LFB-MRI/MagneticReadoutProcessing/src/MagneticReadoutProcessing/README.md

# MagneticReadoutProcessing

This library was created for a Low-Field MRI project and allows processing of data measured by magnetic field sensors.
The focus is on visualization, followed by the provision of simple interfaces to work with this data.
In general its possible to use this lib on all kinds of data.

Please see the full documentation: [magneticreadoutprocessing.readthedocs.io](https://magneticreadoutprocessing.readthedocs.io/en/latest/)
