LFB-MRI/MagneticReadoutProcessing/documentation/paper/README.md

\gls{vr}

\cite{eduxrvrar2020usa}

\begin{figure}[htbp]
\centerline{\includegraphics[width=8cm]{serious-games.png}}
\caption{Definition Serious Games.\cite{a10}}
\label{sgdef_fig}
\end{figure}
