LFB-MRI/MagneticReadoutProcessing/src/MagBoardHardware/single_sensor/Readme.md

# single_sensor

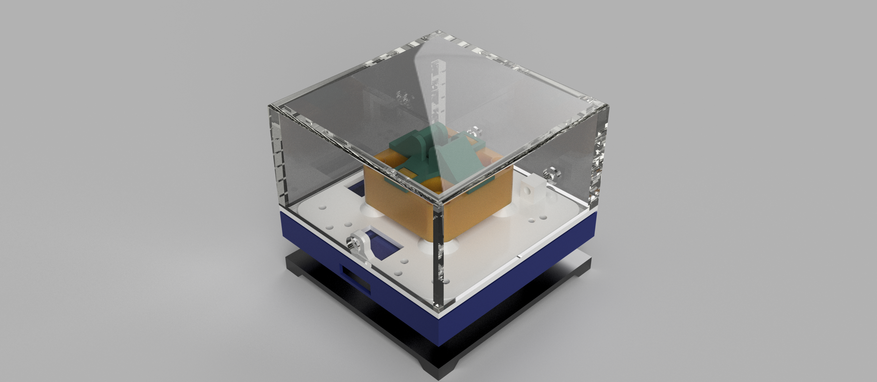
[picture p3: src/MagBoardHardware/single_sensor/IMAGES/single_sensor_render_1.png]
single_sensor_render_1


## BOM

| amount | part |
|---|---|
| 12 | M3x10 SHCS |
| 12 | HEAT INSERT M3 |
| 3 | M4x10 SHCS |
| 3 | HEAT INSERT M4 |
| 2 | Adafruit TLV493D |
| 1 | Raspberry Pi Pico  |
| 1 | Adafruit TCA9548A  |
| 2 | Adafruit STEMMA QT |
