LFB-MRI/MagneticReadoutProcessing/documentation/thesis/tables/README.md

# TABLES

* place a csv file with Caption_Table_Name.csv
* please use _ instead of spaces " ", the name of file is the caption of the table
* to insert it into the document use: %%Caption_Table_Name.csv%%
