LFB-MRI/MagneticReadoutProcessing/src/MagneticReadoutProcessing/readings/TLV493D_temperature/combined/README.md

# extract.py on COMBINED TEMPERATURE READINGS

All readings with `TEMPERATURE=COMBINED` includes the temperatures as separate datapoints in one reading.
The `extract.py` extracts the datapoints into separate readings to make it compatible with the test_temperaturedeviation analysis
