LFB-MRI/MagneticReadoutProcessing/documentation/thesis/thesis_document_tmp.md

# Introduction

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

## Background and Motivation

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

\newpage

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

At last, the temperature drift is measured by repeating the background noise test in different temperature environments. Sensor noise should be less than *50$\mu$T* to characterise precisely a magnetic field in a Halbach-Array of an (+mri) with precision greater than *1000 (+ppm)*.

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

### Low-Field MRI

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

### Magnet System

Example Halbach ring with cutouts for eight magnets. \label{Example_Halbach_ring_with_cutouts_for_eight_magnets.png}

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

### Shimming Procedure

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

The sources for the shimming process can be passive and active based. 
Passive shimming uses ferromagnetic metal materials inserted into the inner magnet bore. [@BPA22]
Active shimming, on the other hand, can use additional coils or existing gradient coils controlled by special circuitry. Also, software algorithms can be used to adjust the control parameters of the (+mri) system and improve homogeneity [@WAH21].

In this thesis, reference is made exclusively to the hardware shimming processes, since this project is to be used in the future to construct a low-field (+mri) field magnet from permanent magnets.

## State of the Art 

**Low-Field MRI**

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

**Magnet Characterisation**

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

There are two ways of using the data from the magnets that are previously measured:

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

## Aim of this Thesis

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

## Research Question and Approach

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

The primary objectives of this work revolve around addressing two pivotal research questions:

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

## Use cases

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

1. **Ready to use hardware sensor designs**

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

2. **Taking automatic measurements from sensors**

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

3. **Open storage formats for data export**

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

4. **Ready to integrate data analysis functions**

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

5. **User-programmable data processing pipelines**

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

## Structure

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

# Unified Sensor

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

\newpage

## Sensor Selection

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

Typical block diagram of a digital hall sensor sensing chain using three hall plates. \label{Typical_block_diagram_of_a_digital_hall_sensor_sensing_chain_using_three_hall_plates.png}

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

| | TLV493D | HMC5883L | MMC5603NJ | AS5510 |
| --- | --- | --- | --- | --- |
| Readout-Axis | 3D | 3D | 3D | 1D |
| Temperature-Sensor | yes | no | yes | no |
| Resolution [uT] | 98 | 0.2 | 0.007 | 48 |
| (+dr) [mT] | ±130.0  | ±0.8 | ±3 | ±50 |
| Interface | (+i2c)  | (+i2c) | (+i2c) | (+i2c) |

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

## Mechanical Structure

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

Rendered mechanical structure of the 1D sensor (+cad) model with different parts colored separately, and universal magnet mount shown in green. \label{Rendered_mechanical_structure_of_the_1D_sensor_(+cad)_model_with_different_parts_colored_separately,_and_universal_magnet_mount_shown_in_green.png}

Figure \ref{Rendered_mechanical_structure_of_the_1D_sensor_(+cad)_model_with_different_parts_colored_separately,_and_universal_magnet_mount_shown_in_green.png}, shows rendered view of the 1D-Single sensor (+cad) drawing, which is described in chapter \ref{d-single-sensor}. All parts are produced using 3D printing additive manufacturing process. The sensor circuit board is glued underneath the magnet holder. This is interchangeable, so different distances between sensor and magnet can be realised. The exchangeable magnetic holder (shown in green in Figure \ref{Rendered_mechanical_structure_of_the_1D_sensor_(+cad)_model_with_different_parts_colored_separately,_and_universal_magnet_mount_shown_in_green.png}) can be adapted to different magnets. It can be produced quickly due to the small number of parts used.
The two recesses lock the magnet holder with the inserted magnet over the sensor.
The mechanical design created is able to accommodate cylinders, cubes, up to a maximum length of *30mm*.
Other magnet shapes require a modification of the base plate and the sensor holder.
The specified tolerances of *0.45mm* allow the magnet to be inserted into the 3D printed holder with repeat accuracy and without backlash. This was accomplished with the help of tolerance tests for the 3D printing material used (+pla) and the 3D printer used *Voron 2.4 350mm* through several series of tests.
This is important if several magnets must be measured, where the positioning over the sensor must always be the same.

## Electrical Interface

1D sensor schematic using an Raspberry Pi Pico with a TLV493D footprint in the center. \label{1D_sensor_schematic_using_an_Raspberry_Pi_Pico_with_a_TLV493D_footprint_in_the_center.png}

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

## Firmware

Unified sensor firmware program structure with listed setup and main loop routines using simplified function blocks. \label{Unified_sensor_firmware_program_structure_with_listed_setup_and_main_loop_routines_using_simplified_function_blocks.png}

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

```cpp {#lst:CustomSensorClass caption="CustomSensor-Class for adding new sensor hardware support into the unified sensor firmware package"}
#ifndef __CustomSensor_h__
#define __CustomSensor_h__
// register custom sensor in implemented_sensors.h also
class CustomSensor: public baseSensor
{
public:
  CustomSensor();
  ~CustomSensor();
  // implement depending on sensor communication interface
  bool begin(TwoWire& _wire_instance); // I2C
  bool begin(HardwareSerial& _serial_instance); // UART
  bool begin(Pin& _pin_instance); // ANALOG or DIGITAL PIN like one wire
  // FUNCTIONS USED BY READOUT LOGIC
  bool is_valid() override;
  String capabilities() override;
  String get_sensor_name() override;
  bool query_sensor() override;
  sensor_result get_result() override;
};
#endif
```

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

### Communication Interface

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

Unified sensor firmware provided serial terminal based (+cli) allows the user to configure the sensor manually. \label{Unified_sensor_firmware_provided_serial_terminal_based_(+cli)_allows_the_user_to_configure_the_sensor_manually.png}

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

Result of an executed b value measurement readout command using the sensors (+cli) with immediate user readable response. \label{Result_of_an_executed_b_value_measurement_readout_command_using_the_sensors_(+cli)_with_immediate_user_readable_response.png}

### Sensor Synchronisation Interface

Multi sensor synchronisation wiring example using three sensors together with one host (+pc) performing the triggering and readout processing. \label{Multi_sensor_synchronisation_wiring_example_using_three_sensors_together_with_one_host_(+pc)_performing_the_triggering_and_readout_processing.png}

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

| Data-Points | Run runtime [ms] | Average Sensor communication time per reading [ms] |  Communication jitter time [ms]  | Comment |
| --- | --- | --- | --- | --- |
| 1 | 9453 | 1.44 | 0 | |
| 1 | 9864 | 1.5 | 0 | |
| 10 | 12984 | 1.22 | 0.9 | |
| 10 | 12673 | 1.13 | 1.1 | |
| 10 | 43264 | 2.19 | 8.2 | 96% system load |

\newpage

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

Unified sensor firmware multi sensor synchronisation procedure using sync (+gpio) input for operation (primary or secondary) mode decision. \label{Unified_sensor_firmware_multi_sensor_synchronisation_procedure_using_sync_(+gpio)_input_for_operation_(primary_or_secondary)_mode_decision.png}

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

Result of the opmode command execution on a sensor which is connected to another as primary configured sensor. \label{Result_of_the_opmode_command_execution_on_a_sensor_which_is_connected_to_another_as_primary_configured_sensor.png}

## Example Sensors

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

: Build hardware sensors equipped with different sensor (+ic)s to cover various magnet charaterisation setups. \label{Build_hardware_sensors_equipped_with_different_sensor_(+ic)s_to_cover_various_magnet_charaterisation_setups.csv}

| | 1D: single sensor | 1D: dual sensor | 3D: Fullsphere |
| --- | --- | --- | --- |
| Maximal magnet size | Cubic 30x30x30mm  | Cubic 30x30x30mm  | Cubic 20x20x20mm |
| Sensor type | MMC5603NJ | TLV493D | TLV493D |
| Sensor count | 1 | 2 | 1 |
| Scanmode | static (1 point)  | static (2 points) | dynamic (fullsphere) |

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

### 1D: Single Sensor

Manufactured 1D sensor construction from different angles and universal magnet mount (green 3D printed part) equipped with N45 12x12x12mm magnet. \label{Manufactured_1D_sensor_construction_from_different_angles_and_universal_magnet_mount_(green_3D_printed_part)_equipped_with_N45_12x12x12mm_magnet.p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

### 3D: Full Sphere

Full sphere sensor implementation using two Nema17 stepper motors in a polar coordinate system. \label{Full_sphere_sensor_implementation_using_two_Nema17_stepper_motors_in_a_polar_coordinate_system.png}

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

3D plot of an N45 12x12x12mm magnet using the build 3D full sphere sensor with visible magnetic field strength deviations using different shaded vertices on a sphere. \label{3D_plot_of_an_N45_12x12x12mm_magnet_using_the_build_3D_full_sphere_sensor_with_visible_magnetic_field_strength_deviations_usi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

### Integration of an Industry-Teslameter

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

\newpage

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

Voltcraft GM70 teslameter with custom (+pc) interface board using a (+usb) to serial converter and needed additional pull-up resistors. \label{Voltcraft_GM70_teslameter_with_custom_(+pc)_interface_board_using_a_(+usb)_to_serial_converter_and_needed_additional_pull-up_resistors.png}

# Software Readout Framework

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

## User Interaction Points

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

\newpage

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

A high level overview of all MRP library implemented Python modules which can be changed by the user. \label{A_high_level_overview_of_all_MRP_library_implemented_Python_modules_which_can_be_changed_by_the_user.png}

### User Interaction Points Example

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

1. **Create magnetic field data**

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

\newpage

3. **Generate fabrication data** 

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

## Modules

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

* Core - All modules related to measurement data management
* Extensions - Contains modules for visualisations, hardware sensor access

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

### Core Modules

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

The following modules are implemented in detail:

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

### Storage and Datamanagement

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

```json {#lst:json_export_format_example caption="JSON structure of an exported MRPReading based measurement with information about the measurement environment, additional meta-data and raw data value objects"}
{
  "time_start": "Wed Sep 20 08:50:13 2023",
  "time_end": "Wed Sep 20 08:54:13 2023",
  "additional_data": {
      "sensor_device_path": "/dev/ttyUnifiedSensorSingle",
      "sensor_name": "Unified Sensor Single Sensor",
      "sensor_id": "386731533439",
      "sensor_capabilities": ["static", "axis_b", "axis_x", "axis_y", "axis_z", "axis_temp", "time"],
      "configname": "calibrationtemp30.yaml",
      "runner": "cli"},
  "data": [{
      "value": {"b":0.135},
      "id": 0,
      "temperature": 34.32}],
  "measurement_config": {
      "sensor_distance_radius": 40.0,
      "magnet_type": 1// CUBIC 12x12x12mm N45
  },}
```

The exported example Listing \ref{lst:json_export_format_example} contains different object keys, which contain the following information:

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

### Extension Modules

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

\newpage

* *MRPHal* - Firmware protocol implementation
* *MRPHalLocal* - (+usb) sensor interface
* *MRPHalRemote* - Remote sensor interface

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

#### Visualisation

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

* *MRPVisualization* - different table and graph-based plots
* *MRPPolarVisualization* - full sphere map plots

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

#### Analysis

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

## Multi Sensor Setup

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

MRP library proxy module usage example with host (+pc) for readout processing and remote (+pc) for sensor communication using the http protocol. \label{MRP_library_proxy_module_usage_example_with_host_(+pc)_for_readout_processing_and_remote_(+pc)_for_sensor_communication_using_the_http_protocol.png}

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

Example MRP proxy module usage using two remote (+pc)s. \label{Example_MRP_proxy_module_usage_using_two_remote_(+pc)s.png}

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

### Network-Proxy

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

```bash {#lst:mrpcli_proxy_start caption="MRPProxy usage to enable local sensor forwarding over the network. The CLI output shows the available sensor to the connected host PC"}
# START PROXY INSTNACE WITH TWO LOCALLY CONNECTED SENSORS
$ python3 mrpproxy.py proxy launch /dev/ttySENSOR_A /dev/ttySENSOR_B # add another proxy instance http://proxyinstance_2.local for multi-sensor, multi-proxy chain
Proxy started. http://remotepc.local:5556/
PRECHECK: SENSOR_HAL: 1337 # SENSOR A FOUND
PRECHECK: SENSOR_HAL: 4242 # SENSOR B FOUND
Terminate Proxy instance [y/N] [n]: 
```

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

```bash {#lst:mrpcli_config_rest caption="MRPProxy provided REST endpoint query example using wget command line tool to send requests"}
# GET PROXY STATUS
$ wget http://proxyinstance.local:5556/proxy/status
{
"capabilities":[
  "static",
  "axis_b",
  "axis_x",
  "axis_y",
  "axis_z",
  "axis_temp",
  "axis_stimestamp"
],
"commands":[
  "status",
  "initialize",
  "disconnect",
  "combinedsensorcnt",
  "sensorcnt",
  "readsensor",
  "temp"
]}
# RUN A SENSOR COMMAND AND GET THE TOTAL SENSOR COUNT
$ wget http://proxyinstance.local:5556/proxy/command?cmd=combinedsensorcnt
{
"output":[
  "2"
]}
```

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

```bash {#lst:mrpcli_config_using_rpc caption="MRPcli usage example to connect with a MRPProxy based network sensor"}
# CONFIGURE MEASUREMENT JOB USING A PROXY INSTANCE
$ MRPCli config setupsensor testcfg --path http://proxyinstance.local:5556
> remote sensor connected: True using proxy connection:
> http://proxyinstance.local:5556 with 1 local sensor connected
```

### Sensor Synchronisation

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

### Command-Router

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

#### Merging the Sensor Capabilities

: Sensor capabilities merging algorithm. \label{Sensor_capabilities_merging_algorithm.csv}

| SENSOR A  | SENSOR B  |  MERGED CAPABILITIES |  CAPABLE SENSORS ID LUT |
| --- | --- | --- | --- |
| static | | static |  A |
| | dynamic | dynamic |  B |
| axis_temp | axis_temp | axis_temp |  A B |
| axis_x | axis_x | axis_x |  A B |

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

```bash {#lst:mtsc caption="MRPProxy REST capabilities query result after executing the merging algorithm"}
# QUERY Network-Proxy capabilities
$ wget http://proxyinstance.local:5556/proxy/status
{"capabilities":[
"static",
"dynamic",
"axis_temp",
"axis_x"
]}
```

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

#### Dynamic extension of the available Network-Proxy Commands

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

* Redirect to each capable sensor
* Extend commands using an id parameter

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

* *readsensor AXIS SENSOR_INDEX* -> *readsensor ID AXIS SENSOR_INDEX*
* *opmode* -> *opmode ID*

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

## Examples

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

### MRPReading

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

\newpage

```python {#lst:mrpexample_reading caption="MRPReading example for setting up a basic measurement using Python code"}
from MRP import MRPReading, MRPMeasurementConfig
# [OPTIONAL] CONFIGURE READING USING MEASUREMENT CONFIG INSTANCE
config: MRPMeasurementConfig = MRPMeasurementConfig
config.sensor_distance_radius(40) # 40mm DISTANCE BETWEEN MAGNET AND SENSOR
config.magnet_type(N45_CUBIC_12x12x12) # CHECK MRPMagnetTypes.py FOR IMPLEMENTED TYPES
# CREATE READING
reading: MRPReading = MRPReading(config)
# ADD METADATA
reading.set_name("example reading")
reading.set_additional_data("description", "abc")
reading.set_additional_data("test-number", 1)
# EXAMPLE: INSERT A RANDOM DATAPOINT HERE
measurement = MRPReadingEntry.MRPReadingEntry()
measurement.value = random.random()
reading.insert_reading_instance(measurement, False)
# EXPORT MEASURED VALUES INto OTHER DATAFORMATS
npmatrix: np.ndarray = reading.to_numpy_matrix() ## NUMPY
csv: []= reading.to_value_array() ## CSV
js: dict= reading.dump() ## JSON
# EXPORT READING TO FILE
reading.dump_to_file("exported_reading.mag.json")
# IMPORT READING
imported_reading: MRPReading = MRPReading()
imported_reading.load_from_file("exported_reading.mag.json")
```

### MRPHal

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

```python {#lst:mrpexample_hal caption="MRPHal example to use a connected hardware sensor to store raw sensor readings inside a measurement"}
from MRP import MRPHalSerialPortInformation, MRPHal, MRPBaseSensor, MRPReadingSource
# SEARCH FOR CONNECTED SENSORS
## LISTS LOCAL CONNECTED OR NETWORK SENSORS
system_ports = MRPHalSerialPortInformation.list_sensors()
sensor = MRPHal(system_ports[0])
# OR USE SPECIFIED SENSOR DEVICE
device_path = MRPHalSerialPortInformation("UnifiedSensor_4242")
sensor = MRPHal(device_path)
# RAW SENSOR INTERACTION MODE
sensor.connect()
basesensor = MRPBaseSensor.MRPBaseSensor(sensor)
basesensor.query_readout()
print(basesensor.get_b()) # GET RAW MEASUREMENT
print(basesensor.get_b(1)) # GET RAW DATA FROM SENSOR WITH ID 1
# TO GENERATE A READING THE perform_measurement FUNCTION CAN BE USED
reading_source = MRPReadingSourceHelper.createReadingSourceInstance(sensor)
result_readings: [MRPReading] = reading_source.perform_measurement(_readings=1, _hwavg=1)
```

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

### MRPSimulation

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

```python {#lst:mrpexample_simulation caption="MRPSimulation example illustrates the usage of several functions how to generate simulated magnets"}
from MRP import MRPSimulation, MRPPolarVisualization, MRPReading
# GENERATE SILUMATED READING USING A SIMULATED HALLSENSOR FROM magpy LIBRARY
reading = MRPSimulation.generate_reading(MagnetType.N45_CUBIC_12x12x12,_add_random_polarisation=True)
# GENERATE A FULL SPHERE MAP READING
reading_fullsphere = MRPSimulation.generate_random_full_sphere_reading()
# RENDER READING TO FILE IN 3D
visu = MRPPolarVisualization(reading)
visu.plot3d("simulated_reading.png")
# EXPORT READING
reading.dump_to_file("simulated_reading.mag.json")
```

### MRPAnalysis

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

```python {#lst:mrpexample_analysis caption="MRPAnalysis example code performs several data analysis steps"}
from MRP import MRPAnalysis, MRPReading
# CREATE A SAMPLE MEASUREMENT WITH SIMULATED DATA
reading = MRPSimulation.generate_reading(MagnetType.N45_CUBIC_10x10x10)
# CALCULATE MEAN
print(MRPAnalysis.calculate_mean(reading))
# CALCULATE STD DEVIATION ON TEMPERATURE AXIS
print(MRPAnalysis.calculate_std_deviation(reading, _temperature_axis=True))
# CALCULATE CENTER OF GRAVITY
(x, y, z) = MRPAnalysis.calculate_center_of_gravity(reading)
# APPLY CALIBRATION READING TO REMOVE BACKGROUND NOISE
calibration_reading = MRPSimulation.generate_reading(MagnetType.N45_CUBIC_10x10x10, _ideal = True)
MRPAnalysis.apply_calibration_data_inplace(calibration_reading, reading)
```

### MRPVisualisation

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

```python {#lst:mrpexample_visualisation caption="MRPVisualisation example which plots a full sphere to an image file"}
from MRP import MRPPolarVisualization
# CREATE MRPPolarVisualization INSTANCE
## IT CAN BE REUSED CALLING plot2d AGAIN, AFTER LINKED READING DATA ARE MODIFIED
visu = MRPPolarVisualization.MRPPolarVisualization(reading)
# 2D PLOT INTO A WINDOW
visu.plot2d_top(None)
visu.plot2d_side(None)
# 3D PLOT TO FILE
visu.plot3d(os.path.join('./plot3d_3d.png'))
# PLOT ANALYSIS RESULTS
from MRP import MRPDataVisualization
MRPDataVisualization.MRPDataVisualization.plot_error([reading_a, reading_b, reading_c])
```

Example full sphere plot of an measurement using the MRPVisualisation module using different shaded vertices on a sphere. \label{Example_full_sphere_plot_of_an_measurement_using_the_MRPVisualisation_module_using_different_shaded_vertices_on_a_sphere.png}

### MRPHalbachArrayGenerator

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

```python {#lst:mrpexample_halbach caption="MRPHalbachArrayGenerator example for generating an OpenSCAD based Halbach ring"}
readings = []
for idx in range(8):
  # GENERATE EXAMPLE READINGS USING N45 CUBIC 15x15x15 MAGNETS
  readings.append(MRPSimulation.MRPSimulation.generate_reading(MRPMagnetTypes.MagnetType.N45_CUBIC_15x15x15))
## GENERATE HALBACH
halbach_array: MRPHalbachArrayGenerator.MRPHalbachArrayResult = MRPHalbachArrayGenerator.MRPHalbachArrayGenerator.generate_1k_halbach_using_polarisation_direction(readings)
# EXPORT TO OPENSCAD
## 2D MODE DXF e.g. for laser cutting
MRPHalbachArrayGenerator.MRPHalbachArrayGenerator.generate_openscad_model([halbach_array], "./2d_test.scad",_2d_object_code=True)
## 3D MODE e.g. for 3D printing
MRPHalbachArrayGenerator.MRPHalbachArrayGenerator.generate_openscad_model([halbach_array], "./3d_test.scad",_2d_object_code=False)
```

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

Generated Halbach array with generated cutouts for eight magnets. \label{Generated_Halbach_array_with_generated_cutouts_for_eight_magnets.png}

# Usability Improvements

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

## Command Line Interface

MRP (+cli) output to configure a new measurement. \label{MRP_(+cli)_output_to_configure_a_new_measurement.png}

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

```bash {#lst:MRPCli_config_run caption="MRPCli example usage for configuration of a measurement run"}
# CLI EXAMPLE FOR CONFIGURING A MEASUREMENT RUN
## CONFIGURE THE SENSOR TO USE
$ MRPCli config setupsensor testcfg
> 0 - Unified Sensor 386731533439 - /dev/cu.usbmodem3867315334391
> Please select one of the found sensors [0]:
> sensor connected: True 1243455
## CONFIGURE THE MEASUREMENT
$ MRPCli config setup testcfg
> CONFIGURE testcfg
> READING-NAME: [testreading]: testreading
> OUTPUT-FOLDER [/cli/reading]: /tmp/reading_folder_path
> NUMBER DATAPOINTS: [1]: 10
> NUMBER AVERAGE READINGS PER DATAPOINT: [1]: 100
# RUN THE CONFIGURED MEASUREMENT
$ MRPCli measure run
> STARTING MEASUREMENT RUN WITH FOLLOWING CONFIGS: ['testcfg']
> config-test: OK
> sensor-connection-test: OK
> START MEASUREMENT CYCLE
> sampling 10 datapoints with 100 average readings
> SID:0 DP:0 B:47.359mT TEMP:23.56
> ....
> dump_to_file testreading_ID:525771256544952_SID:0_MAG:N45_CUBIC_12x12x12mm.mag.json
```

## Programmable Data Processing Pipeline

Example measurement analysis pipeline. \label{Example_measurement_analysis_pipeline.png}

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

\newpage

```yaml {#lst:mrpuddp_example_yaml caption="Example YAML code of a user defined processing pipeline with six stages linked together"}
stage import_readings:
  function: import_readings
  parameters:
    IP_input_folder: ./readings/fullsphere/
    IP_file_regex: 360_(.)*.mag.json

stage import_bias_reading:
  function: import_readings
  parameters:
    IP_input_folder: ./readings/fullsphere/
    IP_file_regex: bias_reading.mag.json

stage apply_bias_offset:
  function: apply_sensor_bias_offset
  parameters:
    bias_readings: stage import_bias_reading # USE RESULT FROM FUNCTION import_bias_reading
    readings_to_calibrate: stage import_readings

stage apply_temp_compensation:
  function: apply_temperature_compensation
  parameters:
    readings_to_calibrate: stage import_readings # USE RESULT FROM FUNCTION import_readings

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

stage export_readings:
  function: export_readings
  parameters:
    readings_to_plot: stage apply_temp_compensation
    IP_export_folder: ./readings/fullsphere/plots/
```

\newpage

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

* No circular parameter dependencies
* Complex determination of the execution sequence of the steps

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

Example result of an step execution tree from user defined processing pipeline. \label{Example_result_of_an_step_execution_tree_from_user_defined_processing_pipeline.png}

Generated pipeline output files and example results combined into one plot after running example pipeline on a set of readings. \label{Generated_pipeline_output_files_and example_results_combined_into_one_plot_after_running_example_pipeline_on_a_set_of_readings.png}

## Testing

MRP library test results for different submodules executed in PyCharm (+ide). \label{MRP_library_test_results_for_different_submodules_executed_in_PyCharm_(+ide).png}

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

```python {#lst:pytest_example_code caption="Example of a PyTest class for testing the internal functions of the MRPReading and MRPSimulation modules"}
class TestMPRReading(unittest.TestCase):
  # PREPARE AN INITIAL CONFIGURATION FILE FOR ALL FOLLOWING TEST CASES IN THIS FILE
  def setUp(self) -> None:
    self.test_folder: str = os.path.join(os.path.dirname(os.path.abspath(__file__)), "tmp")
    self.test_file:str = os.path.join(self.import_export_test_folderpath, "tmp")

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

  def test_import_reading(self):
    # CREATE EMPTY READING AND LOAD FROM FILE
    reading_imported:MRPReading = MRPReading.MRPReading(None)
    reading_imported.load_from_file(self.test_file)
    # COMPARE
    self.assertIsNotNone(reading_imported.compare(MRPSimulation.generate_reading()))
```

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

\newpage

## Package Distribution

MagneticReadoutProcessing library hosted on PyPi. \label{MagneticReadoutProcessing_library_hosted_on_PyPi.png}

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

```bash {#lst:setup_lib_with_pip caption="Bash commands to install the MagneticReadoutProcessing library using pip"}
# https://pypi.org/project/MagneticReadoutProcessing/
# install the latest version
$ pip3 install MagneticReadoutProcessing
# install the specific version 1.4.0
$ pip3 install MagneticReadoutProcessing==1.4.0
```

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

\newpage

```python {#lst:setup_py_req caption="setup.py with dynamic requirement parsing using a given requirements.txt"}
# dynamic requirement loading using requirements.txt
req_path = './requirements.txt'
with pathlib.Path(req_path).open() as requirements_txt:
  install_requires = [str(requirement) for requirement in pkg_resources.parse_requirements(requirements_txt)]

setup(name='MagneticReadoutProcessing',
  version='1.4.3',
  url='https://github.com/LFB-MRI/MagnetCharacterization/',
  packages= ['MRP', 'MRPCli', 'MRPudpp', 'MRPproxy'],
  install_requires=install_requires,
  entry_points={
    'console_scripts': [
      'MRPCli = MRPCli.cli:run',
      'MRPUdpp = MRPUdpp.uddp:run',
      'MRPProxy = MRPProxy.mrpproxy:run'
    ]
  }
)
```

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

### Documentation

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

\newpage

```python {#lst:pydocstring caption="Documentation using Python docstring example"}
# MRPDataVisualisation.py - example docstring
def plot_temperature(_readings: [MRPReading.MRPReading], _title: str = '', _filename: str = None, _unit: str = "degree C") -> str:
  """
  Plots a temperature bar graph of the reading data entries as figure
  :param _readings: readings to plot
  :type _readings: list(MRPReading.MRPReading)
  :param _title: Title text of the figure, embedded into the head
  :type _title: str
  :param _filename: export graphic to a given absolute file path with .png
  :type _filename: str
  :returns: returns the abs file path of the generated file
  :rtype: str
  """
  if _readings is None or len(_readings) <= 0:
      raise MRPDataVisualizationException("no readings in _reading given")
  num_readings = len(_readings)
  # ...
```

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

MagneticReadoutProcessing documentation hosted on ReadTheDocs. \label{MagneticReadoutProcessing_documentation_hosted_on_ReadTheDocs.png}

# Use Case Evaluation

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

\newpage

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

## Hardware Preparation

Ten numbered N45 12x12x12mm test magnets in separate 3D printed holders. \label{Ten_numbered_N45_12x12x12mm_test_magnets_in_separate_3D_printed_holders.png}

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

## Configuration of the Measurement

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

```bash {#lst:evaluation_measurement_config caption="Measurement configuration for evaluation measurement"}
## CONFIGURE THE MEASUREMENT
$ MRPCli config setup eval_measurement_config
> READING-NAME: 360_eval_magnet_<id>
> OUTPUT-FOLDER: ./readings/evaluation/ 
> NUMBER DATAPOINTS: 18 # FOR A FULL SPHERE READING USE MULTIBLE OF 18
> NUMBER AVERAGE READINGS PER DATAPOINT: 10
```

## Custom Algorithm Implementation

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

\noteworthy{\text{CoG} = \frac{\sum{D_{istance} \times W_{eight}}}{\sum{W_{eight}}}}{: Center of Gravity} 

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

```python {#lst:custom_find_similar_values_algorithm caption="User implemented custom find most similar readings algorithm"}
@staticmethod
def FindSimilarValuesAlgorithm(_readings: [MRPReading.MRPReading], IP_return_count: int = -1) -> [MRPReading.MRPReading]:
  import heapq
  import math
  heap = []
  # SET RESULT VALUE COUNT
  IP_return_count = max([int(IP_return_count),len(_readings)])
  if IP_return_count < 0:
      IP_return_count = len(_readings) / 5
  # CALCULATE TARGET VALUE: CENTER OF GRAVITY MAGNITUDE FOR ALL READINGS
  target_value = 0.0
  for idx, r in enumerate(_readings):
      cog = MRPAnalysis.MRPAnalysis.calculate_center_of_gravity(r)
      # COMPUTE LENGTH OF VECTOR = B value
      cog_value: float = math.sqrt(cog[0]**2 + cog[1]**2 cog[2]**2)
      target_value = target_value + cog
  target_value = target_value / len(_readings)
  # PUSH READINGS TO HEAP
  for value in _readings:
      # USE DIFF AS PRIORITY VALUE IN MIN-HEAP
      cog = MRPAnalysis.MRPAnalysis.calculate_center_of_gravity(value)
      cog_value: float = math.sqrt(cog[0]**2 + cog[1]**2 cog[2]**2)
      diff = abs(cog_value - target_value)
      heapq.heappush(heap, (diff, cog_value))
  # RETURN X BEST ITEMS FROM HEAP
  similar_values = [item[1] for item in heapq.nsmallest(IP_return_count, heap)]
  # CLEAN UP USED LIBRARIES AND RETURN RESULT
  del heapq
  del math
  return similar_values
```

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

### Alternative Filter Algorithm Implementation

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

```python {#lst:custom_find_similar_values_algorithm_refmagnet caption="Modified user implemented custom find algorithm using a reference magnet reading"}
@staticmethod
def FindSimilarValuesAlgorithmREF(_readings: [MRPReading.MRPReading], _ref: [MRPReading.MRPReading], IP_return_count: int = 4) -> [MRPReading.MRPReading]:
  # CALCULATE CoG VALUE OF REFERENCE MAGNET
  cog_ref = MRPAnalysis.MRPAnalysis.calculate_center_of_gravity(_ref[0])
  ref_value: float = math.sqrt(cog_ref[0]**2 + cog_ref[1]**2 cog_ref[2]**2)
  # PUSH READINGS TO HEAP
  for value in _readings:
      # USE DIFF AS PRIORITY VALUE IN MIN-HEAP
      cog = MRPAnalysis.MRPAnalysis.calculate_center_of_gravity(value)
      cog_value: float = math.sqrt(cog[0]**2 + cog[1]**2 cog[2]**2)
      heapq.heappush(heap, (abs(cog_value - ref_value), cog_value))
  # RETURN X BEST ITEMS FROM HEAP
  return [item[1] for item in heapq.nsmallest(IP_return_count, heap)]
```

## Execution of Analysis Pipeline

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

\newpage

```yaml {#lst:pipeline_mrp_evaluation_yaml caption="User defined processing pipeline using custom implemented filter algorithm in third stage"}
name: pipeline_mrp_evaluation
stage rawimport:
  function: import_readings
  parameters:
    IP_input_folder: ./readings/evaluation/
    IP_file_regex: 360_(.)*.mag.json

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

stage plot_filtered:
  function: plot_readings
  parameters:
    readings_to_plot: stage find_similar_values # USE RESULTS FROM find_similar_values STAGE
    IP_export_folder: ./readings/evaluation/plots/plot_filtered/
    IP_plot_headline_prefix: MRP evaluation - filtered
```

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

```bash {#lst:bash_pipeline_mrp_evaluation_yaml caption="Bash result log of the analysis pipeline run"}
# LIST ACTIVE PIPELINES IN PIPELINE DIRECTORY 
$ MRPudpp pipeline listenabledpipelines
> Found enabled pipelines:
> 1. pipeline_mrp_evaluation.yaml
# EXECUTE THE EVALUATION PIPELINE
$ MRPudpp pipeline run
> loading pipeline pipeline_mrp_evaluation.yaml
> stage nodes: ['import', 'find_similar_values', 'plot_raw', 'plot_filtered']
> =====> stage: import 
> =====> stage: find_similar_values 
> =====> stage plot_filtered 
> Process finished with exit code 0
```

## Result Analysis

MRP evaluation result after find similar values algorithm execution in the user defined pipeline. \label{MRP_evaluation_result_after_find_similar_values_algorithm_execution_in_the_user_defined_pipeline.png}

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

The filter algorithm implemented by the user is thus successfully executed via the user-programmable pipeline.
The calculation result is successfully verified using raw measurement data and the result of the algorithm and verified using reference measurements.
The streamlined pipeline approach enables the user to re-execute the implemented measurement pipeline example with further measurement data. Changes to filter parameters, for example, are also possible without having to adapt the code.
Using this example, all the required functional capabilities from the chapter *Use cases* \ref{use-cases} of this implemented solution are demonstrated in their functional capability.

# Evaluation

In the previous chapter *Use Case Evaluation* \ref{use-case-evaluation} it is demonstrated that the implementation of the hardware and software framework for various magnetic field sensors is successfully implemented. In addition, the basic application of the framework for the user and the resulting advantages are demonstrated using the specific example.

Based on this it is possible to systematically characterise magnets from the software and readout hardware side by means of data acquisition, storage and analysis.

After the hardware and software components developed have been discussed in detail, the following chapter answers the question of which sensors fulfill the requirements described in chapter \ref{research-question-and-approach}:

* Measure a wide range of different permanent magnets with regard to their systematic field strength
* Automated measurement of the homogeneity with an accuracy of less than *1000 (+ppm)* what is demanded to measure Halbach rings

These questions are answered in the following as a basic readout and analysis functionality platform had to be created first and thus an automated sensor characterisation can be performed.

## Sensors for Evaluation

For this evaluation, the sensors listed in Table \ref{Digital_magnetic_field_sensors_characterised_for_evaluation.csv} are used for sensor characterisation. The selection of sensors is described in chapter \ref{sensor-selection}.
The additional column for the *Background Noise* is taken from the respective data sheets of the sensors and will be verified in the later *Background Noise* measurement in chapter \ref{sensor-characterisation-background-noise}.

: Digital magnetic field sensors characterised for evaluation. \label{Digital_magnetic_field_sensors_characterised_for_evaluation.csv}

| | TLV493D | MMC5603NJ |
| --- | --- | --- |
| Readout-Axis | 3D | 3D |
| Temperature-Sensor | yes | yes |
| Resolution [uT] | 98 | 0.007 |
| (+dr) [mT] | ±130.0  | ±3 |
| Background-Noise [uT] | 100 | 0.2 |

The values in Table \ref{Digital_magnetic_field_sensors_characterised_for_evaluation.csv} are taken from the data sheets of the relevant manufacturers as a reference for comparison with the later measurement results.

The developed framework is directly compatible with a variety of magnetic field sensors without modifications, including those listed in the table.
For this evaluation, the sensors listed in the table are used for sensor characterisation. This selection is made for the following reasons:

* Availability of ready to use development boards
* Specifications correspond to the application areas
* Availability for testing

It is possible to carry out the sensor characterisation demonstrated for other compatible sensors using the same procedure. Pre-configured measurements in chapter \ref{command-line-interface} and analysis pipelines in chapter \ref{programmable-data-processing-pipeline}, which are available for this purpose, are packaged within the library.
The following parameters are determined and analysed for the sensor evaulation:

* Background Noise
* Linearity
* Temperature Sensitivity

The characterisation methodology is modified and adapted from Crescentini, Gibiino and Piero [@CSG22], as their approaches are focused towards the analysis of analogue Hall sensors.
Direct transmission is not possible, as their methods are specially tailored to these sensors.
This includes measuring the analogue bias currents and raw sensor output voltages, which are not accessible with these digital-only sensors.
Adaptations are therefore necessary to extend the characterisation to the choosen digital sensors listed in Table \ref{Digital_magnetic_field_sensors_characterised_for_evaluation.csv}.

## Evaluation Sensor Setup

Sensor evaluation plattform with TLV493D and MMC5603 sensors placed with thermal conductive glue on an aluminium baseplate. \label{Sensor_evaluation_plattform_with_TLV493D_and MMC5603_sensors_placed_with_thermal_conductive_glue_on_an_aluminium_baseplate.png}

The sensor platform used is an adapted version of the *1D: Single Sensor* from chapter \ref{d-single-sensor} sensor platform.
The sensors to be measured are fixed together on an aluminium plate with thermally conductive adhesive.
This compensates for thermal differences.
This is essential for the subsequent temperature deviation tests in order to obtain comparable measurement results. [@J21]

The set-up is set up and pre-wired in the temperature chamber *24* hours before the measurement series is performed.
The insulated housing of a *Voron 2.4* 3D printer, which has a separately controlled internal equipped heating system, is used as the temperature chamber.
To verify the temperature, an additional thermometer *7055BT* is placed on the base plate.
A *10mm* thick *PTFE* insulation plate is placed between the floor and the sensor base plate to prevent direct and uneven heating of the base plate by the heated floor.

Figure \ref{Sensor_evaluation_plattform_with_TLV493D_and MMC5603_sensors_placed_with_thermal_conductive_glue_on_an_aluminium_baseplate.png} shows this basic setup, the *Raspberry Pi Pico* is used as the readout hardware, on which the *Unified Sensor Firmware* is running.
With additional connected switch, it is possible to isolate or select a sensor or both sensors to be queried from the firmware.

A separate battery power supply is used as low-noise power supply for the sensor boards.
An *Raspberry Pi 4* is implemented as the host computer, which is connected to the sensors via a *Hailege ADUM3160* (+usb) isolator and is placed outside the temperature chamber.

For the software setup, *MRPCli* \ref{command-line-interface} is used to control and record the measurement series, with the functions of the *MRPDataVisualisation* \ref{mrpvisualisation} and *MRPAnalysis* \ref{mrpanalysis} packages from the library \ref{software-readout-framework} being used for subsequent evaluation.
The recorded measurement series are automatically analysed using the *Programmable-Data Processing Pipeline* \ref{programmable-data-processing-pipeline} and the results are visualised.

## Sensor Characterisation: Background Noise

Sensor evaluation setup for noise measurements. \label{Sensor_evaluation_setup_for_noise_measurements.png}

Measuring the noise in a magnetic field sensor requires a precise procedure and a special measurement setup. First, the magnetic field sensor is placed in a quiet and static environment to minimize external field interference. The temperature chamber for all noise tests is set to *$\mu_{trev}$=21.0$^{\circ}$C* and the sensors are placed *24* hours before the measurement run in the final measurement configuration inside of the chamber.

: Sensor noise evaluation results. \label{Sensor_noise_evaluation_results.csv}

| Symbol | TLV493D | MMC5603NJ | Unit | Description |
| --- | --- | --- | --- | --- |
| $\mu_{rv}$ | 157.23  | -50.39 | $\mu$T |  Mean sensor value (Baseline) |
| $\sigma_{rv}$ | 172.00  | 0.20 | $\mu$T | (+sd) sensor value |
| $\mu_{t}$ | 20.68 | 19.40 | $^{\circ}$C | Mean sensor temperature |
| $\sigma_{t}$  | 0.53 | 0.00 | $^{\circ}$C | (+sd) sensor temperature |
| $\mu_{trev}$  | 21.0 | 21.0 | $^{\circ}$C | Ambient temperature |

The procedure starts with the acquisition of the baseline by operating the sensor without external magnetic fields.
For this purpose, a sample size of *$N_{baseline}$=10000* measured values is recorded for the baseline measurement.
The output signal of the sensor is continuously measured and recorded. It is important to carry out the measurement over a sufficiently lengthy period of time in order to record both short-term and long-term fluctuations. For this purpose, *$N_{measurement}$=2000* additional measured values are taken with a trigger and readout rate of one measurement per second.
In order to quantify the noise, the (+sd) of the signal is calculated. These parameters provide information about the variation of the signal over time and therefore about the sensor background noise. 

\newpage

Sensor noise evaluation results for TLV493D and MMC5603NJ with N=2000 samples and no averaging. \label{Sensor_noise_evaluation_results_for_TLV493D_and_MMC5603NJ_with_N=2000_samples_and_no_averaging.png}

The following Figure \ref{Sensor_noise_evaluation_results_for_TLV493D_and_MMC5603NJ_with_N=2000_samples_and_no_averaging.png} contains the measured values of these sensors. In the next phases these are analysed for each sensor examined.
The following data is shown in the plots:

* Plot of the raw data of the sensor
* Plot of the sensor's internal temperature sensor
* Noise level with reference to the initial baseline
* Histogram of the background noise level

Table \ref{Sensor_noise_evaluation_results.csv} lists the measured values that are extracted from the measurement data of the sensors in Figure \ref{Sensor_noise_evaluation_results_for_TLV493D_and_MMC5603NJ_with_N=2000_samples_and_no_averaging.png}.
These measured values are categorised below.

### Sensor Temperature Analysis

The temperature stability of the *TLV493D* with a mean value of *20.68$^{\circ}$C* and a (+sd) of $\sigma_{t,TLV493D}$=0.53$^{\circ}$C shows a strongly noisy characteristic with an accuracy of two decimal places. The confidence interval varies between *20.15$^{\circ}$C* and *21.21$^{\circ}$C*, which is 
In contrast to the *MMC5603* with stable *19.40$^{\circ}$C*, this result is not suitable for use, e.g. for temperature compensation.
A second measurement run with another *TLV493D* confirms this result.

Both sensors provide an offset to the measured chamber temperature $\mu_{trev, 7055BT}$.

With an additional measurement run with a different temperature setting of *30.0$^{\circ}$C*, the measured temperature deviations and offsets remains constant.

As a result, an external temperature sensor should be used for temperature-critical measurements with the *TLV493D*. This is considered for the *Temperature Sensitivity* run in chapter \ref{sensor-characterisation-temperature-sensitivity}.

### Raw Sensor Data Analysis

The noise of a sensor describes unwanted, random fluctuations or signals in the measured data. These are clearly recognisable in Figure \ref{Sensor_noise_evaluation_results_for_TLV493D_and_MMC5603NJ_with_N=2000_samples_and_no_averaging.png} in the raw data plot. 
The baseline measurement which is previously determined for each sensor is shown by the red $\mu_{rv}$ [$\mu$T] line. It can be seen that each sensor has a different baseline offset in the same environment.
This variable is the result of multiple effects, including the electrical offset introduced by the front end and the effect of the earth's magnetic field [@CSG22] and the test environment.

For verification, a reference measurement of the environment is carried out with the calibrated *Voltcraft GM70* Telsameter next to the sensor (+ic).
This provides a reference baseline value of *$\mu_{rev, GM70}$=-21.0$\mu$T*.

The noise of the sensor is drawn around this using the blue line. 
For the *TLV493D* the (+sd) *$\sigma_{rv,TLV493D}$=172.0${\mu}$T*, which is twice the value given by the datasheet as the noise value (refer to Table \ref{Digital_magnetic_field_sensors_characterised_for_evaluation.csv}).
Under the same conditions, the *MMC5603NJ* undercuts the value specified by the manufacturer. The (+sd) approaches *$\sigma_{rv, MMC5603NJ}$=0.20${\mu}$T* and is negligible, especially when additional averaging is used.

As the baseline is determined first for each sensor, it can be seen that the 
Another recognisable feature is 
Further measurement series are also recorded with inserted *N45 12x12x12mm* magnets, so that these are saturated halfway through the measurement range.
This allows the noise measurement values to be compared with a blank measurement. These values correspond, so it can be concluded that the noise is within the same range across the measuring range.

## Sensor Characterisation: Linearity

Sensor evaluation setup for linearity measurements. \label{Sensor_evaluation_setup_for_linearity_measurements.png}

The sensor linearity of a magnetic field sensor or describes the ability of the sensor to provide a proportional linear response to changes in the magnetic field without non-linear distortions [@CSG22].
This means that the output signals of the sensor vary directly proportional to the input magnetic fields without deviations or distortions and is therefore an important indicator for measurements of fields at different distances or objects.
This is achieved by means of an additional linear axis installed above the sensor setup.
A holder for an *N45 12x12x12mm* magnet is attached to the end effector of this axis, which can thus be moved at different distances above the respective sensor (+ic). 
The ambient temperature is set to *$\mu_{trev, 7055BT}$=21.0$^{\circ}$C* in the measurement runs and thus corresponds to the same conditions as in the chapter *Background Noise* \ref{sensor-characterisation-background-noise} setup.

Figure \ref{Sensor_evaluation_setup_for_linearity_measurements.png} contains this updated measurement setup with the added components.
To control the linear axis an additional motion controller of the type *SKR-Pico* placed outside the temperature chamber is required, which can be controlled via a network interface.

### Measurement Setup

After the sensor baseline has been determined with *$N_{baseline}$=10000* samples, the magnet is inserted into the holder.
The linear axis is moved by the user until it is maximally saturated. With the *TLV493D*, this corresponds to *250.000$\mu$T* and below in low resolution mode. *MCC5603NJ* around *3000$\mu$T*.
This ensures that the linearity is determined over the entire measuring range.

### Measurement Run

The measurement run is then started using a script.
The user defines the path to be travelled by the linear axis.
A complete range of *120mm* in *1mm* steps is selected. The following automated process then runs as follows:
 
1. Move the linear axis upwards by the selected distance
2. De-energise the axis stepper motor
3. Create measurement using *MRPCli* with *$N_{measurement}$=2000* data points per reading and step
4. Export reading to filesystem with current linear axis position in meta-data and filename

### Linearity Analysis

After the measurements are exported, these are analysed for linearity using *MRPAnalysis* functions in chapter \ref{mrpanalysis}.

Sensor linearity evaluation results for TLV493D and MMC5603NJ. \label{Sensor_linearity_evaluation_results_for_TLV493D_and_MMC5603NJ.png}

Figure \ref{Sensor_linearity_evaluation_results_for_TLV493D_and_MMC5603NJ.png} combines the visual representation of linearity as a plot. Only the measuring range specified in the sensors data sheet is considered here, as linearity is guaranteed for this range. In terms of the *TLV493D* this is *0.5%* and in the case of the *MMC5603NJ* *0.1%*.

The distance from the magnet to the sensor is plotted in *mm* on the x-axis.
The measured value of the sensor is plotted on the y-axis.
This is not directly comparable for both plots, as the sensors have different measuring ranges.
To ensure comparability, the ideal curve is determined [@CSG22].
In order to be able to make quantifiable statements about the measurement results, the mean and (+sd) deviation of these two curves is determined.

For both sensors, the deviation is less than *1%* over the entire resolution. With the *MMC5603NJ* this is on average only *0.04%*. With the *TLV493D* the (+sd) is *3.64%*, for which the deviations at the end in particular (with field strengths towards zero) are decisive.
In general, the measured values correspond to the data sheet specifications of both sensors, which specify a value of *5%*.
It is also feasible to calculate these small deviations using curve fitting methods. Suitable functions are implemented in the library.

### Dynamic Range Analysis

Sensor dynamic range evaluation results for TLV493D and MMC5603NJ. \label{Sensor_dynamic_range_evaluation_results_for_TLV493D_and_MMC5603NJ.png}

With the same setup as for the linearity measurement, the (+dr) can be determined outside the range specified by the manufacturer. As a result, it is possible to analyze how the sensor behaves when the defined (+dr) is exceeded. This allows the extent to which the limits of the sensors can be exhausted to be taken into account in subsequent measurement setups.
A high (+dr) enables a more precise detection of magnetic fields, while a low (+dr) can lead to the sensor detecting magnetic fields outside its detection range.

Figure \ref{Sensor_dynamic_range_evaluation_results_for_TLV493D_and_MMC5603NJ.png} shows the plot of the linearity measurement outside the specified (+dr) for the respective sensor. 
For the *TLV493D* a (+dr) of almost double the specified (+dr) could be measured, with a peak value of *240mT* with constant linearity deviation.
The *MMC5603NJ* measures the same linear values as in the linearity measurement. From a measured value of *3.4mT* it reaches a plateau and does not increase any further.
As a result, the full specified (+dr) can be fully utilized with both sensors.

This extended characterized (+dr) is not used in the further analyses. Reference is made exclusively to the values specified by the manufacturer, as the values determined do not apply to every sensor (+ic) of the same type.

## Sensor Characterisation: Temperature Sensitivity

The temperature sensitivity of magnetic field sensors describes how sensitively the sensors output is sensitive to temperature changes.
It is important to ensure that temperature fluctuations do not affect measurement accuracy. A low temperature sensitivity reduces errors due to temperature changes [@J21].
An accurate temperature sensitivity characteristic is therefore crucial for subsequent precise magnetic field measurements.

Sensor evaluation setup for temperature sensitivity measurements. \label{Sensor_evaluation_setup_for_temperature_sensitivity_measurements.png}

As the temperature sensor *TLV493D* in particular produced vastly different results in the previous measurements, an additional temperature sensor is attached to the sensor circuit board for this measurement. 

Figure \ref{Sensor_evaluation_setup_for_temperature_sensitivity_measurements.png} represents these modifications in detail. These changes makes it possible to accurately determine the sensors (+ic) temperature.
The temperature measuring device *7055BT* can be analysed using a (+pc) interface.
The controller of the temperature chamber can also be programmed via a (+pc) interface and a target temperature can be specified.

With this setup, it is possible to automatically acquire measured values from the sensors under controlled temperature conditions.

The field of permanent magnets is highly temperature-dependent and can lose its magnetisation at higher temperatures (typically *>=80$^{\circ}$* for non-high-quality *Type-N* magnets [@GKT16]).
The temperature range is selected so that it lies within a sufficient range for typical subsequent measurement tasks.

The same procedure is used as for the *Linearity* measurement in chapter \ref{sensor-characterisation-linearity}, except that instead of moving the linear axis, the temperature of the temperature chamber is systematically increased from *20$^{\circ}$* to *50$^{\circ}$*.
Between each of these temperature changes, the system is given a additional waiting time of *30* minutes after reaching the target temperature.

### Temperature Sensitivity Analysis

Sensor temperature sensitivity evaluation results for TLV493D and MMC5603NJ. \label{Sensor_temperature_sensitivity_evaluation_results_for_TLV493D_and_MMC5603NJ.png}

Figure \ref{Sensor_temperature_sensitivity_evaluation_results_for_TLV493D_and_MMC5603NJ.png} represents the measured data as a plot with the temperature measured by the measuring devices on the X-axis and the sensor measured value on the Y-axis. The ideal baseline is also shown as a red line.
It can be seen that the *MMC5603NJ* shows a straight-line drop in the measured field strength with increasing temperatures. However, this is very constant with a value of *-2 $\mu$T / $^{\circ}$C* and is therefore predictable.

The graph of the *TLV493d* is significantly steeper with a gradient of -5.13 $\mu$T / $^{\circ}$C, and it is also not as linear as the *MMC5603NJ*; there are clear jumps in the gradient. However, the total change between the temperature regions of 175$\mu$T is less than that of the *MMC5603NJ* with *70$\mu$T*, if the total measurement range of the sensors is also considered.

In the evaluation (see Figure \ref{Sensor_temperature_sensitivity_evaluation_results_for_TLV493D_and_MMC5603NJ.png}) a linear function is also calculated using curve fitting to determine the temperature coefficients of the sensors. This makes it possible to compensate these deviations based on the ambient temperature during the software calibration.

\newpage

## Result Analysis

: Overview of all characterised sensor properties. \label{Overview_of_all_characterised_sensor_properties.csv}

| Symbol | TLV493D | MMC5603NJ | Unit | Description |
| --- | --- | --- | --- | --- |
| $N_{baseline}$ | 10000 | 10000 | - | Samples measured for baseline |
| $N_{measurement}$ | 2000 | 2000 | - | Samples measured for measurement |
| $\mu_{rv}$ | 157.23  | -50.39 | $\mu$T | Baseline without offset compensation |
| $\sigma_{rv}$ | 172.00  | 0.20 | $\mu$T | (+sd) sensor value |
| $\mu_{t}$ | 20.68 | 19.40 | $^{\circ}$C | Mean sensor temperature |
| $\sigma_{t}$ | 0.53 | 0.00 | $^{\circ}$C | (+sd) sensor temperature |
| $\mu_{trev}$ | 21.0 | 21.0 | $^{\circ}$C | Ambient temperature |
| $\mu_{sl}$ | 0.25 | 0.04 | % |  Mean sensor linearity deviation |
| $\sigma_{sl}$ | 3.64 | 0.56 | % | (+sd) sensor linearity |
| $\mu_{td}$ | -1.99 | -5.13 | $\mu$T / $^{\circ}$C |  Sensor temperature coefficients |

Table \ref{Overview_of_all_characterised_sensor_properties.csv} represents a summary of all recorded and analysed measured values of the two characterised sensors *TLV493D* and *MMC5603NJ*.
It can be clearly seen that these differ significantly by a factor of *x10*.

The *TLV493D* performs in noise measurements worse than specified in the data sheet (*100$\mu$T* instead of *175$\mu$T*), but the large (+dr), which fulfils the required specifications from chapter *Research Question* in chapter \ref{research-question-and-approach}, must be considered here, which is not met by the *MMC5603NJ*.

The *MMC5603NJ* can be used directly without additional software calibration for measuring permanent magnets. Even without additional measurement averaging, very precise measurement results can be achieved, which achieve a measurement accuracy of less than *1000 (+ppm)*.
Due to the limited (+dr) of around *±3mT*, direct measurement of stronger magnets is not possible using the *MMC5603NJ*. The *N45 12x12x12mm* magnets used in the application typically have a field strength of around *100mT* at a distance of *10mm* which is more than the *MMC5603NJ* can measure.
The *TLV493D*, on the other hand, is able to measure these ranges with a specified (+dr) of *±130mT*, but does not achieve the required accuracy due to strong noise and steep temperature coefficients.
In the following chapter, recommendations for action are defined, which are derived from the analysis results.

### Recommendation for Action

After analysing the measurement results, it can be seen that the selected sensors are only partially suitable for the previously defined requirements.

In general, further digital and analogue sensors should be characterised with the developed framework.
In particular, the use of analogue magnetic field sensors with separate bias voltage should be evaluated, as a simplified characterisation procedure can be applied due to the lack of a base offset.

In the following, alternative methods for sensor adaptions will be described that the sensors can still be used for these measurements.

#### Permanent Magnet Characterisation

Both sensors are suitable for precisely measuring and quantifying magnetic fields.
To ensure the linearity of the sensors, compensation can be performed using a defined measurement setup. This concept has already been successfully implemented in chapter *Example Sensors* \ref{example-sensors}, in particular *1D: Single Sensor* \ref{d-single-sensor}, and proven to be functional in earlier chapters.

The *MMC5603NJ* sensor has a limited measuring range, which means that it may not the best choice considering these application parameters.
However, this limitation also makes it possible to compare relative magnetic field strengths with each other.
Furthermore, by using software, it is possible to achieve absolute comparability of the magnetic fields by scaling the measured values accordingly.
This is shown in the chapter *Use Case Evaluation* \ref{use-case-evaluation} by comparing and sorting different permanent magnets using these sensors.

Overall, both the *TLV493D* and the *MMC5603NJ* offer possibilities for characterising permanent magnets. By using suitable hardware setup, software calibration methods and precise characterisations can be carried out.

#### Homogeneity Measurement of a Halbach Ring-based B0 Field

The *MMC5603NJ* cannot be used for this due to the limited value range. The method of increasing the distance, as with permanent magnet characterisation, cannot be used as the magnet is located within a limited space in the Halbach ring.

In contrast, the *TLV493D* has too much noise, so that the measured values cannot be used directly without post-processing. With software calibration, it is possible to reduce the noise to below *50$\mu$T* with the *TLV493D*. 
As a test, several further measurement runs are carried out, which achieved results for the sensor noise of *71$\mu$T* to *41$\mu$T* when averaging *100* to *1000* measured values.
However, further measurement runs must be carried out to verify these results.

In general, post-processing of the measurements should, include temperature compensation with a separate temperature sensor, especially in the case of changing measurement conditions (e.g. movement of the sensor in the *B0* field).

# Conclusion and Discussion

## Conclusion

This thesis describes the development of a (+mrp) Python library that can be used to efficiently process data from magnetic field sensors from acquisition to analysis.
To ensure a practical application and allow users to acquire their own magnetic field data directly, a low-cost and easily reproducible hardware is also developed.
The hardware is based on widely used consumer magnetic field sensors and low-cost microcontrollers, enabling an easily expandable and applicable solution for measuring magnets with repeatable accuracy.
Special attention is paid to the expandability by the user. Interchangeable modules allow the user to develop their own analysis algorithms without having to design everything from scratch. The software framework is evaluated on the basis of the previously defined use cases.
A user-defined sorting algorithm is implemented and integrated into the framework. The result is a list of the magnets that deviate least from the magnetic strength.

The result is successfully verified by means of manual checks for various other series of measurements. In this way, extensibility and customisability are also successfully demonstrated during the software evaluation.
This underlines the power of the developed framework and shows that it is not only effective in processing magnetic field sensor data, but also provides a flexible platform for the implementation of user-specific analyses.
Subsequently, the developed framework is used to automatically characterise various magnetic field sensors.
For this purpose, the developed pipeline feature of the software is used to determine various sensor characteristics, including background noise, temperature coefficients and linearity.

The evaluation of the measurement data showed that the selected sensors only partially fulfil the defined requirements. 
The *TLV493D* and *MMC5603NJ* sensors are both suitable for characterising permanent magnets and enable linearity compensation with a defined measurement setup. Although the *MMC5603NJ* has a limited measuring range, it can still be used for relative comparisons of permanent magnets without additional devices and without software calibration.
It also has a minimal long-term background noise.
Absolute comparability can be achieved by prior software calibration and using reference measurements, making it an ideal sensor for the task of characterising permanent magnets in field tests.

The *MMC5603NJ* is not recommended for measuring the homogeneity of a *50$\mu$T* *B0* field on a Halbach ring basis with an accuracy of better than *1000 (+ppm)* due to its limited measuring range. The *TLV493D* sensor, on the other hand, has too much noise.
It has been shown that this can be compensated for by software calibration and long-term averaging of measured values. Despite constant ambient conditions, temperature compensation is necessary for this sensor.
Due to the large measuring range and the constant linearity, no software compensation is necessary.
These results show that the analysed sensors are generally suitable for the application scenarios using the developed (+mrp) library with some limitations.

Based on these results, it is proposed to characterise further digital and analogue sensors, in particular analogue magnetic field sensors with separate bias voltage.
Alternative methods for sensor adaptation are described in order to be able to use these widely used consumer magnetic field sensors for the characterisation of neodymium magnet-based permanent magnets. 

## Outlook

With this version of the framework, a solid basis has been created that contains all the necessary functions to solve various problems in the acquisition and processing of magnetic fields. Easy-to-assemble measurement hardware has created an easy-to-use platform for the characterisation of permanent magnets, for example. An exemplary characterisation of the magnetic field sensors used allows the possible areas of application for these to be narrowed down. The framework has already been published in a first stable version, but extensions and improvements are still necessary.
The stable version is also distributed via a package registration and can therefore be quickly evaluated by new users. 
In addition, further user experience and actual measurements under real laboratory conditions on (+mri) B0 field magnets are still missing. This is limited by the currently restricted selection of characterised sensors. The aim for the next revision of the hardware and software framework is therefore to support additional magnetic field sensors. The current restriction to purely digital sensor interfaces is also to be extended to analogue interfaces. This will open up the use of a wide range of magnetic field sensors. It is also possible to integrate high-resolution magnetic field probes based on NMR samples, which can cover measurement errors of less than *10nT* in fields of more than *1T* [@DBN08].
Another possibility already supported by the software, but for which hardware development is still necessary, is 2D arrays of magnetic field sensors to display fields on a surface[@CP16]. This means that deviations can also be visualised graphically without physically moving the sensors such as in the implemented *3D: Full Sphere* \ref{d-full-sphere} sensor. In addition, larger areas or volumes, for example in a large *B0* field, can be measured more quickly.
