LFB-MRI/MagneticReadoutProcessing/documentation/thesis/thesis_acronyms.tex

\makeglossaries
\newacronym{ic}{IC}{Integrated Circuit}
\newacronym{mrp}{MRP}{MagneticReadoutProcessing}
\newacronym{mri}{MRI}{Magnetic Resonance Imaging}
\newacronym{rest}{REST}{Representational State Transfer}
\newacronym{pc}{PC}{Personal Computer}
\newacronym{ip}{IP}{Internet Protocol}
\newacronym{usb}{USB}{Universal Serial Bus}
\newacronym{ptp}{PTP}{Precision Time Protocol}
\newacronym{pps}{PPS}{Puls Per Second}
\newacronym{i2c}{I2C}{Inter-Integrated Circuit}
\newacronym{cli}{CLI}{Command Line Interface}
\newacronym{pip}{PIP}{Python Package Installer}
\newacronym{hal}{HAL}{Hardware Abstraction Layer}
\newacronym{pdf}{PDF}{Portable Document Format}
\newacronym{html}{HTML}{Hypertext Markup Language}
\newacronym{ide}{IDE}{Integrated Development Environment}
\newacronym{gui}{GUI}{Graphical User Interface}
\newacronym{sbc}{SBC}{Single Board Computer}
\newacronym{gpio}{GPIO}{General Purpose Input/Output}
\newacronym{uart}{UART}{Universal Asynchronous Receiver / Transmitter}
\newacronym{lut}{LUT}{Lookup Table}
\newacronym{cdc}{CDC}{Communication Device Class}
\newacronym{cad}{CAD}{Computer Aided Design}
\newacronym{json}{JSON}{JavaScript Object Notation}
\newacronym{id}{ID}{Identification Number}
\newacronym{pcb}{PCB}{Printed Circuit Board}
\newacronym{os}{OS}{Operating System}
\newacronym{uuid}{UUID}{Universal Unique Identifier}
\newacronym{nmr}{NMR}{Nuclear Magnetic Resonance}
\newacronym{dut}{DUT}{Device Under Test}
\newacronym{ppm}{ppm}{Parts Per Million}
\newacronym{snr}{SNR}{Signal to Noise Ratio}
\newacronym{sd}{SD}{Standard Deviation}
\newacronym{yaml}{YAML}{Yet Another Markup Language}
\newacronym{dr}{DR}{Dynamic Range}
\newacronym{mds}{MDS}{Minimum Detectable Signal}
\newacronym{cog}{CoG}{Center Of Gravity}
\newacronym{adc}{ADC}{Analog to Digital Converter}
\newacronym{ai}{AI}{Artificial Intelligence}
\newacronym{pla}{PLA}{Polylactic Acid}
