LFB-MRI/MagneticReadoutProcessing/documentation/thesis/thesis_titleinformation.tex

% Angaben für Titelseite
\arbeitstyp{Master Thesis}
\fachbereich{Electrical Engineering and Information Technology}
\studiengang{Information Systems Engineering}
\vertiefung{}
\titel{Development of a hardware and software framework for the automated characterization
of permanent magnets for low-field MRI systems}
\autor{Marcel Werner Heinrich Friedrich Ochsendorf}
\matrnr{3120232}
\betreuer{Prof. Dr.-Ing. Thomas Dey}
\cobetreuer{Prof. Dr.-Ing. Volkmar Schulz}
\extbetreuer{}
\datum{23.02.2024}
\dank{}
