LFB-MRI/MagneticReadoutProcessing/documentation/thesis/thesis_attachments.tex

\hypertarget{attachments}{%
\chapter{Attachments}\label{attachments}}
