LFB-MRI/MagneticReadoutProcessing/documentation/thesis/images/Example_Halbach_ring_magnet_with_cutouts_for_eight_cubical_permanent_magnets.png.md

Example Halbach ring magnet with cutouts for eight cubical permanent magnets. \label{Example_Halbach_ring_magnet_with_cutouts_for_eight_cubical_permanent_magnets.png}
