LFB-MRI/MagneticReadoutProcessing/documentation/thesis/images/Example_Halbach_ring_with_cutouts_for_eight_magnets.png.md

Example Halbach ring with cutouts for eight magnets. \label{Example_Halbach_ring_with_cutouts_for_eight_magnets.png}
