LFB-MRI/MagneticReadoutProcessing/documentation/thesis/images/MagneticReadoutProcessing_documentation_hosted_on_ReadTheDocs.png.md

MagneticReadoutProcessing documentation hosted on ReadTheDocs. \label{MagneticReadoutProcessing_documentation_hosted_on_ReadTheDocs.png}
