LFB-MRI/MagneticReadoutProcessing/documentation/thesis/images/MagneticReadoutProcessing_library_hosted_on_PyPi.png.md

MagneticReadoutProcessing library hosted on PyPi. \label{MagneticReadoutProcessing_library_hosted_on_PyPi.png}
