LFB-MRI/MagneticReadoutProcessing/docs/index.rst

.. .. include:: ../README.rst

Welcome to the MagneticReadoutProcessing library documentation!
===============================================================

**MagneticReadoutProcessing**  is a Python library that makes it possible to store and further process raw data from magnetometers.
The focus is on the processing of point clouds, on which the points are located on a circular path around a magnetic object to be viewed.
Measurement data (hemisphere) can later be combined into a full 3D scan, visualized and compared with reference measurements.

.. note::
   This project is under active development.

Contents
--------

.. toctree::
   :maxdepth: 4
   :caption: Contents:
   Home <self>
   usage
   API <api>
