LFB-MRI/MagneticReadoutProcessing/documentation/sciencemeeting/slides/0-main.md

# A short introduction into the MagneticReadoutProcessing ecosystem

---
## Hi, I´m Marcel

* Technical Computer Science B.Sc.
* [Information Systems Engineering M.Eng]

---
## I like to build stuff

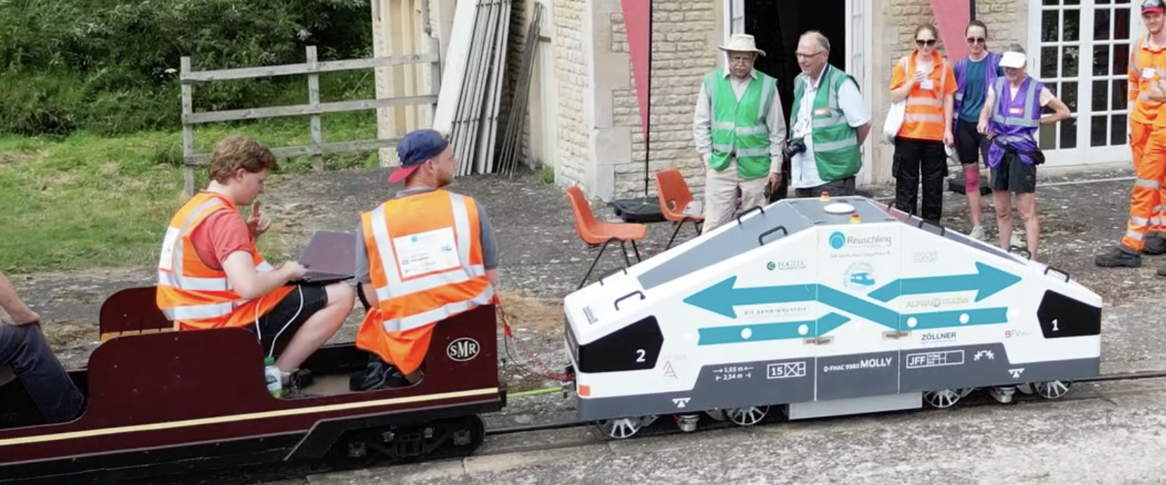
[picture p51: documentation/sciencemeeting/images/loco.png]
loco


---

## and clocks

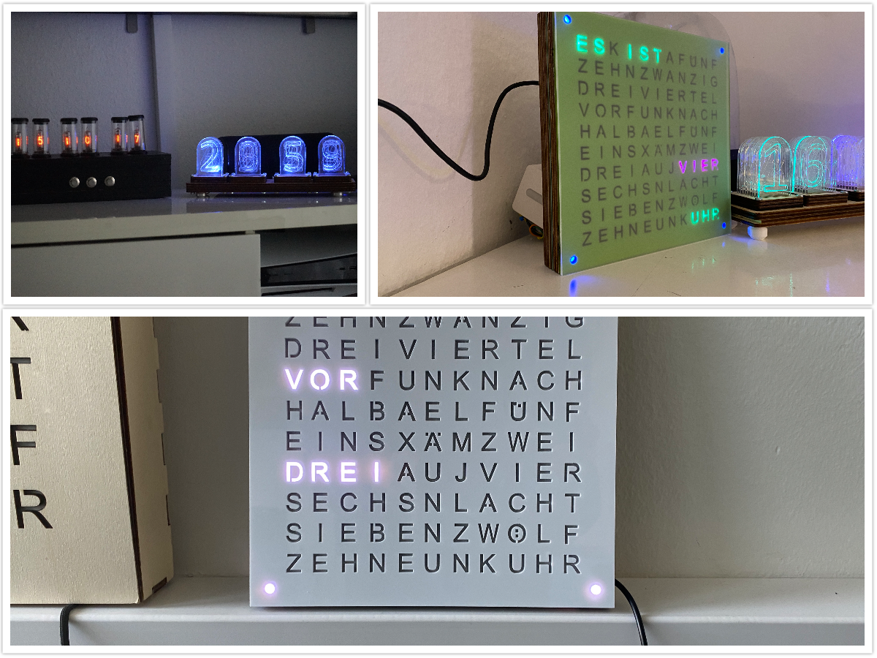
[picture p52: documentation/sciencemeeting/images/clocks.png]
clock_1


---

## Let´s build an Low-Field MRI 

Using exising OpenSource projects

* [open-source-mri-scanner](https://www.opensourceimaging.org/2023/01/09/first-open-source-mri-scanner-presented-the-osii-one/)

* [OCRA](https://openmri.github.io/ocra/)

* [TableTopMRI](https://www.opensourceimaging.org/project/instructional-tabletop-mri-scanner/)

---

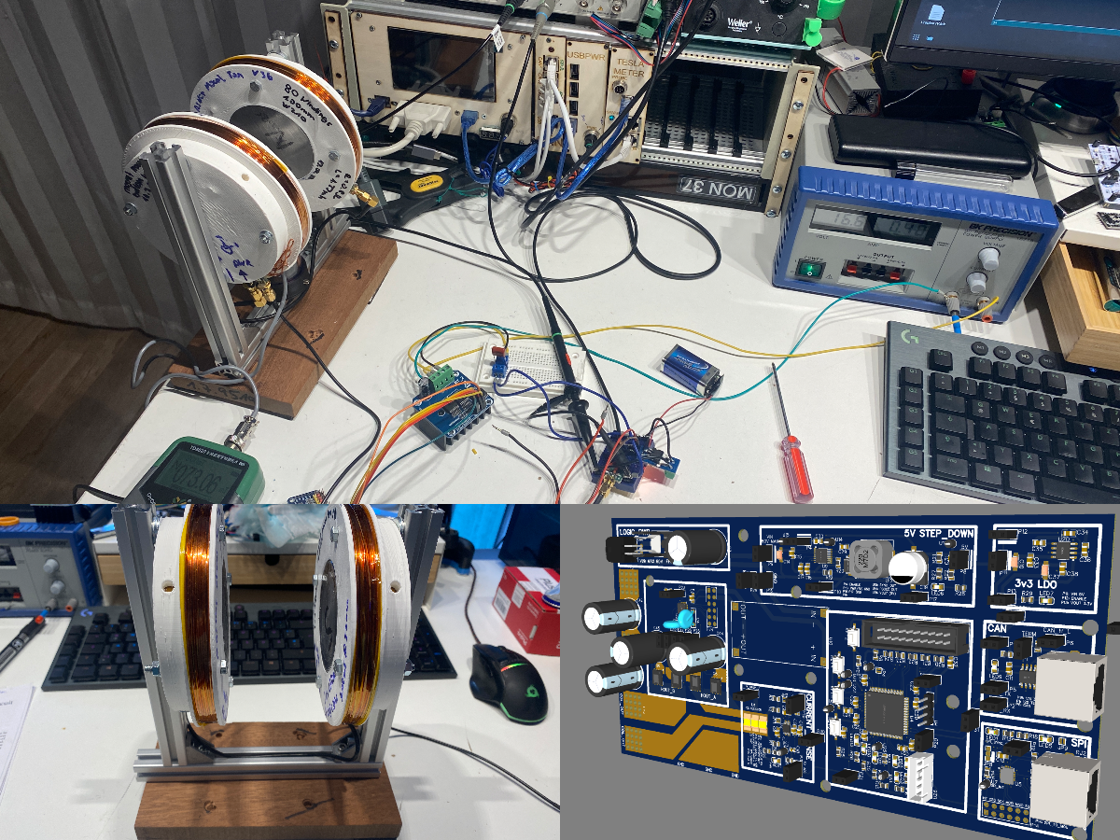
[picture p53: documentation/sciencemeeting/images/mri_1.png]


---

# Problem: We need a magnet

* 20cm bore
* homogeneity around 1000ppm
* easy to manufacture parts

https://www.opensourceimaging.org/project/halbach-array-magnet-for-in-vivo-imaging/

---

Due to the complex manufacturing process, permanent magnets are not identical in their:

* field strength
* magnetisation direction

---

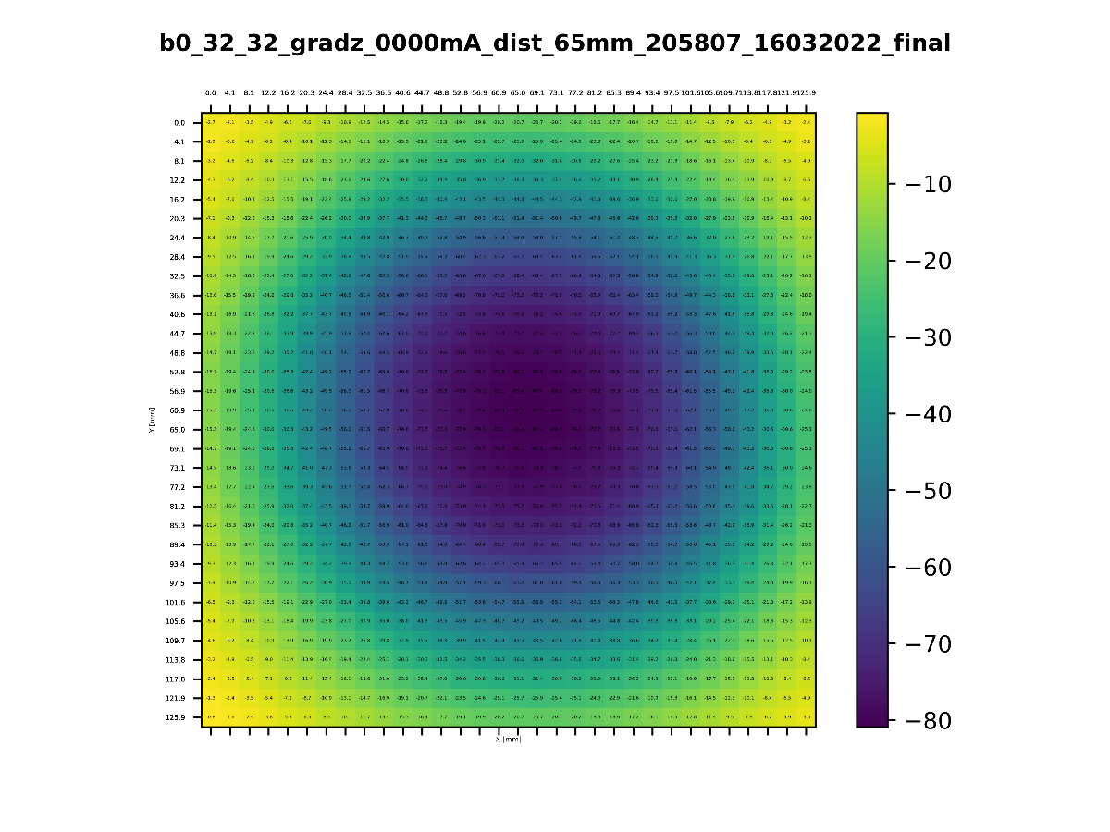
[picture p54: documentation/sciencemeeting/images/magnet_1.png]
magnet_example


---

# Shimming

Improving homogeneity through shimming:

* complex and time intensive task

---

# Idea: Chracterise the magnets beforehand

* Measure key parameters (field strength, magnetisation direction, temperature behavior)
* Sort and generate a improved magnet design out of the collected data. 

---

# Existing research examples

---

### Optimisation algorithms

* [HalbachOptimisation](https://github.com/LUMC-LowFieldMRI/HalbachOptimisation)
* [Practical Concepts for Design, Construction and Application of Halbach Magnets in Magnetic Resonance](https://link.springer.com/article/10.1007/s00723-023-01602-2)

---

### CAD Model design script

* [HalbachMRIDesigner](https://github.com/menkueclab/HalbachMRIDesigner)
* [Variable single-axis magnetic-field generator using permanent magnets](https://www.semanticscholar.org/paper/Variable-single-axis-magnetic-field-generator-using-Tretiak-Blümler/b82f37c32d0e06dd4482d027adeae61c1ce54732)

---

## Issues

* solutions are not built on top of each other
* difficult to use the results among each other

---

# Solution: The MagneticReadoutProcessing framework

* OpenSource software and hadware design
* Provides complete data processing pipeline form DAQ to CAD
* Easy modifcation of processings steps without rewriting everything

---

## Hardware framework

* 1D - 3D mapping
* Range from 0.005 to 100 mT
* Inexpensive sensors: TLV493d, MMC5603, BMM150
* Interchangeable 3D printed mounts for different permanent magnet types
* Unified-Firmware: One firmware for all most common sensors
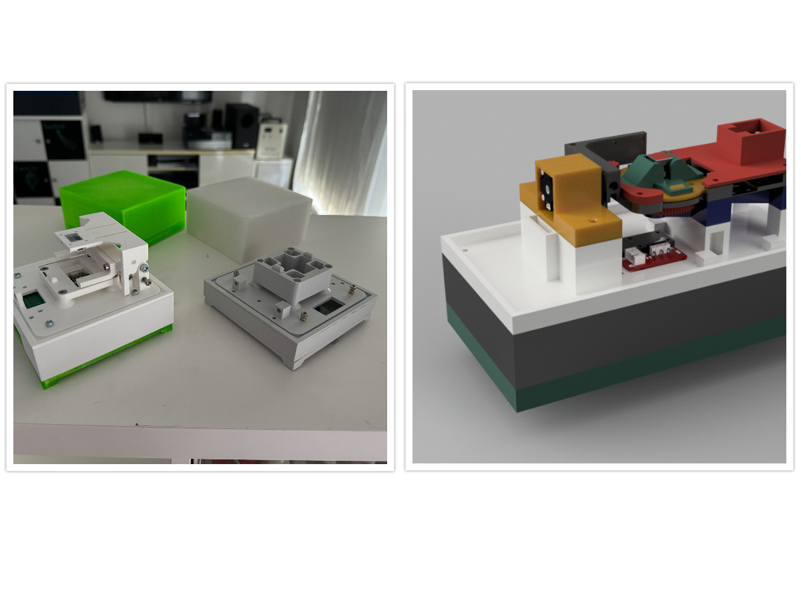
[picture p55: documentation/sciencemeeting/images/sensors_1.png]


---

[3D mapping example](https://youtu.be/Lp4kPV_stg4)

---
## Software framework

* Python3 based with type annotations
* Interchangeable dataformats (JSON, Matlab, Numpy)
* Fully tested using pytest
* Online documentation
* No programming skills required

---

## Processing pipeline

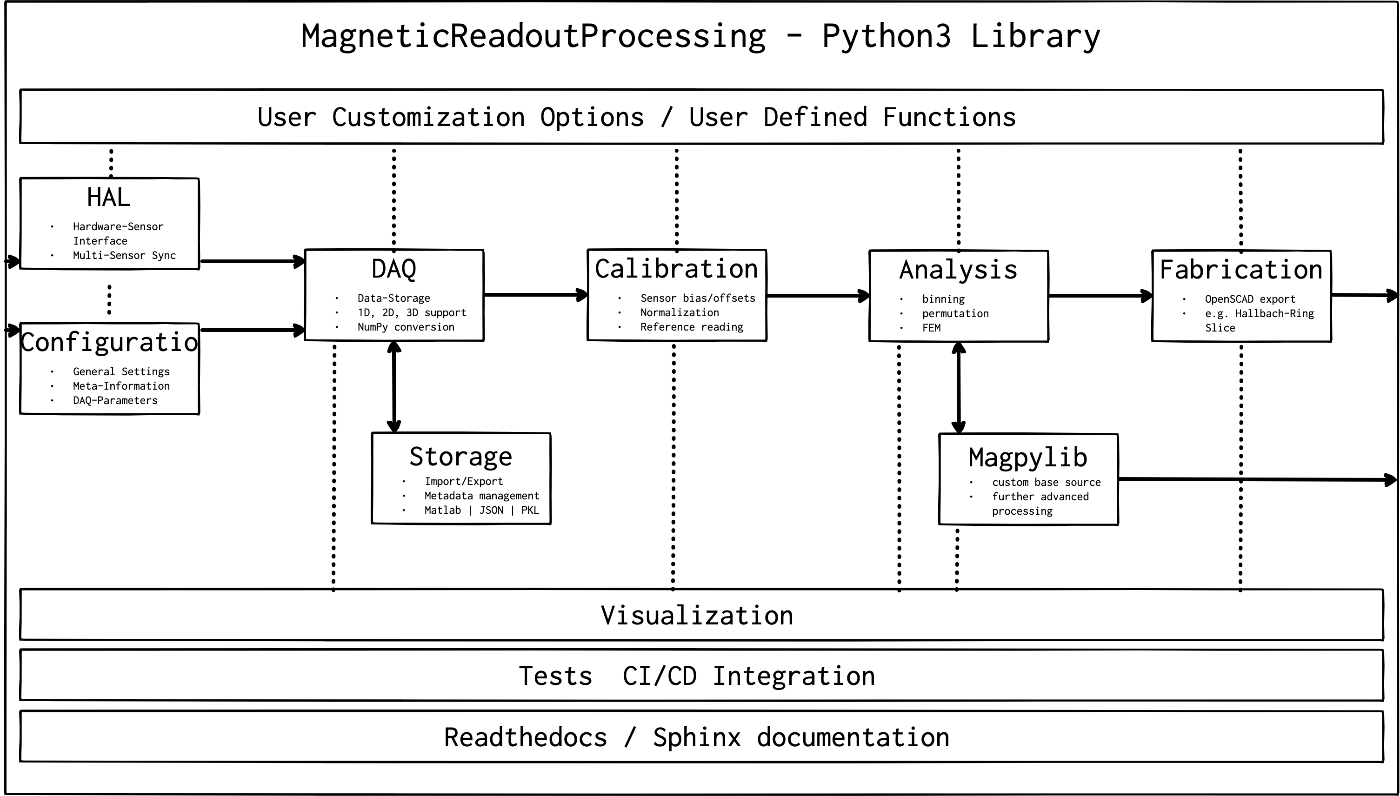
[picture p56: documentation/sciencemeeting/images/MRP_COMPLETE_FLOW.png]


---

## CLI and programmable processing pipeline

* Userfriendly CLI to configure measurements
* Drag&Drop processing pipeline

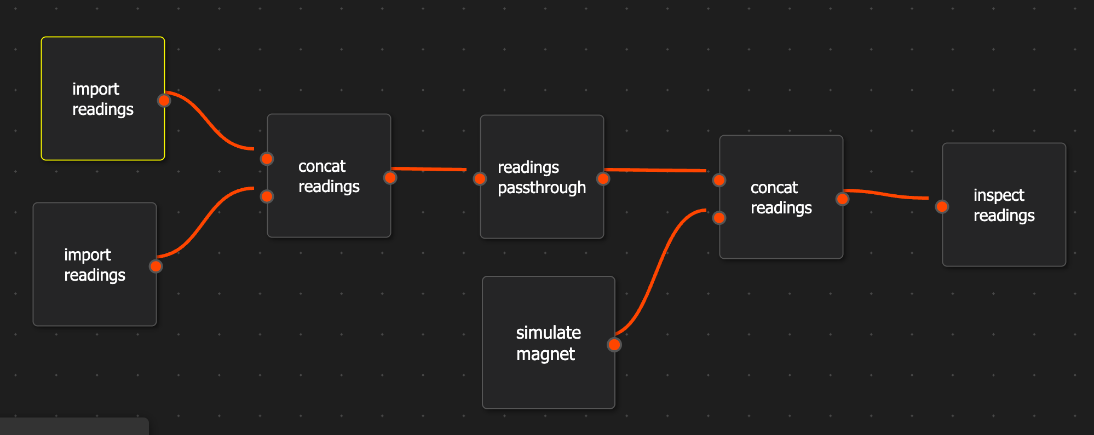
[picture p57: documentation/sciencemeeting/images/dataprocessing_pipeline.png]


---

# DEMO TIME

---

# Outlook

* further evaluation needed
* Hardware accuracy measurements for all sensors needed

---

# Questions ?

---

# Backup

---

* cheap magnetic field camera development

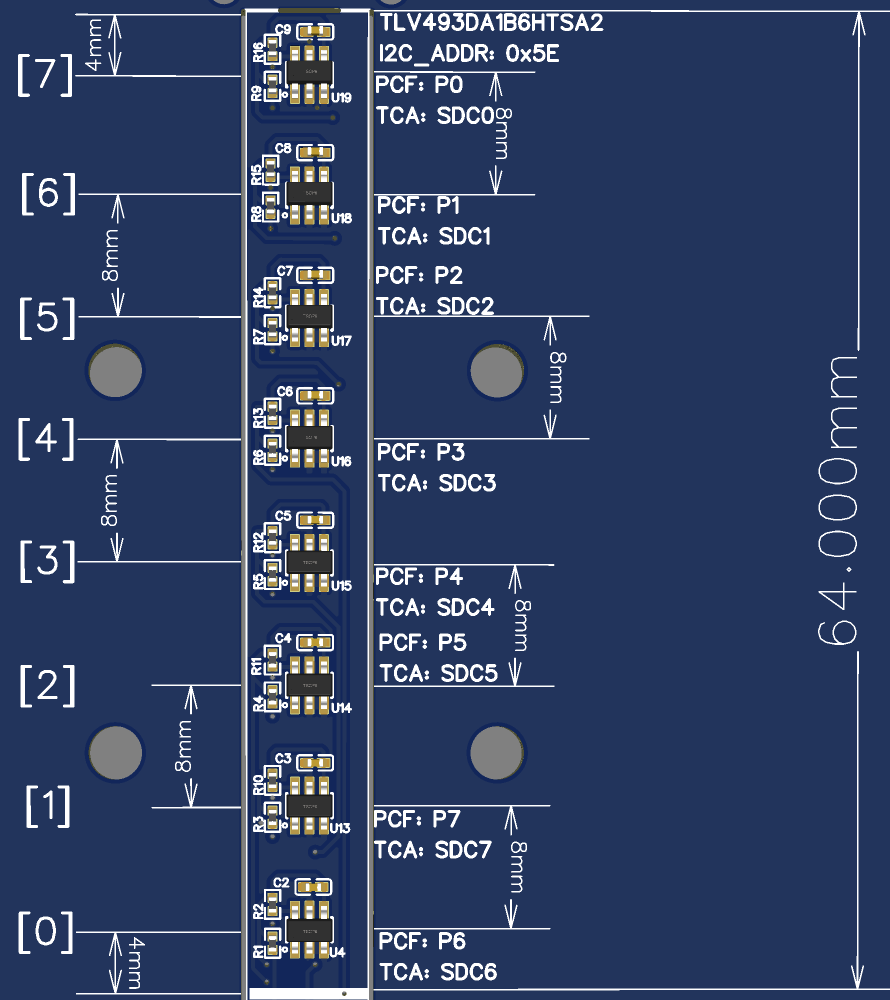
[picture p58: documentation/sciencemeeting/images/magcam.png]


---
