LFB-MRI/MagneticReadoutProcessing/src/MagneticReadoutProcessing/docs/source/UserDefinedProcessingPipeline.rst

Module - UserDefinedProcessingPipeline
==================================

.. note::
    This user programmable processing pipeline module is currently a proof of concept

.. note::
    Some classes are missing in the current state of this documentation.

.. rubric:: Modules

.. autosummary::
    :toctree: _autosummary
    :template: custom-module-template.rst
    :recursive:

    udpp
