LFB-MRI/MagneticReadoutProcessing/src/MagneticReadoutProcessing/docs/source/MagneticReadoutProcessing.rst

Module - MagneticReadoutProcessing
==================================

.. note::
    The data handling/processing is not optimized!
    Major changes to the structure may come in future versions!

.. note::
    Some classes are missing in the current state of this documentation.

.. rubric:: Modules

.. autosummary::
    :toctree: _autosummary
    :template: custom-module-template.rst
    :recursive:

    MRP
