LFB-MRI/MagneticReadoutProcessing/documentation/thesis/thesis.tex

\documentclass [
  english
% 	draft		% falls ohne Bilder gedruckt werden soll (Entwurf)
	]{scrbook}	% KOMA Klasse für Bücher

%%MOD%%
\usepackage{fhacmb}	% Style-File für Titelblatt. Ggf. bei Enning holen

\KOMAoptions{
	parskip=true,		% Absätze mit Abstand
	fontsize=12pt,		% Standardschriftgröße
	toc=flat,		% Inhaltsverzeichnis ohne Einzüge
	twoside=false,		% Einseitig setzen
	numbers=nodotatend,	% Nummerierungen nicht mit Punkt abschließen
% die folgenden Optionen nehmen die entsprechende Dinge ins Inhaltsverzeichnis auf
% mit der bei texlive vorhandenen aktuellen Version von pdflatex funkioniert es nicht mehr
% (bekannter Bug)
	toc=bibliography,	% Literaturverzeichnis ins Inhaltsverzeichnis
	toc=listof,		% Abbildung- und Tabellenverzeichnis ins Inhaltsverzeichnis
	toc=index,		% Stichwortverzeichnis ins Inhaltsverzeichnis
	}
%

\usepackage{amsmath,amssymb}
\numberwithin{equation}{section}
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
\linespread{1.25} 		% Zeilenabstand nach Vorgabe
%
\usepackage{chngcntr}		% Ändert Verhalten von Countern
\counterwithout{figure}{section}	% Figure-Nummerierung nicht bei section-Wechsel zurücksetzen
\renewcommand{\thefigure}{\textbf\thechapter-\arabic{figure}}	% im Stil 3-2
%
%%%% für das Erzeugen von Grafiken mit Zeichenbefehlen
%
\usepackage{tikz}		% Grundpaket
\usetikzlibrary{shapes,arrows}	% einige Symbolpackages
\usepackage{tikz-cd}		% einige Symbolpackages

%
%%%% TABELLEN
%
\usepackage{colortbl}		% für die Hintergrundfarbe von Tabellen
\usepackage{paralist}		% Weitere Nummeriungsoptionen, z.b. alphabetisch für enumerate/itemize

\usepackage{longtable}% FOR PANDOC TABLE GENERATOR
\usepackage{booktabs} % FOR TOPRULE MIDRULE

%
%%%% CODE
%
\usepackage{listings}

\lstset{ 
%  backgroundcolor=\color{white},   % choose the background color; you must add \usepackage{color} or \usepackage{xcolor}; should come as last argument
  basicstyle=\footnotesize,        % the size of the fonts that are used for the code
  breakatwhitespace=false,         % sets if automatic breaks should only happen at whitespace
  breaklines=true,                 % sets automatic line breaking
  captionpos=b,                    % sets the caption-position to bottom
  extendedchars=true,              % lets you use non-ASCII characters; for 8-bits encodings only, does not work with UTF-8
 % frame=single,	                   % adds a frame around the code
  keepspaces=true,                 % keeps spaces in text, useful for keeping indentation of code (possibly needs columns=flexible)
%  keywordstyle=\color{blue},       % keyword style
  numbers=left,                    % where to put the line-numbers; possible values are (none, left, right)
  numbersep=5pt,                   % how far the line-numbers are from the code
%  rulecolor=\color{black},         % if not set, the frame-color may be changed on line-breaks within not-black text (e.g. comments (green here))
  tabsize=2,	                   % sets default tabsize to 2 spaces
  title=\lstname                   % show the filename of files included with \lstinputlisting; also try caption instead of title
}

%
%%%% UNORDERED LISTS
%
\renewcommand{\labelitemii}{$\circ$} % Bullets für itemize-Listen

%
%%%% PAGE AND FIGURE NUMBERING
%
\usepackage{chngcntr}		% Ändert Verhalten von Countern
\counterwithout{figure}{section}	% Figure-Nummerierung nicht bei section-Wechsel zurücksetzen
\renewcommand{\thefigure}{\textbf\thechapter-\arabic{figure}}	% im Stil 3-2

%\usepackage{subfig}		% Unterfigures mit eigenen Bildunterschriften
\usepackage{caption}
\captionsetup[table]{name=Table}
%\setcounter{tocdepth}{3} % SHOW SUB SUB SUB SUB SECTIONS

%
%%%% acronyms
%

\usepackage{pdflscape}

%\usepackage{hyperref}
%\usepackage[colorlinks=true, urlcolor=blue, linkcolor=red]{hyperref}

\usepackage[acronym]{glossaries}
\makeglossaries

\input{thesis_acronyms}
%
%%%%%%%%%%  Angaben für Titelseite %%%%%%%%%%%%%%%%%%%%%%
%
\input{thesis_titleinformation}

%\hypersetup{draft} %DISBALE HYPERLINKS
% https://charly-lersteau.com/posts/2019-12-26-latex-hyperref-error-pdfendlink/
%\usepackage{etoolbox}

%\makeatletter
%\patchcmd\@combinedblfloats{\box\@outputbox}{\unvbox\@outputbox}{}{%
 %   \errmessage{\noexpand\@combinedblfloats could not be patched}%
%}%
%\makeatother

\usepackage{rotating}

\definecolor{LightCyan}{rgb}{0.88,1,1}
\definecolor{Gray}{gray}{0.9}
\usepackage[first=0,last=9]{lcg}
\newcommand{\ra}{\rand0.\arabic{rand}}

% ADD PAGE PACING FOR BETTER READABLE TABLES
\newcolumntype{g}{>{\columncolor{Gray}}c}
\renewcommand*{\arraystretch}{2} %2.0 IS  THE SPACING

\usepackage[
    backend=bibtex,
    style=alphabetic,
  ]{biblatex}
\addbibresource{thesis_references.bib}
%\usepackage[square,numbers]{natbib}
%\bibliographystyle{ieeetr}
%\newcommand{\customcite}[1]{\citepalias{#1}}
%\bibliographystyle{plaindin}
\newcommand{\customcite}[1]{\cite{#1}}

\begin{document}

%\input{thesis_references_alias}

%%MOD%%
% Einige Anpassungen müssen nach \begin{document} stehen !!
\renewcaptionname{ngerman}{\figurename}{\textbf Figure} 	% Bild ... statt Abbildung ...
\renewcaptionname{ngerman}{\contentsname}{Contents}% Inhalt statt Inhaltsverzeichnis
\renewcaptionname{ngerman}{\bibname}{Bibliography}
\renewcaptionname{ngerman}{\tablename}{Table}
\renewcaptionname{ngerman}{\listfigurename}{List of Figures}
\renewcaptionname{ngerman}{\listtablename}{List of Tables}
\renewcommand*{\acronymname}{List of Abbreviations}
% printglossaries
%%%%%%%%%%%%%%%%%%%%%%%%%%%%%%%%%%%%%%%%%%%%%%%%%%%%%%%%%%%%
% Titel im FH Style
%%%%%%%%%%%%%%%%%%%%%%%%%%%%%%%%%%%%%%%%%%%%%%%%%%%%%%%%%%%%
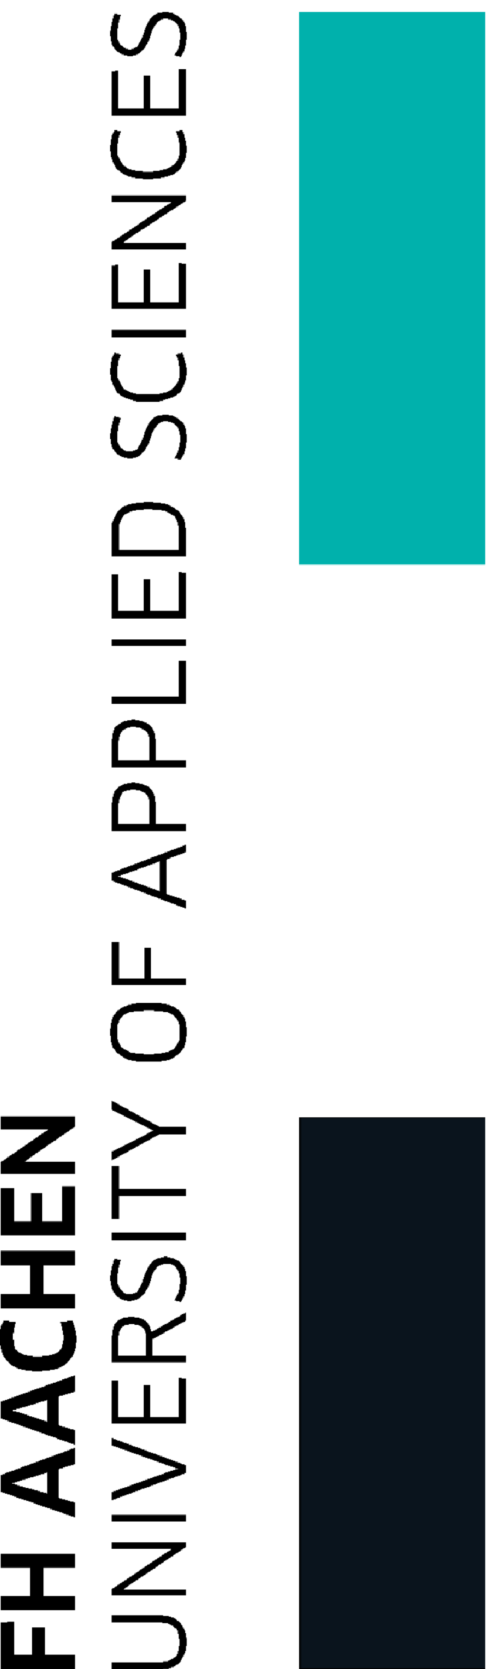
[picture p70: documentation/thesis/fh_logo.png]
\fhacmbtitle{}{5pt}{5pt}
%%%%%%%%%%%%%%%%%%%%%%%%%%%%%%%%%%%%%%%%%%%%%%%%%%%%%%%%%%%%
% Erklärung / Geheimhaltung
%%%%%%%%%%%%%%%%%%%%%%%%%%%%%%%%%%%%%%%%%%%%%%%%%%%%%%%%%%%%
%\frontmatter 	% Wenn der Hauptteil mit Seite 1 beginnen soll
\pagestyle{plain}

\frontmatter

%%%%%%%%%%%%%%%%%%%%%%%%%%%%%%%%%%%%%%%%%%%%%%%%%%%%%%%%%%%%
% Erklaerung
%%%%%%%%%%%%%%%%%%%%%%%%%%%%%%%%%%%%%%%%%%%%%%%%%%%%%%%%%%%%
\newpage

\hypertarget{erkluxe4rung}{%
\section*{Erklärung}\label{erkluxe4rung}}
\input{thesis_declaration}

%%%%%%%%%%%%%%%%%%%%%%%%%%%%%%%%%%%%%%%%%%%%%%%%%%%%%%%%%%%%
% ABSTRACT
%%%%%%%%%%%%%%%%%%%%%%%%%%%%%%%%%%%%%%%%%%%%%%%%%%%%%%%%%%%%
\newpage

\hypertarget{abstract}{%
\section*{Abstract}\label{abstract}}
\input{thesis_abstract}

\newpage
%%%%%%%%%%%%%%%%%%%%%%%%%%%%%%%%%%%%%%%%%%%%%%%%%%%%%%%%%%%%
% ACRONYM VERZEICHNIS
%%%%%%%%%%%%%%%%%%%%%%%%%%%%%%%%%%%%%%%%%%%%%%%%%%%%%%%%%%%%
\printglossaries

\newpage
%%%%%%%%%%%%%%%%%%%%%%%%%%%%%%%%%%%%%%%%%%%%%%%%%%%%%%%%%%%%
% Inhaltsverzeichnis
%%%%%%%%%%%%%%%%%%%%%%%%%%%%%%%%%%%%%%%%%%%%%%%%%%%%%%%%%%%%
\tableofcontents

%%%%%%%%%%%%%%%%%%%%%%%%%%%%%%%%%%%%%%%%%%%%%%%%%%%%%%%%%%%%
% CONTENT
%%%%%%%%%%%%%%%%%%%%%%%%%%%%%%%%%%%%%%%%%%%%%%%%%%%%%%%%%%%%
\mainmatter	% Wenn der Hauptteil mit Seite 1 beginnen soll
\pagestyle{scrheadings}
%%%%%%%%%%%%%%% Anpassung des Seitenstils an FH-Layoutvorschrift %%%%%%%%%%%%
\renewcommand{\chaptermark}[1]{\markboth{\thechapter\hspace{1cm}#1}{}}	% Kapitel für Headerzeile neu definieren (ohne Nummer)
\chead{}		% Header Mitte löschen
\ihead{\leftmark}	% Kapitelbezeichnung links setzen
\renewcommand{\headfont}{\bfseries}	% Bold-Font für Headerzeile verwenden
\setheadsepline{0.5pt}

\input{thesis_document}

%%%%%%%%%%%%%%%%%%%%%%%%%%%%%%%%%%%%%%%%%%%%%%%%%%%%%%%%%%%%
% REFERENZEN
%%%%%%%%%%%%%%%%%%%%%%%%%%%%%%%%%%%%%%%%%%%%%%%%%%%%%%%%%%%%
%% Verschiedene Versionen, nach DIN 1505 zu zitieren
%\bibliographystyle{plaindin}
%\interlinepenalty=10000
%\bibliography{thesis_references}
\printbibliography
%%%%%%%%%%%%%%%%%%%%%%%%%%%%%%%%%%%%%%%%%%%%%%%%%%%%%%%%%%%%
% ABBILDUNGSVERZEICHNIS
%%%%%%%%%%%%%%%%%%%%%%%%%%%%%%%%%%%%%%%%%%%%%%%%%%%%%%%%%%%%
\pagebreak
\addcontentsline{toc}{chapter}{Figures} 
\listoffigures

%%%%%%%%%%%%%%%%%%%%%%%%%%%%%%%%%%%%%%%%%%%%%%%%%%%%%%%%%%%%
% ABBILDUNGSVERZEICHNIS
%%%%%%%%%%%%%%%%%%%%%%%%%%%%%%%%%%%%%%%%%%%%%%%%%%%%%%%%%%%%
\pagebreak
\listoftables

\pagebreak
\chapter*{List of Equations}
\addcontentsline{toc}{chapter}{Equations} 
\listofmyequations

%%%%%%%%%%%%%%%%%%%%%%%%%%%%%%%%%%%%%%%%%%%%%%%%%%%%%%%%%%%%
% CODEVERZEICHNIS
%%%%%%%%%%%%%%%%%%%%%%%%%%%%%%%%%%%%%%%%%%%%%%%%%%%%%%%%%%%%
\lstlistoflistings

%%%%%%%%%%%%%%%%%%%%%%%%%%%%%%%%%%%%%%%%%%%%%%%%%%%%%%%%%%%%
% ANHANG
%%%%%%%%%%%%%%%%%%%%%%%%%%%%%%%%%%%%%%%%%%%%%%%%%%%%%%%%%%%%
%\newpage
%\appendix % ANHANG EINLEITEN
%\input{thesis_attachments}

\end{document}
