LFB-MRI/MagneticReadoutProcessing/documentation/thesis/images/_MRP_library_implemented_modules_high_level_overview_each_of_which_can_be_replaced_by_the_user_with_custom_ones.png.md

MRP library implemented modules high level overview each of which can be replaced by the user with custom ones. \label{_MRP_library_implemented_modules_high_level_overview_each_of_which_can_be_replaced_by_the_user_with_custom_ones.png}
