LFB-MRI/MagneticReadoutProcessing/documentation/thesis/images/pipeline_output_files_after_running_example_pipeline_on_a_set_of_readings.png.md

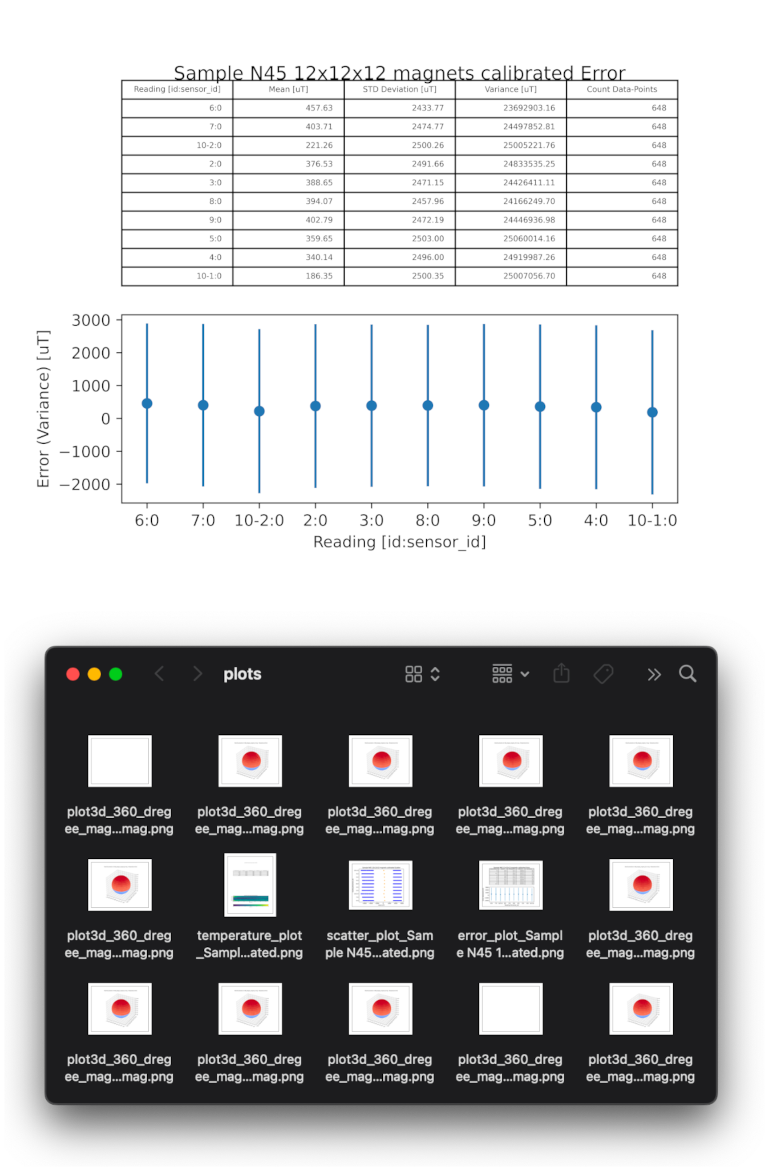
[picture p71: documentation/thesis/generated_images/border_pipeline_output_files_after_running_example_pipeline_on_a_set_of_readings.png]
Pipeline output files after running example pipeline on a set of readings \label{Pipeline_output_files_after_running_example_pipeline_on_a_set_of_readings.png}
