LFB-MRI/MagneticReadoutProcessing/src/MagneticReadoutProcessing/readings/_old/generated/reports/simulated_magnet_0.report.txt

########## READING REPORT ##########
            NAME: simulated_magnet_0
            No Datapoints: 648
            B [mT]: 0.00032643434637548825
            Temperature [°C]: -254.0
            CenterOfGravity [x y z] normalized: [0.016653886816761675 1.4369529665112585e-17 -4.968590696624929e-17]
            ######## END READING REPORT ########
