LFB-MRI/MagneticReadoutProcessing/documentation/colloquium/presentation/images/eval/Linearity_of_TLV493D_using_120_samples_over_an_distance_of_120_linear.png

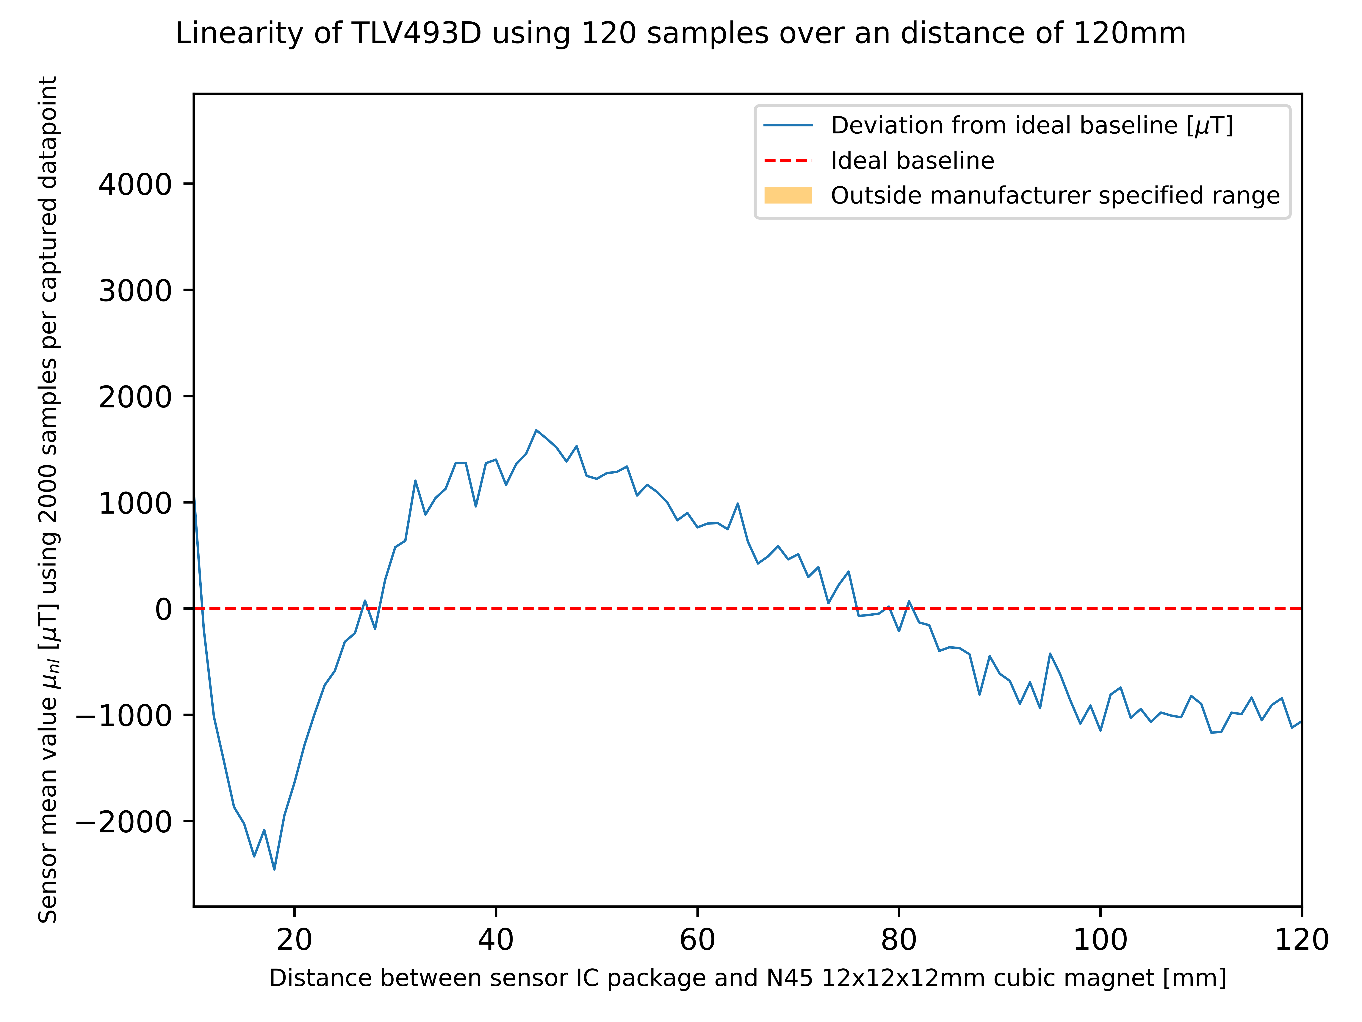
documentation/colloquium/presentation/images/eval/Linearity_of_TLV493D_using_120_samples_over_an_distance_of_120_linear.png
