LFB-MRI/MagneticReadoutProcessing/documentation/images/misc/IMG_2861.JPG

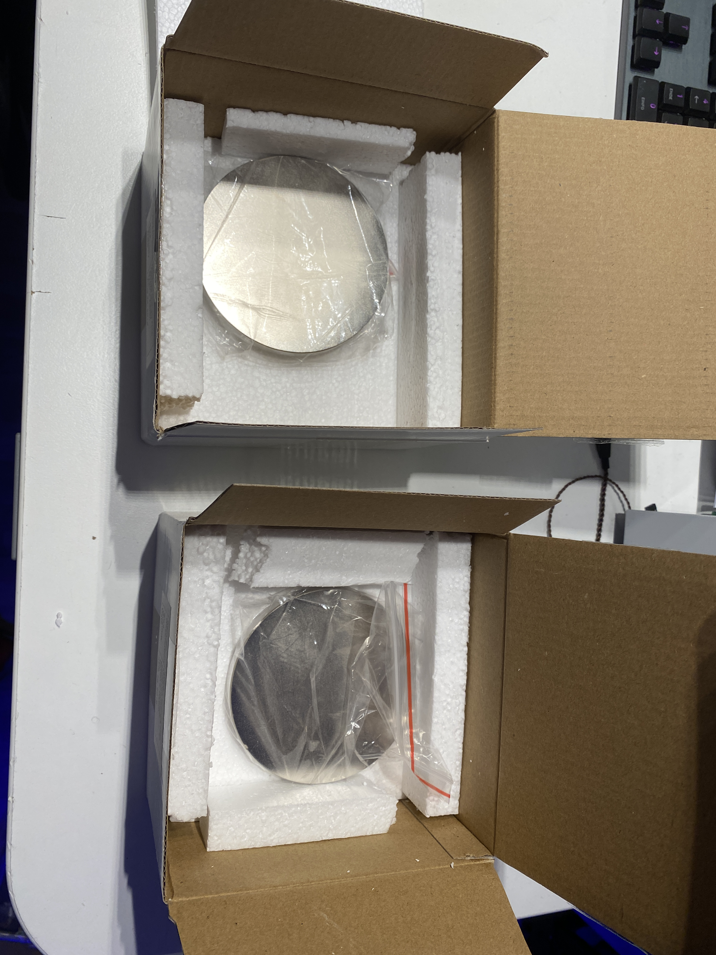
documentation/images/misc/IMG_2861.JPG
