LFB-MRI/MagneticReadoutProcessing/documentation/images/misc/IMG_2878.JPG

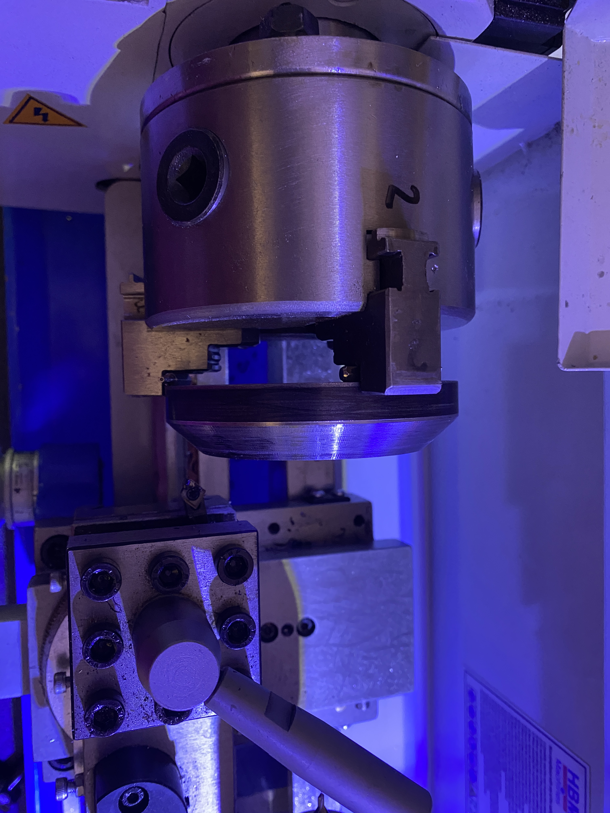
documentation/images/misc/IMG_2878.JPG
