LFB-MRI/MagneticReadoutProcessing/documentation/images/misc/IMG_2891.JPG

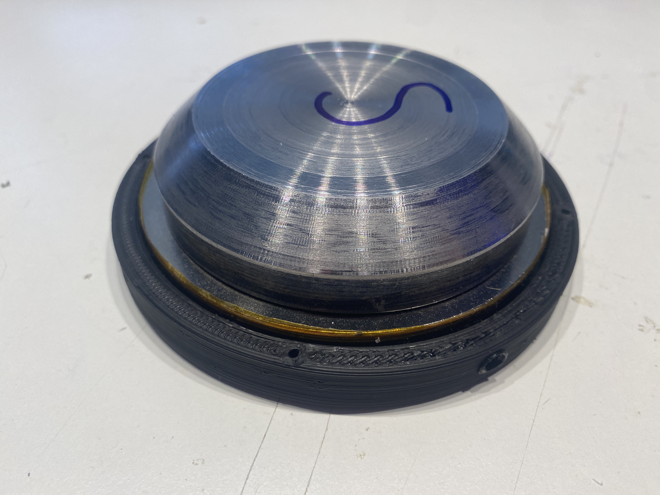
documentation/images/misc/IMG_2891.JPG
