LFB-MRI/MagneticReadoutProcessing/documentation/images/misc/IMG_2912.JPG

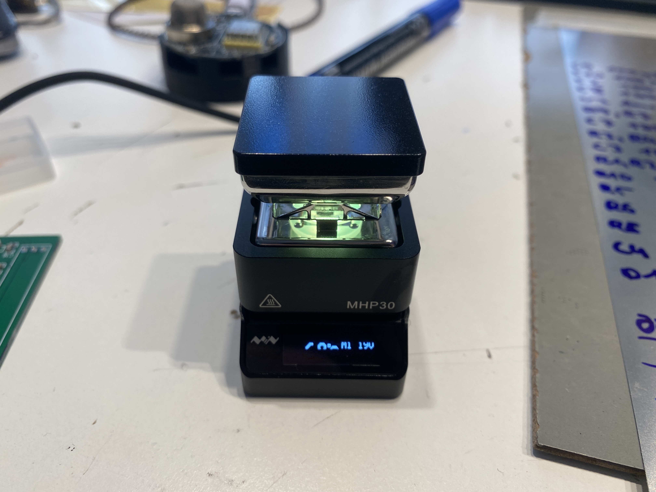
documentation/images/misc/IMG_2912.JPG
