LFB-MRI/MagneticReadoutProcessing/documentation/images/misc/IMG_3052 2.JPG

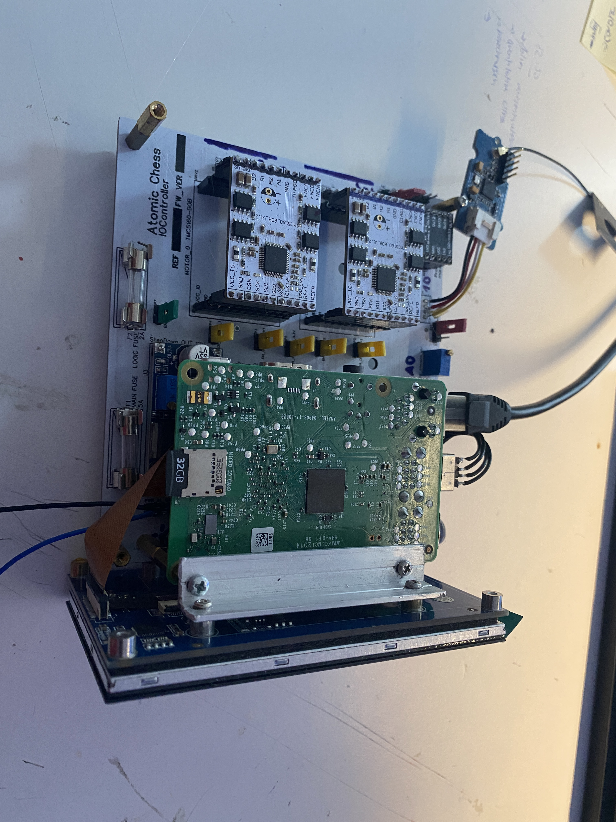
documentation/images/misc/IMG_3052 2.JPG
