LFB-MRI/MagneticReadoutProcessing/documentation/images/misc/IMG_3063.JPG

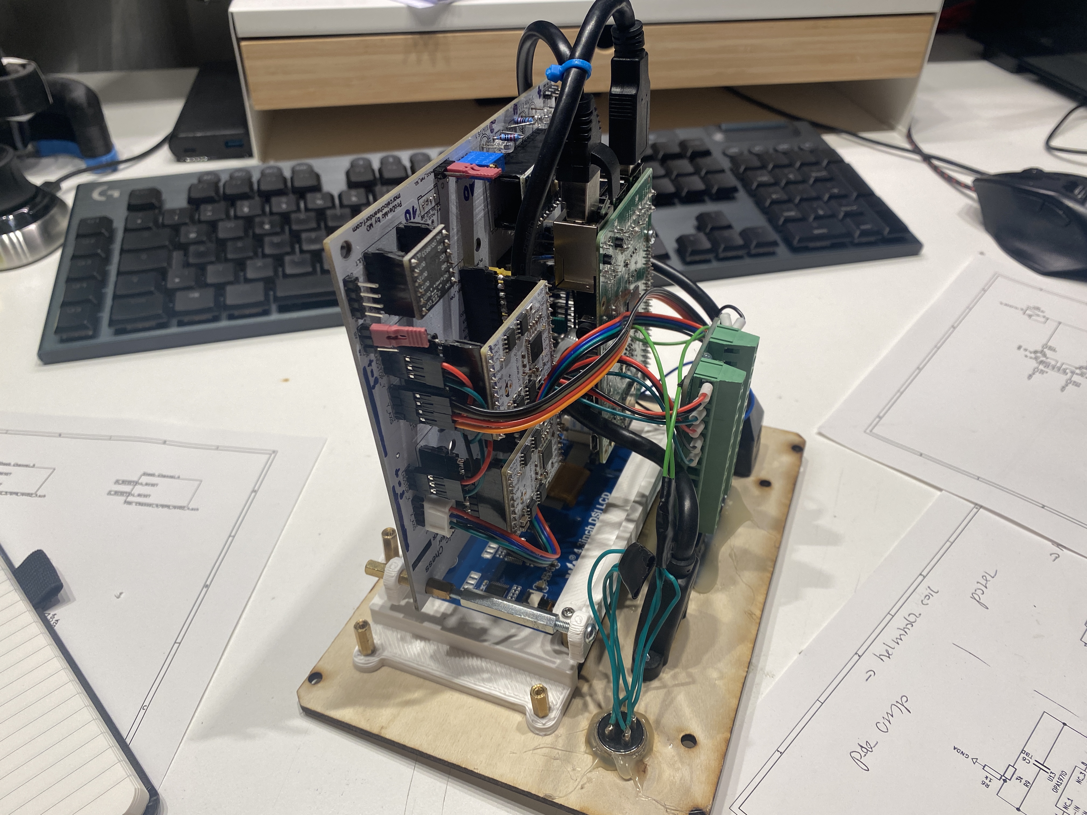
documentation/images/misc/IMG_3063.JPG
