LFB-MRI/MagneticReadoutProcessing/documentation/images/misc/IMG_3083.JPG

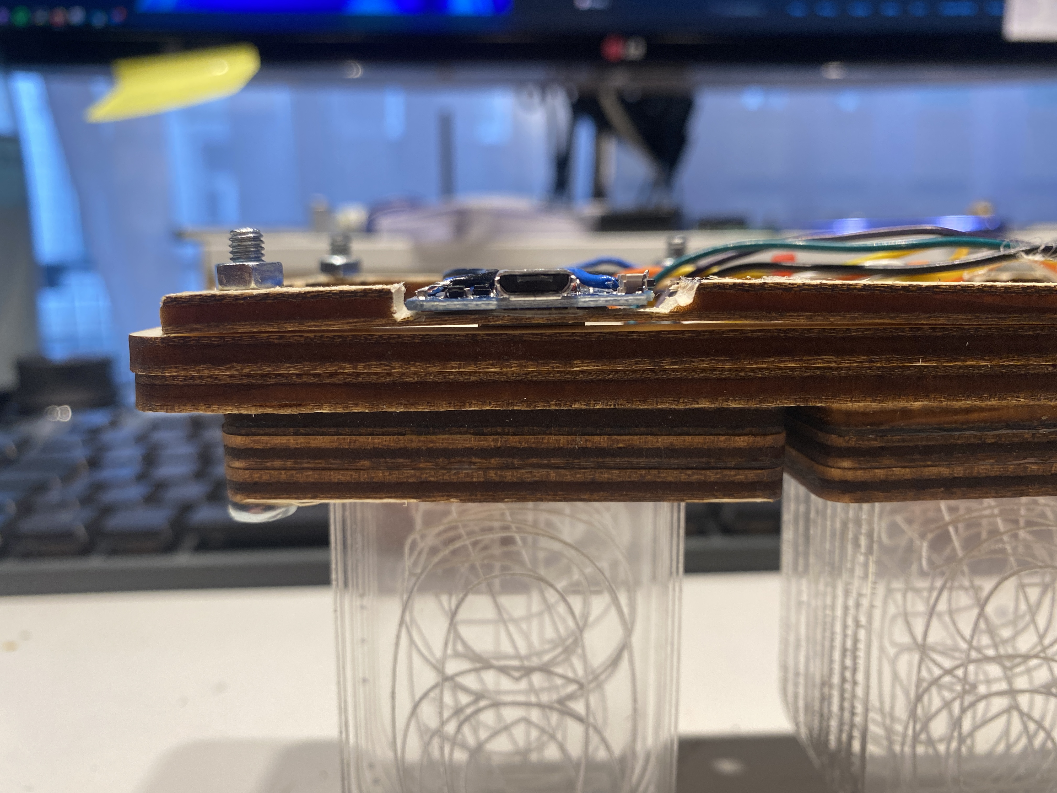
documentation/images/misc/IMG_3083.JPG
