LFB-MRI/MagneticReadoutProcessing/documentation/images/misc/IMG_3109.JPG

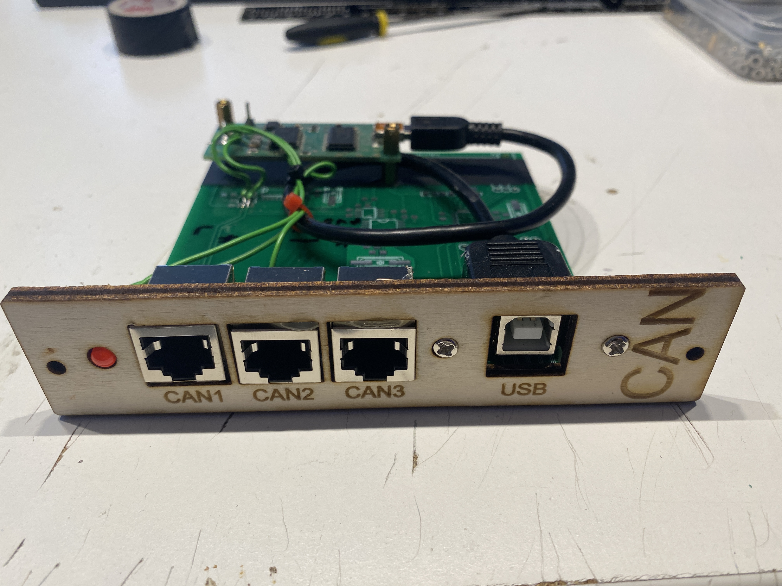
documentation/images/misc/IMG_3109.JPG
