LFB-MRI/MagneticReadoutProcessing/documentation/images/misc/IMG_3110.JPG

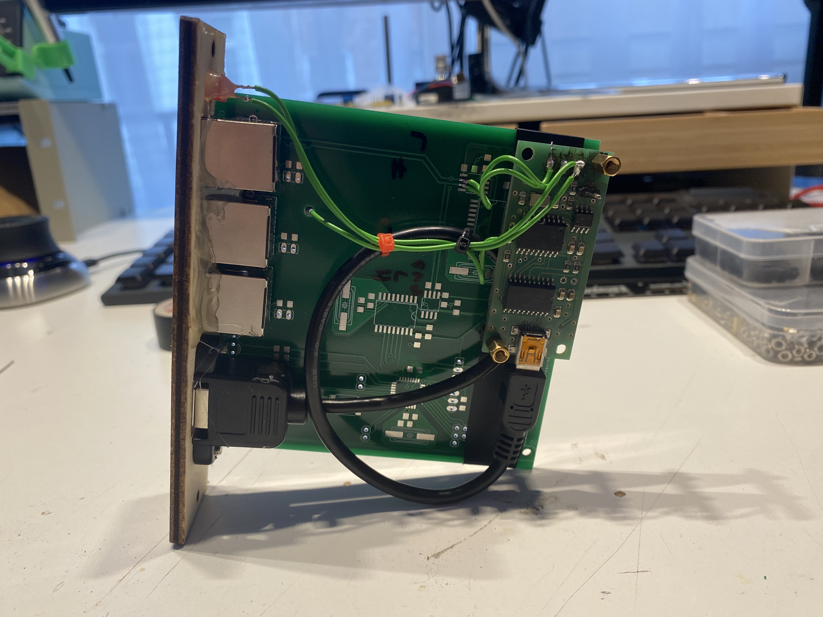
documentation/images/misc/IMG_3110.JPG
