LFB-MRI/MagneticReadoutProcessing/documentation/images/misc/IMG_3136.JPG

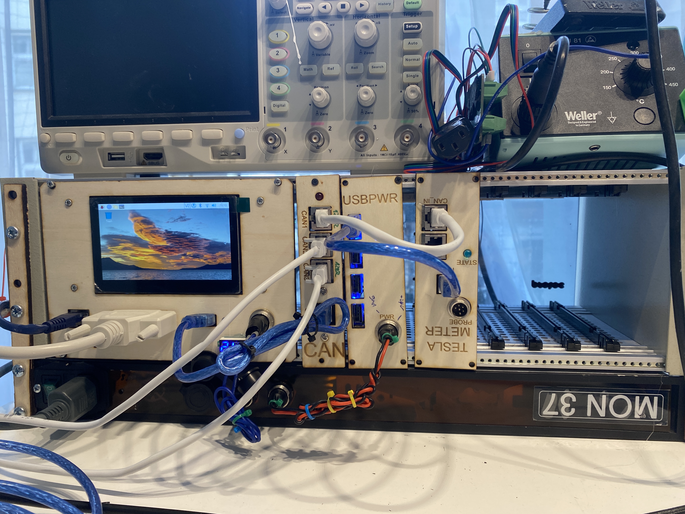
documentation/images/misc/IMG_3136.JPG
