LFB-MRI/MagneticReadoutProcessing/documentation/images/misc/IMG_3137.JPG

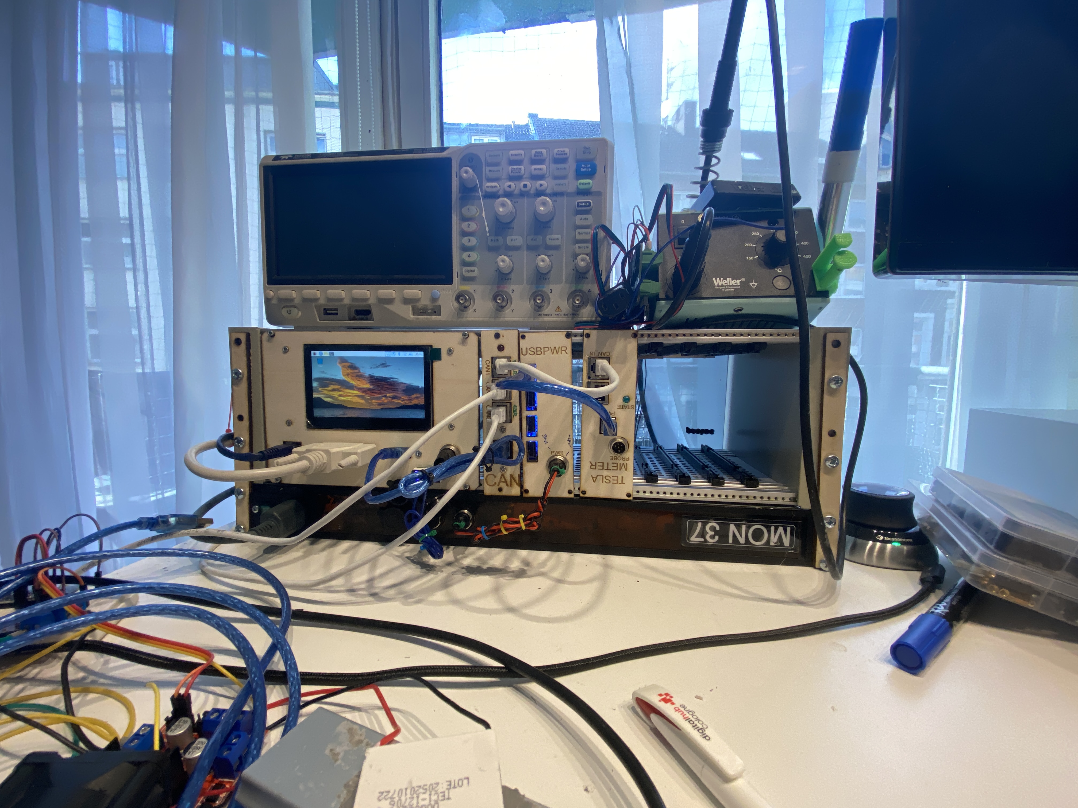
documentation/images/misc/IMG_3137.JPG
