LFB-MRI/MagneticReadoutProcessing/documentation/images/misc/IMG_3138.JPG

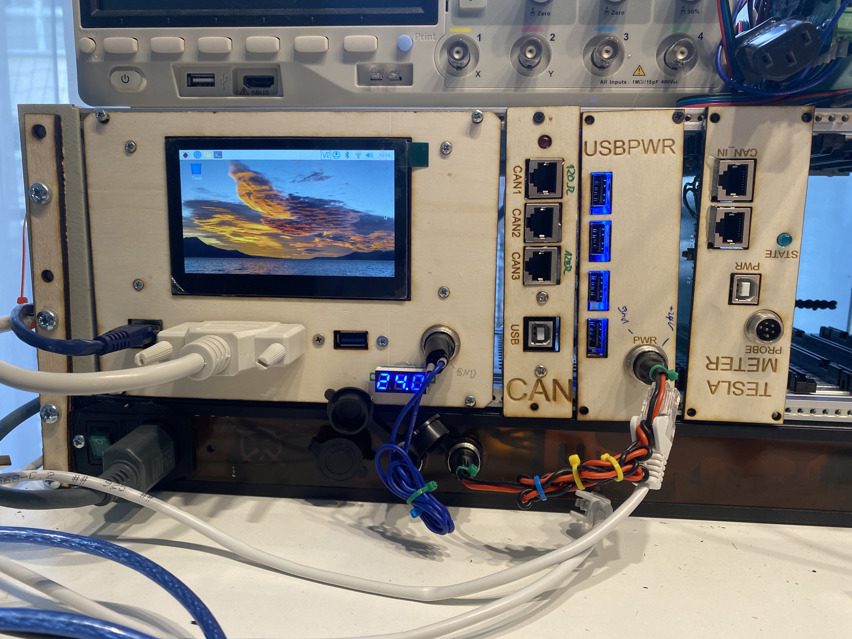
documentation/images/misc/IMG_3138.JPG
