LFB-MRI/MagneticReadoutProcessing/documentation/images/misc/IMG_3139.JPG

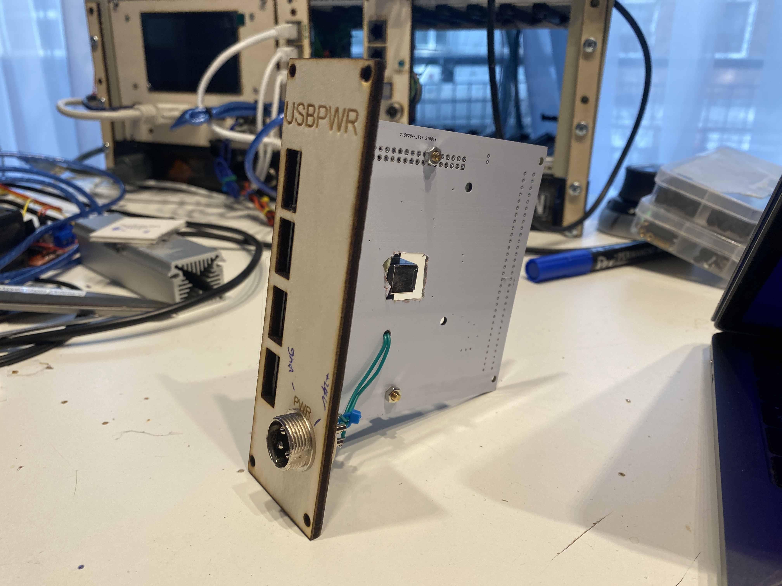
documentation/images/misc/IMG_3139.JPG
