LFB-MRI/MagneticReadoutProcessing/documentation/images/misc/IMG_3140.JPG

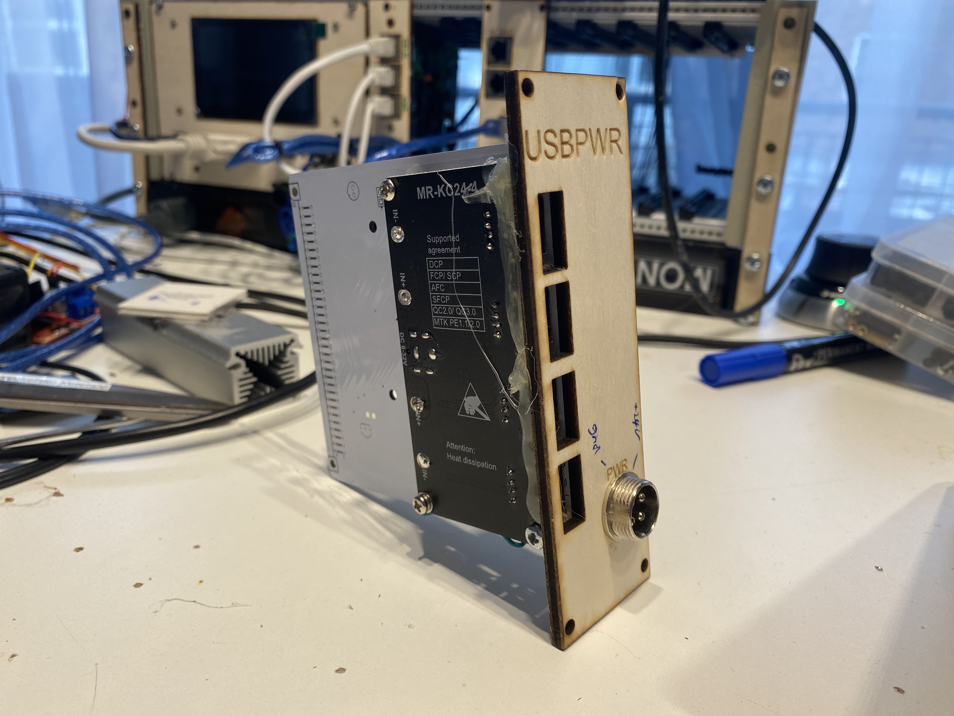
documentation/images/misc/IMG_3140.JPG
