LFB-MRI/MagneticReadoutProcessing/documentation/images/misc/IMG_3141.JPG

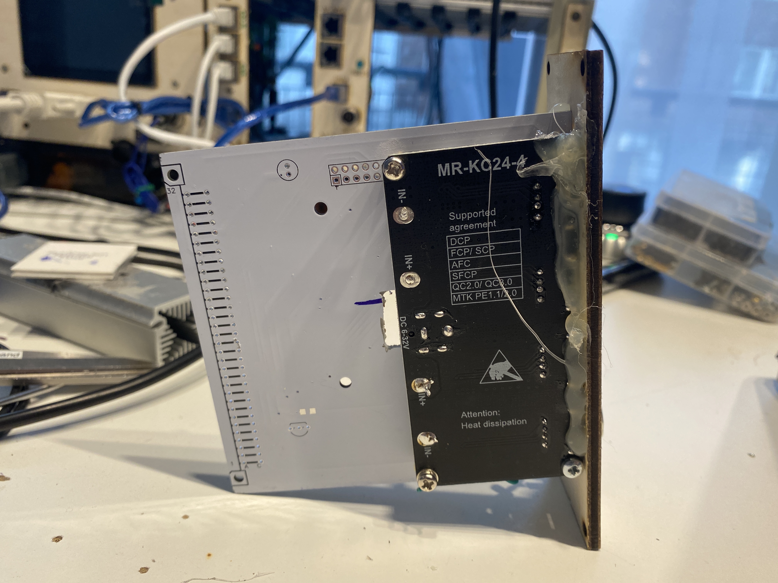
documentation/images/misc/IMG_3141.JPG
