LFB-MRI/MagneticReadoutProcessing/documentation/images/misc/IMG_3188.JPG

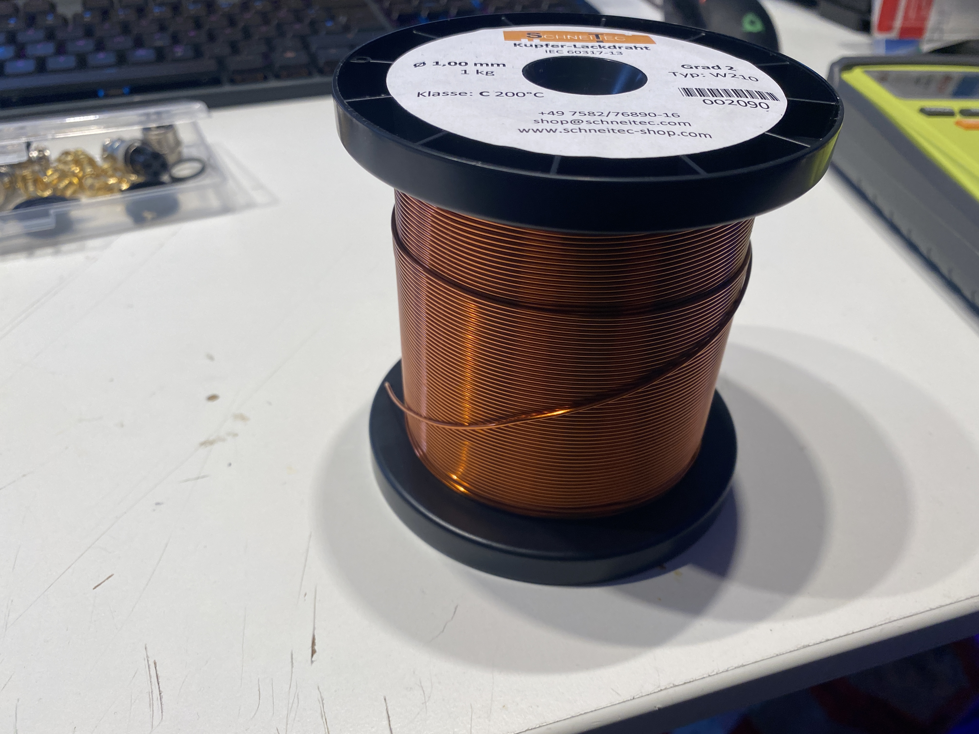
documentation/images/misc/IMG_3188.JPG
