LFB-MRI/MagneticReadoutProcessing/documentation/images/misc/IMG_3189.JPG

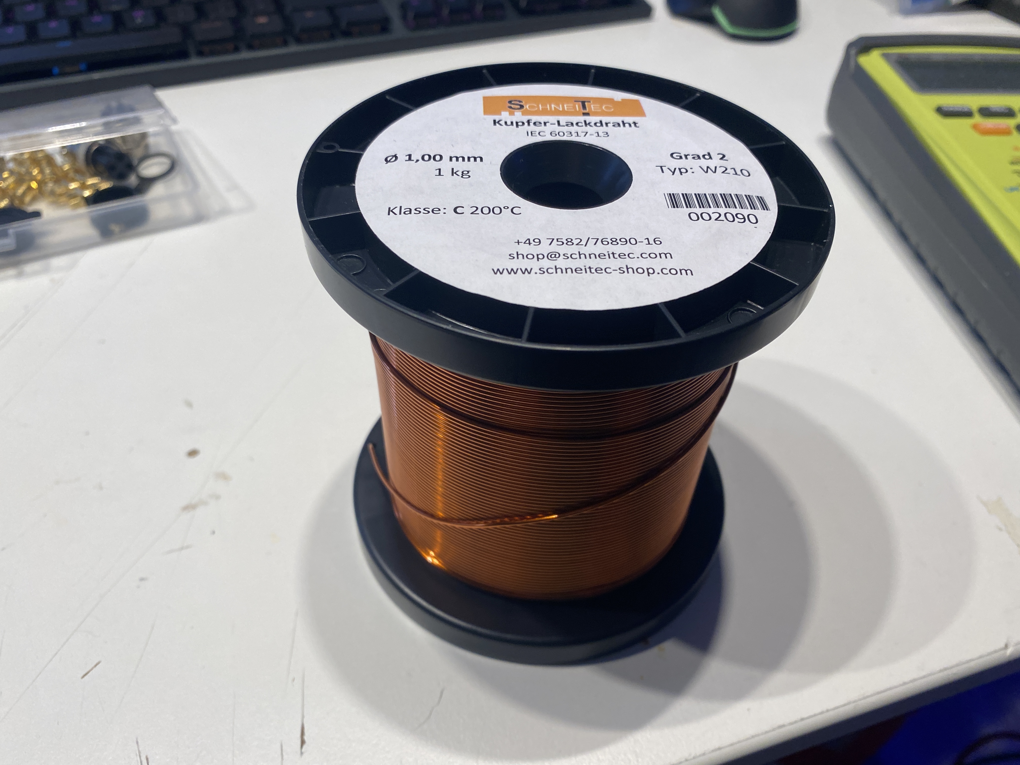
documentation/images/misc/IMG_3189.JPG
