LFB-MRI/MagneticReadoutProcessing/documentation/images/misc/IMG_3190.JPG

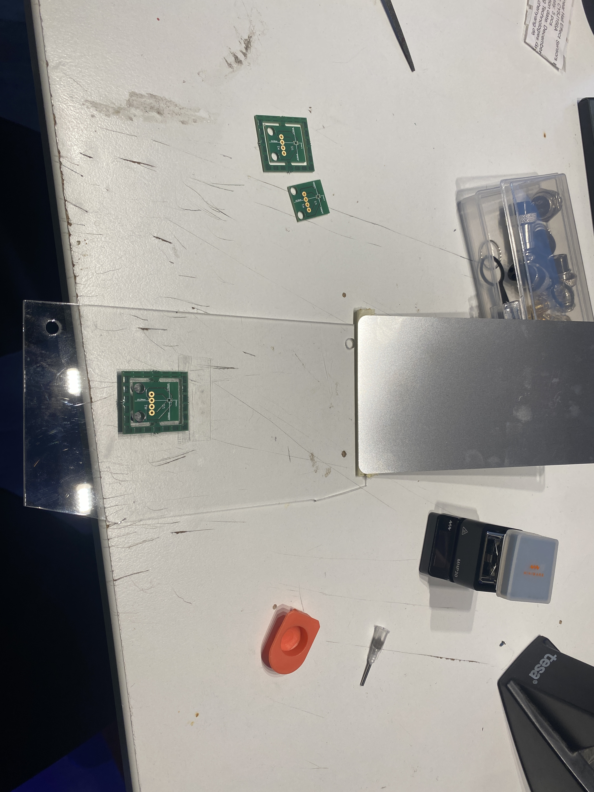
documentation/images/misc/IMG_3190.JPG
