LFB-MRI/MagneticReadoutProcessing/documentation/images/misc/IMG_3191.JPG

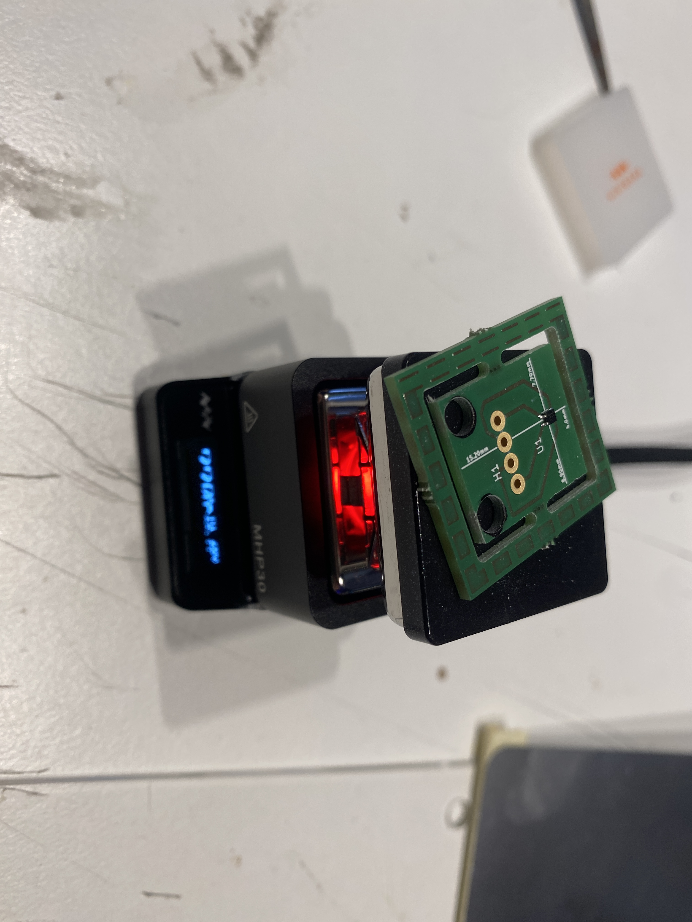
documentation/images/misc/IMG_3191.JPG
