LFB-MRI/MagneticReadoutProcessing/documentation/images/misc/IMG_3193.JPG

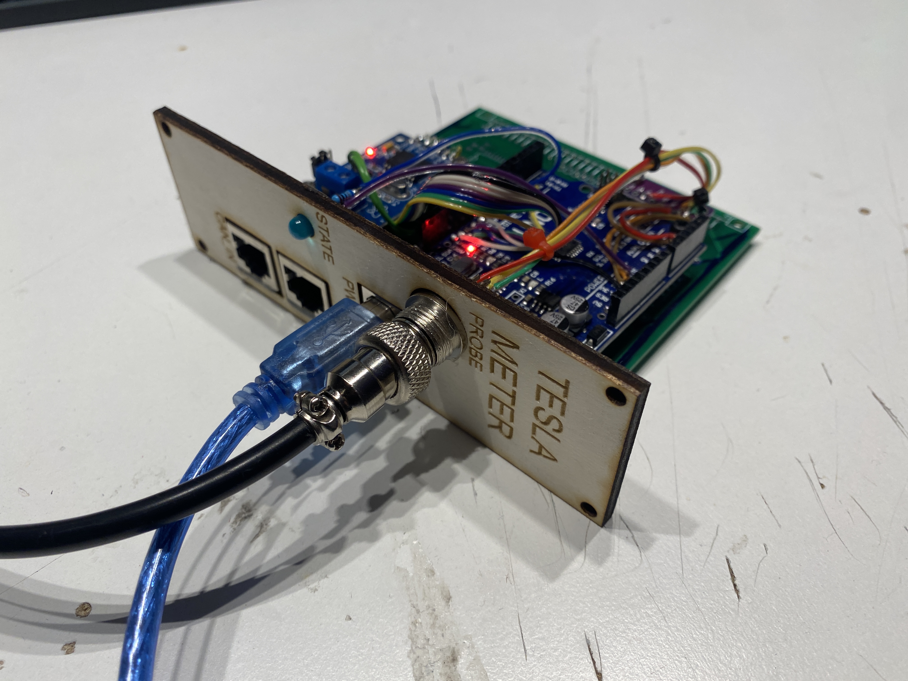
documentation/images/misc/IMG_3193.JPG
