LFB-MRI/MagneticReadoutProcessing/documentation/images/misc/IMG_3199.JPG

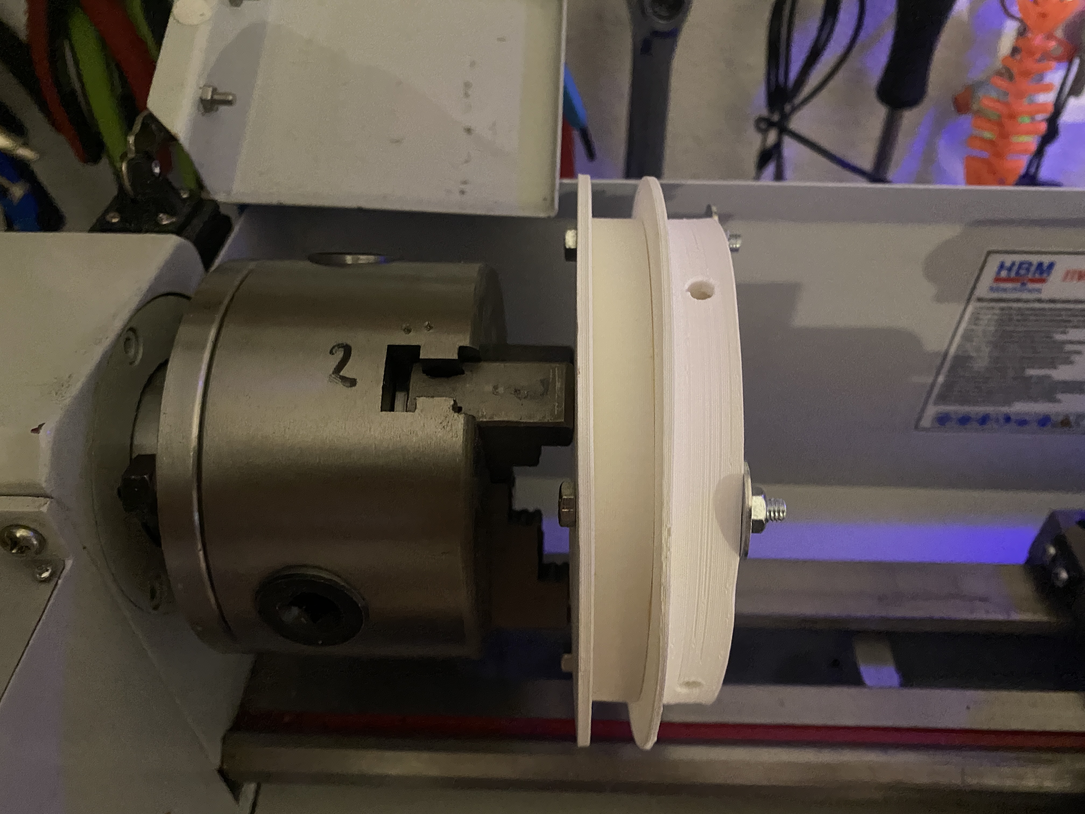
documentation/images/misc/IMG_3199.JPG
