LFB-MRI/MagneticReadoutProcessing/documentation/images/misc/IMG_3203.JPG

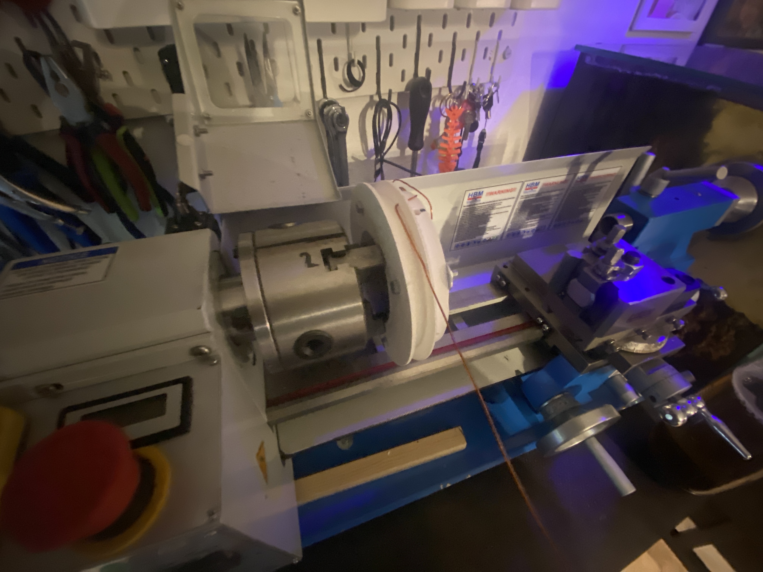
documentation/images/misc/IMG_3203.JPG
