LFB-MRI/MagneticReadoutProcessing/documentation/images/misc/IMG_3204.JPG

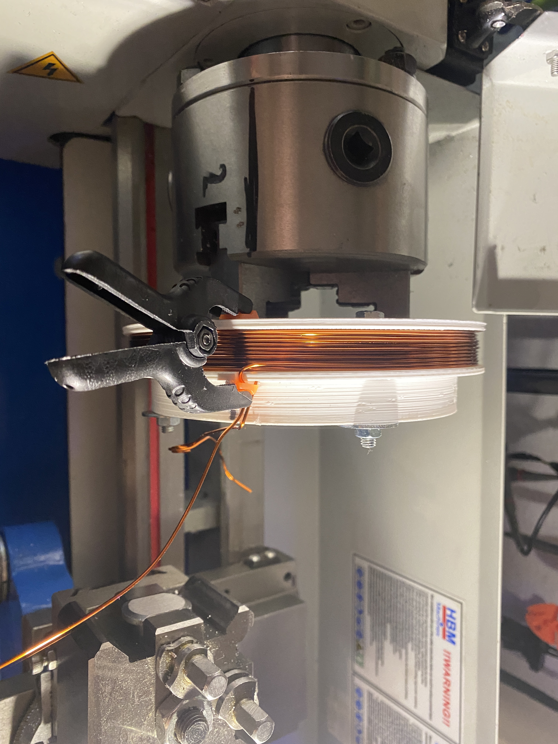
documentation/images/misc/IMG_3204.JPG
