LFB-MRI/MagneticReadoutProcessing/documentation/images/misc/IMG_3205.JPG

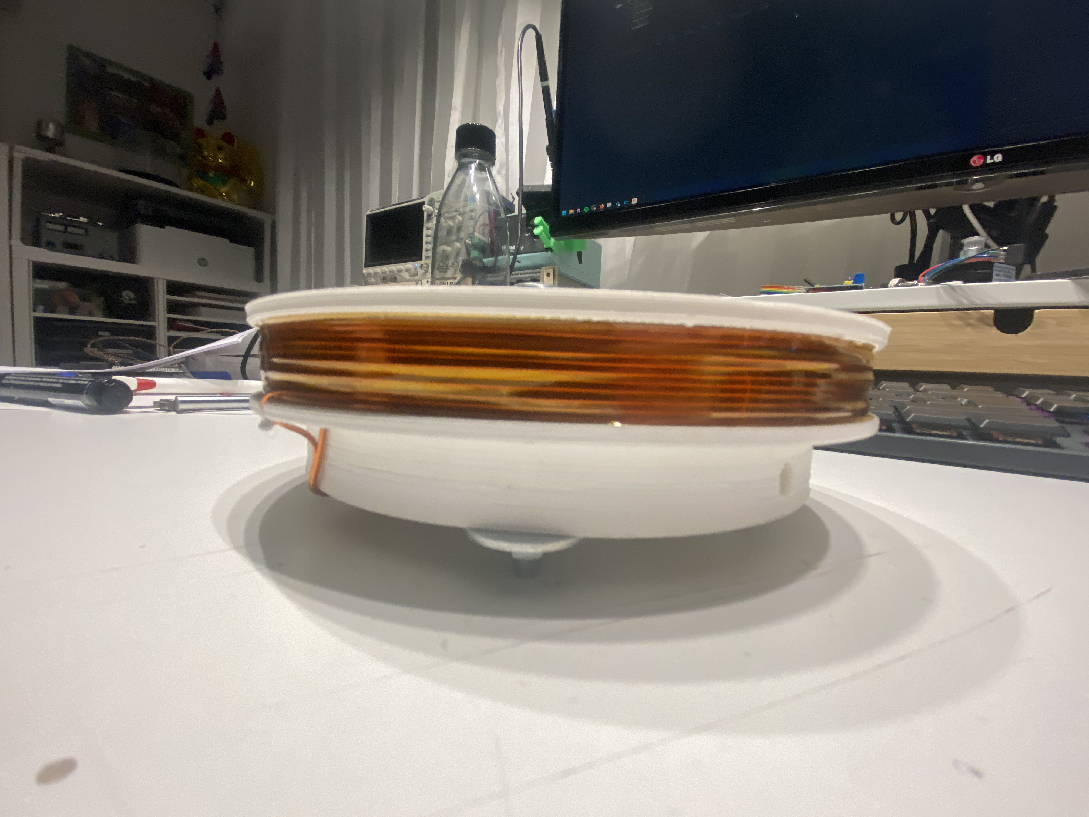
documentation/images/misc/IMG_3205.JPG
