LFB-MRI/MagneticReadoutProcessing/documentation/images/misc/IMG_3206.JPG

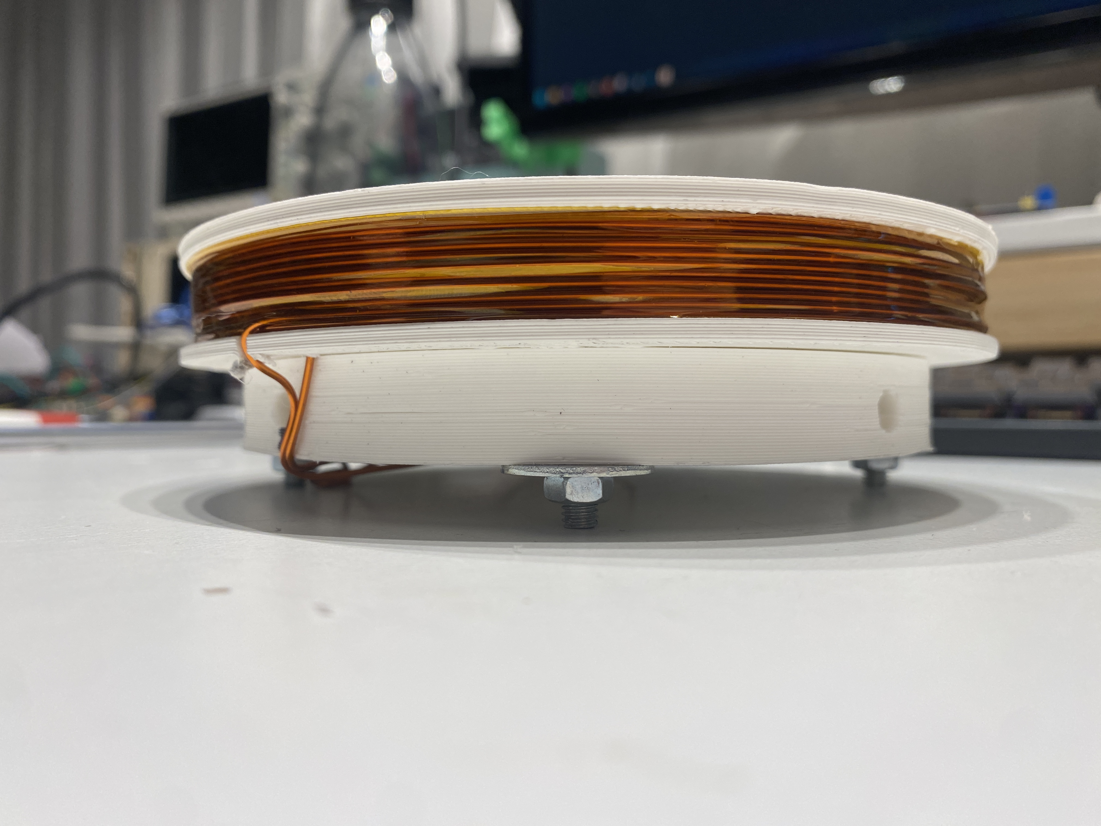
documentation/images/misc/IMG_3206.JPG
