LFB-MRI/MagneticReadoutProcessing/documentation/images/misc/IMG_3216.JPG

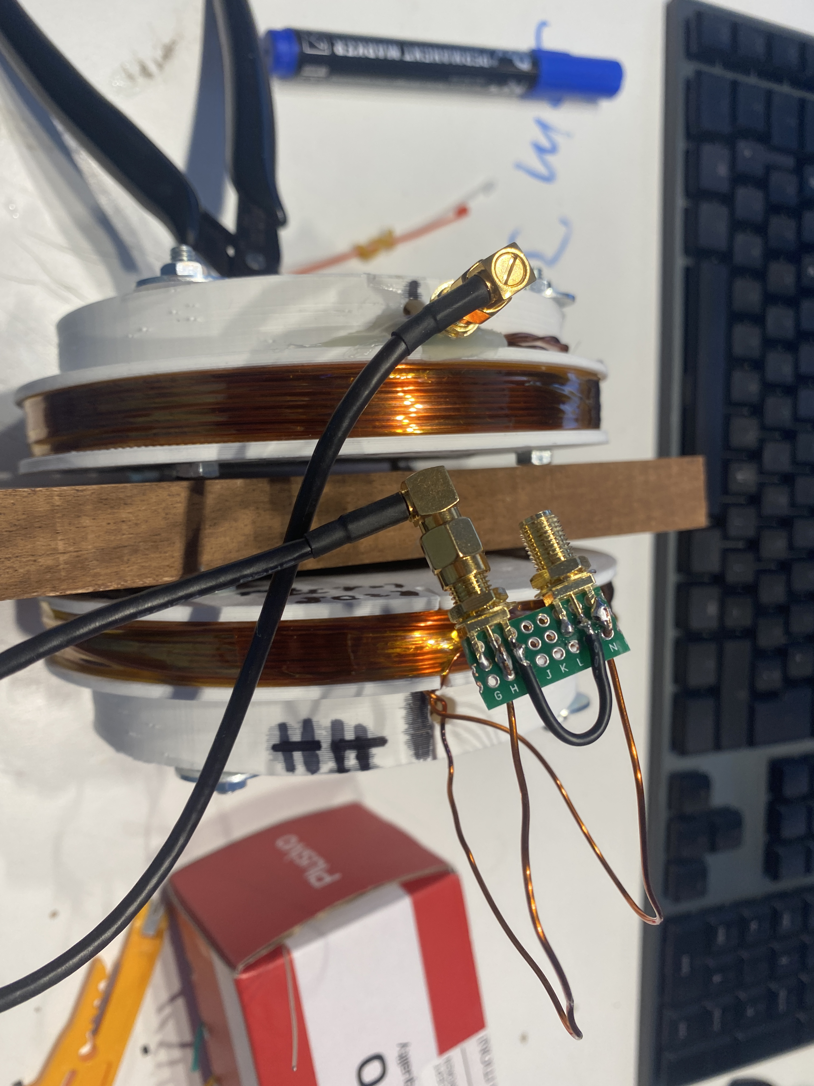
documentation/images/misc/IMG_3216.JPG
