LFB-MRI/MagneticReadoutProcessing/documentation/images/misc/IMG_3217.JPG

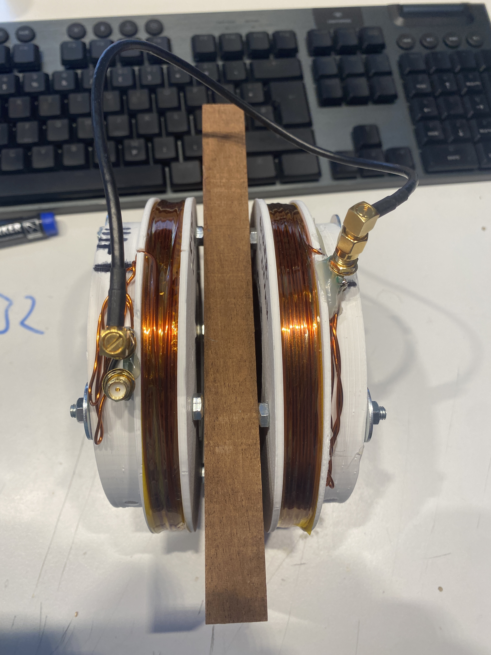
documentation/images/misc/IMG_3217.JPG
