LFB-MRI/MagneticReadoutProcessing/documentation/images/misc/IMG_3218.JPG

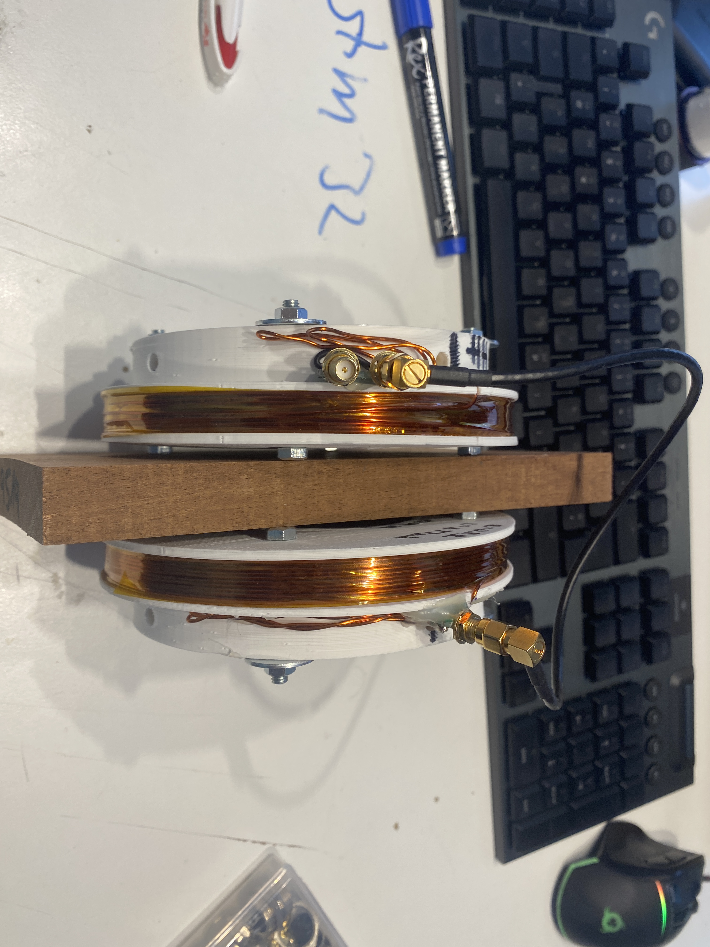
documentation/images/misc/IMG_3218.JPG
