LFB-MRI/MagneticReadoutProcessing/documentation/images/misc/IMG_3222.JPG

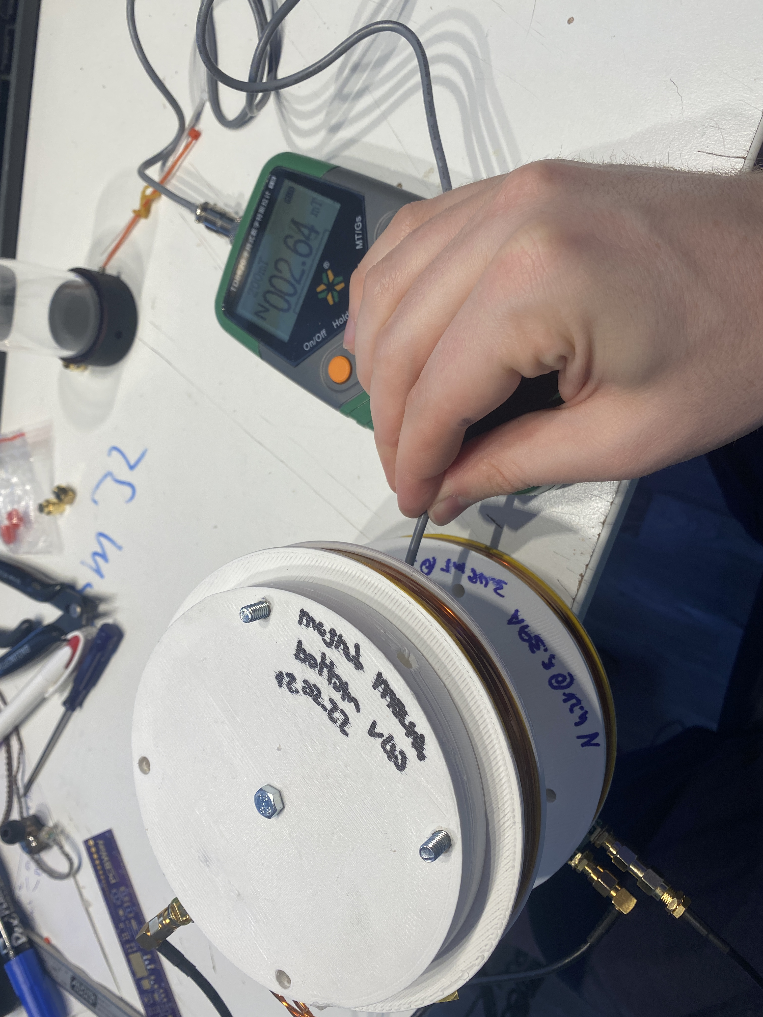
documentation/images/misc/IMG_3222.JPG
