LFB-MRI/MagneticReadoutProcessing/documentation/images/misc/IMG_3224.JPG

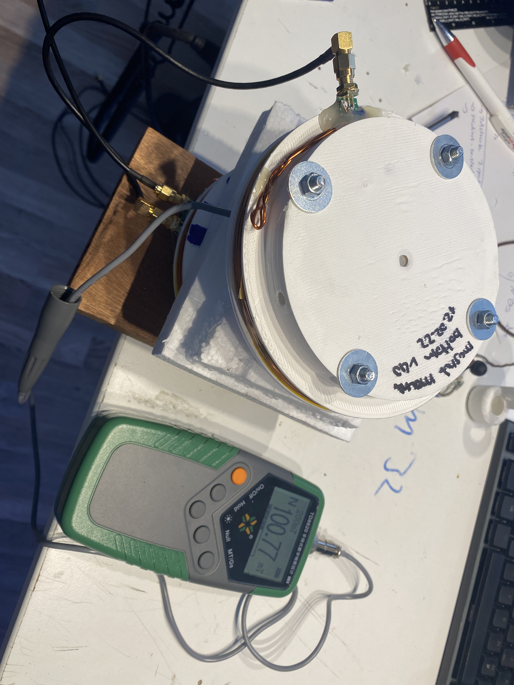
documentation/images/misc/IMG_3224.JPG
