LFB-MRI/MagneticReadoutProcessing/documentation/images/misc/IMG_3225.JPG

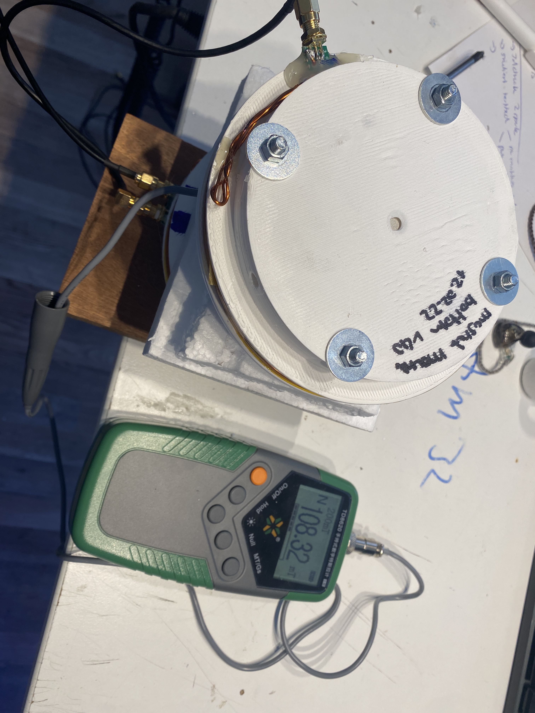
documentation/images/misc/IMG_3225.JPG
