LFB-MRI/MagneticReadoutProcessing/documentation/images/misc/IMG_3226.JPG

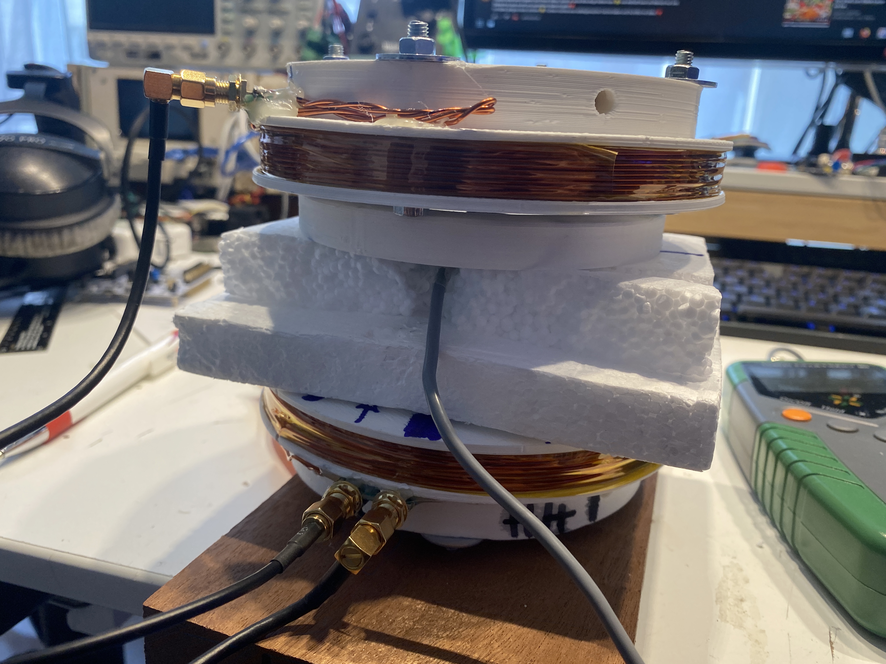
documentation/images/misc/IMG_3226.JPG
