LFB-MRI/MagneticReadoutProcessing/documentation/images/misc/IMG_3227.JPG

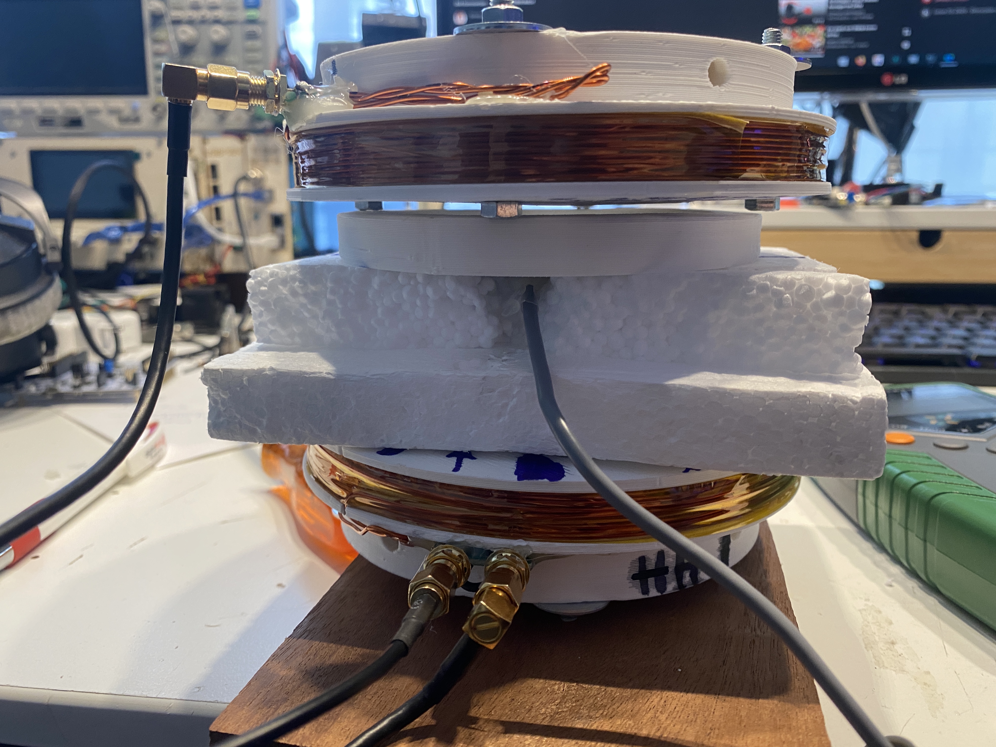
documentation/images/misc/IMG_3227.JPG
