LFB-MRI/MagneticReadoutProcessing/documentation/images/misc/IMG_3228.JPG

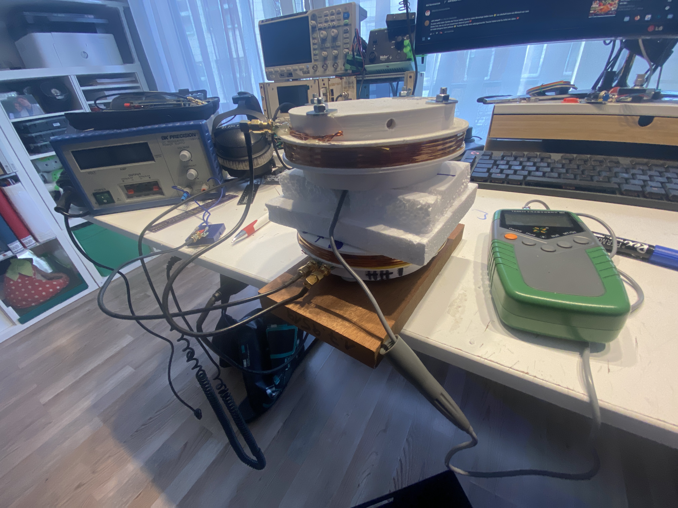
documentation/images/misc/IMG_3228.JPG
