LFB-MRI/MagneticReadoutProcessing/documentation/images/misc/IMG_3230.JPG

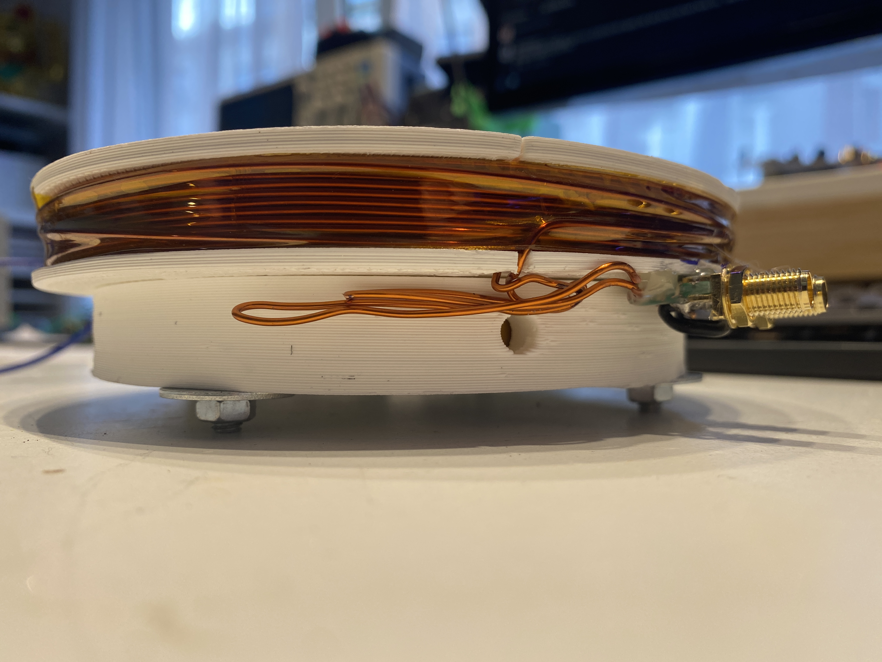
documentation/images/misc/IMG_3230.JPG
