LFB-MRI/MagneticReadoutProcessing/documentation/images/misc/IMG_3231.JPG

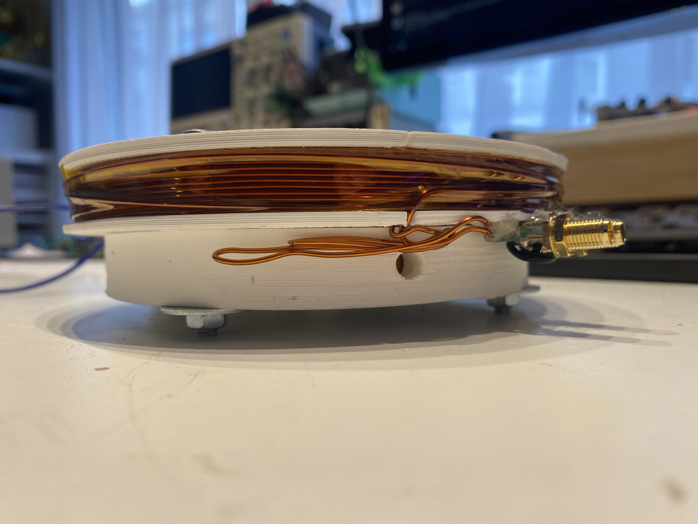
documentation/images/misc/IMG_3231.JPG
