LFB-MRI/MagneticReadoutProcessing/documentation/images/misc/IMG_3237.JPG

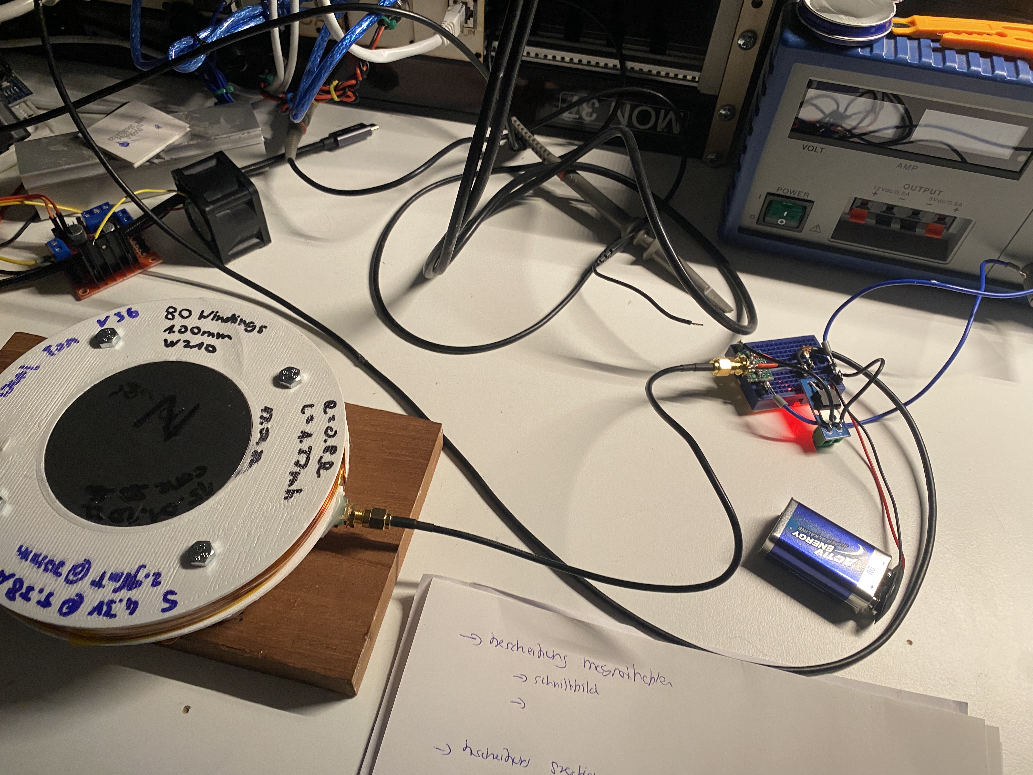
documentation/images/misc/IMG_3237.JPG
