LFB-MRI/MagneticReadoutProcessing/documentation/images/misc/IMG_3238.JPG

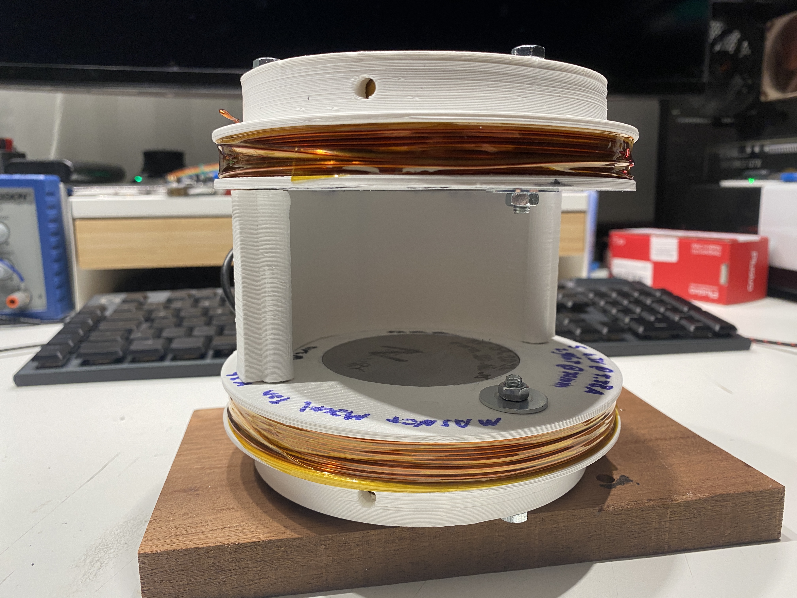
documentation/images/misc/IMG_3238.JPG
