LFB-MRI/MagneticReadoutProcessing/documentation/images/misc/IMG_3239.JPG

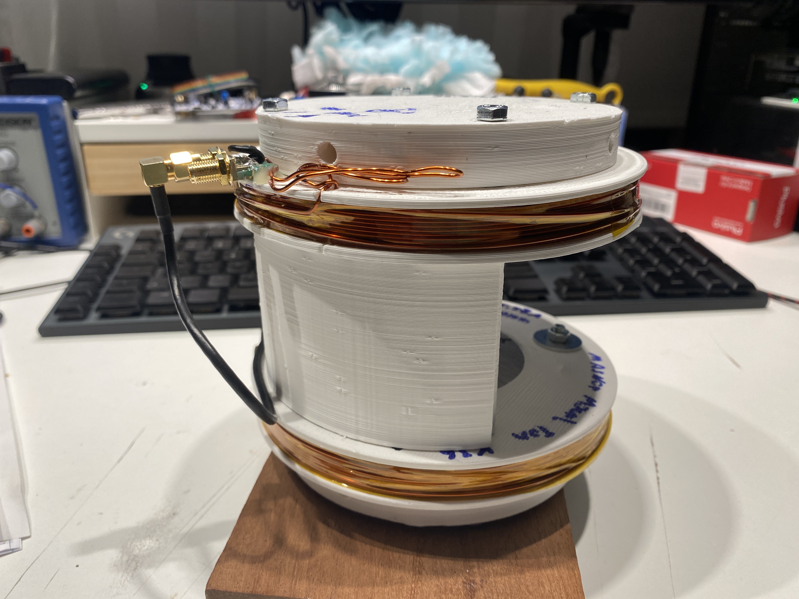
documentation/images/misc/IMG_3239.JPG
