LFB-MRI/MagneticReadoutProcessing/documentation/images/misc/IMG_3246.JPG

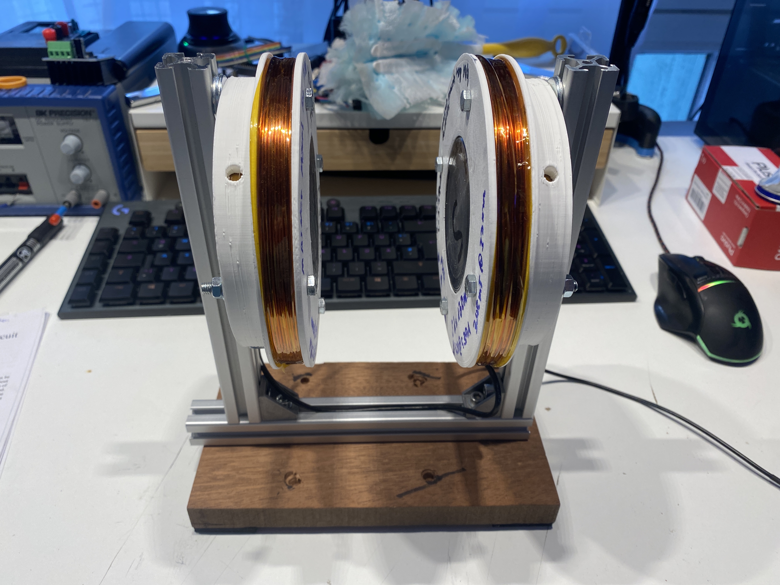
documentation/images/misc/IMG_3246.JPG
