LFB-MRI/MagneticReadoutProcessing/documentation/images/misc/IMG_3247.JPG

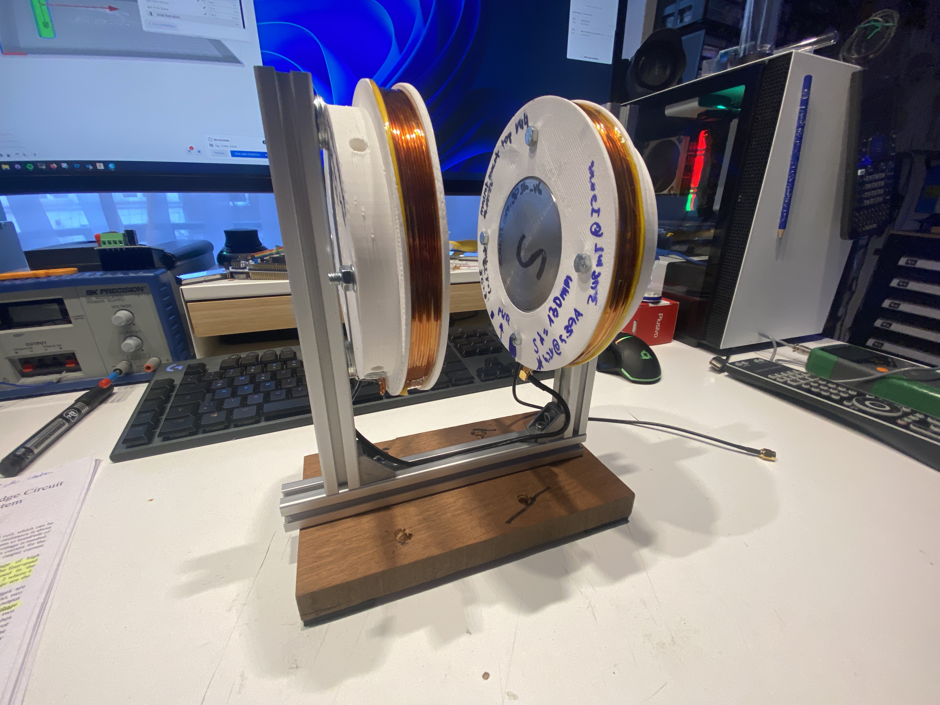
documentation/images/misc/IMG_3247.JPG
