LFB-MRI/MagneticReadoutProcessing/documentation/images/misc/IMG_3248.JPG

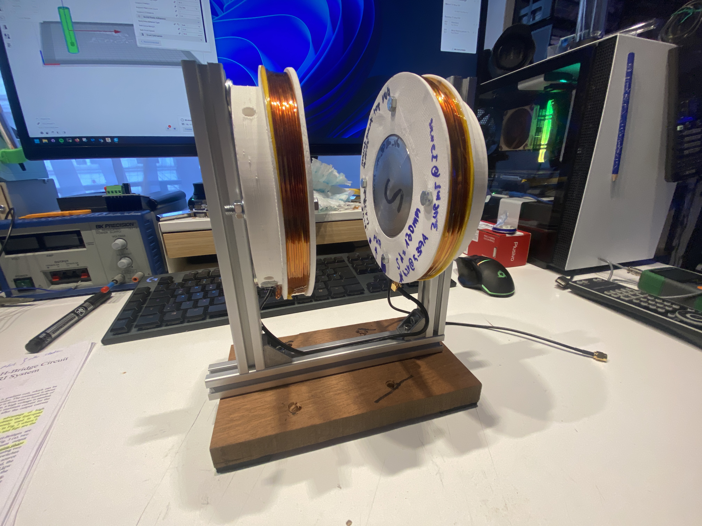
documentation/images/misc/IMG_3248.JPG
