LFB-MRI/MagneticReadoutProcessing/documentation/images/misc/IMG_3256.JPG

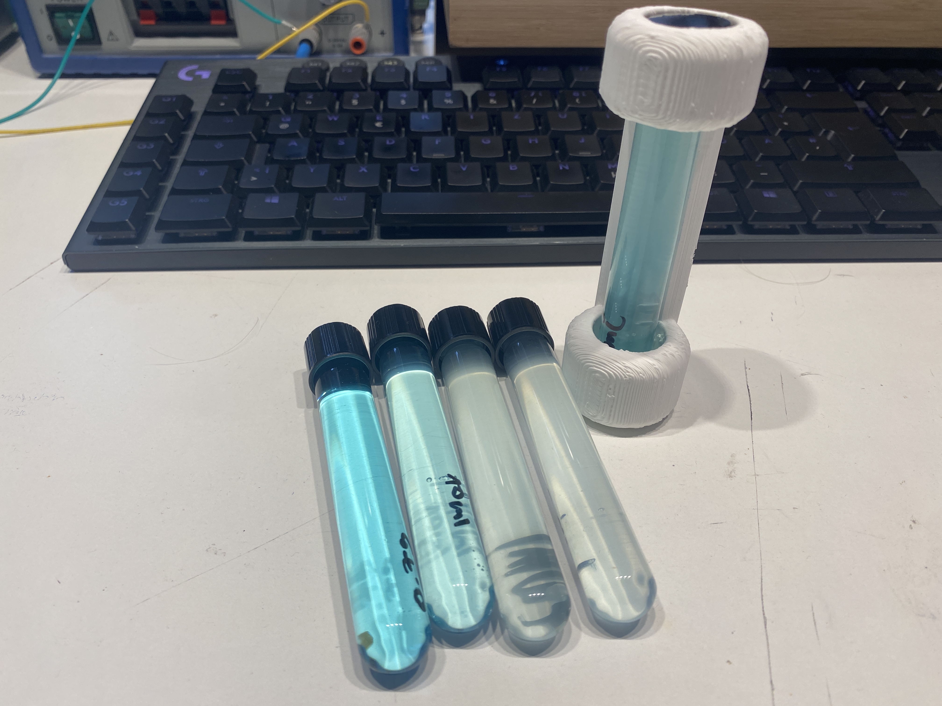
documentation/images/misc/IMG_3256.JPG
