LFB-MRI/MagneticReadoutProcessing/documentation/images/misc/IMG_3377.JPG

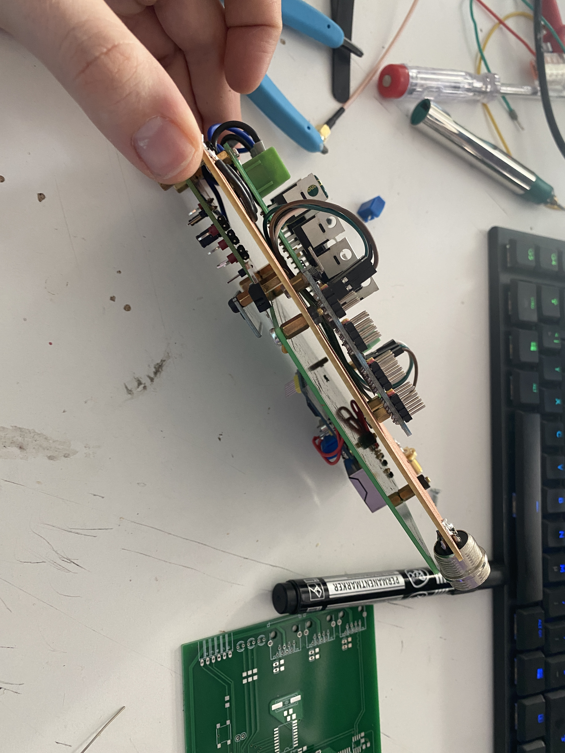
documentation/images/misc/IMG_3377.JPG
