LFB-MRI/MagneticReadoutProcessing/documentation/images/misc/IMG_3379.JPG

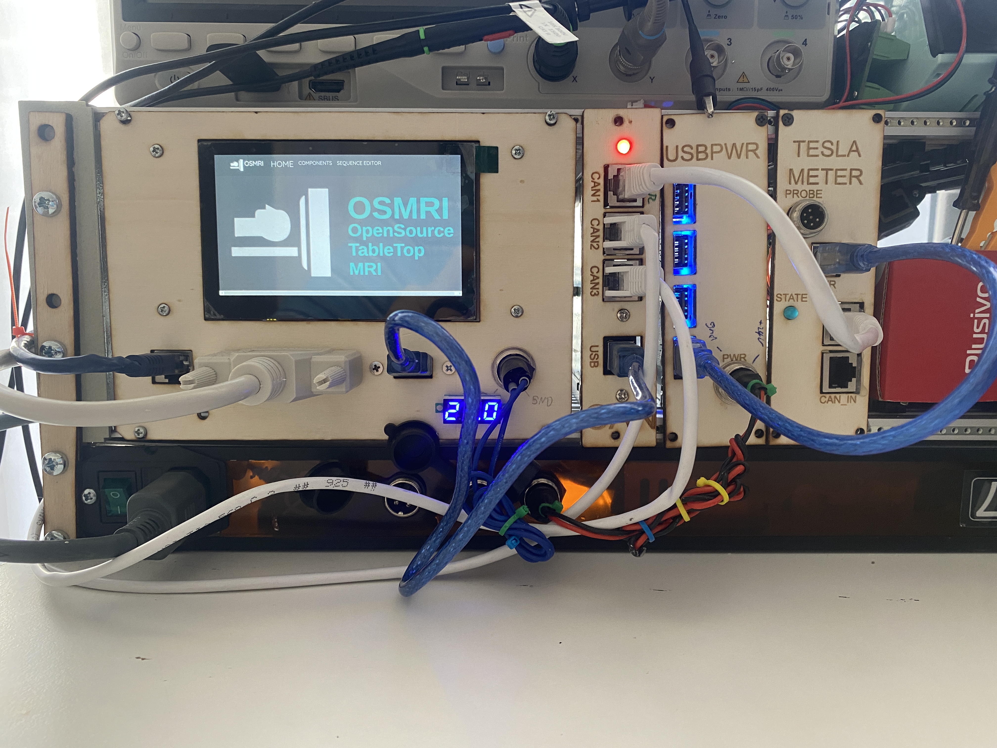
documentation/images/misc/IMG_3379.JPG
