LFB-MRI/MagneticReadoutProcessing/documentation/images/misc/IMG_3380.JPG

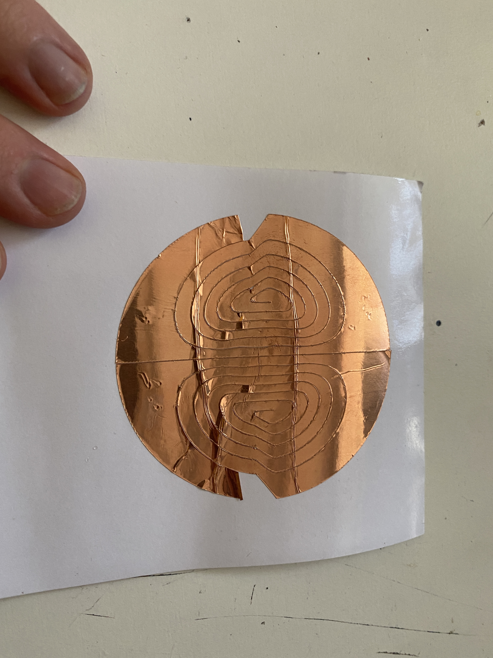
documentation/images/misc/IMG_3380.JPG
