LFB-MRI/MagneticReadoutProcessing/documentation/images/misc/IMG_3382.JPG

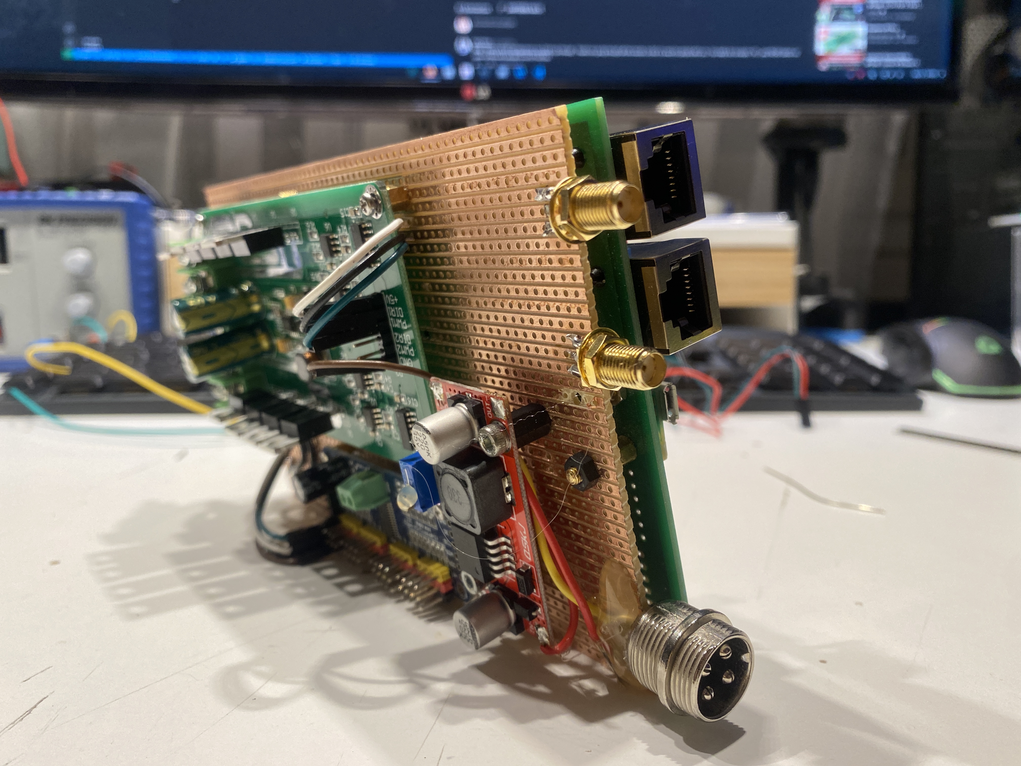
documentation/images/misc/IMG_3382.JPG
