LFB-MRI/MagneticReadoutProcessing/documentation/images/misc/IMG_3561.JPG

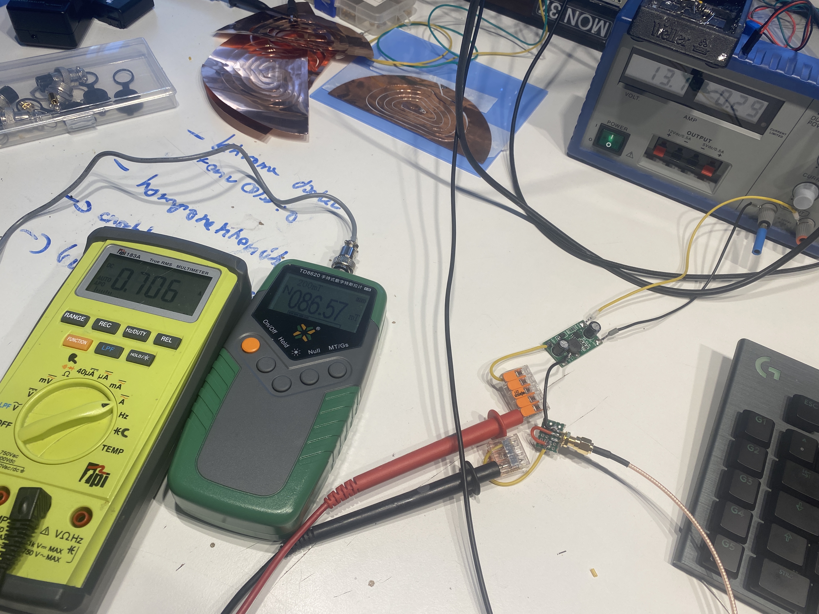
documentation/images/misc/IMG_3561.JPG
