LFB-MRI/MagneticReadoutProcessing/documentation/images/misc/IMG_3652.JPG

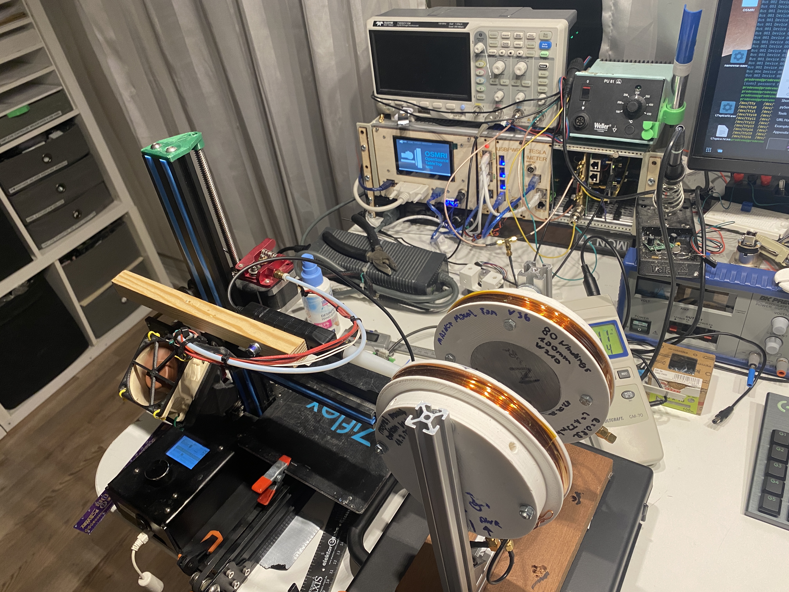
documentation/images/misc/IMG_3652.JPG
