LFB-MRI/MagneticReadoutProcessing/documentation/images/misc/IMG_3661.JPG

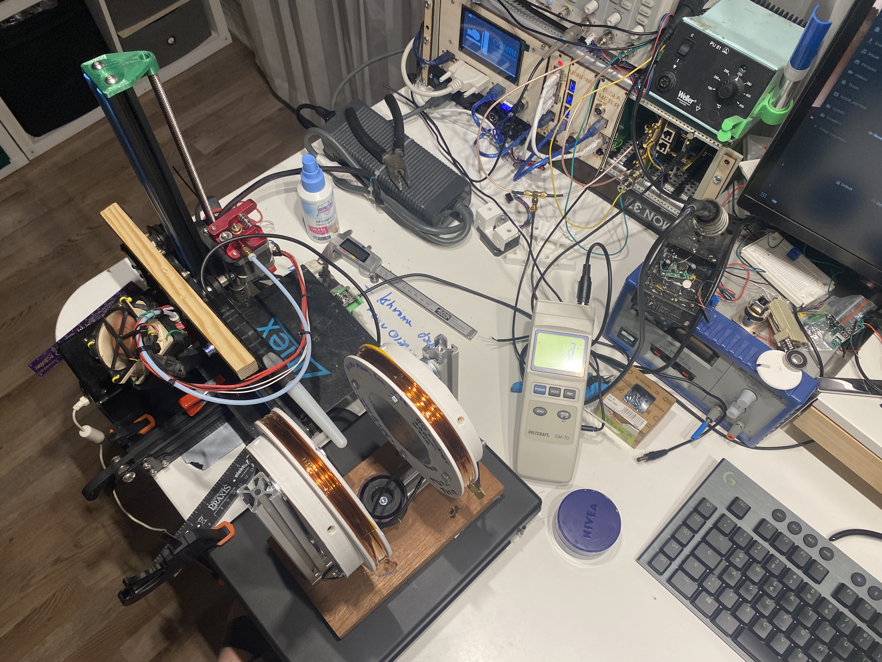
documentation/images/misc/IMG_3661.JPG
