LFB-MRI/MagneticReadoutProcessing/documentation/images/misc/IMG_3662.JPG

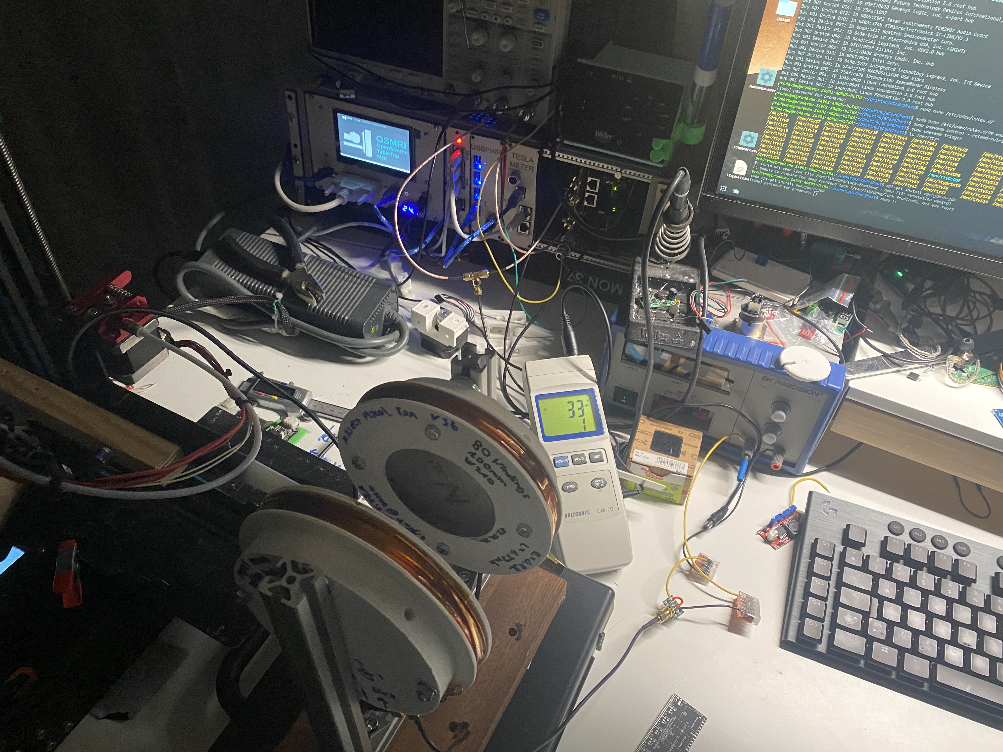
documentation/images/misc/IMG_3662.JPG
