LFB-MRI/MagneticReadoutProcessing/documentation/images/misc/IMG_3663.JPG

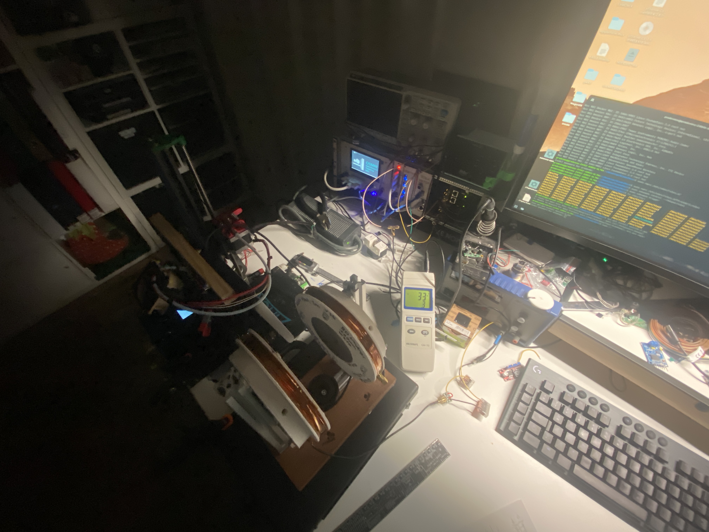
documentation/images/misc/IMG_3663.JPG
