LFB-MRI/MagneticReadoutProcessing/documentation/images/misc/IMG_3711.JPG

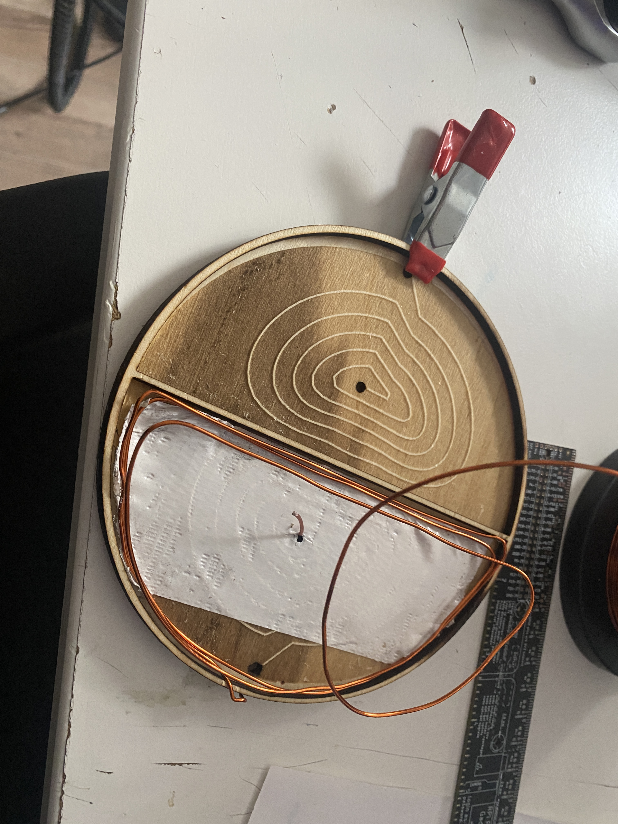
documentation/images/misc/IMG_3711.JPG
