LFB-MRI/MagneticReadoutProcessing/documentation/images/misc/IMG_3721.JPG

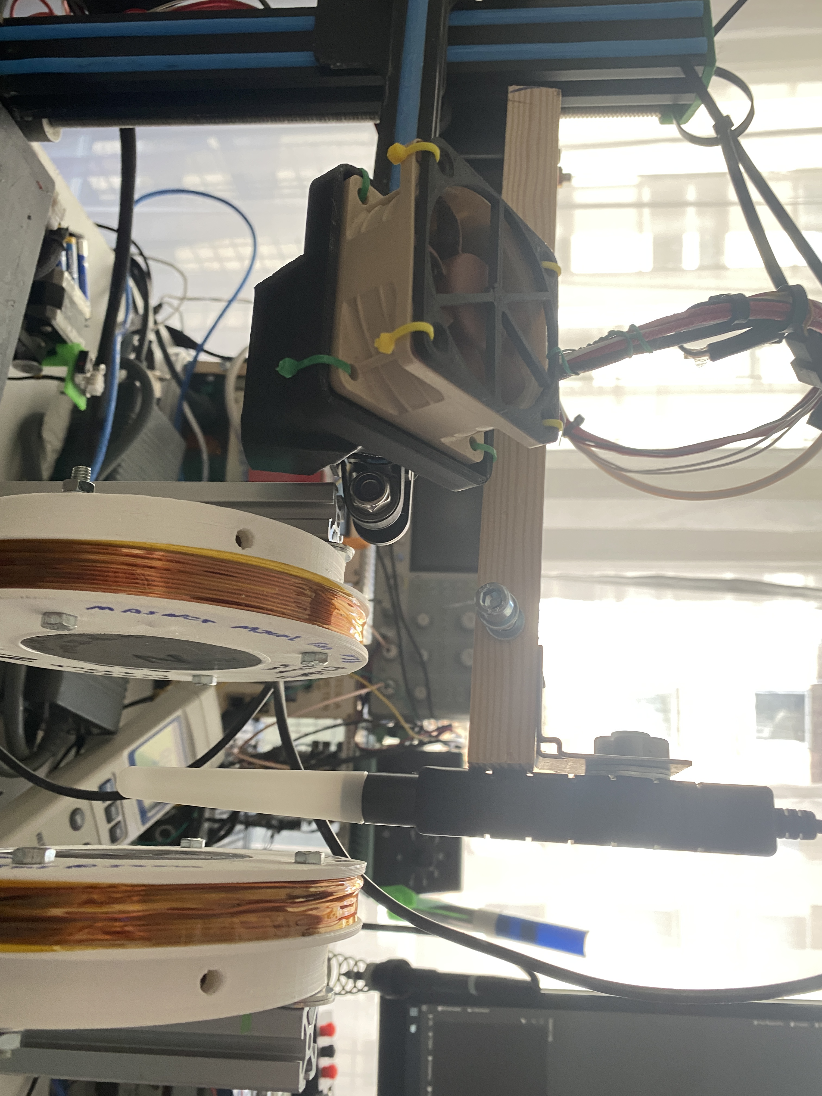
documentation/images/misc/IMG_3721.JPG
