LFB-MRI/MagneticReadoutProcessing/documentation/images/misc/IMG_3722.JPG

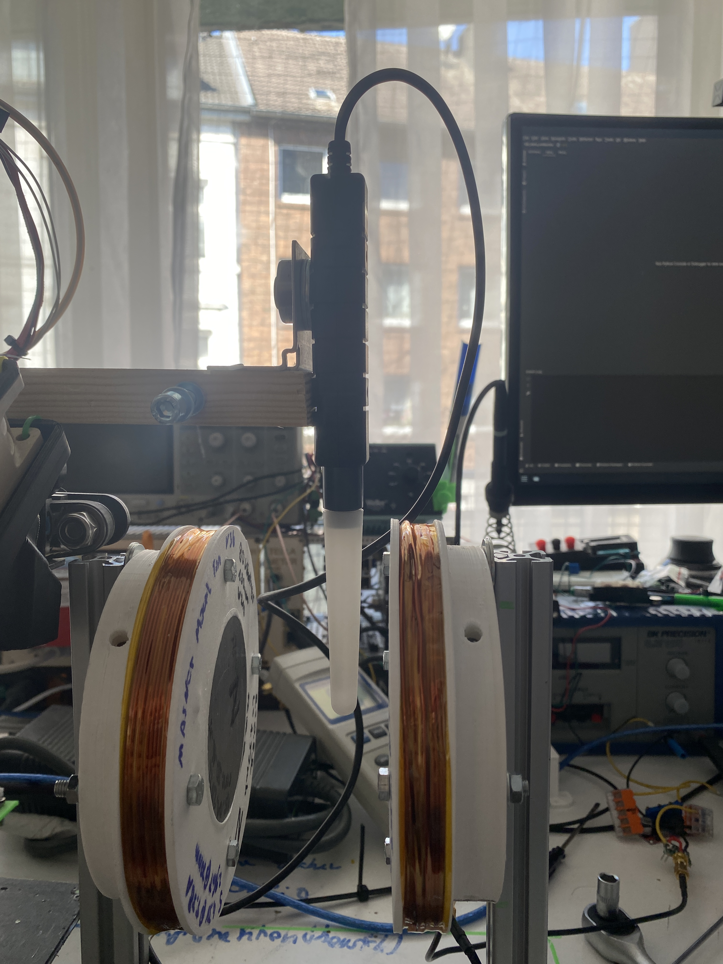
documentation/images/misc/IMG_3722.JPG
