LFB-MRI/MagneticReadoutProcessing/documentation/images/misc/IMG_3723.JPG

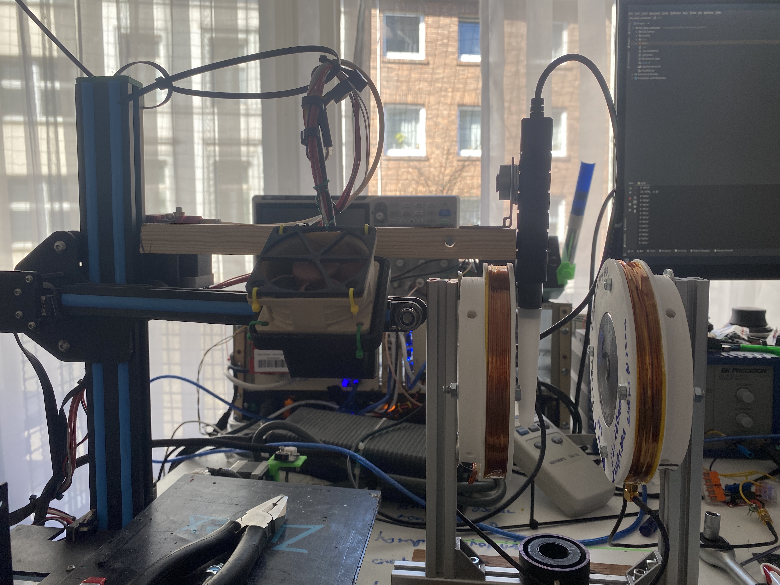
documentation/images/misc/IMG_3723.JPG
