LFB-MRI/MagneticReadoutProcessing/documentation/images/misc/IMG_4431.JPG

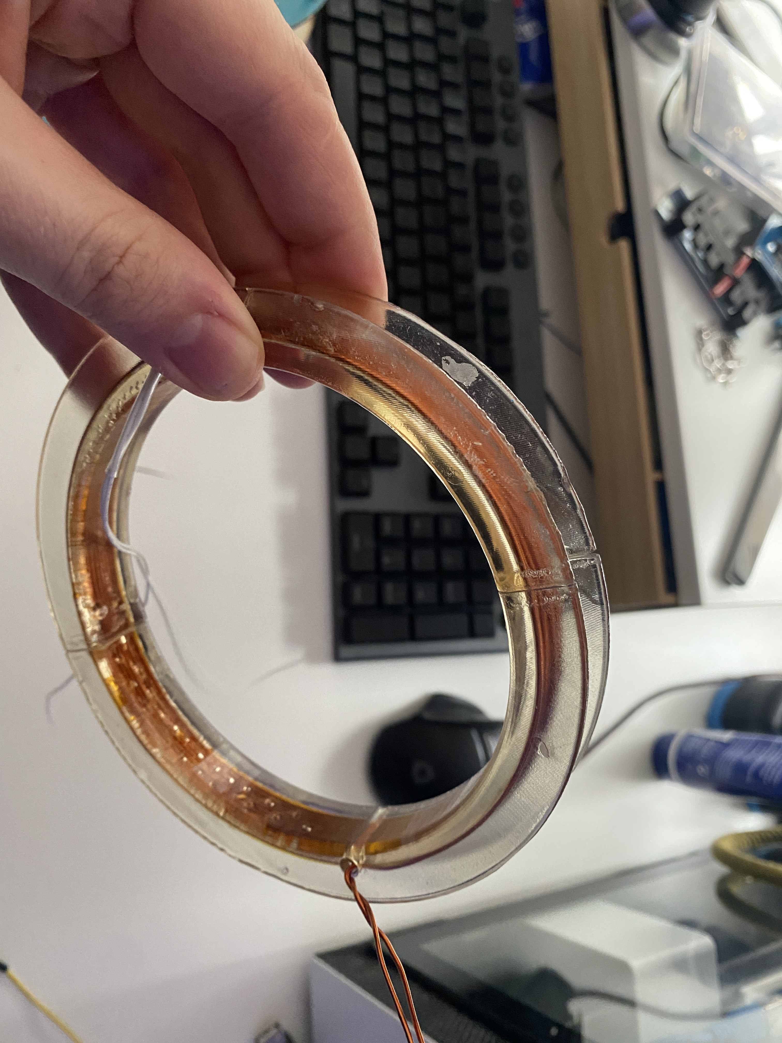
documentation/images/misc/IMG_4431.JPG
