LFB-MRI/MagneticReadoutProcessing/documentation/images/misc/IMG_4432.JPG

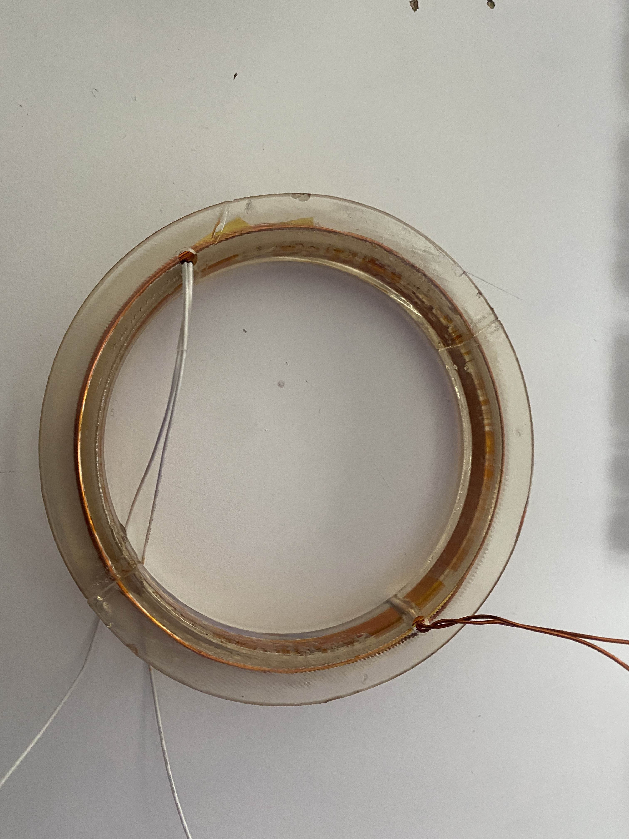
documentation/images/misc/IMG_4432.JPG
