LFB-MRI/MagneticReadoutProcessing/documentation/images/misc/IMG_4433.JPG

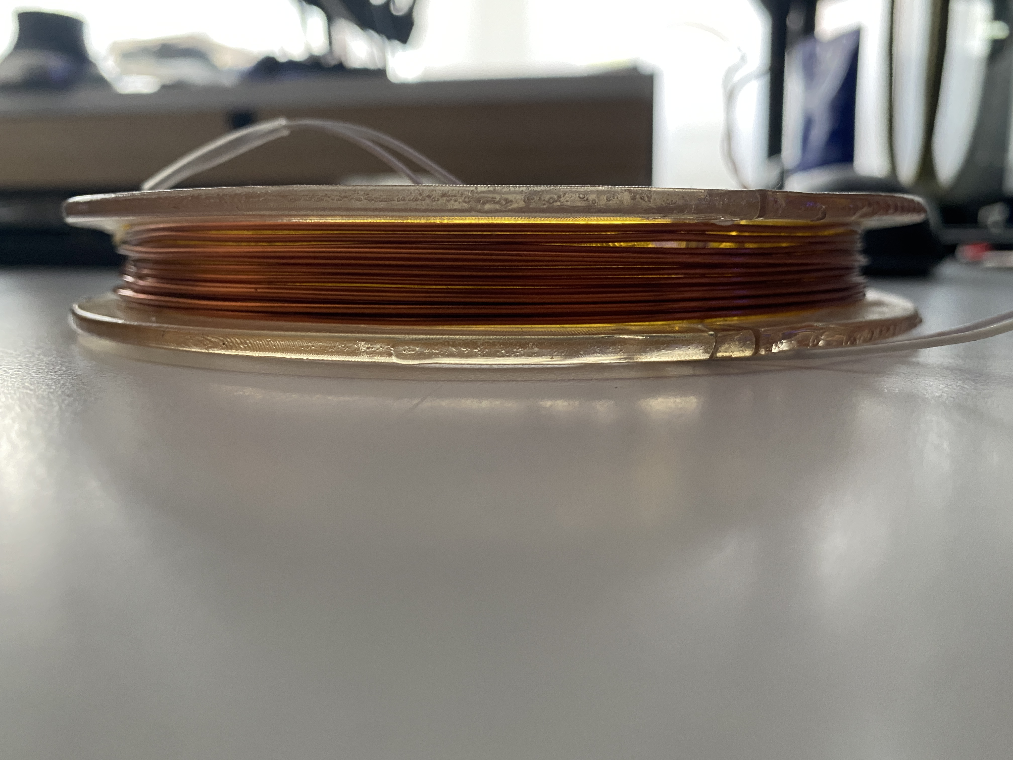
documentation/images/misc/IMG_4433.JPG
