LFB-MRI/MagneticReadoutProcessing/documentation/images/misc/IMG_4435.JPG

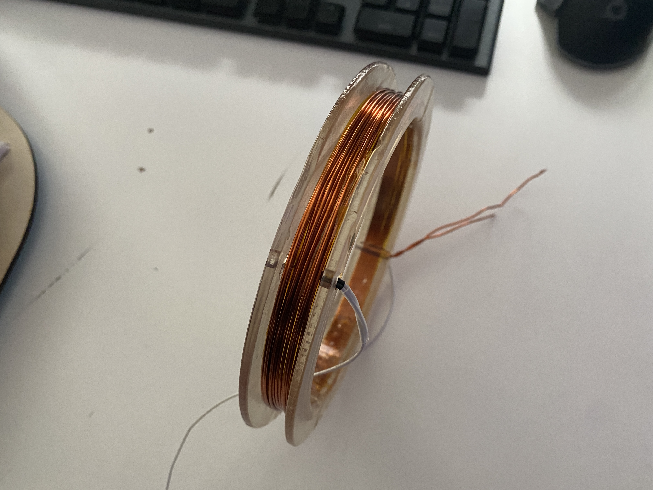
documentation/images/misc/IMG_4435.JPG
