LFB-MRI/MagneticReadoutProcessing/documentation/images/misc/IMG_5793.JPG

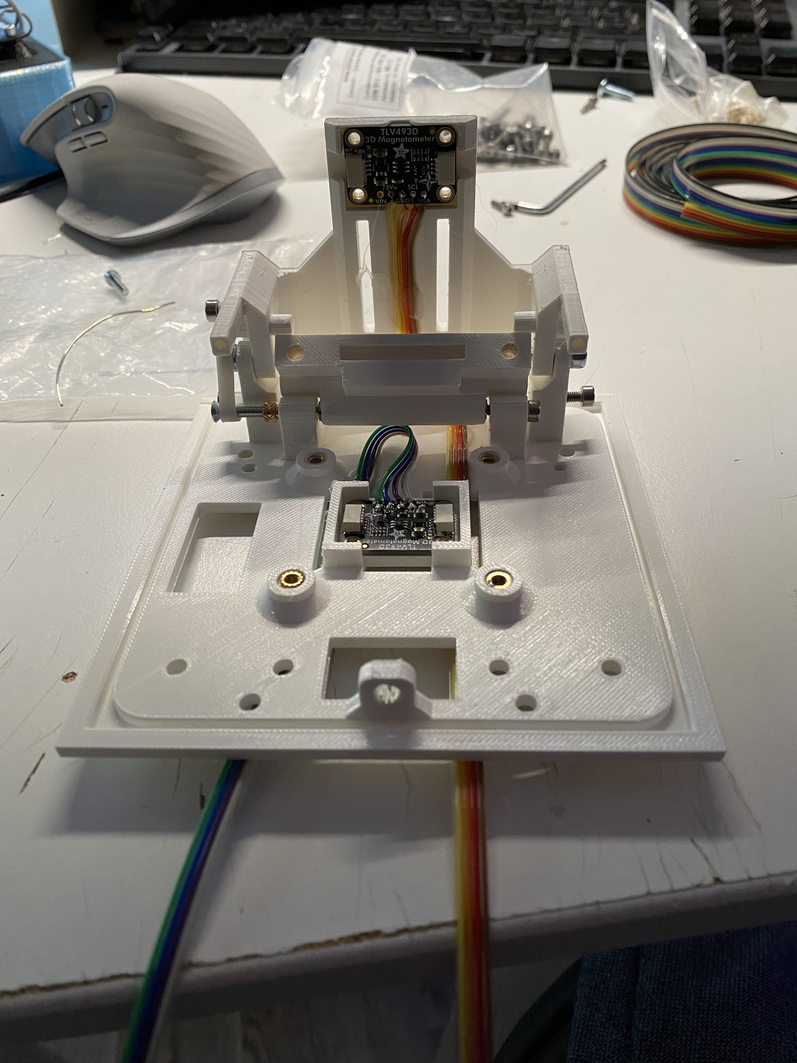
documentation/images/misc/IMG_5793.JPG
