LFB-MRI/MagneticReadoutProcessing/documentation/images/misc/IMG_5890.JPG

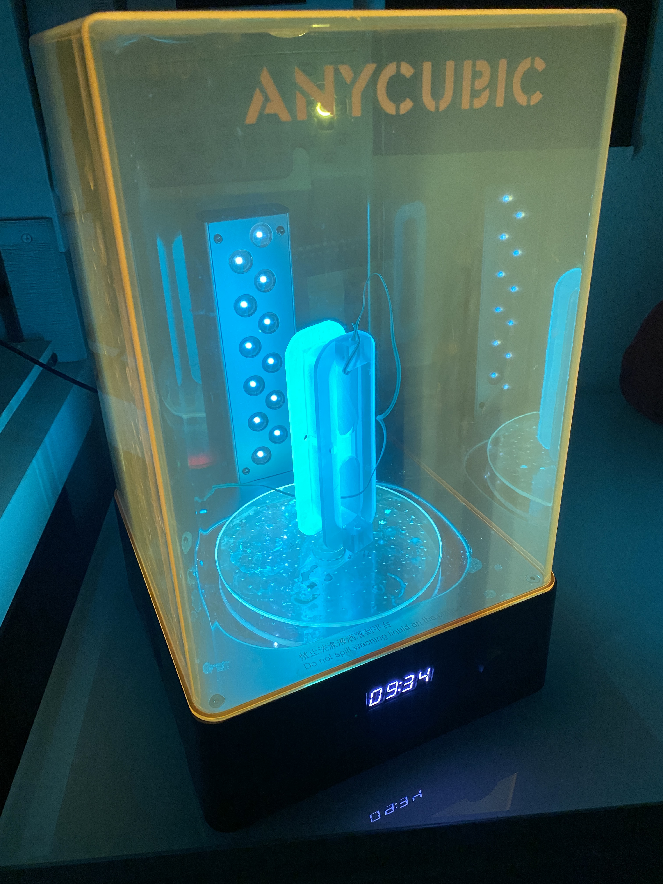
documentation/images/misc/IMG_5890.JPG
