LFB-MRI/MagneticReadoutProcessing/documentation/images/misc/IMG_5893.JPG

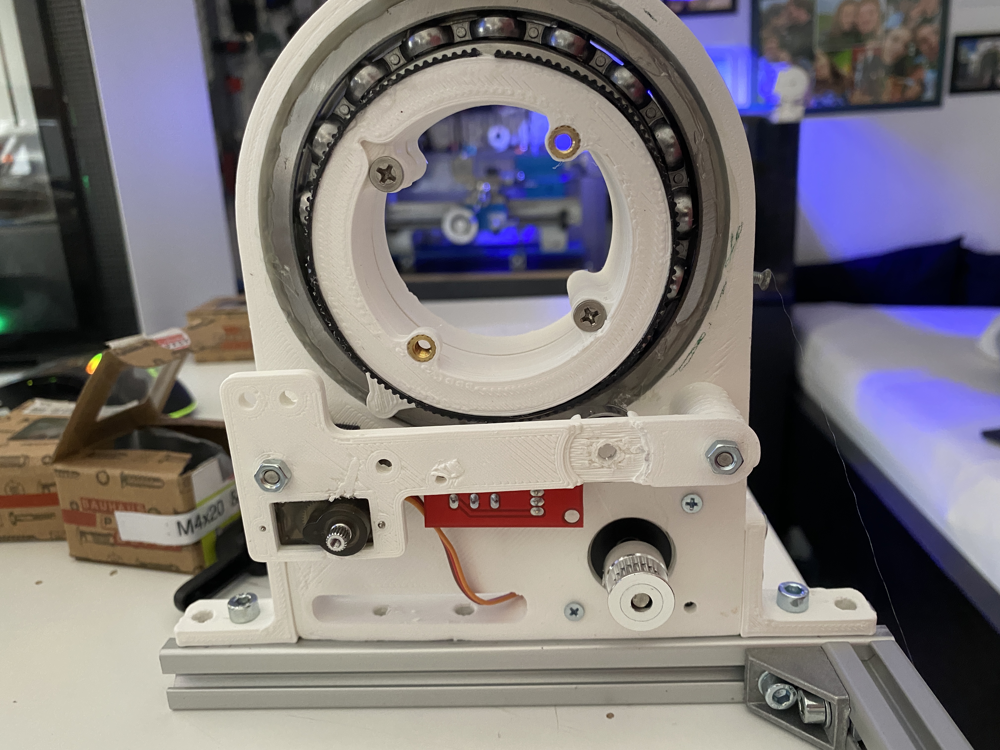
documentation/images/misc/IMG_5893.JPG
