LFB-MRI/MagneticReadoutProcessing/documentation/images/misc/IMG_5915.JPG

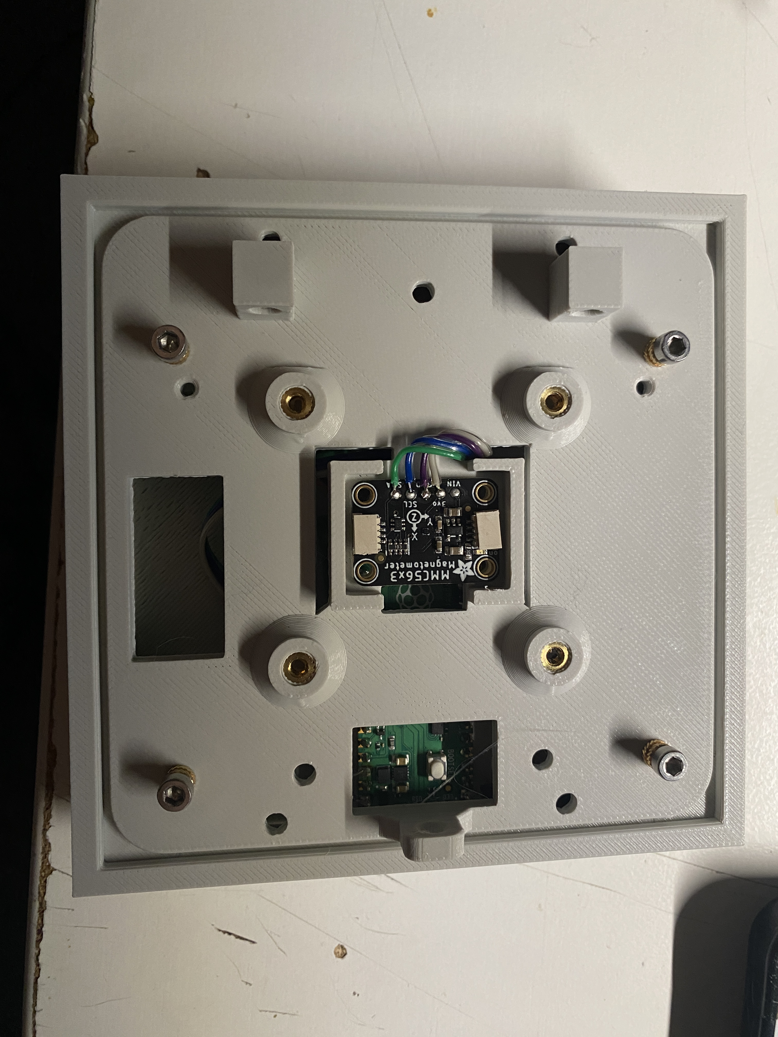
documentation/images/misc/IMG_5915.JPG
