LFB-MRI/MagneticReadoutProcessing/documentation/images/misc/IMG_5940.JPG

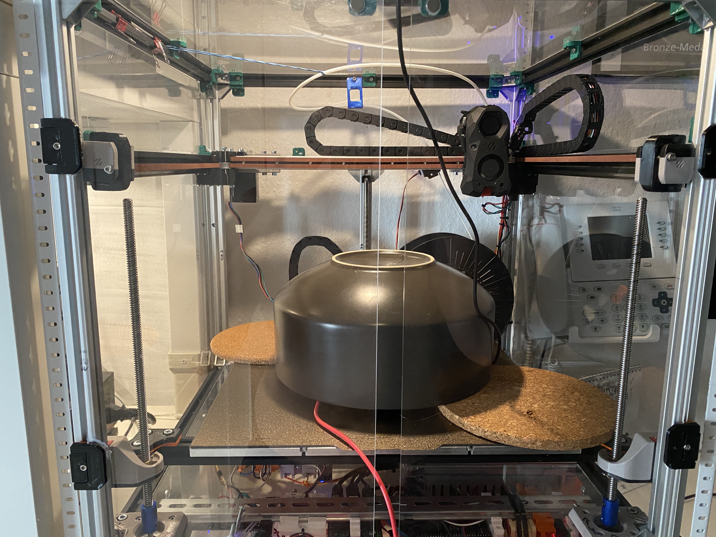
documentation/images/misc/IMG_5940.JPG
