LFB-MRI/MagneticReadoutProcessing/documentation/images/misc/IMG_7195.JPG

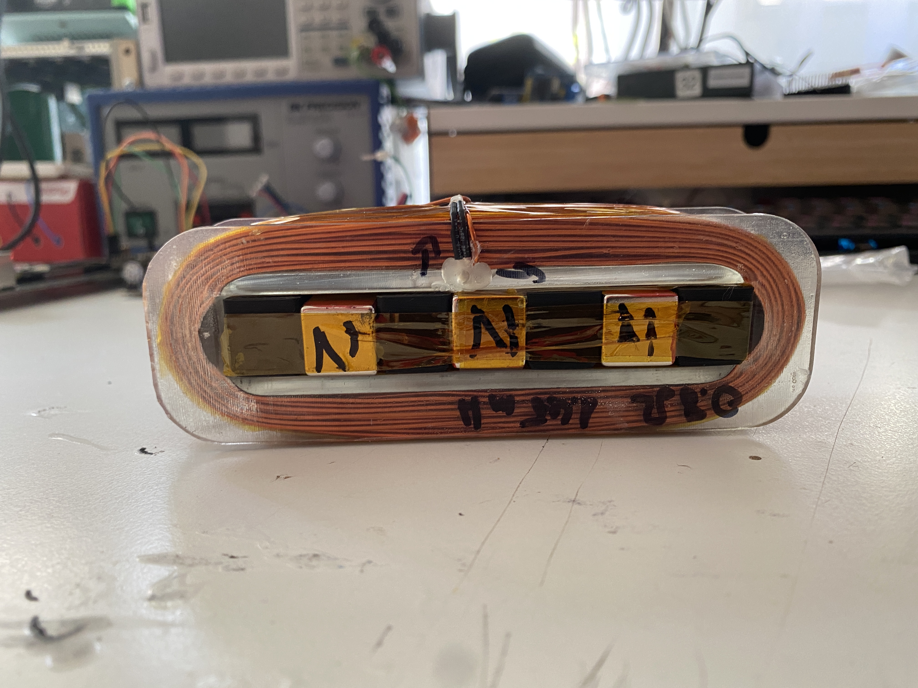
documentation/images/misc/IMG_7195.JPG
