LFB-MRI/MagneticReadoutProcessing/documentation/images/misc/IMG_7256.JPG

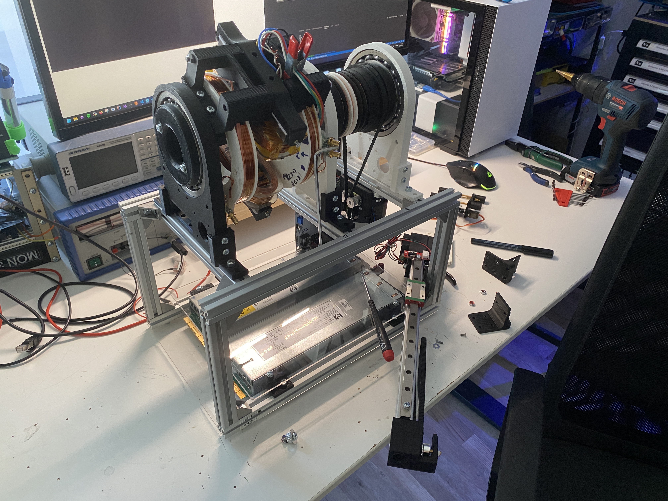
documentation/images/misc/IMG_7256.JPG
