LFB-MRI/MagneticReadoutProcessing/documentation/images/misc/IMG_7257.JPG

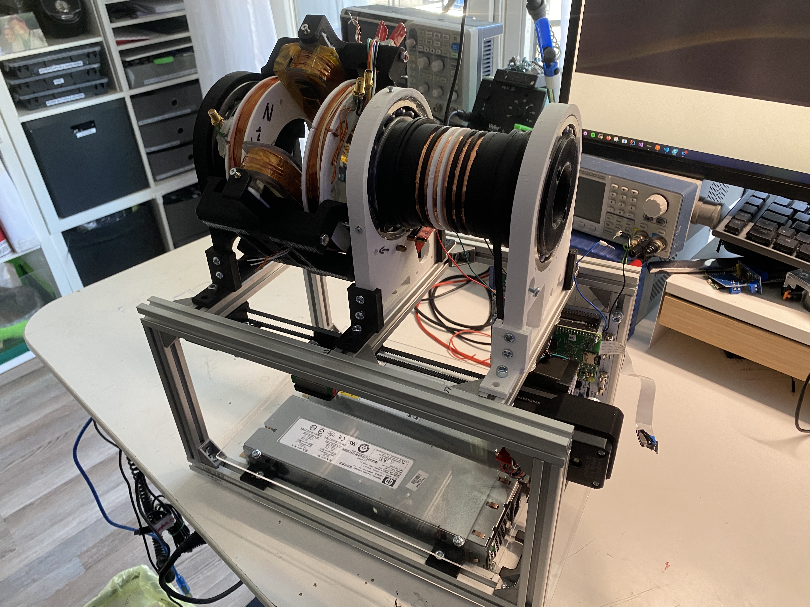
documentation/images/misc/IMG_7257.JPG
