LFB-MRI/MagneticReadoutProcessing/documentation/images/misc/IMG_7259.JPG

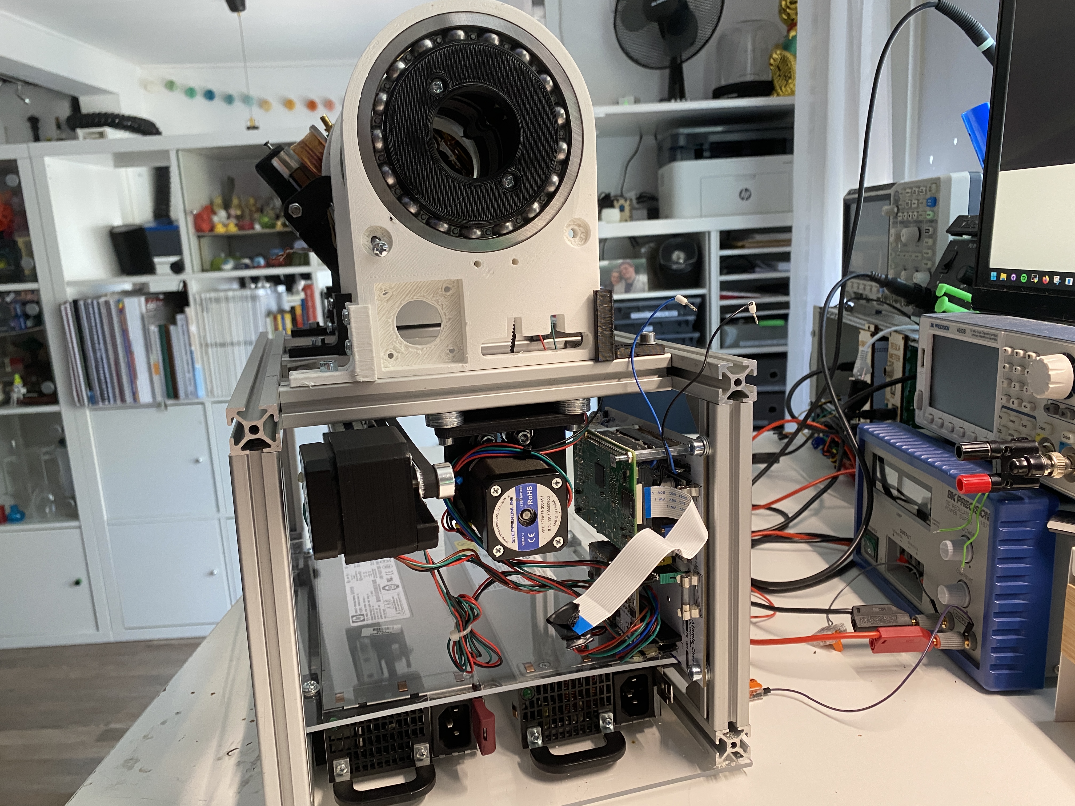
documentation/images/misc/IMG_7259.JPG
