LFB-MRI/MagneticReadoutProcessing/documentation/images/misc/IMG_7260.JPG

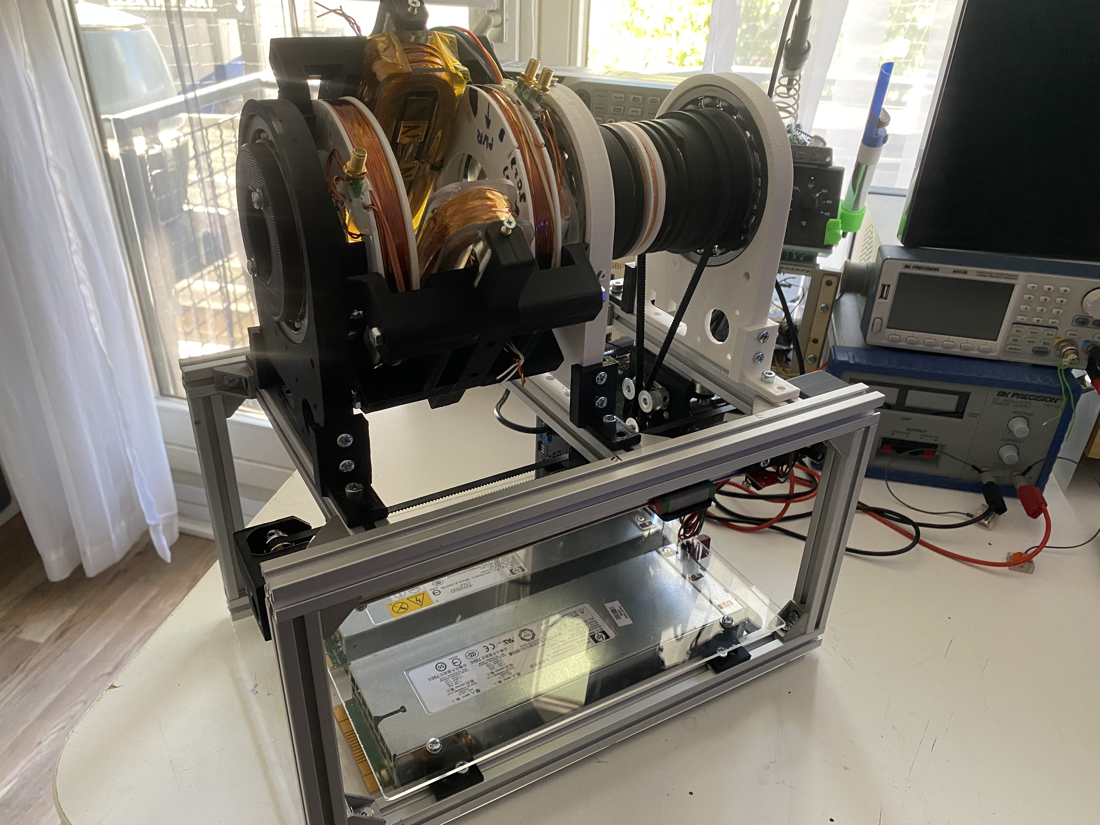
documentation/images/misc/IMG_7260.JPG
