LFB-MRI/MagneticReadoutProcessing/documentation/images/misc/IMG_7262.JPG

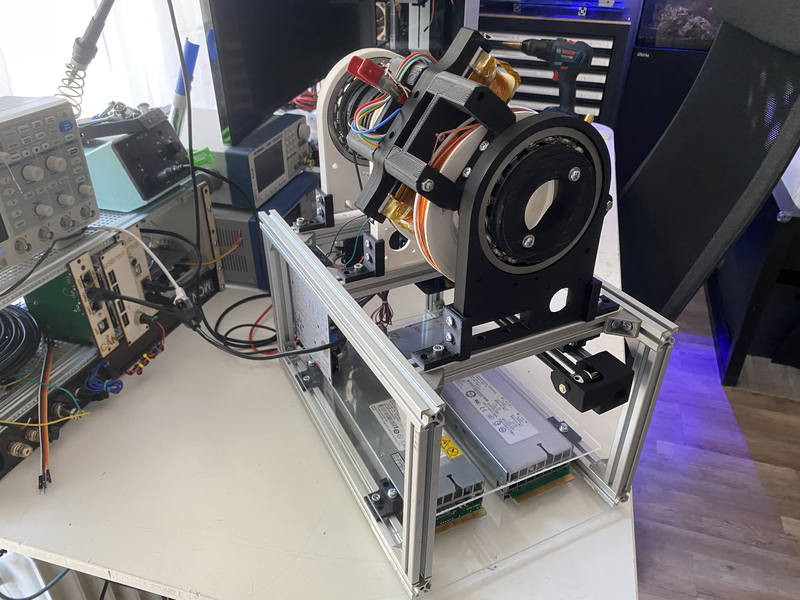
documentation/images/misc/IMG_7262.JPG
