LFB-MRI/MagneticReadoutProcessing/documentation/images/misc/IMG_7263.JPG

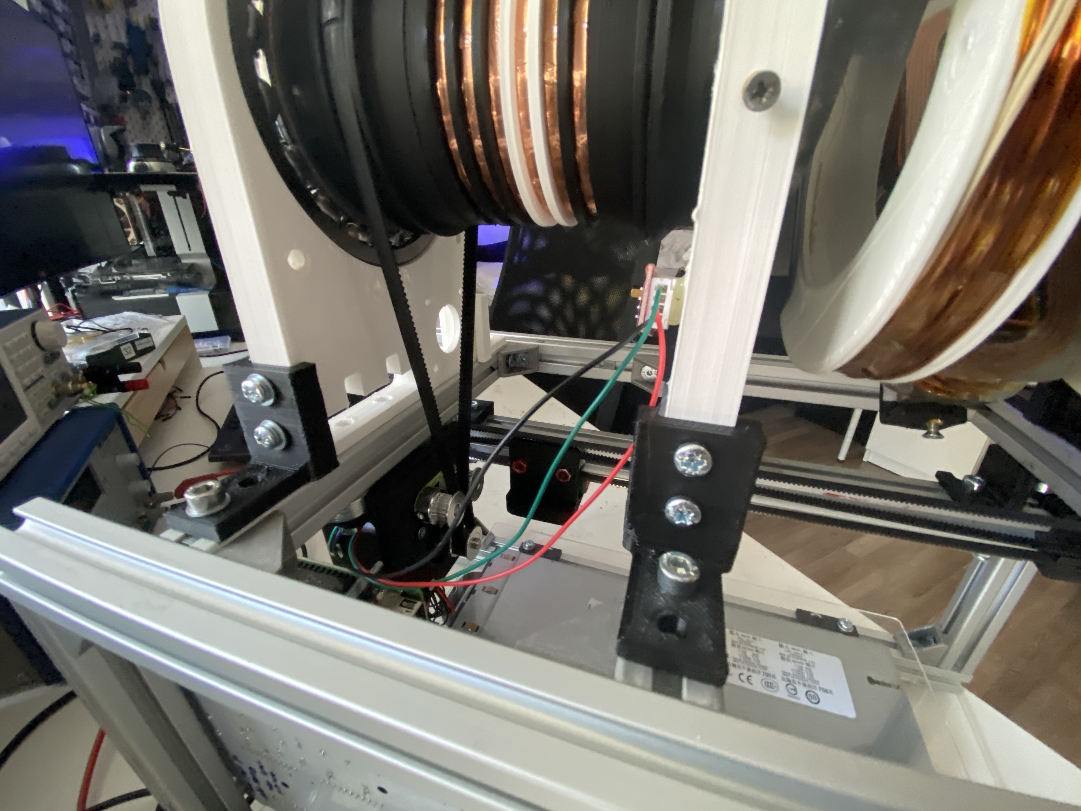
documentation/images/misc/IMG_7263.JPG
