LFB-MRI/MagneticReadoutProcessing/documentation/images/misc/IMG_7363.JPG

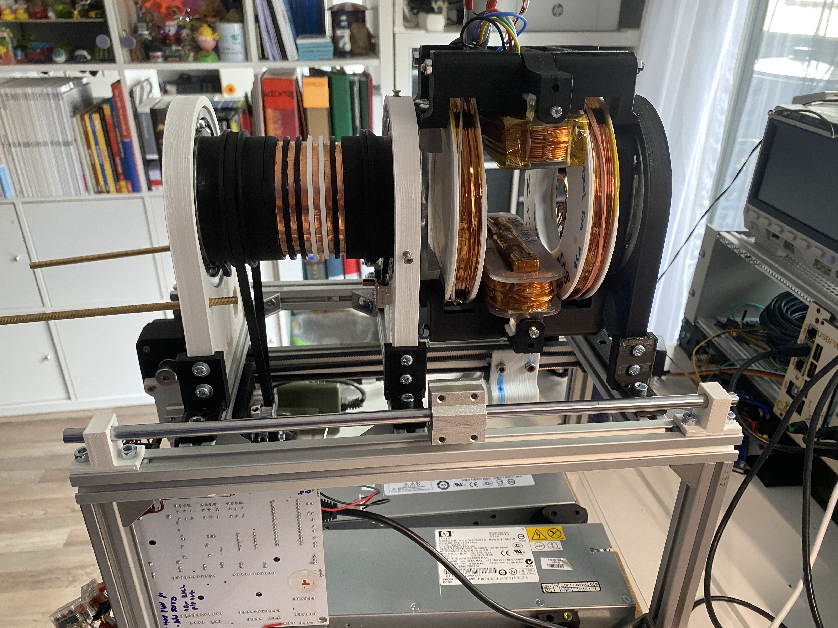
documentation/images/misc/IMG_7363.JPG
