LFB-MRI/MagneticReadoutProcessing/documentation/images/misc/IMG_7365.JPG

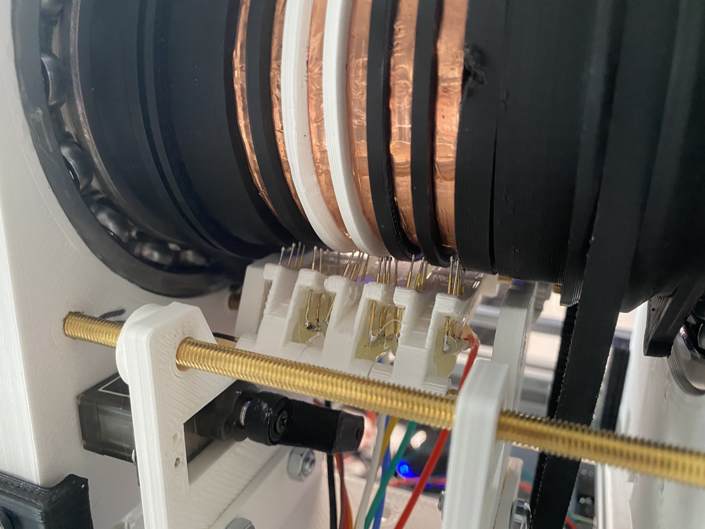
documentation/images/misc/IMG_7365.JPG
