LFB-MRI/MagneticReadoutProcessing/documentation/images/misc/IMG_7366.JPG

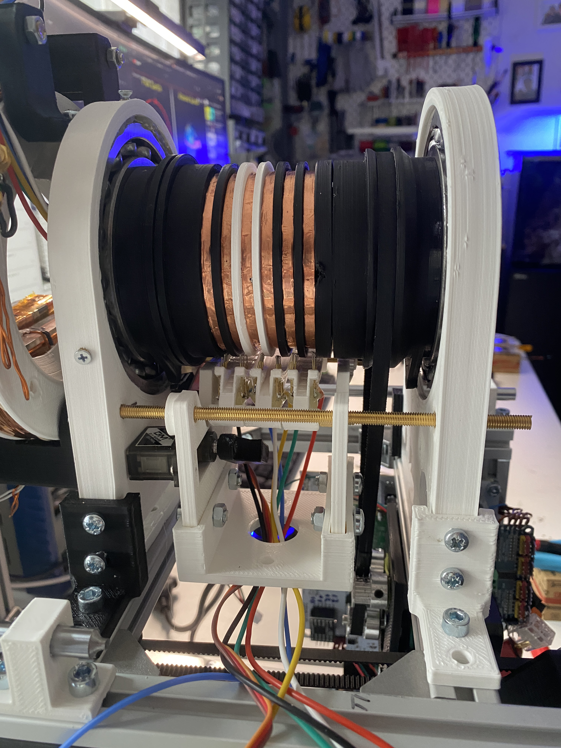
documentation/images/misc/IMG_7366.JPG
