LFB-MRI/MagneticReadoutProcessing/documentation/images/misc/IMG_7369.JPG

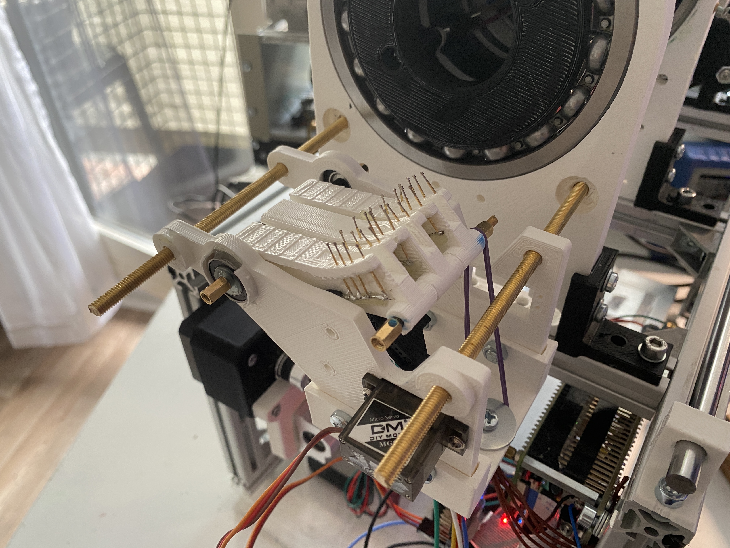
documentation/images/misc/IMG_7369.JPG
