LFB-MRI/MagneticReadoutProcessing/documentation/images/misc/IMG_7371.JPG

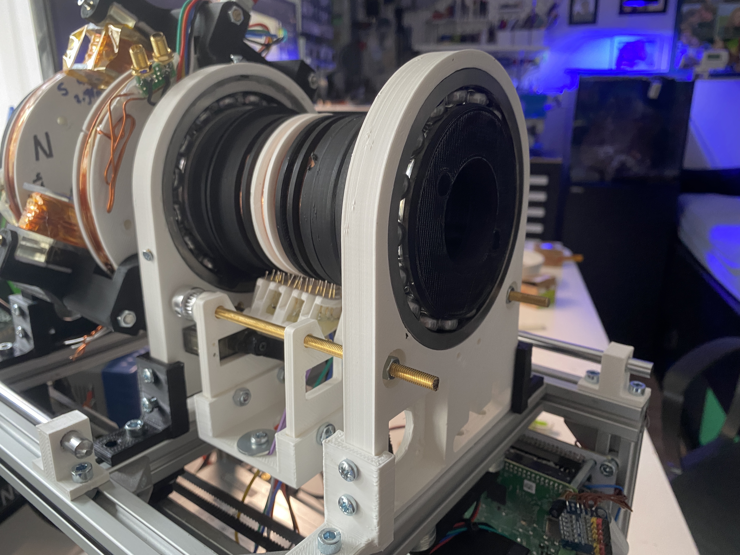
documentation/images/misc/IMG_7371.JPG
