LFB-MRI/MagneticReadoutProcessing/documentation/images/misc/IMG_7376.JPG

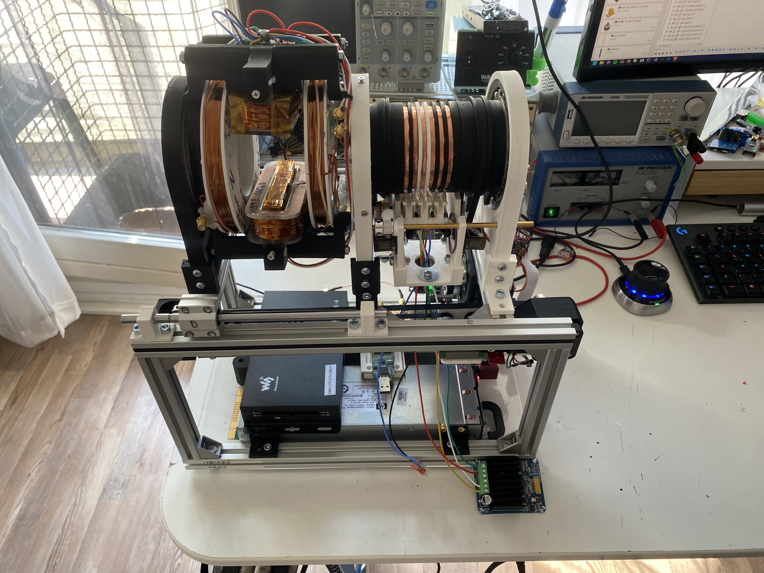
documentation/images/misc/IMG_7376.JPG
