LFB-MRI/MagneticReadoutProcessing/documentation/images/misc/IMG_7378.JPG

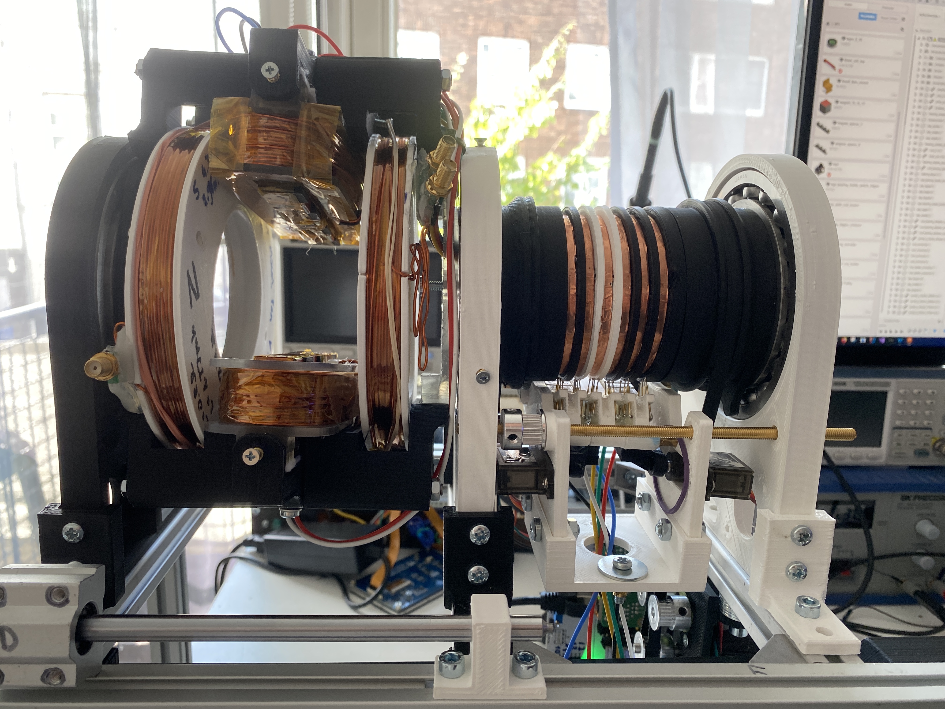
documentation/images/misc/IMG_7378.JPG
