LFB-MRI/MagneticReadoutProcessing/documentation/images/misc/IMG_7394.JPG

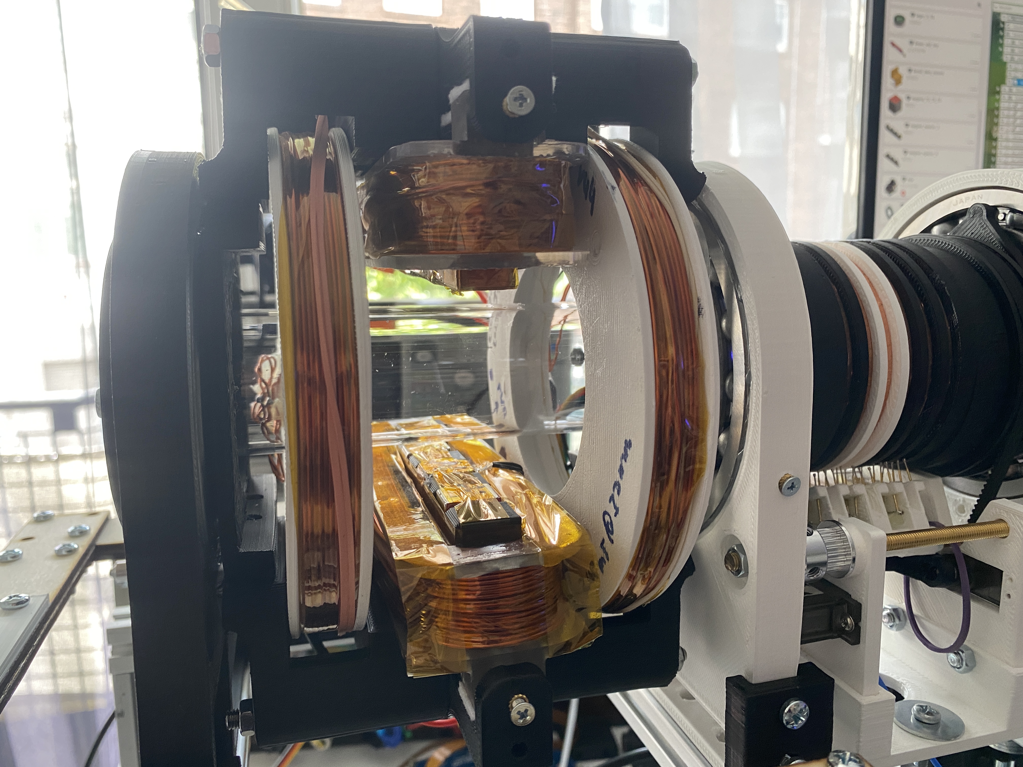
documentation/images/misc/IMG_7394.JPG
