LFB-MRI/MagneticReadoutProcessing/documentation/images/misc/IMG_7395.JPG

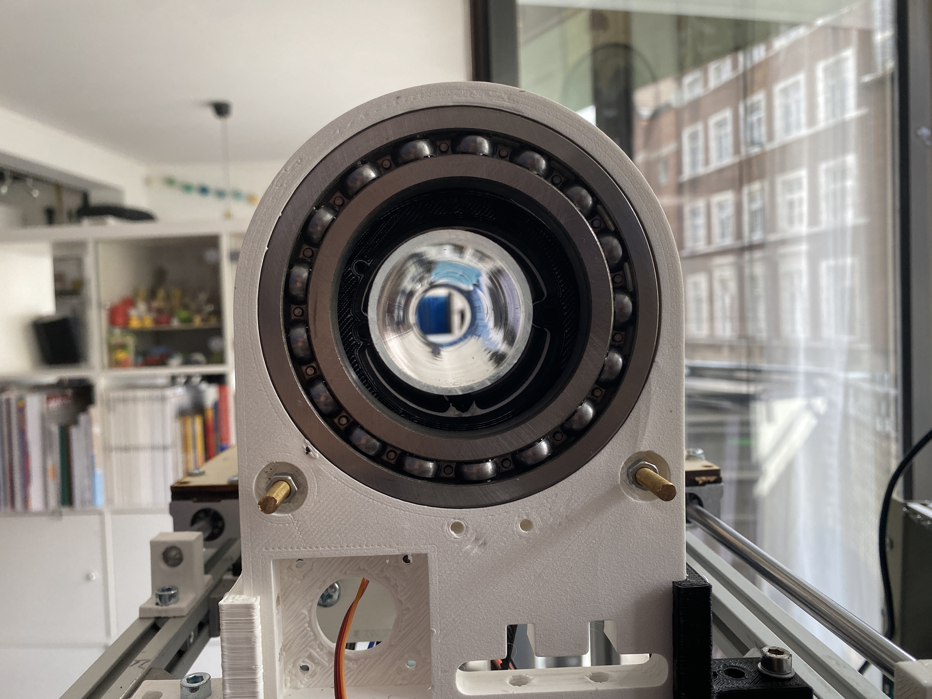
documentation/images/misc/IMG_7395.JPG
