LFB-MRI/MagneticReadoutProcessing/documentation/images/misc/IMG_7396.JPG

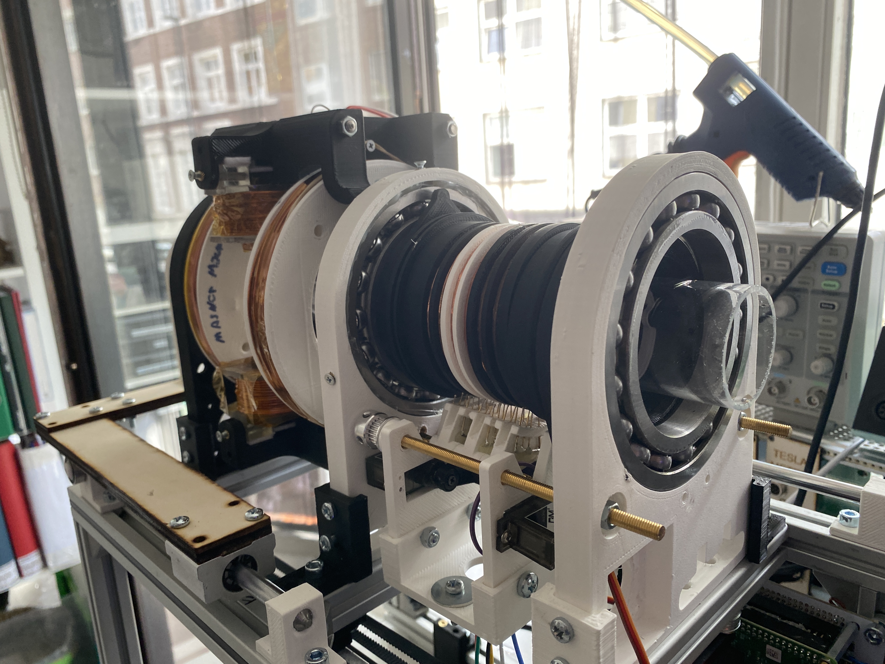
documentation/images/misc/IMG_7396.JPG
