LFB-MRI/MagneticReadoutProcessing/documentation/images/misc/IMG_7397.JPG

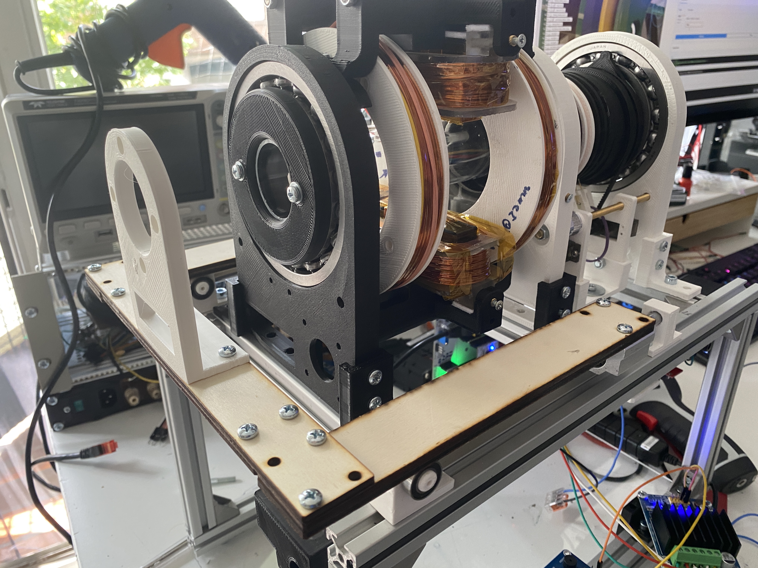
documentation/images/misc/IMG_7397.JPG
