LFB-MRI/MagneticReadoutProcessing/documentation/images/misc/IMG_7398.JPG

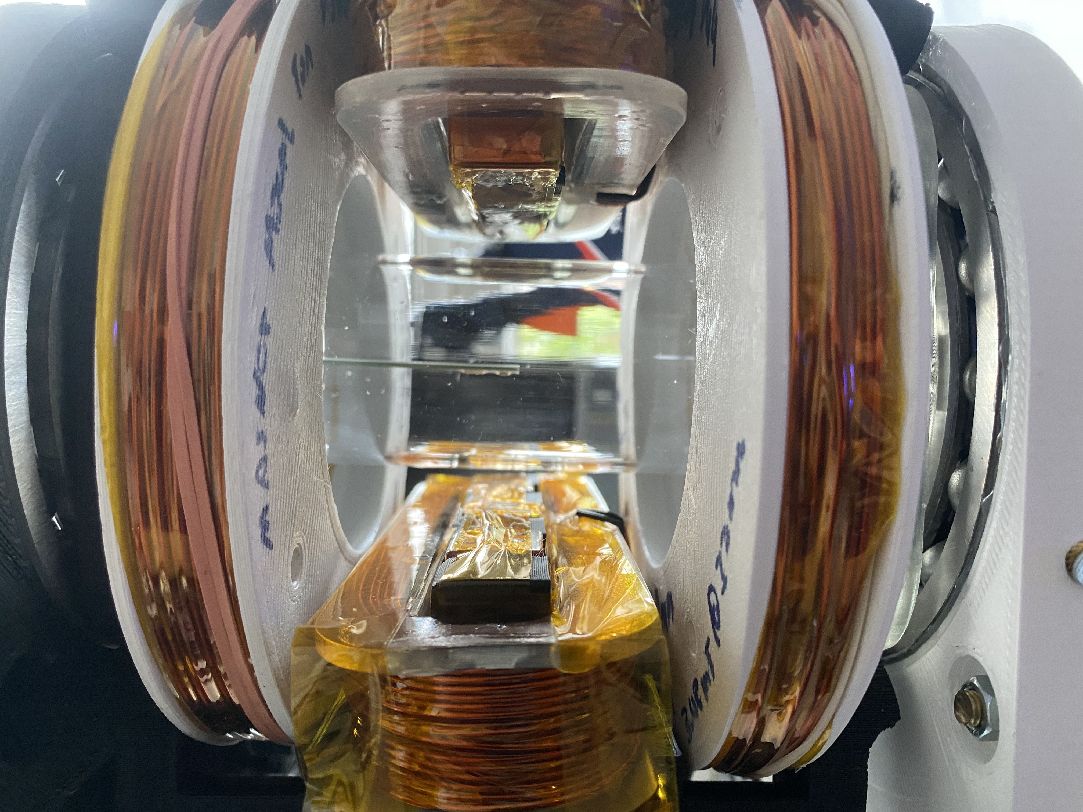
documentation/images/misc/IMG_7398.JPG
