LFB-MRI/MagneticReadoutProcessing/documentation/images/misc/IMG_7399.JPG

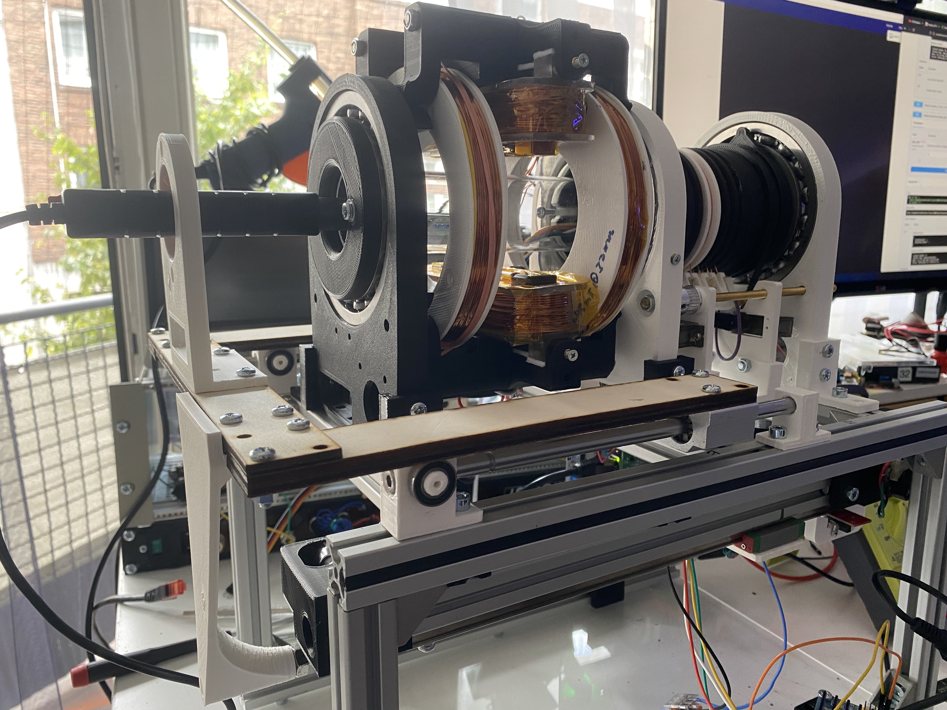
documentation/images/misc/IMG_7399.JPG
