LFB-MRI/MagneticReadoutProcessing/documentation/images/misc/IMG_7400.JPG

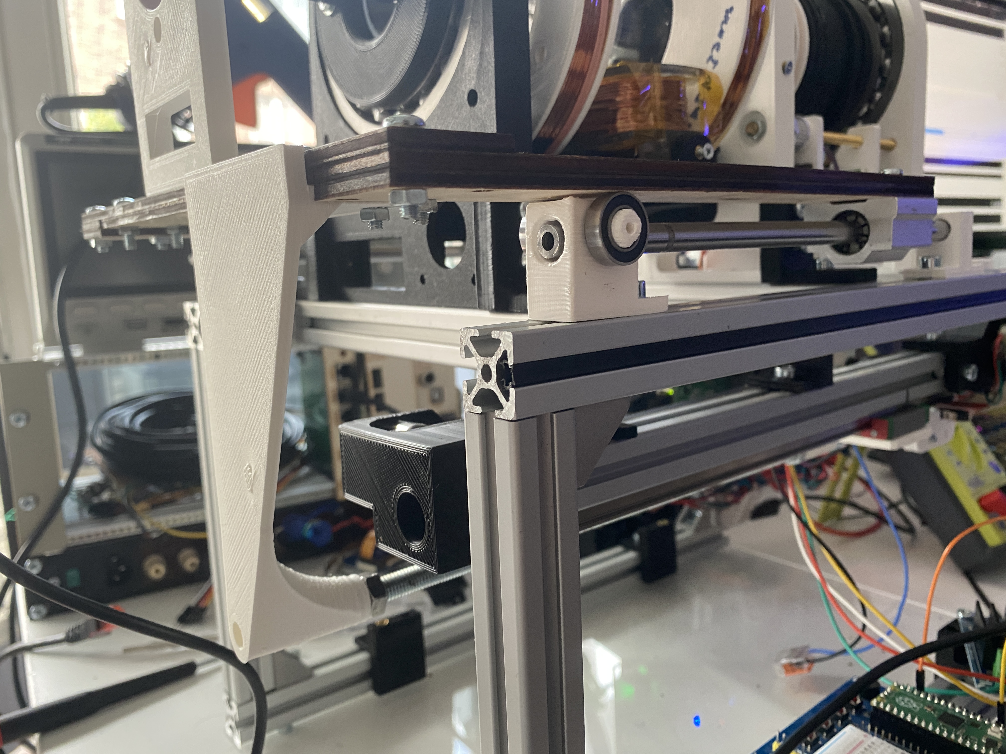
documentation/images/misc/IMG_7400.JPG
