LFB-MRI/MagneticReadoutProcessing/documentation/images/misc/IMG_8666.JPG

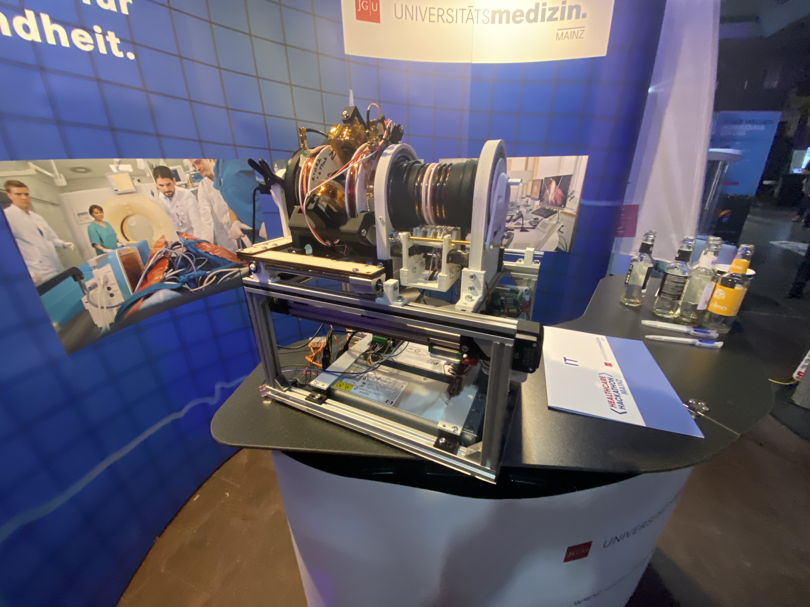
documentation/images/misc/IMG_8666.JPG
