LFB-MRI/MagneticReadoutProcessing/documentation/sciencemeeting/images/clock_1.jpeg

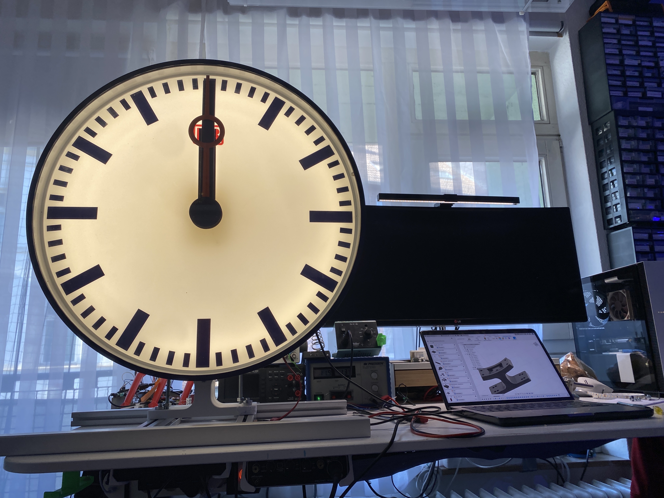
documentation/sciencemeeting/images/clock_1.jpeg
