LFB-MRI/MagneticReadoutProcessing/documentation/sciencemeeting/images/gamp.png

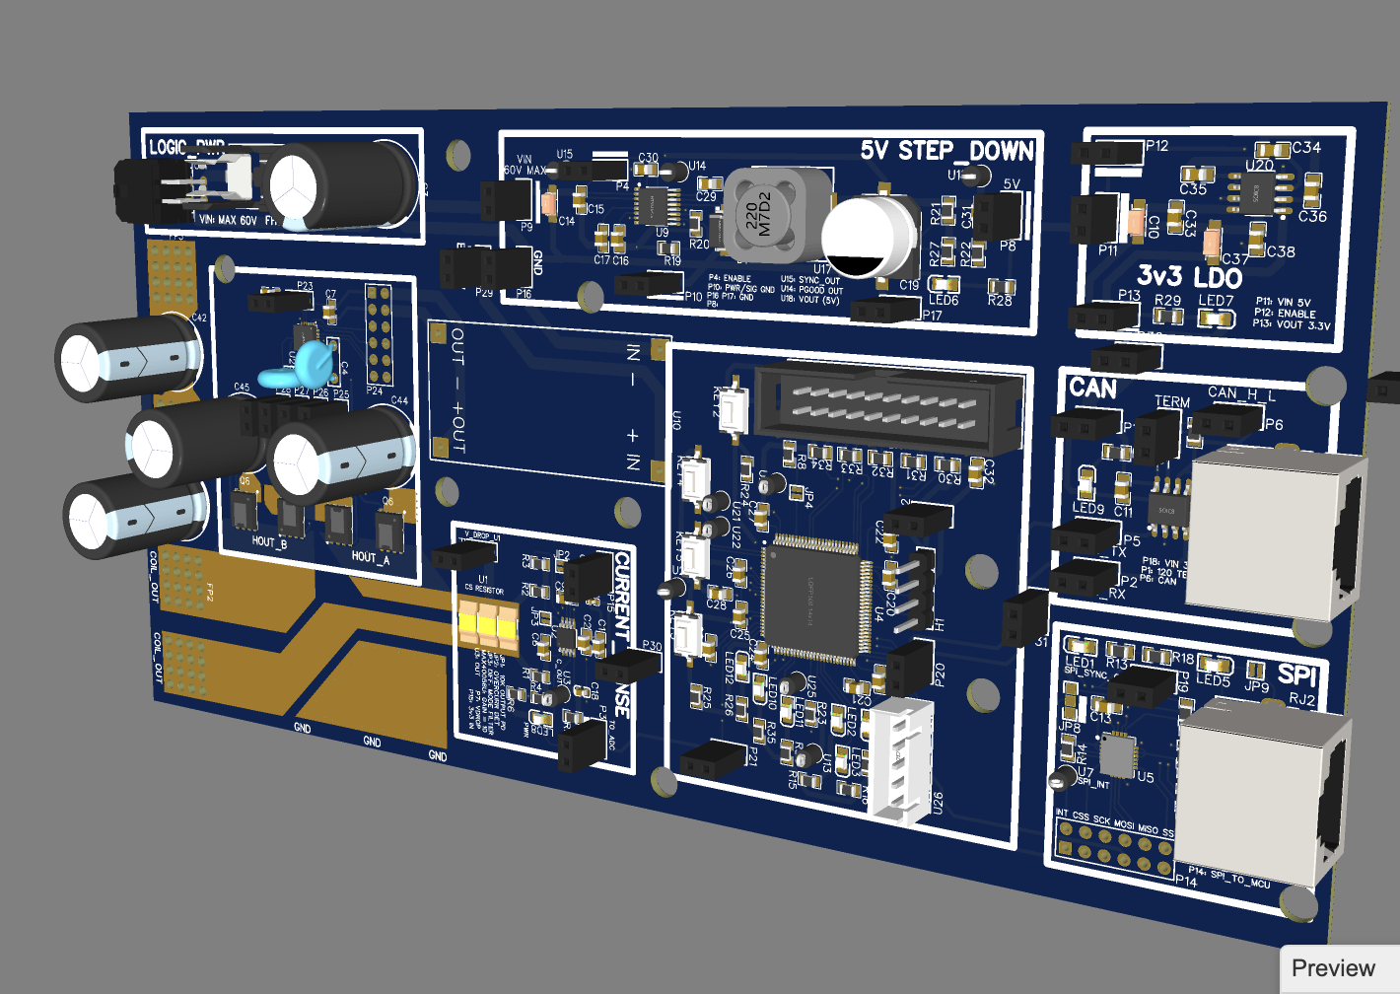
documentation/sciencemeeting/images/gamp.png
