LFB-MRI/MagneticReadoutProcessing/documentation/sciencemeeting/images/overview.png

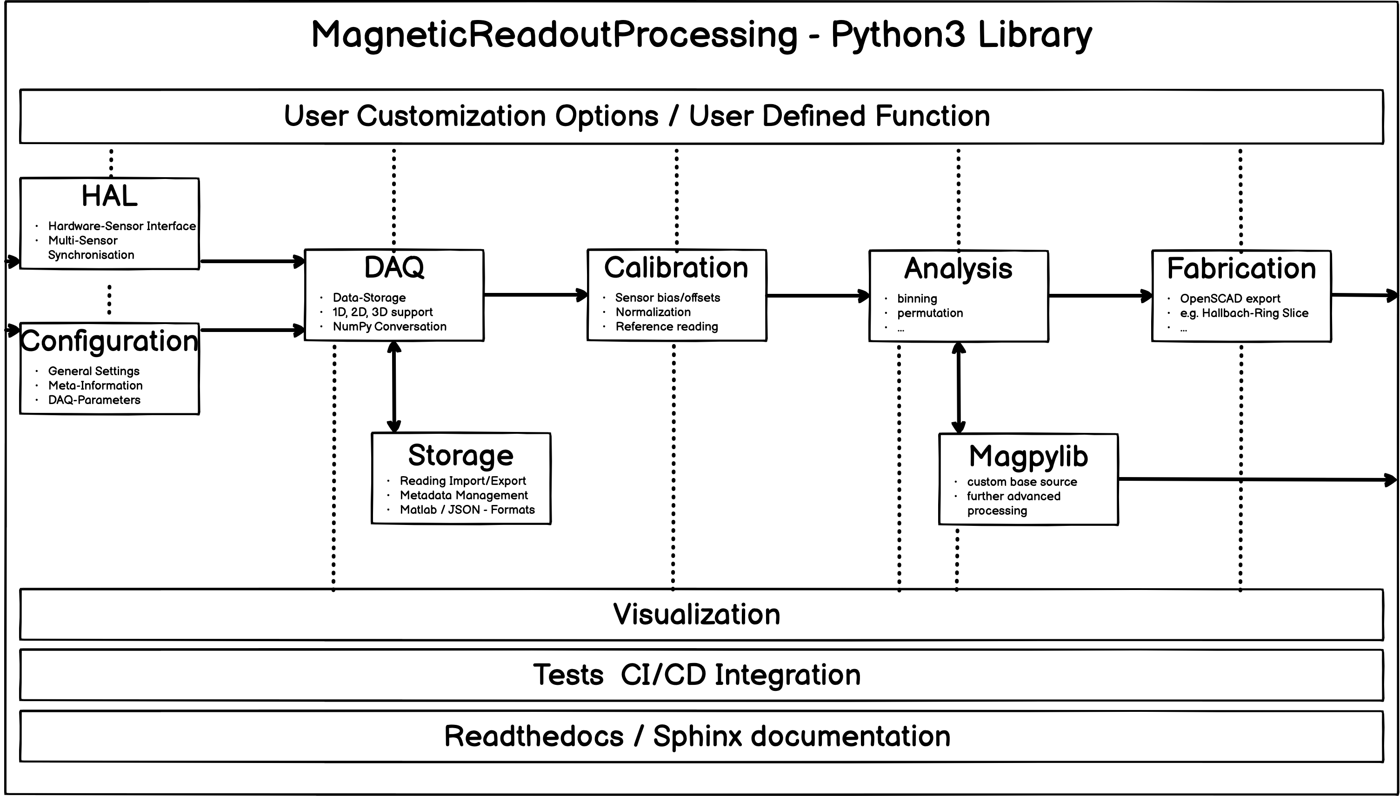
documentation/sciencemeeting/images/overview.png
