LFB-MRI/MagneticReadoutProcessing/documentation/thesis/images/1D_sensor_contrsuction_with_universal_magnet_mount/a.JPG

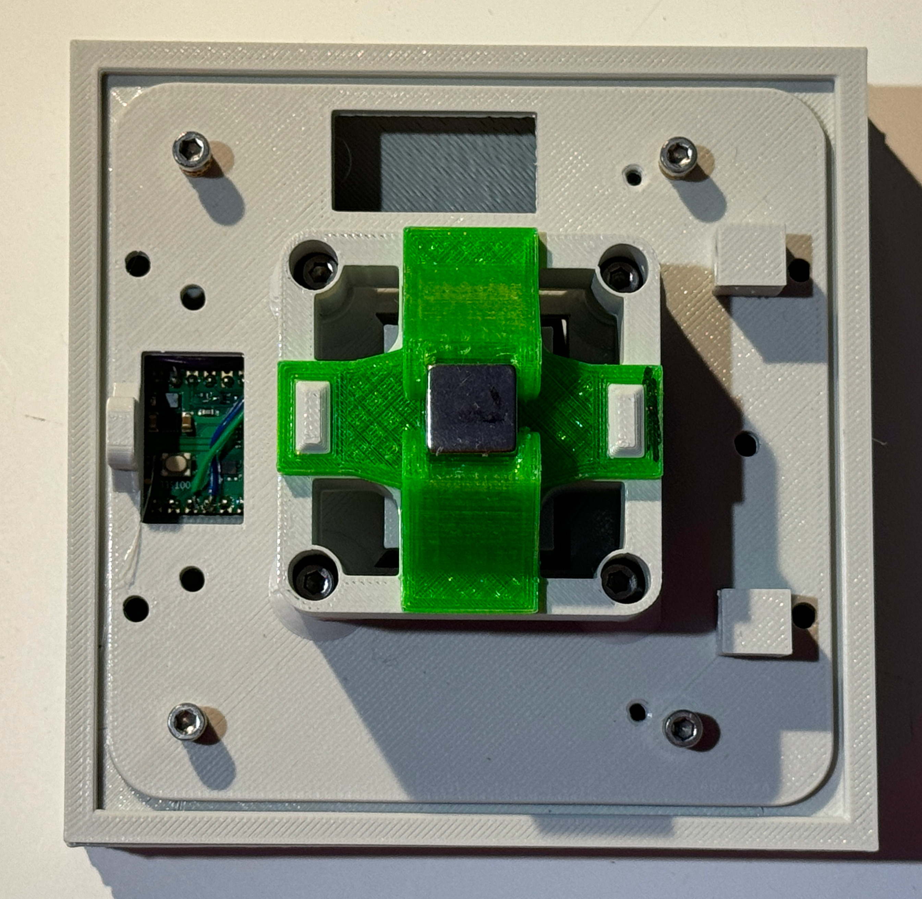
documentation/thesis/images/1D_sensor_contrsuction_with_universal_magnet_mount/a.JPG
