LFB-MRI/MagneticReadoutProcessing/documentation/thesis/images/1D_sensor_schematic_using_an_Raspberry_Pi_Pico_with_a_TLV493D_footprint_in_the_center.png

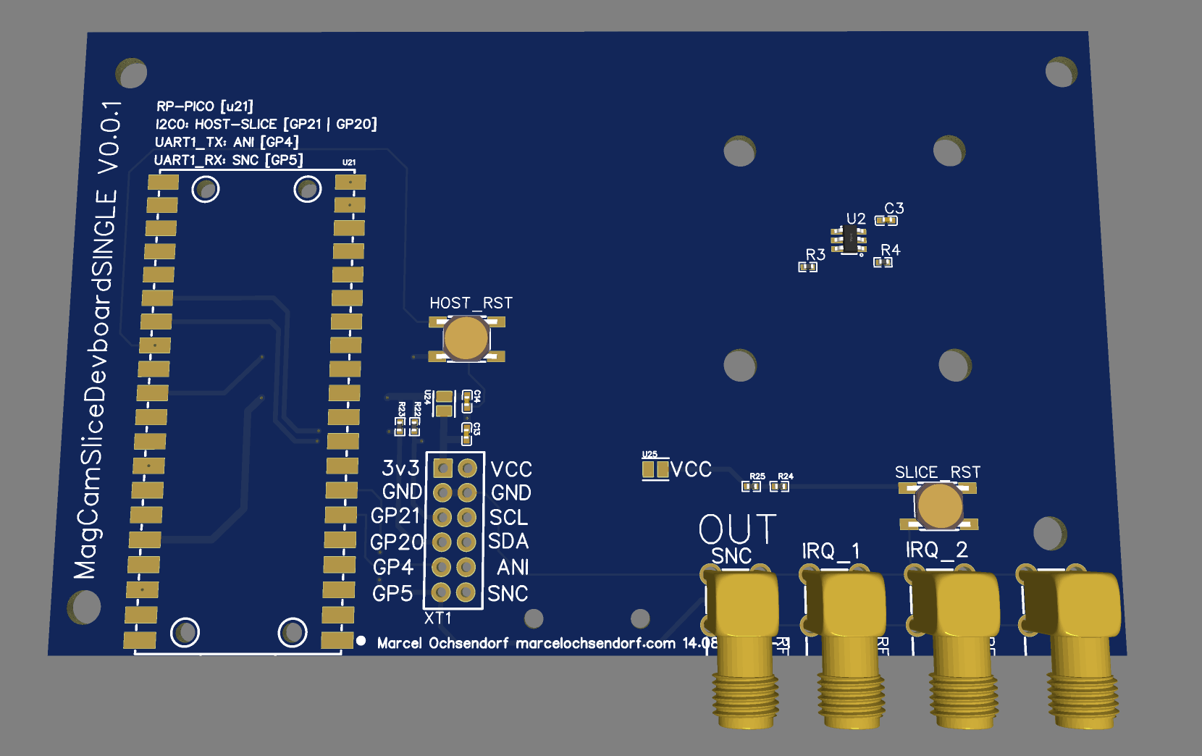
documentation/thesis/images/1D_sensor_schematic_using_an_Raspberry_Pi_Pico_with_a_TLV493D_footprint_in_the_center.png
