LFB-MRI/MagneticReadoutProcessing/documentation/thesis/images/calltree/calltree_graph.png

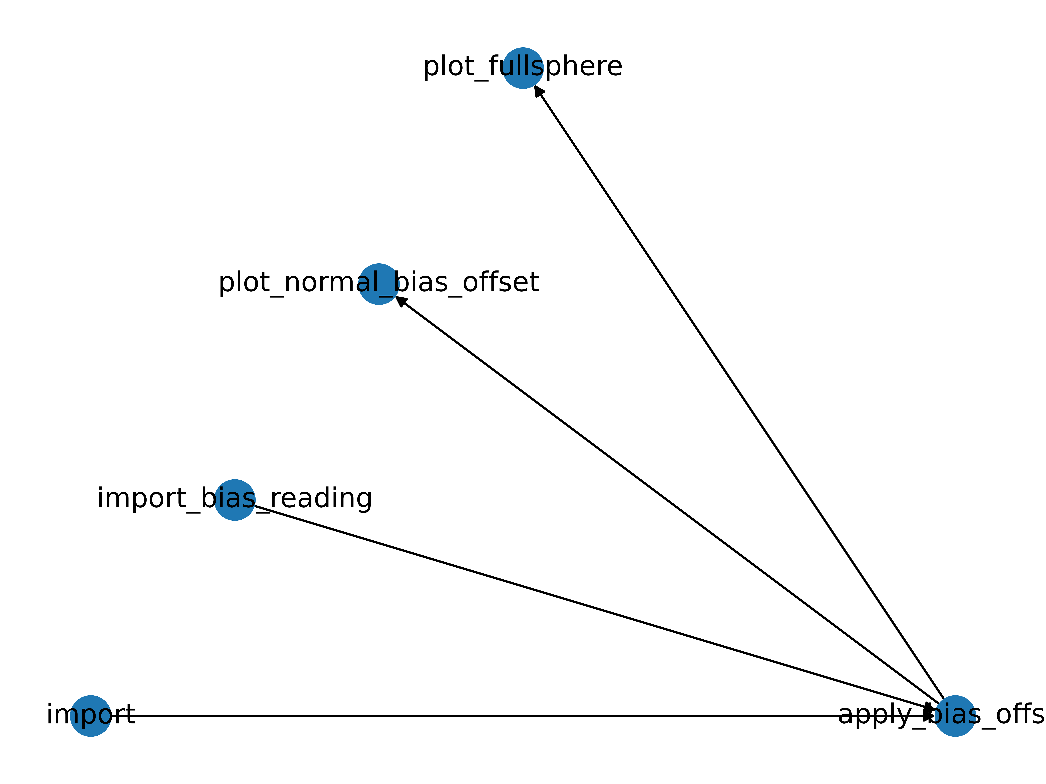
documentation/thesis/images/calltree/calltree_graph.png
