LFB-MRI/MagneticReadoutProcessing/documentation/thesis/images/calltree/sub_calltree_startstage_apply_bias_offset.png

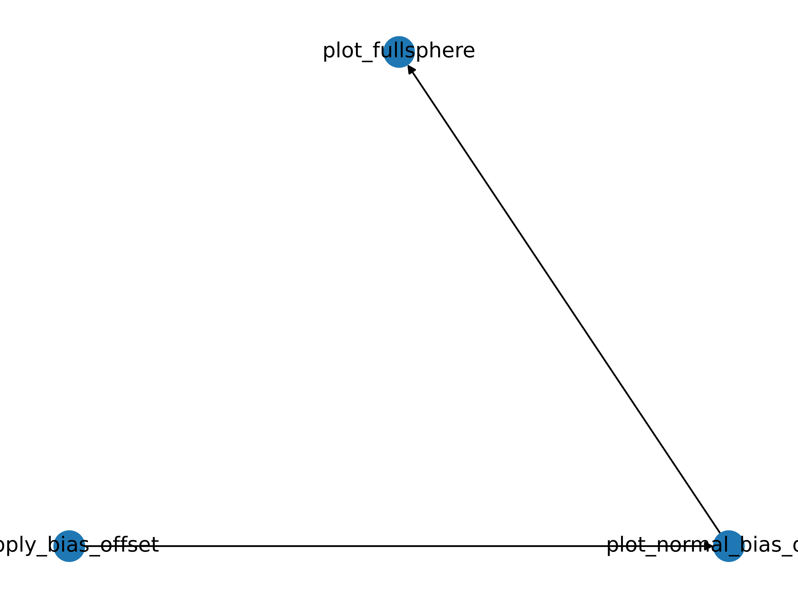
documentation/thesis/images/calltree/sub_calltree_startstage_apply_bias_offset.png
