LFB-MRI/MagneticReadoutProcessing/documentation/thesis/images/calltree/sub_calltree_startstage_import.png

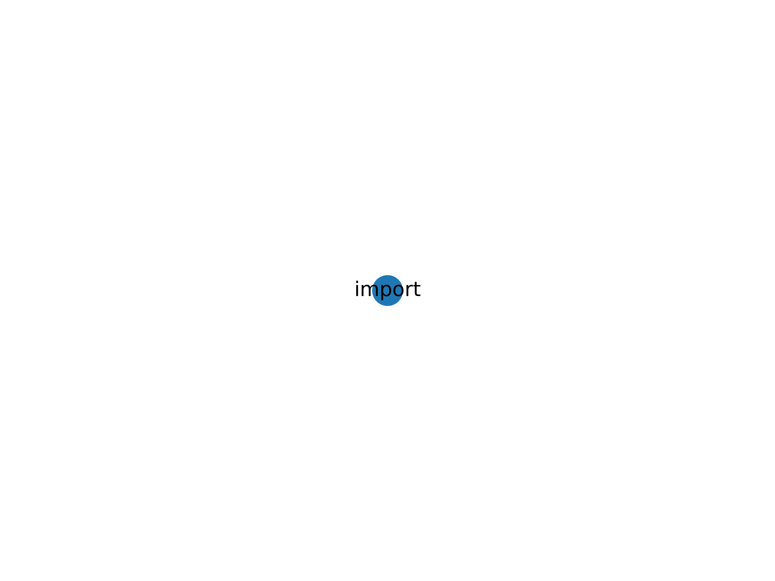
documentation/thesis/images/calltree/sub_calltree_startstage_import.png
