LFB-MRI/MagneticReadoutProcessing/documentation/thesis/images/Generated_Halbach_array_with_generated_cutouts_for_eight_magnets.png

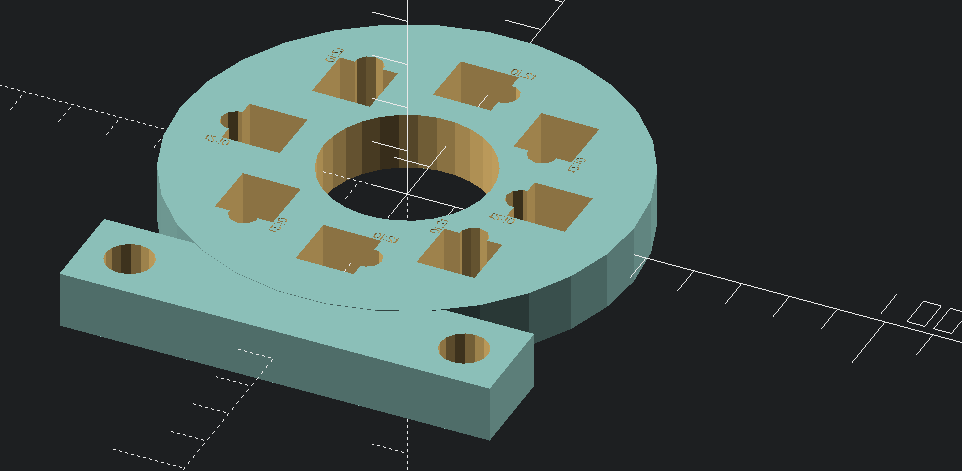
documentation/thesis/images/Generated_Halbach_array_with_generated_cutouts_for_eight_magnets.png
