LFB-MRI/MagneticReadoutProcessing/documentation/thesis/images/MagneticReadoutProcessing_library_hosted_on_PyPi.png

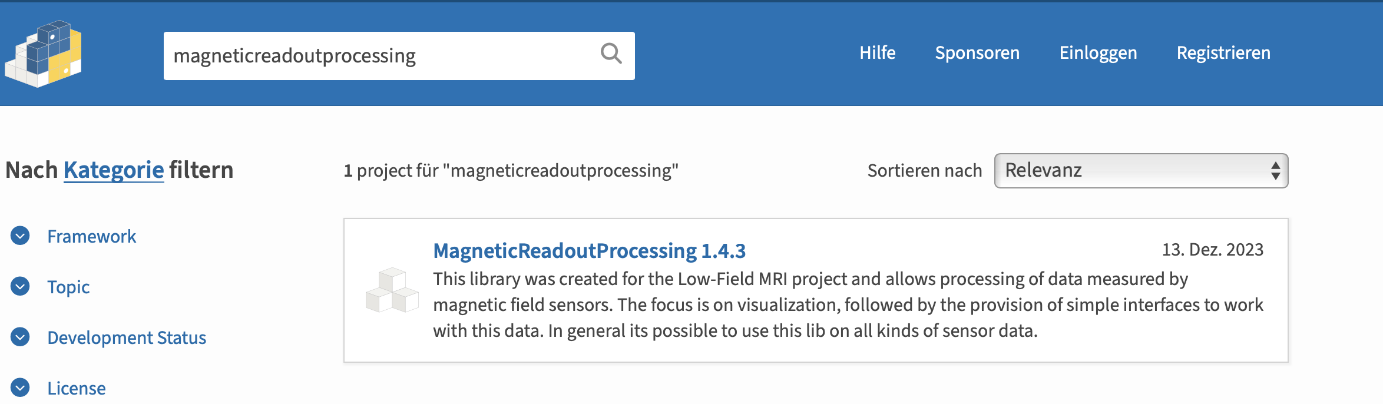
documentation/thesis/images/MagneticReadoutProcessing_library_hosted_on_PyPi.png
