LFB-MRI/MagneticReadoutProcessing/documentation/thesis/images/pipeline_output/Bildschirmfoto 2023-12-18 um 09.55.15.png

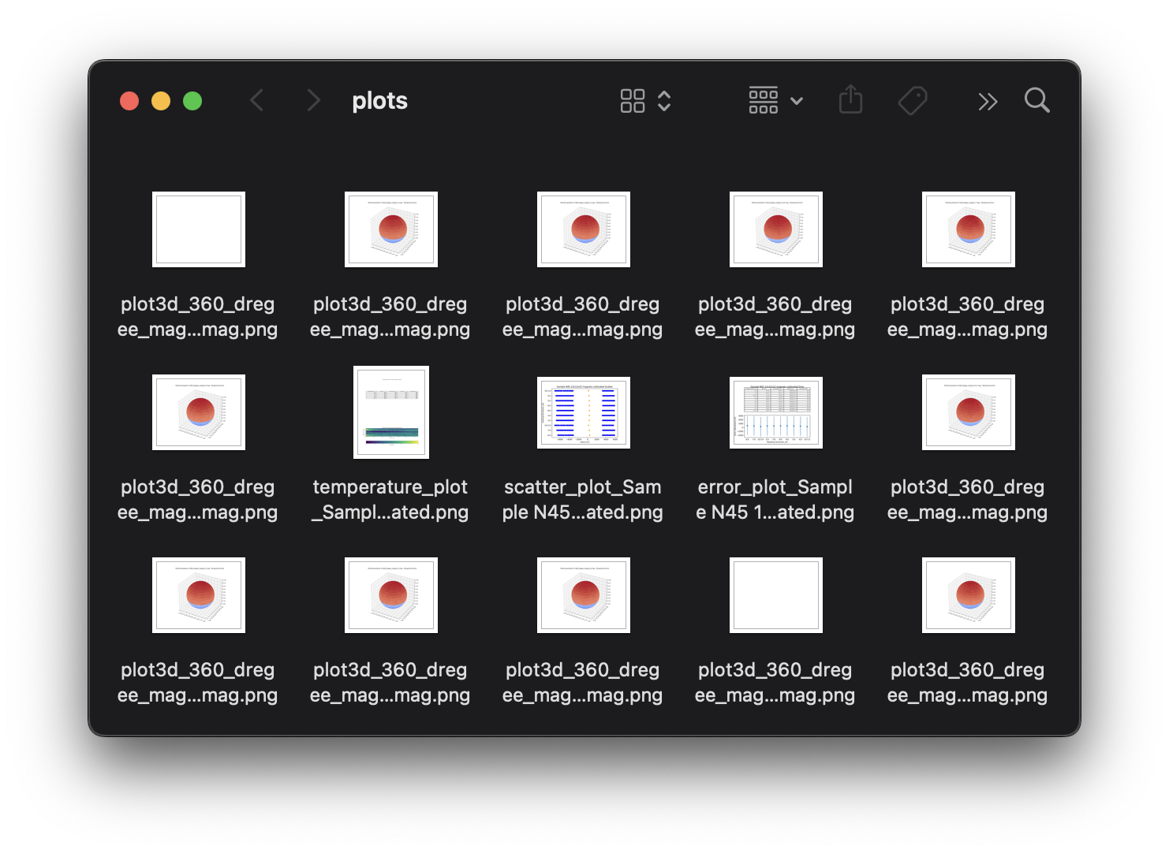
documentation/thesis/images/pipeline_output/Bildschirmfoto 2023-12-18 um 09.55.15.png
