LFB-MRI/MagneticReadoutProcessing/documentation/thesis/images/Typical_block_diagram_of_a_digital_hall_sensor_sensing_chain_using_three_hall_plates.png

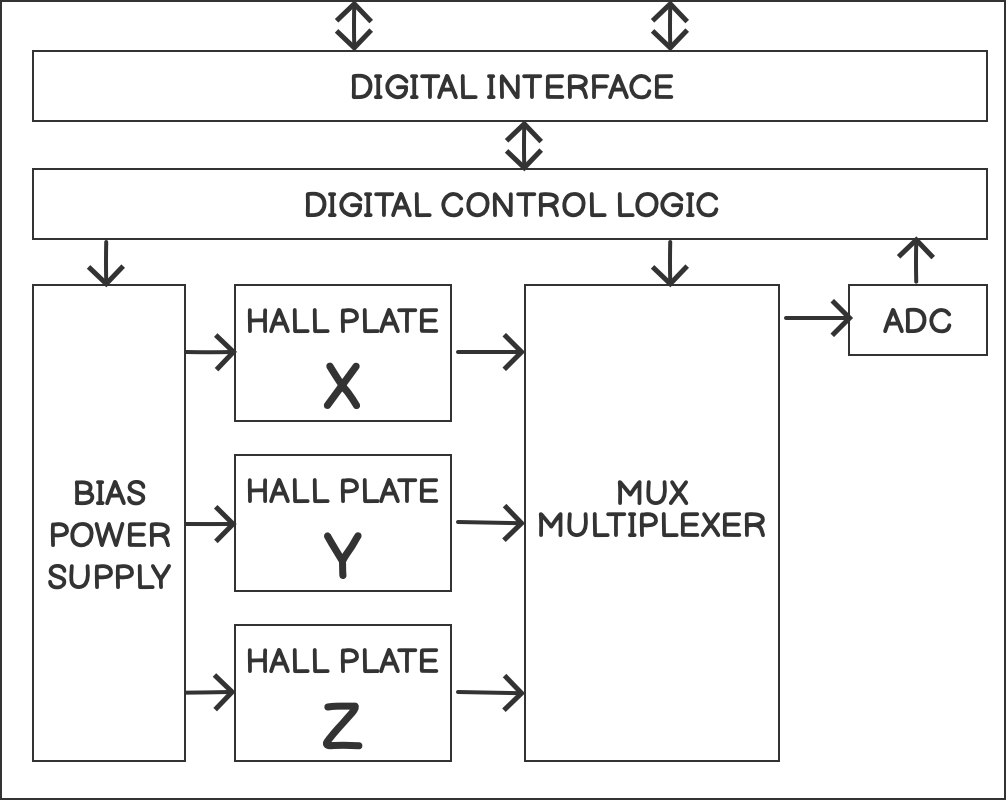
documentation/thesis/images/Typical_block_diagram_of_a_digital_hall_sensor_sensing_chain_using_three_hall_plates.png
