LFB-MRI/MagneticReadoutProcessing/src/MagBoardHardware/dual_sensor/IMAGES/dual_sensor_render_3.png

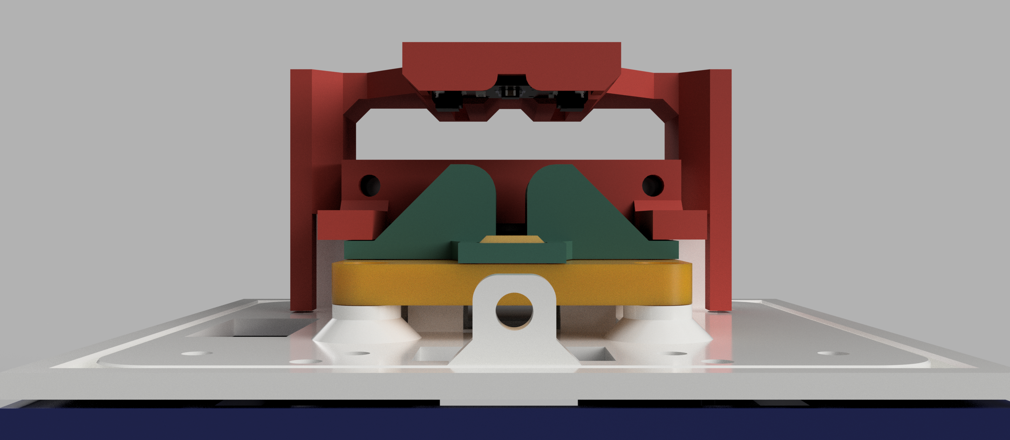
src/MagBoardHardware/dual_sensor/IMAGES/dual_sensor_render_3.png
