LFB-MRI/MagneticReadoutProcessing/src/MagBoardHardware/single_sensor/IMAGES/single_sensor_render_2.png

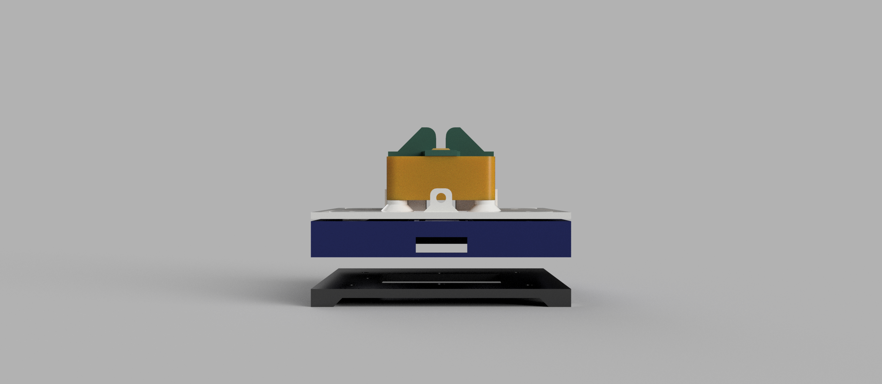
src/MagBoardHardware/single_sensor/IMAGES/single_sensor_render_2.png
