LFB-MRI/MagneticReadoutProcessing/documentation/thesis/images/Mechanical_components_for_the_1D_sensor_using_3D_printed_parts.png.md

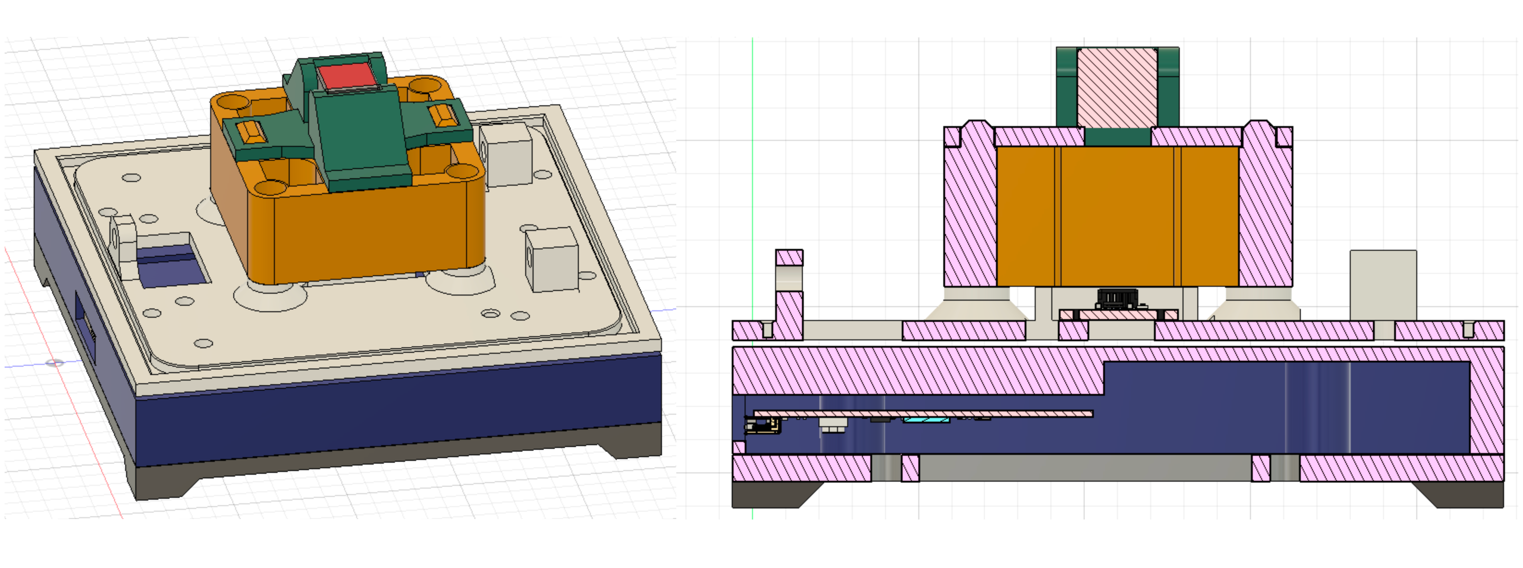
[picture p205: documentation/thesis/generated_images/border_Mechanical_components_for_the_1D_sensor_using_3D_printed_parts.png]
Mechanical components for the 1D sensor using 3D printed parts. \label{Mechanical_components_for_the_1D_sensor_using_3D_printed_parts.png}
