LFB-MRI/MagneticReadoutProcessing/src/MagBoardHardware/dual_sensor/CAD/devboard_rotational v2.step

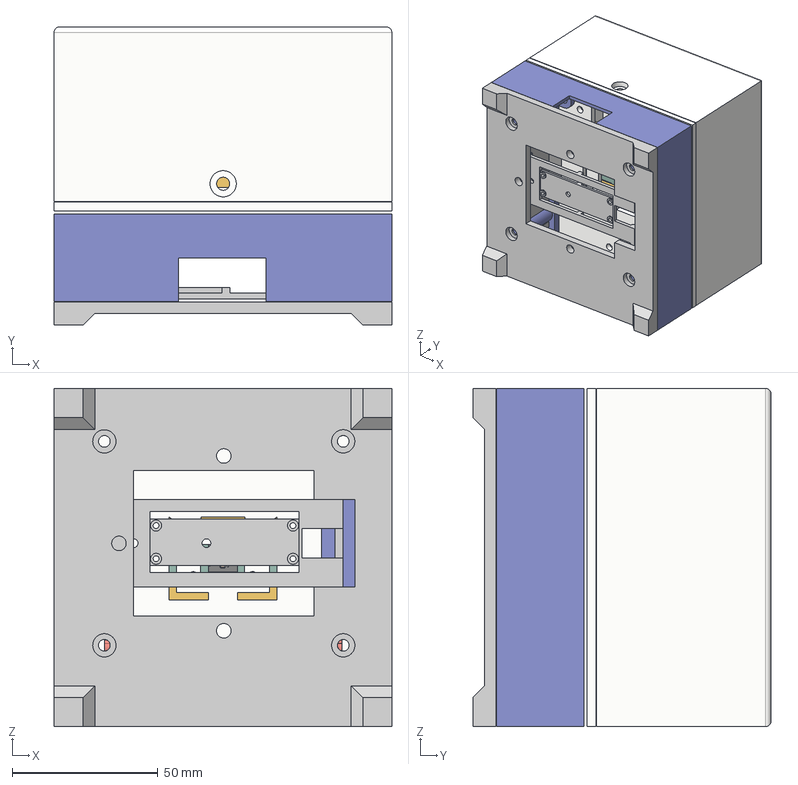
[picture p206: CAD file, 2023-09-16]
src/MagBoardHardware/dual_sensor/CAD/devboard_rotational v2.step
116.0 x 102.4 x 116.1 mm
Printed Circuit Board
DS3502 Potentiometer 10k Ohm v3
LED 0603 single color v1
CAPC-0603-T0.9-BN v1 x 2
RESC-0603 v1
YC164_RESPACK v1
JST SH, 4 Pin v2 x 2
cover
