LFB-MRI/MagneticReadoutProcessing/src/MagBoardHardware/dual_sensor/STL/magnet_base_holder.stl

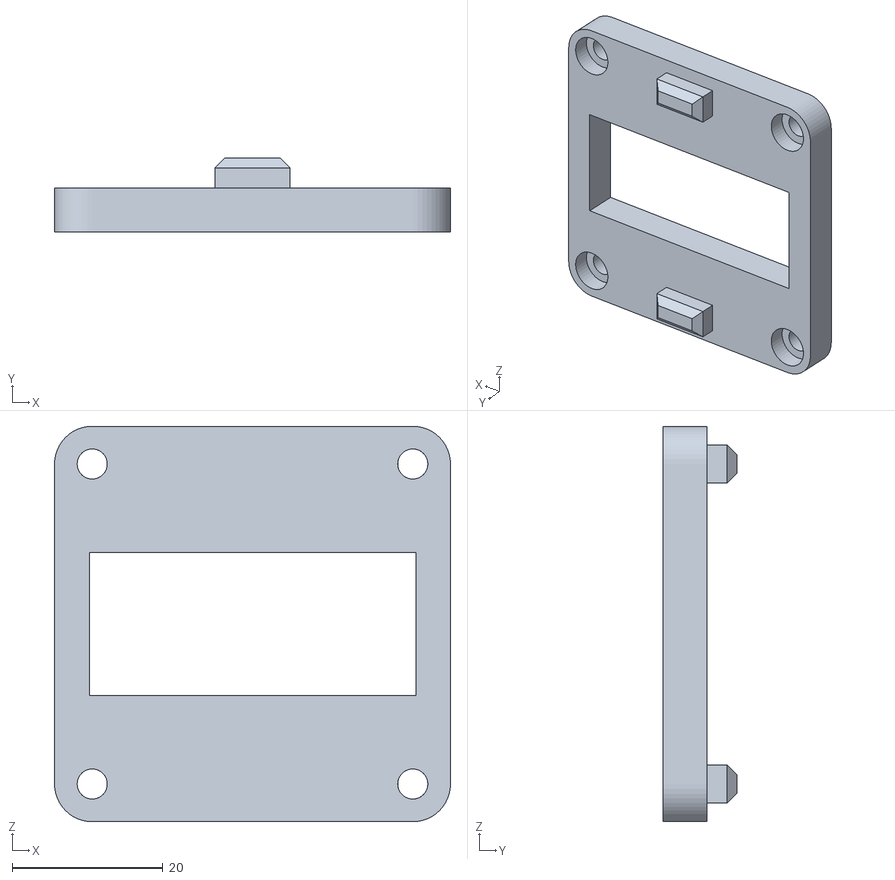
[picture p207: CAD file, 2023-09-16]
src/MagBoardHardware/dual_sensor/STL/magnet_base_holder.stl
52.5 x 9.80 x 52.4
