LFB-MRI/MagneticReadoutProcessing/src/MagBoardHardware/single_sensor/CAD/single_sensor v13.step

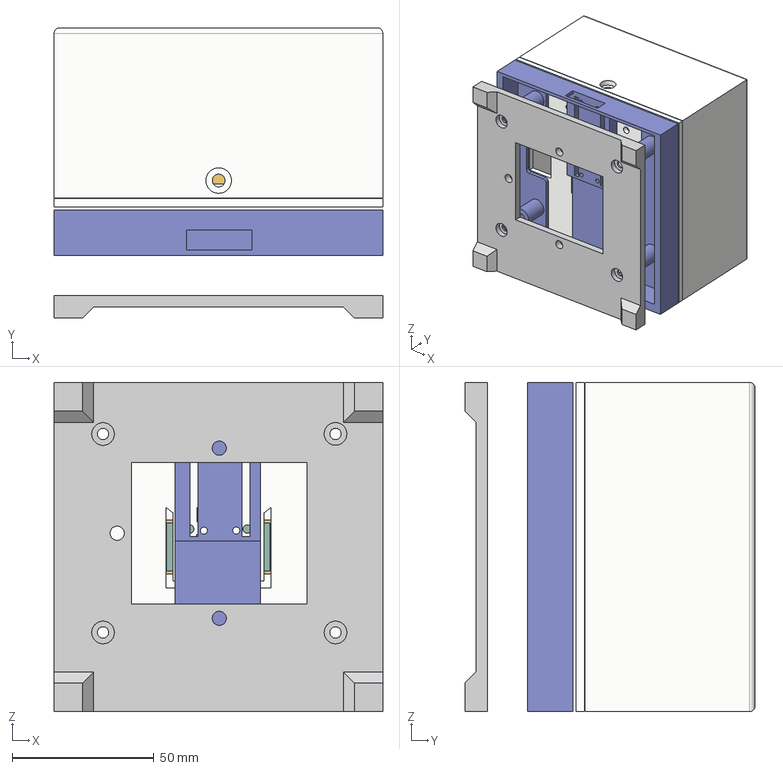
[picture p208: CAD file, 2023-09-16]
src/MagBoardHardware/single_sensor/CAD/single_sensor v13.step
116.0 x 102.4 x 116.1 mm
