LFB-MRI/MagneticReadoutProcessing/src/MagBoardHardware/single_sensor/STL/magnetholder_12x12x12.stl

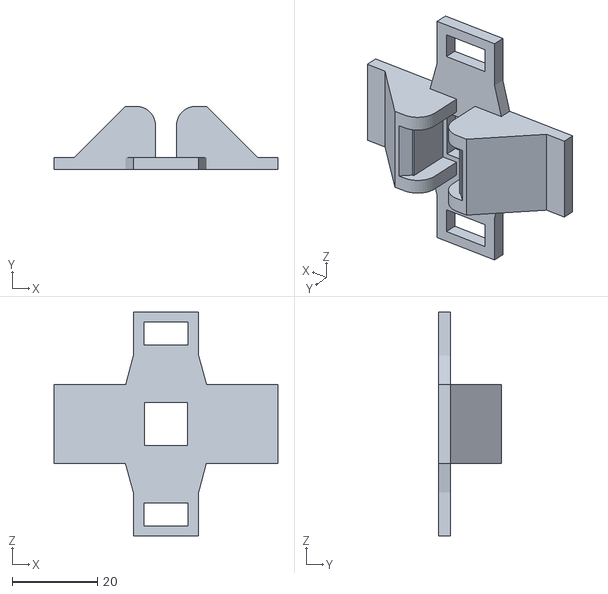
[picture p209: CAD file, 2023-09-16]
src/MagBoardHardware/single_sensor/STL/magnetholder_12x12x12.stl
52.5 x 14.8 x 52.4
