LFB-MRI/MagneticReadoutProcessing/src/MagBoardHardware/dual_sensor/STL/rotational_axis.stl

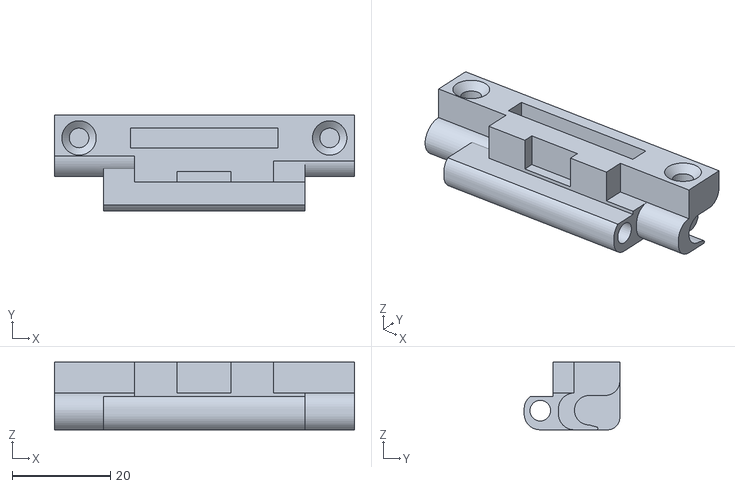
[picture p210: CAD file, 2023-09-16]
src/MagBoardHardware/dual_sensor/STL/rotational_axis.stl
61.1 x 19.5 x 13.8
