LFB-MRI/MagneticReadoutProcessing/src/MagBoardHardware/single_sensor/STL/top_plate.stl

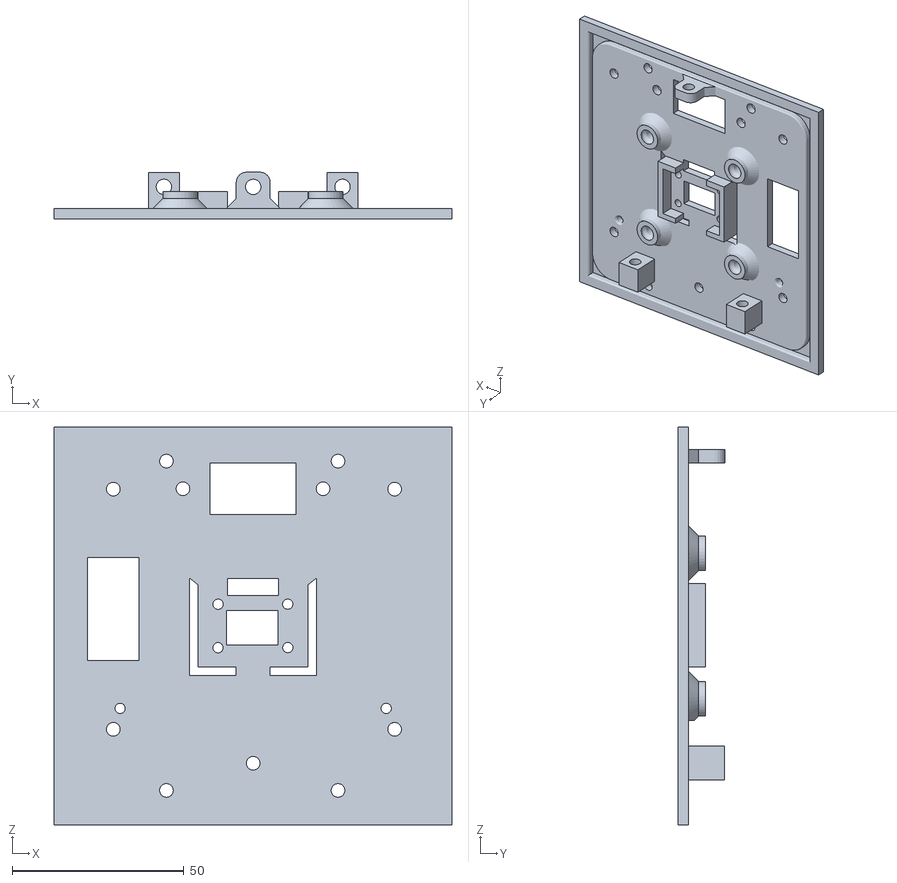
[picture p211: CAD file, 2023-09-16]
src/MagBoardHardware/single_sensor/STL/top_plate.stl
116.0 x 13.6 x 116.0
