LFB-MRI/MagneticReadoutProcessing/src/MagBoardHardware/dual_sensor/STL/cover.stl

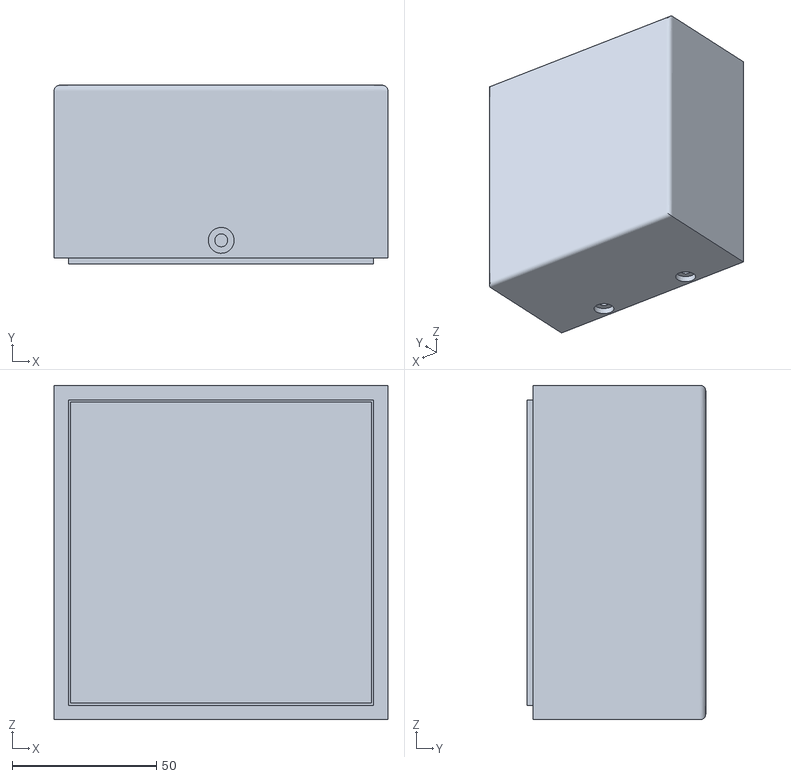
[picture p212: CAD file, 2023-09-16]
src/MagBoardHardware/dual_sensor/STL/cover.stl
115.9 x 62.0 x 116.1
