LFB-MRI/MagneticReadoutProcessing/src/MagBoardHardware/single_sensor/STL/bottom_plate.stl

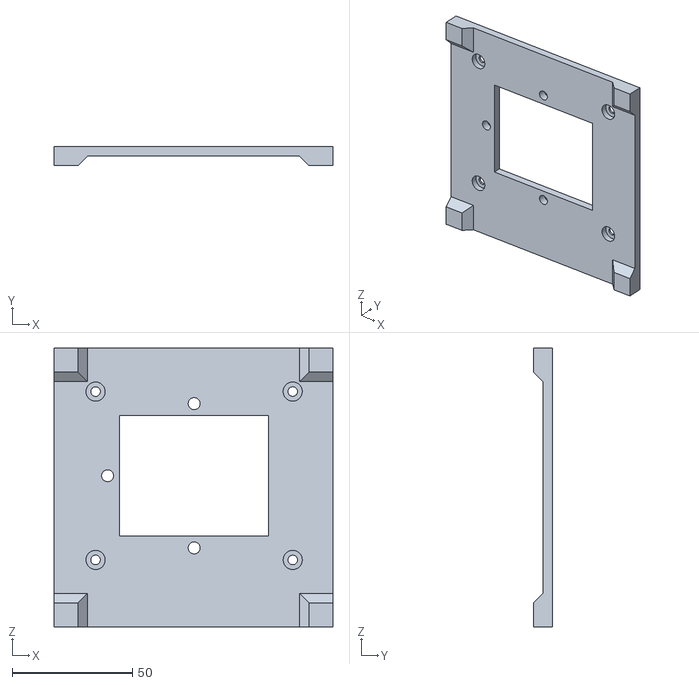
[picture p213: CAD file, 2023-09-16]
src/MagBoardHardware/single_sensor/STL/bottom_plate.stl
116.0 x 8.00 x 116.0
