LFB-MRI/MagneticReadoutProcessing/src/MagBoardHardware/dual_sensor/STL/electric_bay.stl

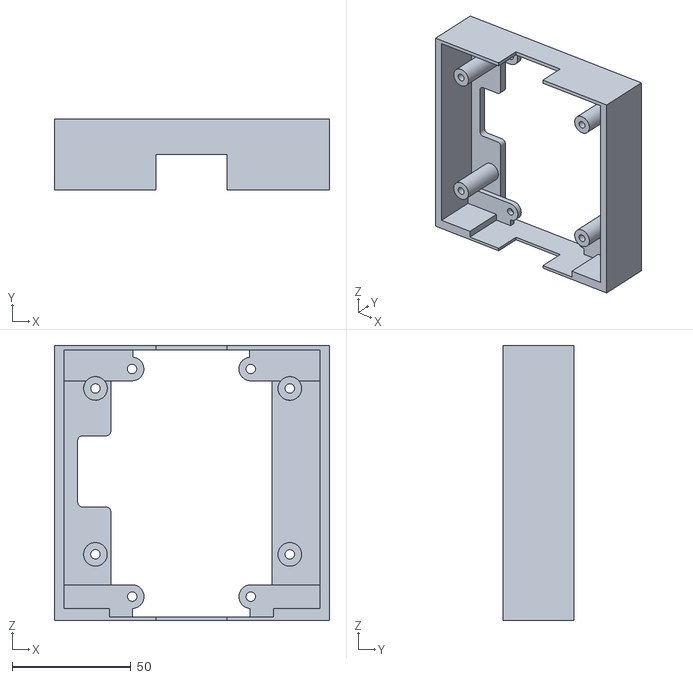
[picture p214: CAD file, 2023-09-16]
src/MagBoardHardware/dual_sensor/STL/electric_bay.stl
116.0 x 30.1 x 116.0
