LFB-MRI/MagneticReadoutProcessing/src/MagBoardHardware/single_sensor/STL/electric_bay.stl

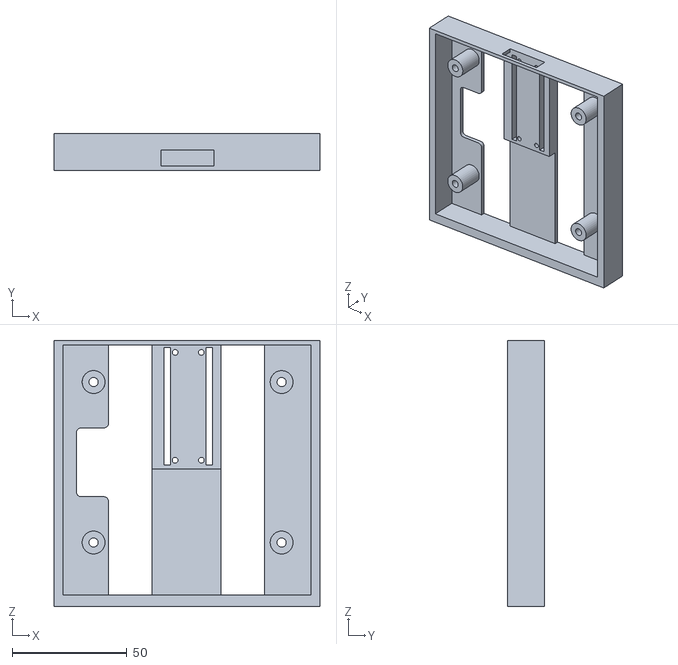
[picture p215: CAD file, 2023-09-16]
src/MagBoardHardware/single_sensor/STL/electric_bay.stl
116.0 x 16.1 x 116.0
