LFB-MRI/MagneticReadoutProcessing/src/MagBoardHardware/dual_sensor/STL/magnet_mount_clamp.stl

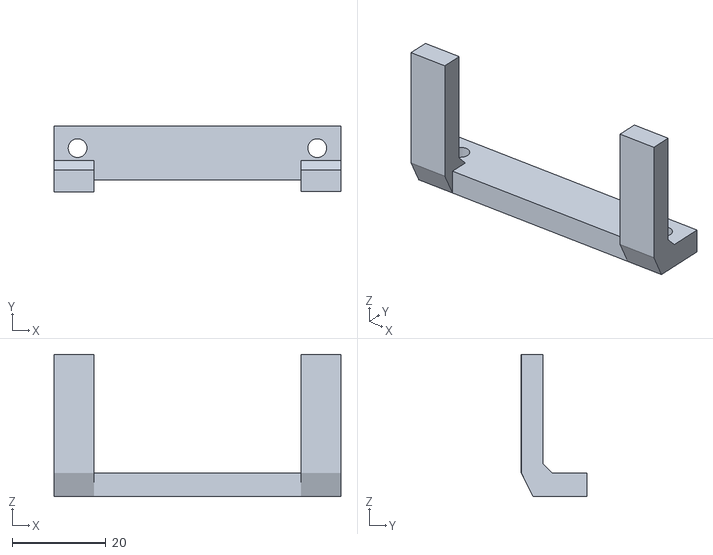
[picture p216: CAD file, 2023-09-16]
src/MagBoardHardware/dual_sensor/STL/magnet_mount_clamp.stl
61.1 x 13.9 x 30.3
