LFB-MRI/MagneticReadoutProcessing/src/MagBoardHardware/single_sensor/STL/magnet_distance_10mm.stl

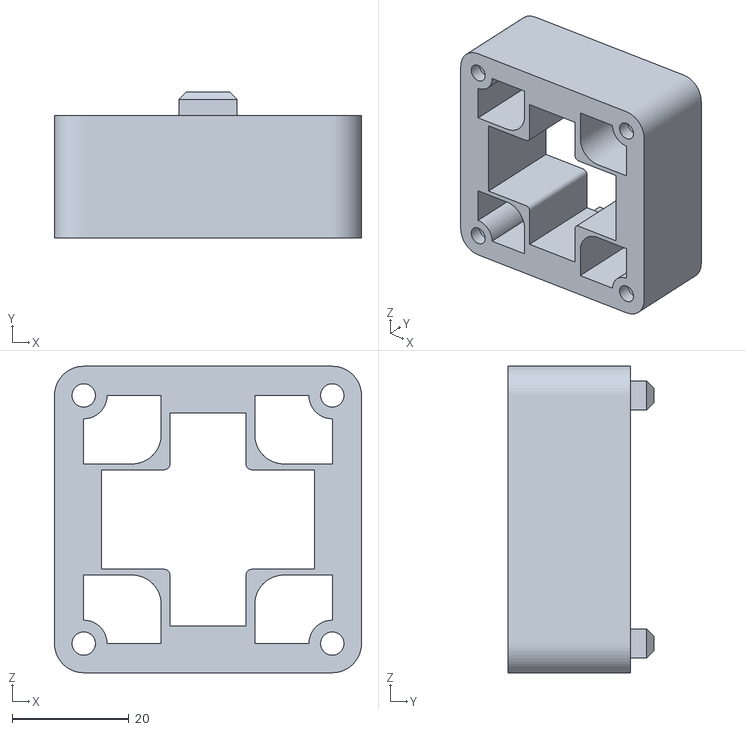
[picture p217: CAD file, 2023-09-16]
src/MagBoardHardware/single_sensor/STL/magnet_distance_10mm.stl
52.5 x 25.0 x 52.4
