LFB-MRI/MagneticReadoutProcessing/src/MagBoardHardware/dual_sensor/STL/electric_mount.stl

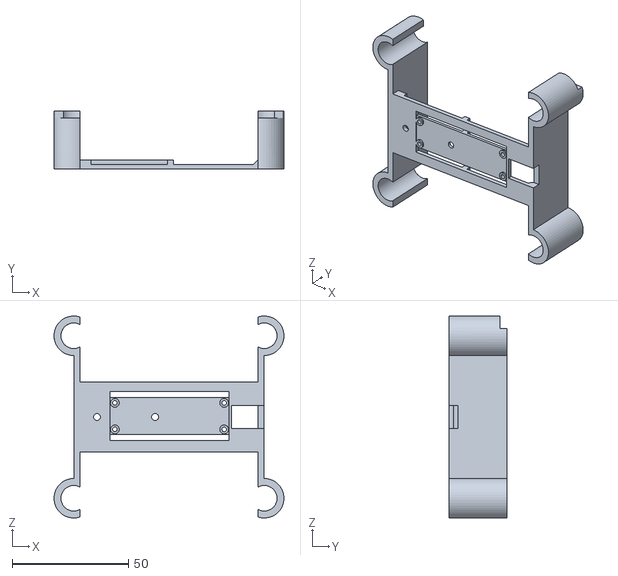
[picture p218: CAD file, 2023-09-16]
src/MagBoardHardware/dual_sensor/STL/electric_mount.stl
98.9 x 25.0 x 86.9
