LFB-MRI/MagneticReadoutProcessing/src/MagBoardHardware/dual_sensor/STL/top_sensor_mount.stl

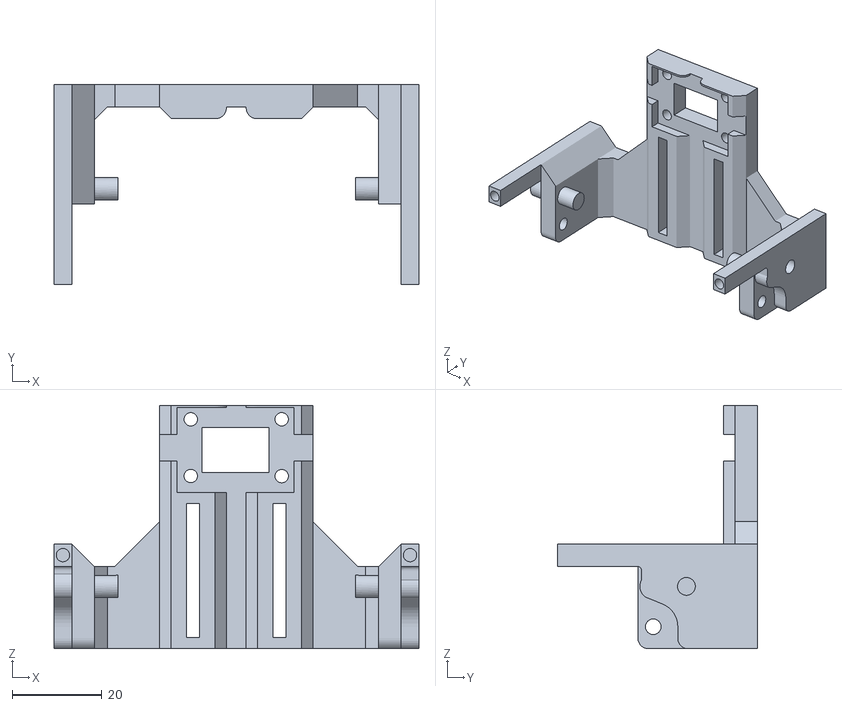
[picture p219: CAD file, 2023-09-16]
src/MagBoardHardware/dual_sensor/STL/top_sensor_mount.stl
81.6 x 44.6 x 54.4
