LFB-MRI/MagneticReadoutProcessing/src/MagBoardHardware/dual_sensor/STL/baseplate_top.stl

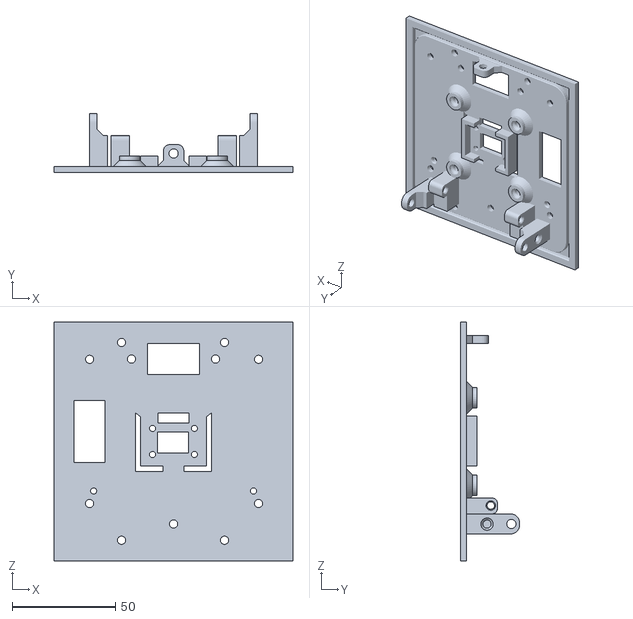
[picture p220: CAD file, 2023-09-16]
src/MagBoardHardware/dual_sensor/STL/baseplate_top.stl
116.0 x 28.8 x 116.0
