LFB-MRI/MagneticReadoutProcessing/(list of files, cad)

Other CAD files:
src/MagBoardHardware/dual_sensor/STL/magnet_mount_12x12x12.stl
src/MagBoardHardware/dual_sensor/STL/baseplate_bottom.stl
src/MagneticReadoutProcessing/tests/tmp/test_generate_1k_hallbach_8_OPENSCAD_3D.scad
src/MagBoardHardware/dual_sensor/CAD/devboard_rotational v2.obj
src/MagBoardHardware/dual_sensor/CAD/devboard_rotational v2.skp
src/MagBoardHardware/dual_sensor/CAD/devboard_rotational v2.stl
src/MagBoardHardware/single_sensor/CAD/single_sensor v13.3mf
src/MagBoardHardware/single_sensor/CAD/single_sensor v13.iges
src/MagBoardHardware/single_sensor/CAD/single_sensor v13.obj
src/MagBoardHardware/single_sensor/CAD/single_sensor v13.skp
src/MagBoardHardware/single_sensor/CAD/single_sensor v13.stl
