LFB-MRI/MagneticReadoutProcessing/documentation/thesis/images/Sensor_evaluation_setup_for_linearity_measurements.png.md

Sensor evaluation setup for linearity measurements. \label{Sensor_evaluation_setup_for_linearity_measurements.png}
