LFB-MRI/MagneticReadoutProcessing/documentation/thesis/images/Sensor_evaluation_setup_for_noise_measurements.png.md

Sensor evaluation setup for noise measurements. \label{Sensor_evaluation_setup_for_noise_measurements.png}
