LFB-MRI/MagneticReadoutProcessing/documentation/thesis/images/Sensor_evaluation_setup_for_temperature_sensitivity_measurements.png.md

Sensor evaluation setup for temperature sensitivity measurements. \label{Sensor_evaluation_setup_for_temperature_sensitivity_measurements.png}
