LFB-MRI/MagneticReadoutProcessing/documentation/thesis/images/Multi_sensor_synchronisation_wiring_example_using_three_sensors_together_with_one_host_(+pc)_performing_the_triggering_and_readout_processing.png

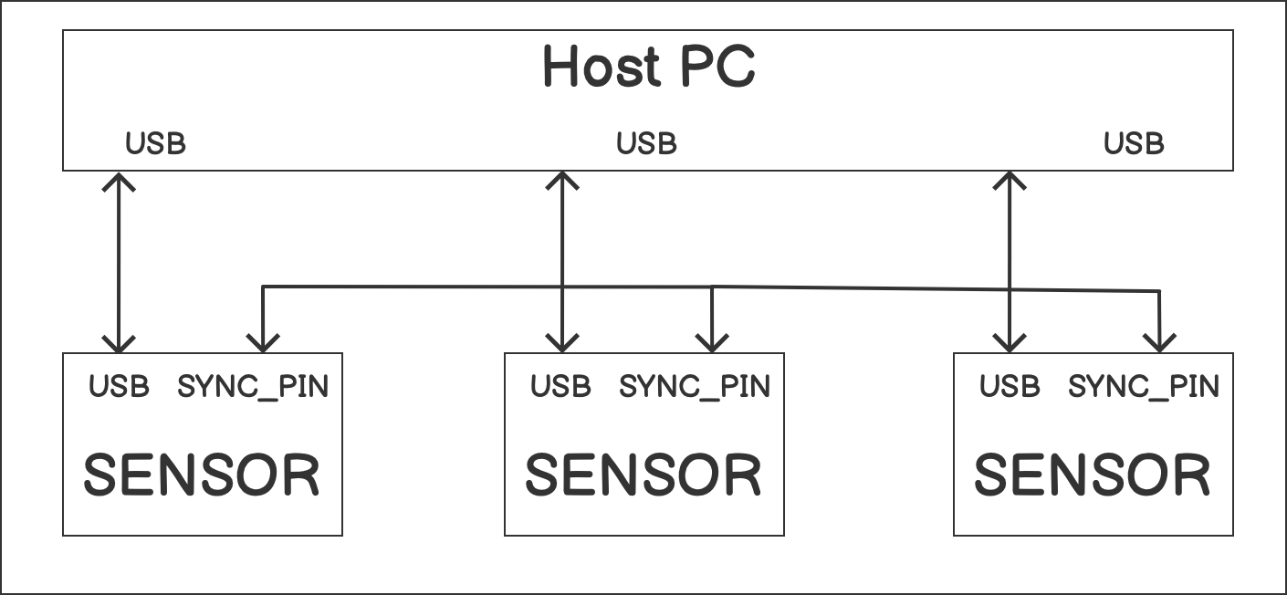
documentation/thesis/images/Multi_sensor_synchronisation_wiring_example_using_three_sensors_together_with_one_host_(+pc)_performing_the_triggering_and_readout_processing.png
