LFB-MRI/MagneticReadoutProcessing/documentation/thesis/images/Sensor_dynamic_range_evaluation_results_for_TLV493D_and_MMC5603NJ/Linearity_outside_of_the_manufacturer_specified_range_of_TLV493D.png

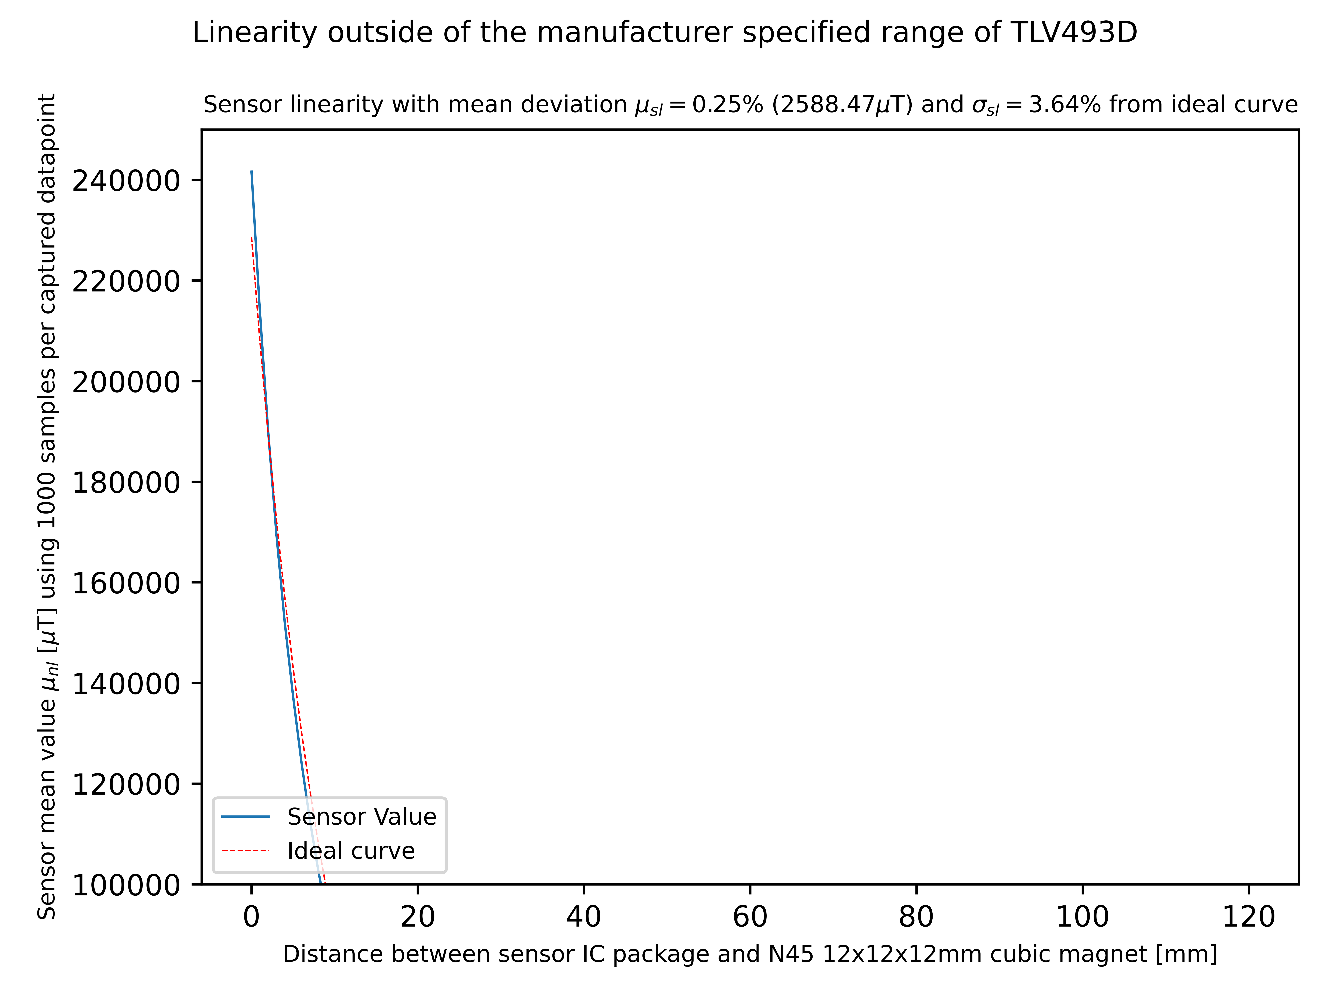
documentation/thesis/images/Sensor_dynamic_range_evaluation_results_for_TLV493D_and_MMC5603NJ/Linearity_outside_of_the_manufacturer_specified_range_of_TLV493D.png
