LFB-MRI/MagneticReadoutProcessing/documentation/thesis/images/Sensor_evaluation_setup_for_linearity_measurements/IMG_8122.JPG

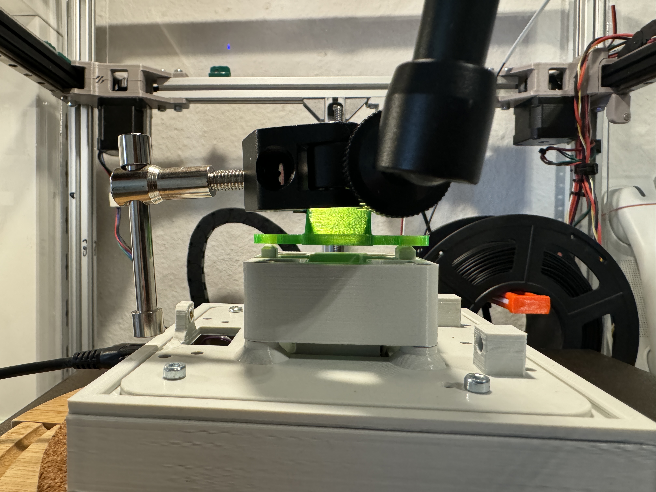
documentation/thesis/images/Sensor_evaluation_setup_for_linearity_measurements/IMG_8122.JPG
