LFB-MRI/MagneticReadoutProcessing/documentation/thesis/images/Sensor_evaluation_setup_for_linearity_measurements/IMG_8123.JPG

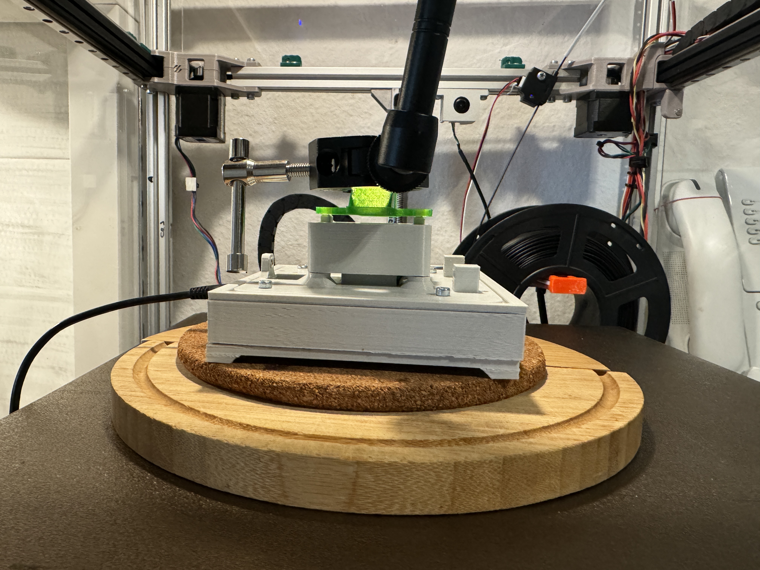
documentation/thesis/images/Sensor_evaluation_setup_for_linearity_measurements/IMG_8123.JPG
