LFB-MRI/MagneticReadoutProcessing/documentation/thesis/images/Ten_numbered_N45_12x12x12mm_test_magnets_in_separate_3D_printed_holders.png

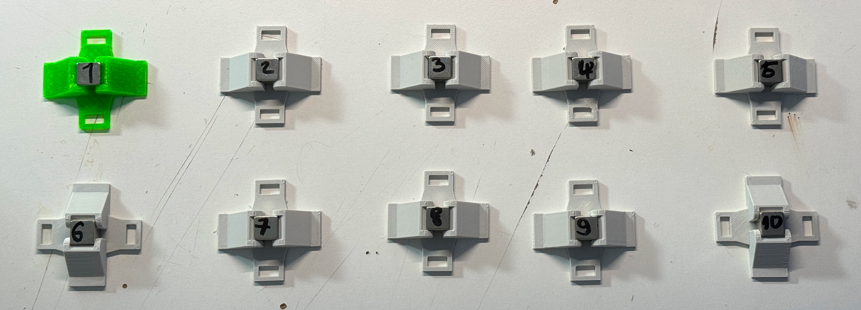
documentation/thesis/images/Ten_numbered_N45_12x12x12mm_test_magnets_in_separate_3D_printed_holders.png
