LFB-MRI/MagneticReadoutProcessing/documentation/thesis/images/Unified_sensor_firmware_multi_sensor_synchronisation_procedure/Sensor_evaluation_setup_for_noise_measurements.drawio.png

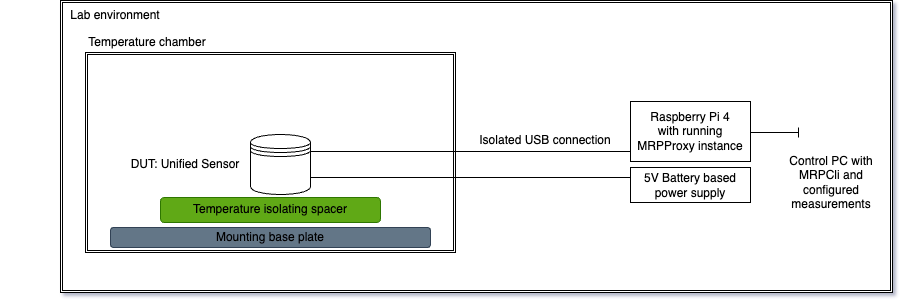
documentation/thesis/images/Unified_sensor_firmware_multi_sensor_synchronisation_procedure/Sensor_evaluation_setup_for_noise_measurements.drawio.png
