LFB-MRI/MagneticReadoutProcessing/documentation/thesis/images/Unified_sensor_firmware_provided_serial_terminal_based_(+cli)_allows_the_user_to_configure_the_sensor_manually.png

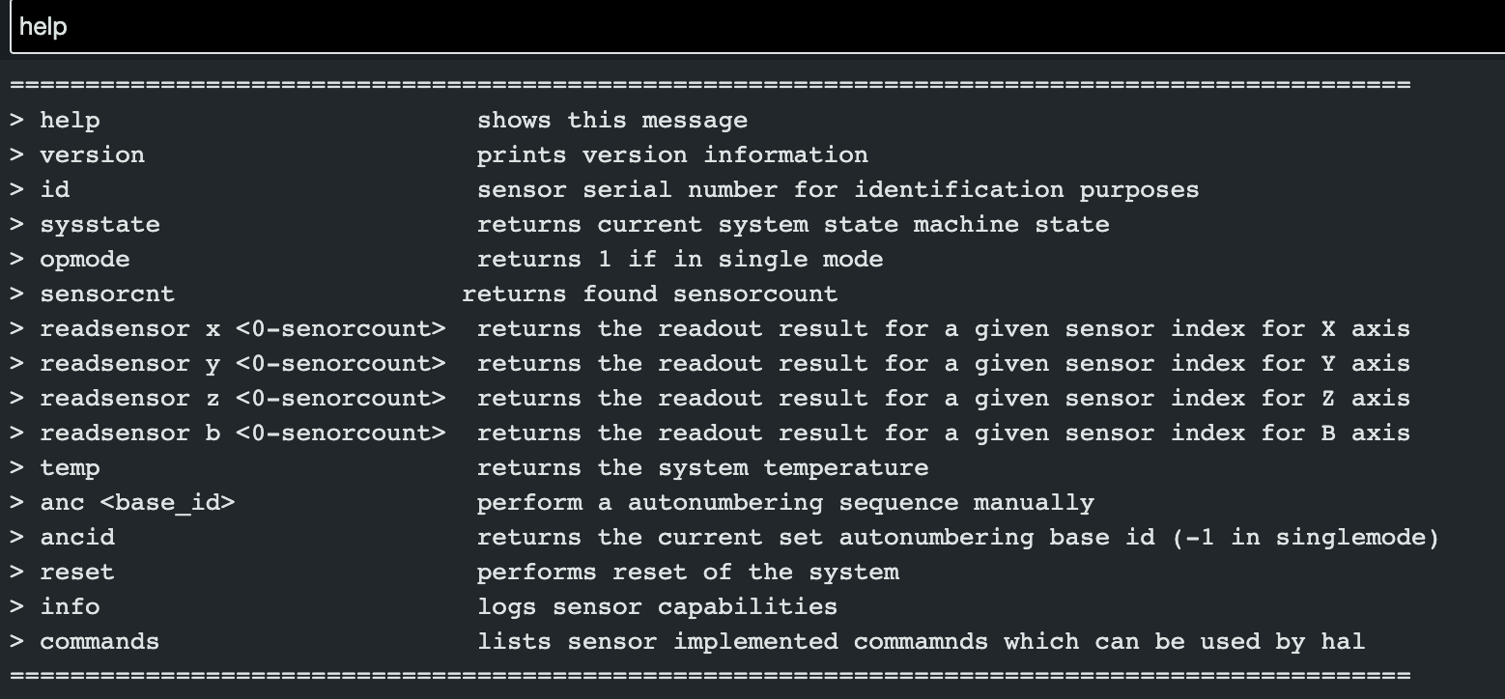
documentation/thesis/images/Unified_sensor_firmware_provided_serial_terminal_based_(+cli)_allows_the_user_to_configure_the_sensor_manually.png
