LFB-MRI/MagneticReadoutProcessing/documentation/thesis/images/Sensor_dynamic_range_evaluation_results_for_TLV493D_and_MMC5603NJ.png.md

Sensor dynamic range evaluation results for TLV493D and MMC5603NJ. \label{Sensor_dynamic_range_evaluation_results_for_TLV493D_and_MMC5603NJ.png}
