LFB-MRI/MagneticReadoutProcessing/documentation/thesis/images/Sensor_linearity_evaluation_results_for_TLV493D_and_MMC5603NJ.png.md

Sensor linearity evaluation results for TLV493D and MMC5603NJ. \label{Sensor_linearity_evaluation_results_for_TLV493D_and_MMC5603NJ.png}
