LFB-MRI/MagneticReadoutProcessing/documentation/thesis/images/Sensor_temperature_sensitivity_evaluation_results_for_TLV493D_and_MMC5603NJ.png.md

Sensor temperature sensitivity evaluation results for TLV493D and MMC5603NJ. \label{Sensor_temperature_sensitivity_evaluation_results_for_TLV493D_and_MMC5603NJ.png}
