LFB-MRI/MagneticReadoutProcessing/documentation/thesis/images/Ten_numbered_test_magnets_in_separate_holders.png.md

Ten numbered test magnets in separate holders \label{Ten_numbered_test_magnets_in_separate_holders.png}
