LFB-MRI/MagneticReadoutProcessing/documentation/thesis/images/_Example_full_sphere_plot_of_an_measurement_using_the_MRPVisualisation_module_using_different_shaded_vertices_on_a_sphere.png.md

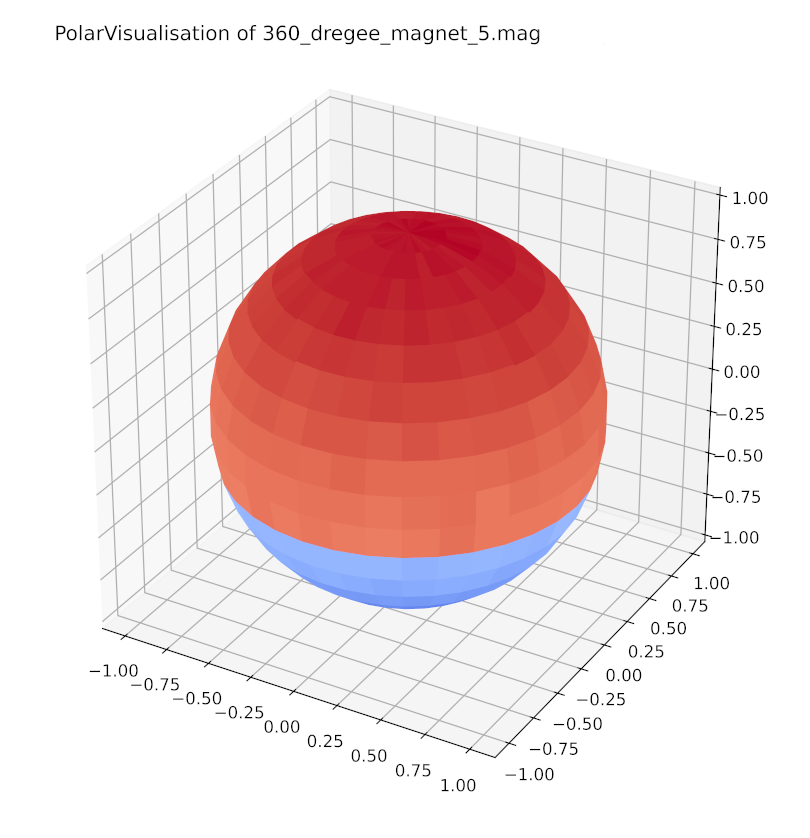
[picture p231: documentation/thesis/generated_images/border__Example_full_sphere_plot_of_an_measurement_using_the_MRPVisualisation_module_using_different_shaded_vertices_on_a_sphere.png]
Example full sphere plot of an measurement using the MRPVisualisation module using different shaded vertices on a sphere. \label{_Example_full_sphere_plot_of_an_measurement_using_the_MRPVisualisation_module_using_different_shaded_vertices_on_a_sphere.png}
