LFB-MRI/MagneticReadoutProcessing/documentation/thesis/images/_MRP_evaluation_result_after_find_similar_values_algorithm_execution_in_the_user_defined_pipeline.png.md

MRP evaluation result after find similar values algorithm execution in the user defined pipeline. \label{_MRP_evaluation_result_after_find_similar_values_algorithm_execution_in_the_user_defined_pipeline.png}
