LFB-MRI/MagneticReadoutProcessing/documentation/thesis/images/example_measurement_analysis_pipeline.png.md

Example measurement analysis pipeline. \label{Example_measurement_analysis_pipeline.png}
