LFB-MRI/MagneticReadoutProcessing/documentation/thesis/images/Pipeline_output_files_and example_results_combined_into_one_plot_after_running_example_pipeline_on_a_set_of_readings.png.md

Pipeline output files and example results combined into one plot after running example pipeline on a set of readings \label{Pipeline_output_files_and example_results_combined_into_one_plot_after_running_example_pipeline_on_a_set_of_readings.png}
