LFB-MRI/MagneticReadoutProcessing/documentation/colloquium/demo/measurements/IDXX_error.png

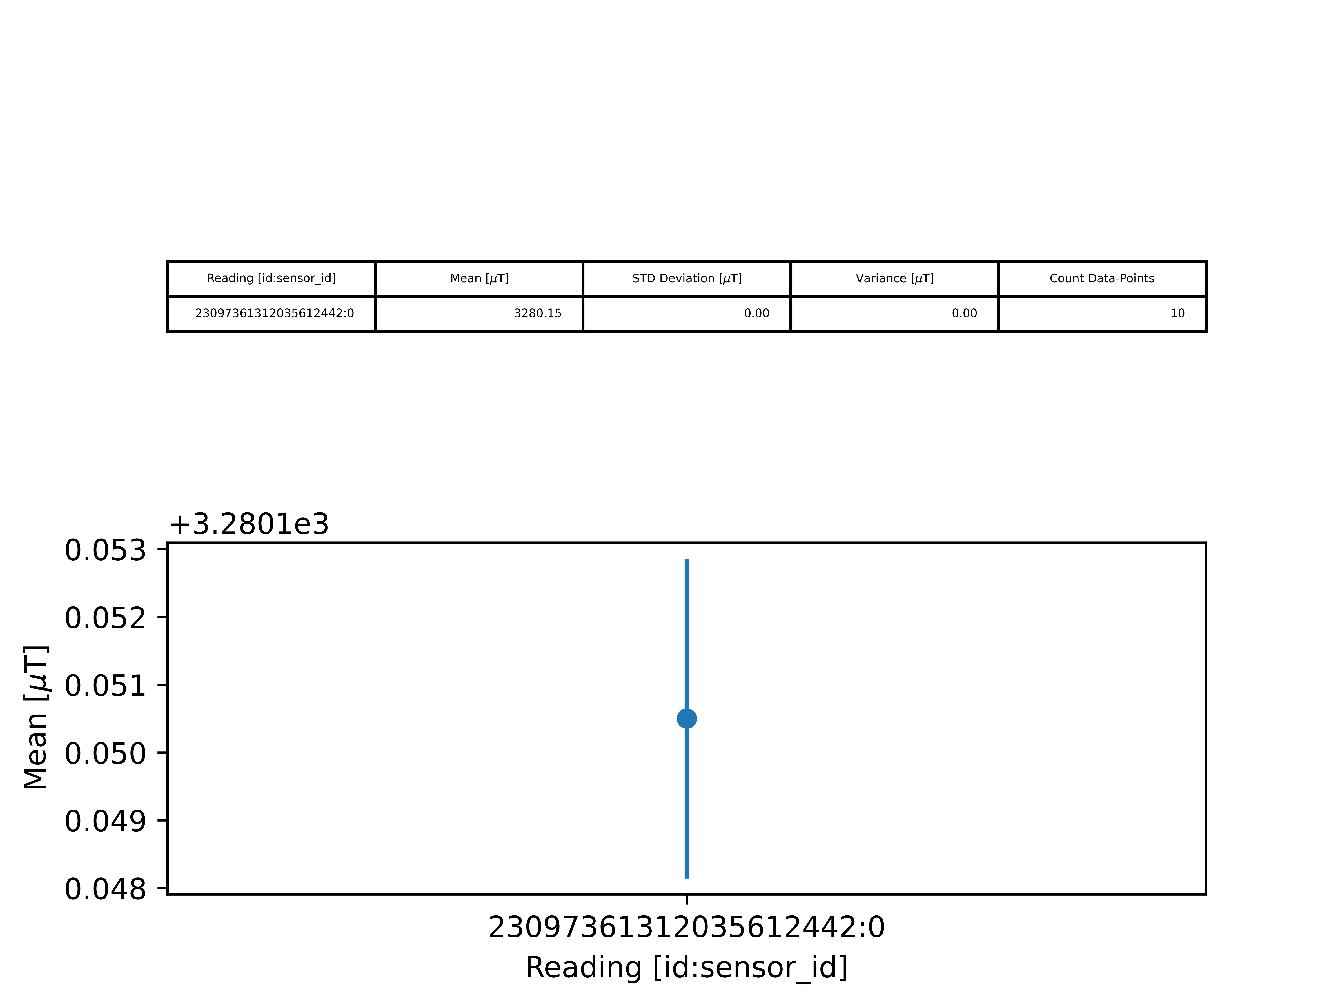
documentation/colloquium/demo/measurements/IDXX_error.png
