LFB-MRI/MagneticReadoutProcessing/documentation/colloquium/demo/measurements/IDXX_scatter.png

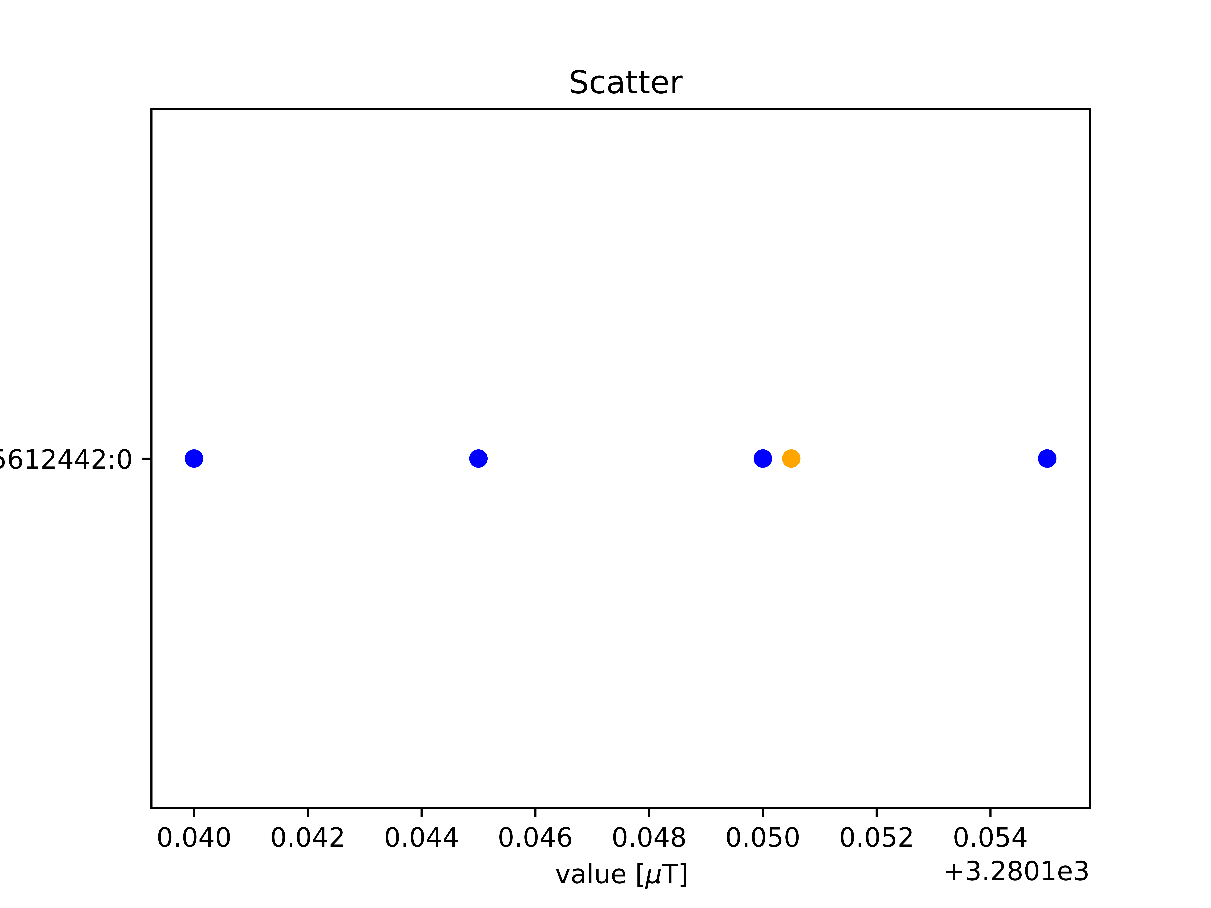
documentation/colloquium/demo/measurements/IDXX_scatter.png
