LFB-MRI/MagneticReadoutProcessing/documentation/colloquium/demo/measurements/IDXX_temperature.png

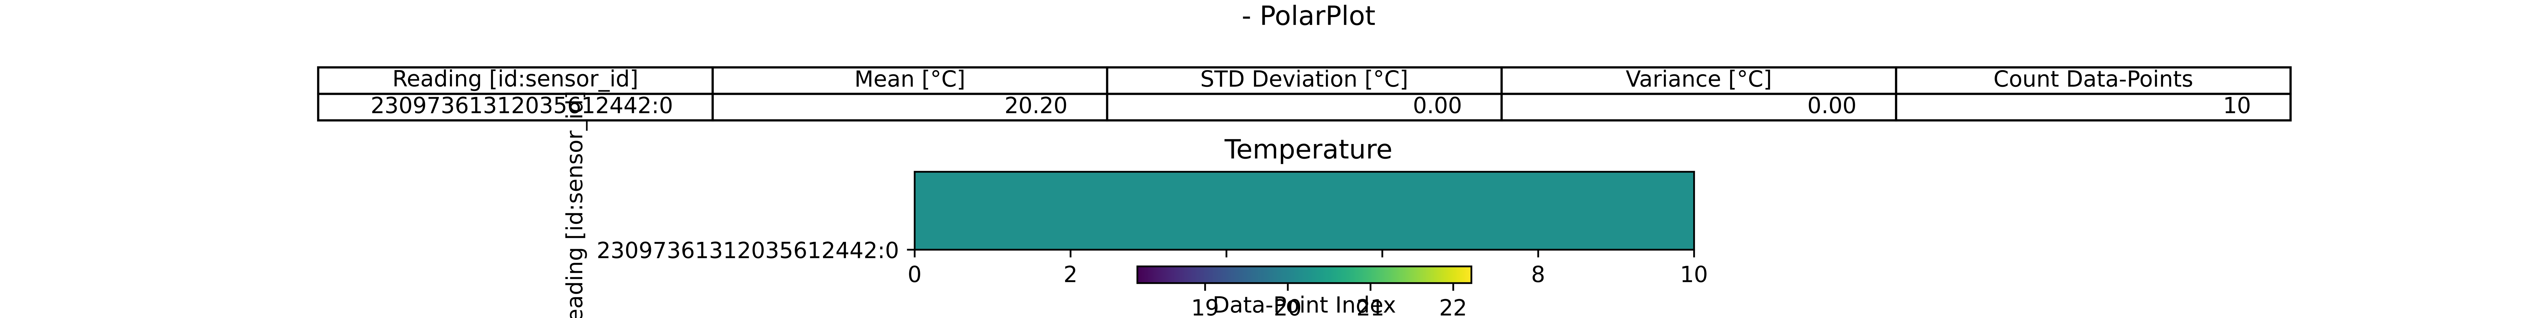
documentation/colloquium/demo/measurements/IDXX_temperature.png
