LFB-MRI/MagneticReadoutProcessing/documentation/colloquium/demo/results/bias/error_plot_pipeline_bias.png

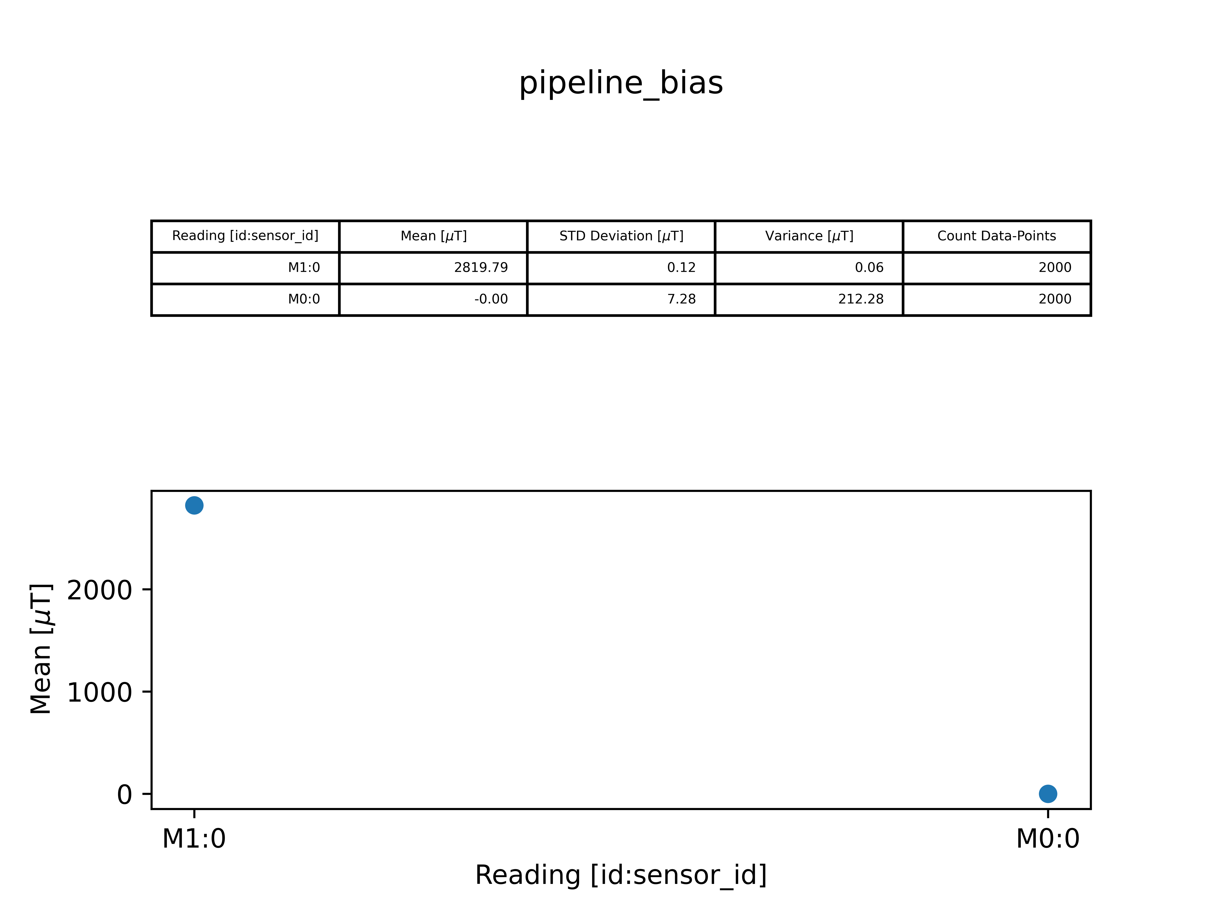
documentation/colloquium/demo/results/bias/error_plot_pipeline_bias.png
