LFB-MRI/MagneticReadoutProcessing/documentation/colloquium/demo/results/bias/scatter_plot_pipeline_bias.png

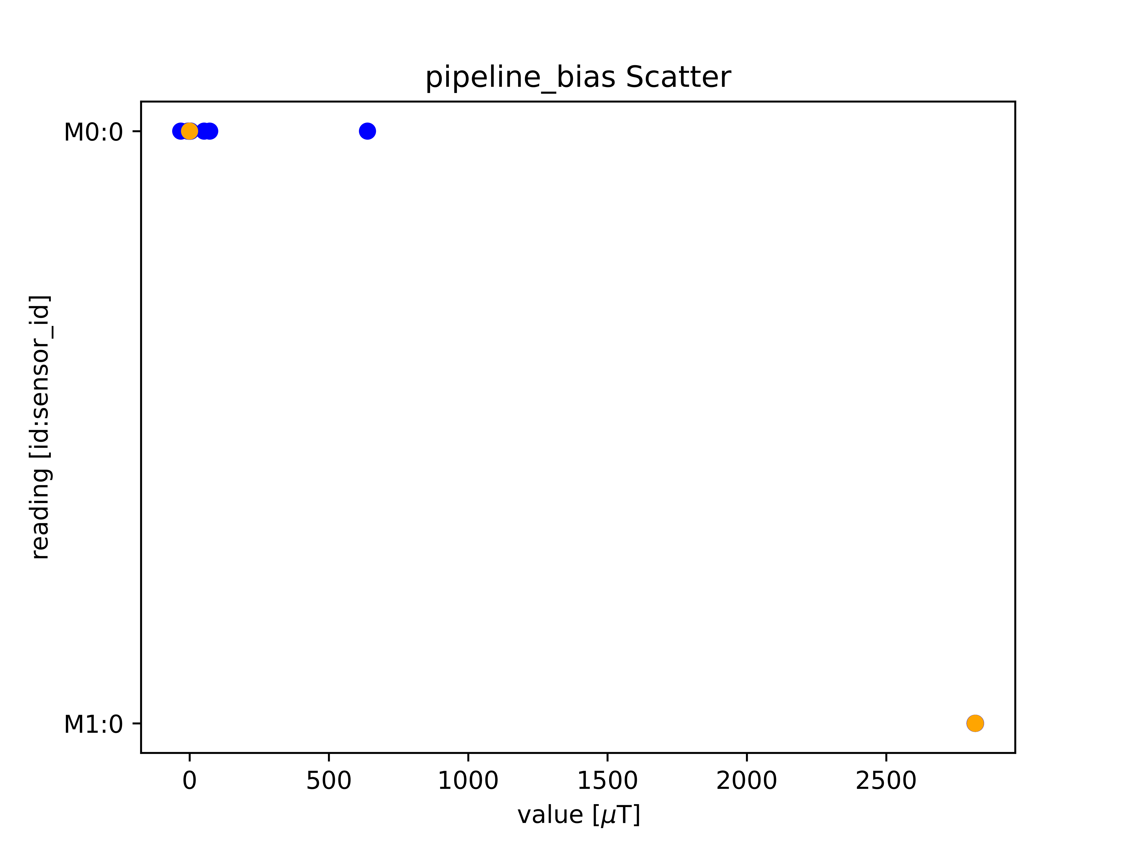
documentation/colloquium/demo/results/bias/scatter_plot_pipeline_bias.png
