LFB-MRI/MagneticReadoutProcessing/documentation/colloquium/demo/results/filter/error_plot_pipeline_filtered.png

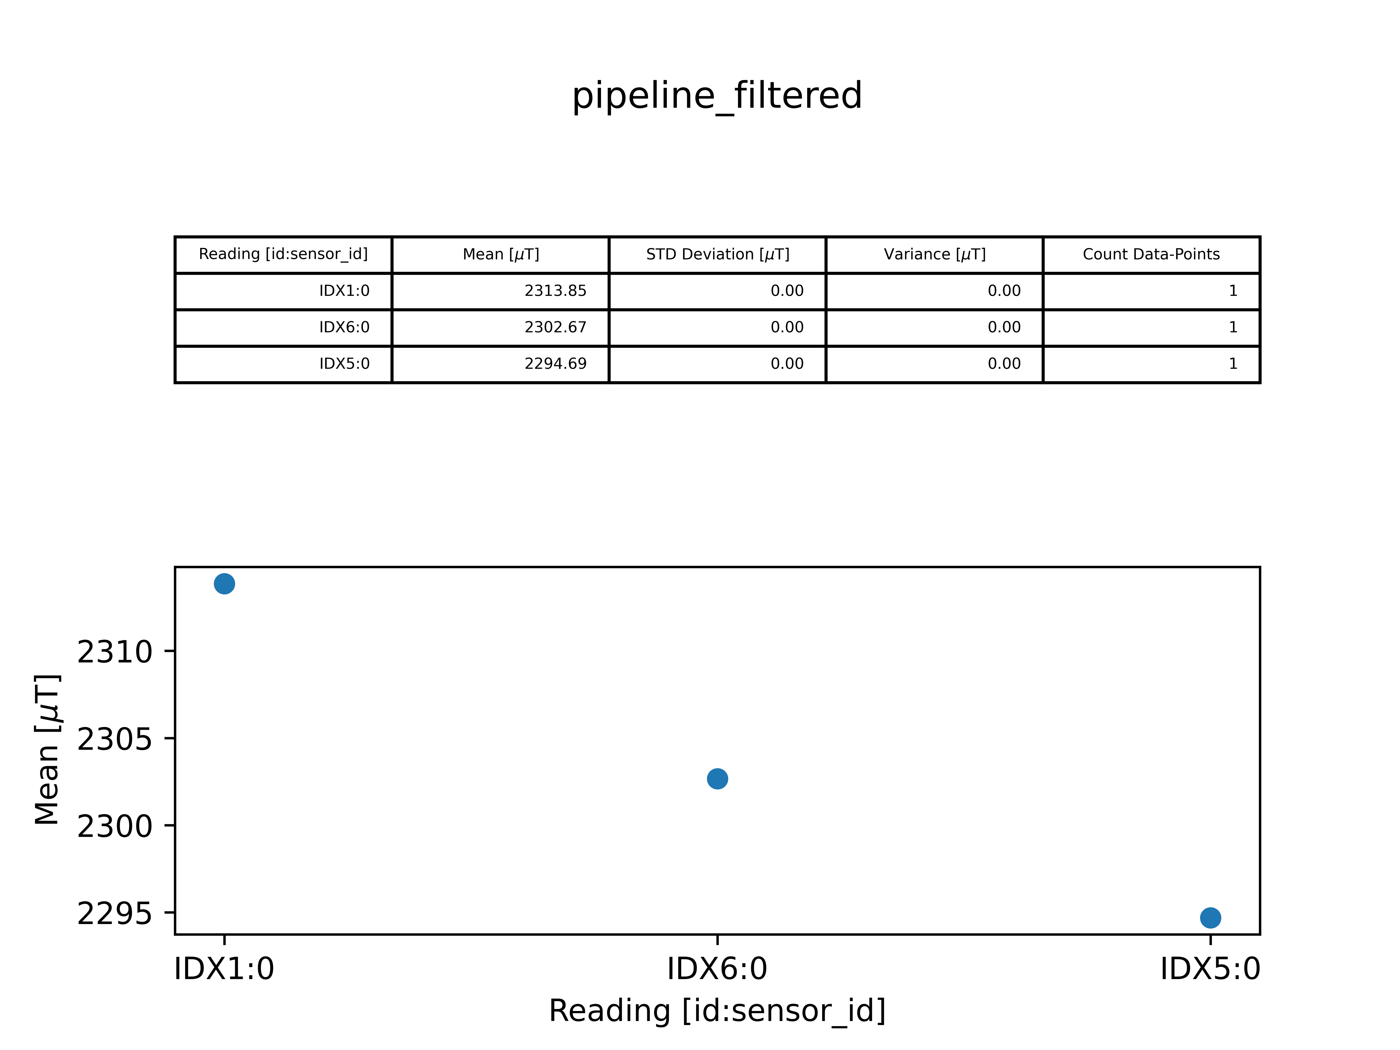
documentation/colloquium/demo/results/filter/error_plot_pipeline_filtered.png
