LFB-MRI/MagneticReadoutProcessing/documentation/colloquium/demo/results/filter/error_plot_pipeline_input_readings.png

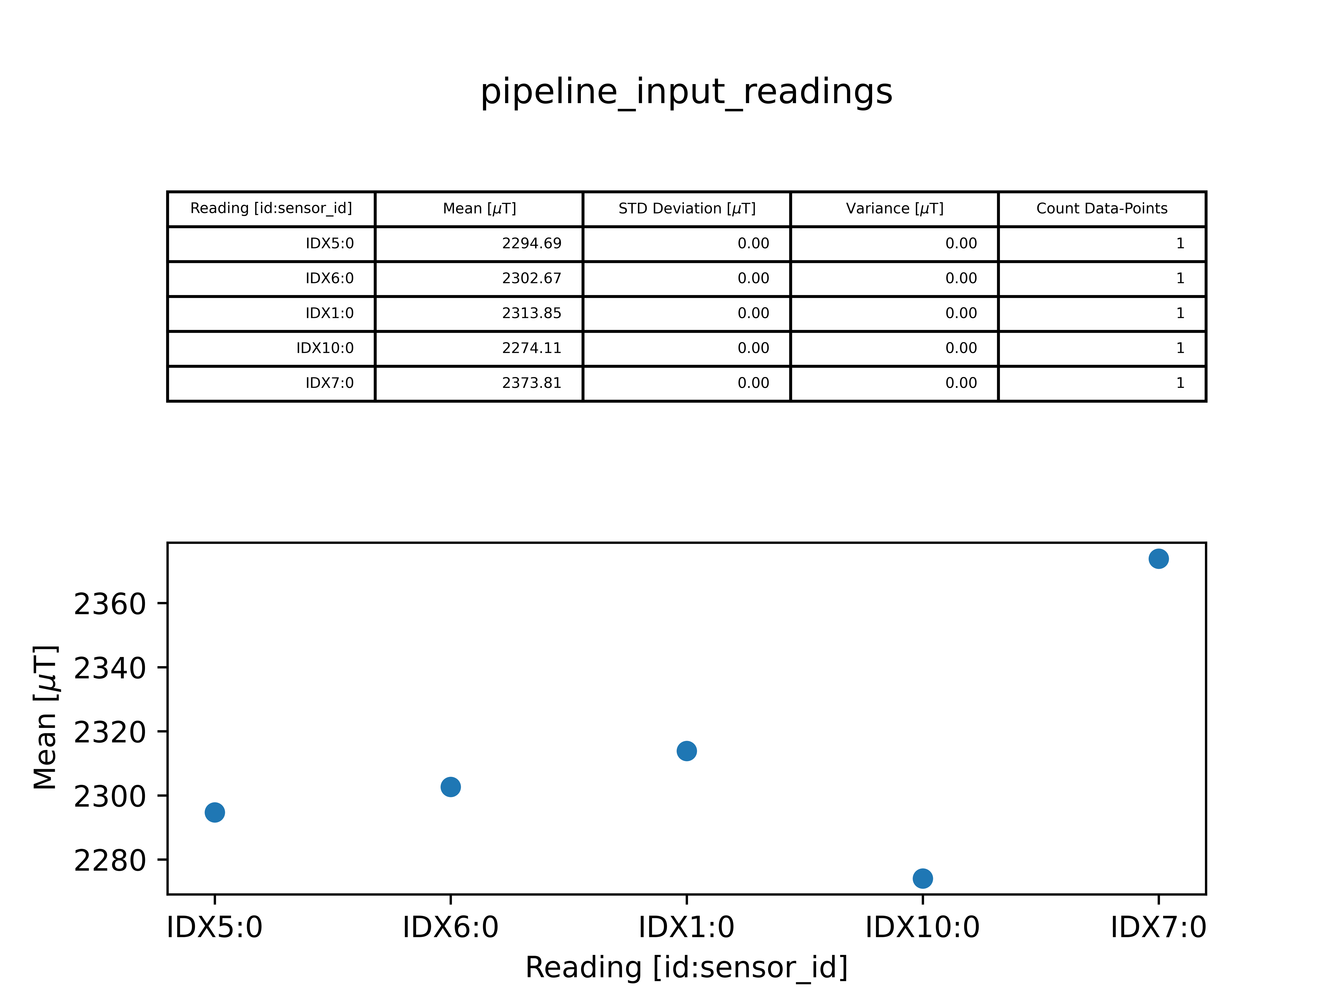
documentation/colloquium/demo/results/filter/error_plot_pipeline_input_readings.png
