LFB-MRI/MagneticReadoutProcessing/documentation/colloquium/demo/results/filter/scatter_plot_pipeline_filtered.png

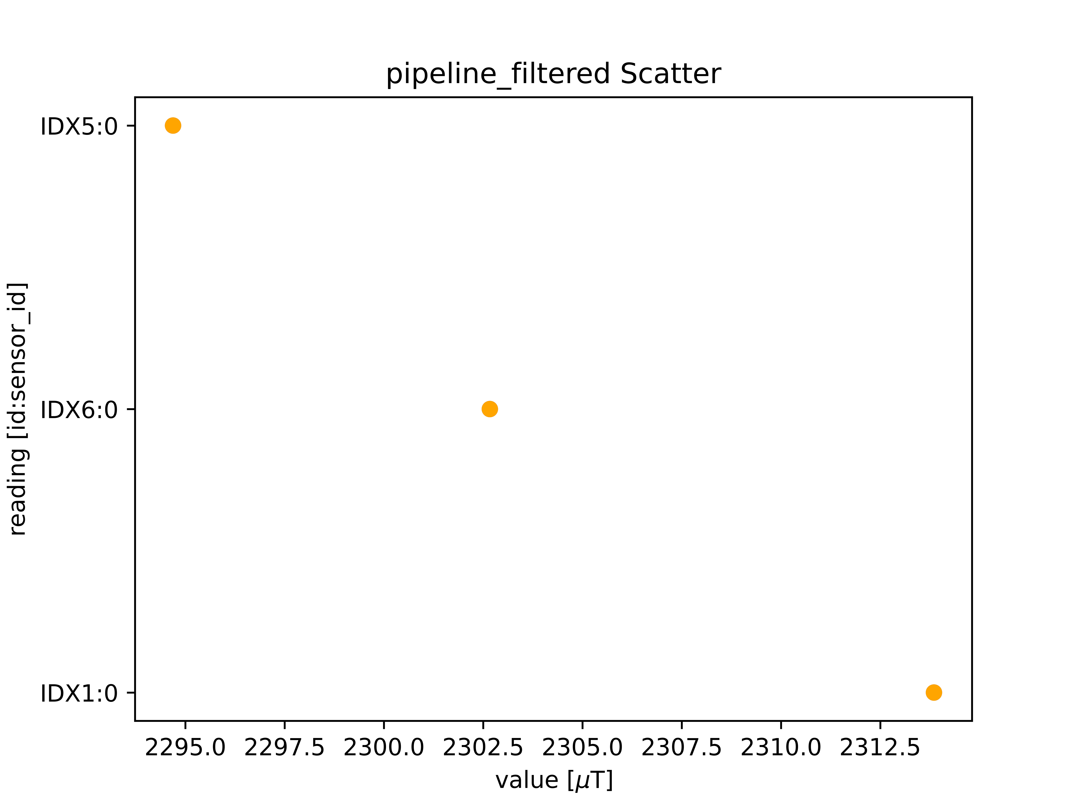
documentation/colloquium/demo/results/filter/scatter_plot_pipeline_filtered.png
