LFB-MRI/MagneticReadoutProcessing/documentation/colloquium/demo/results/filter/scatter_plot_pipeline_input_readings.png

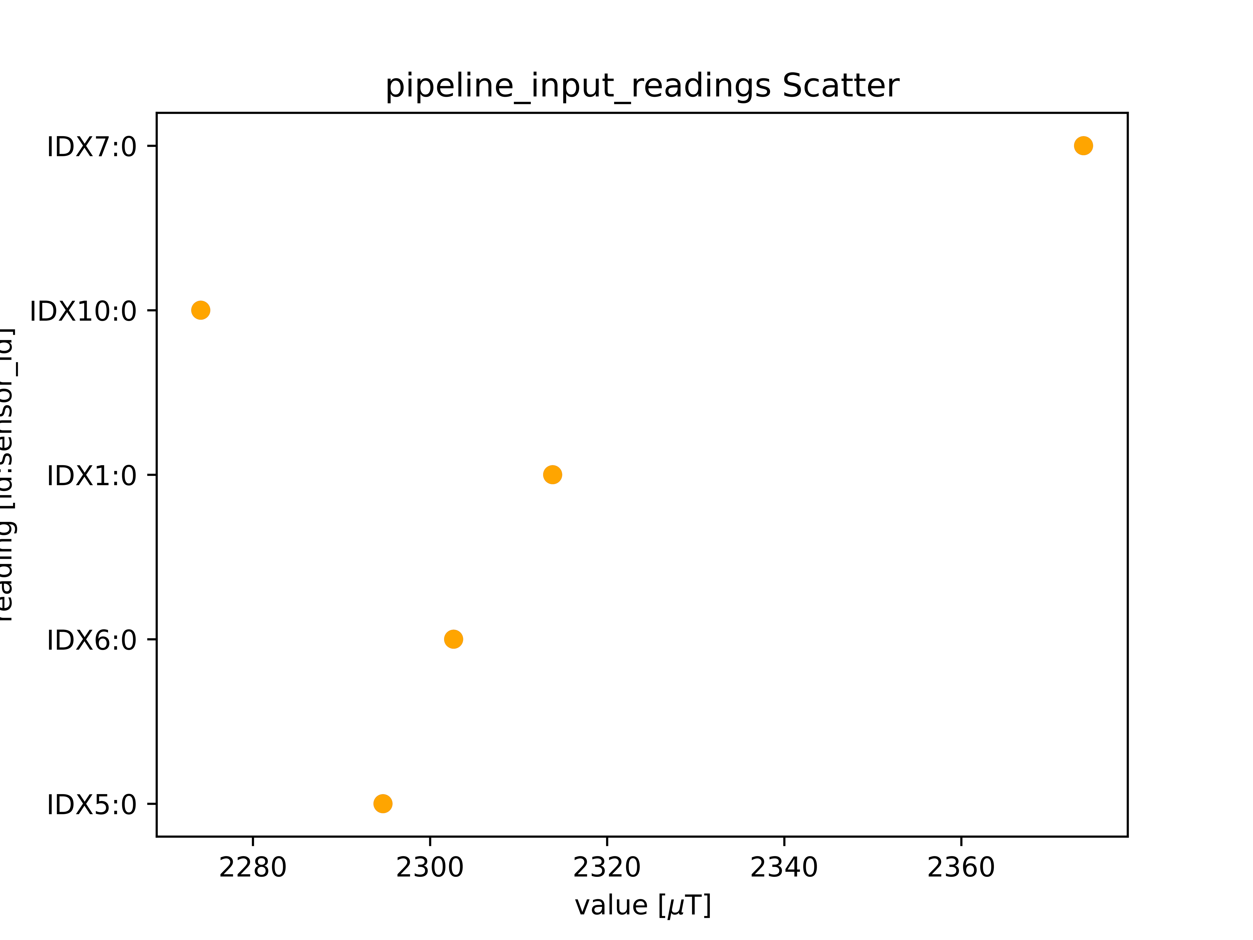
documentation/colloquium/demo/results/filter/scatter_plot_pipeline_input_readings.png
