LFB-MRI/MagneticReadoutProcessing/documentation/thesis/images/Example_full_sphere_plot_of_an_measurement_using_the_MRPVisualisation_module/Example_full_sphere_plot_of_an_measurement_using_the_MRPVisualisation_module.png

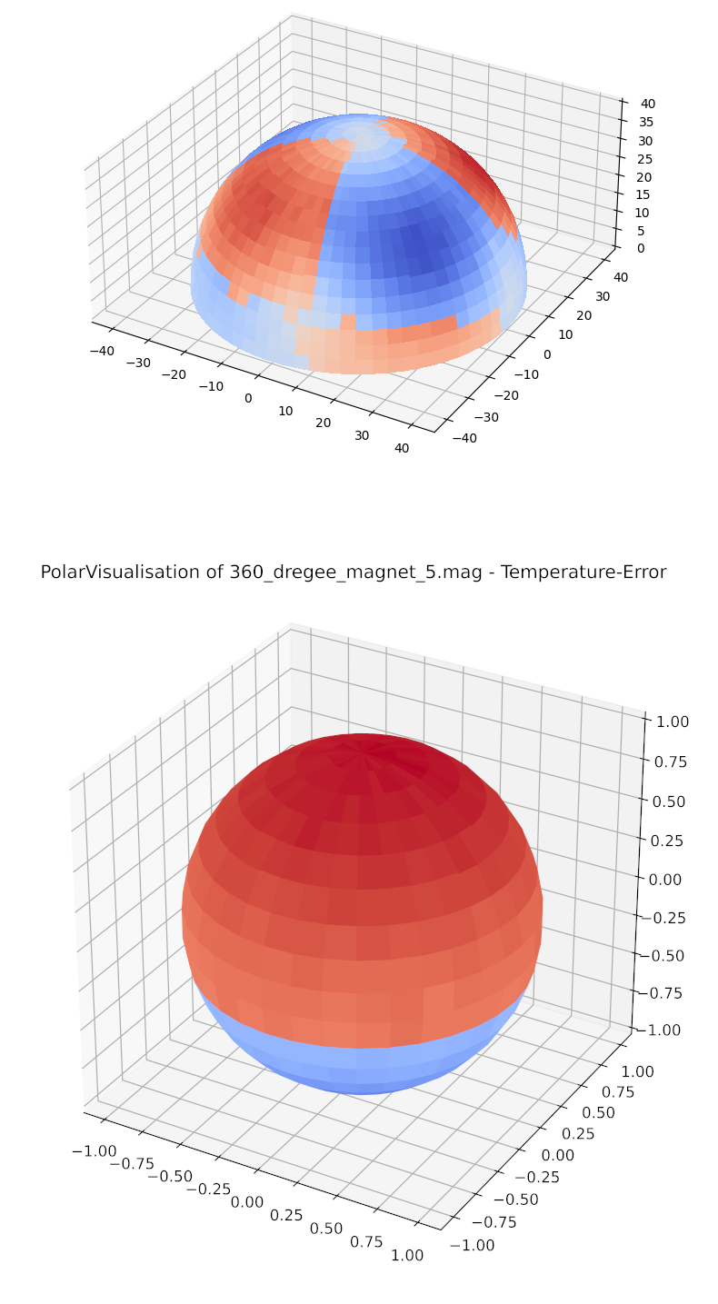
documentation/thesis/images/Example_full_sphere_plot_of_an_measurement_using_the_MRPVisualisation_module/Example_full_sphere_plot_of_an_measurement_using_the_MRPVisualisation_module.png
