LFB-MRI/MagneticReadoutProcessing/documentation/thesis/images/MRP_(+cli)_output_to_configure_a_new_measurement.png

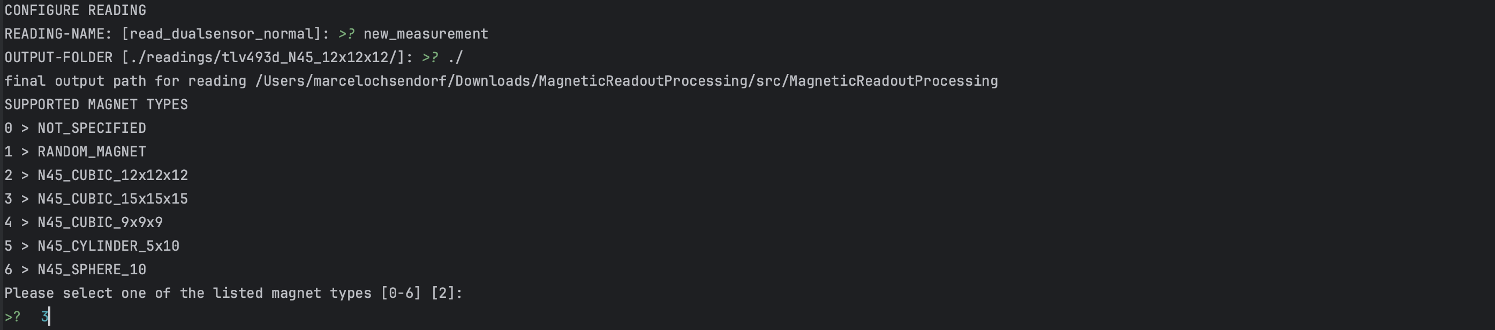
documentation/thesis/images/MRP_(+cli)_output_to_configure_a_new_measurement.png
