LFB-MRI/MagneticReadoutProcessing/documentation/thesis/images/MRP_evaluation_result_after_find_similar_values_algorithm_execution_in_the_user_defined_pipeline.png

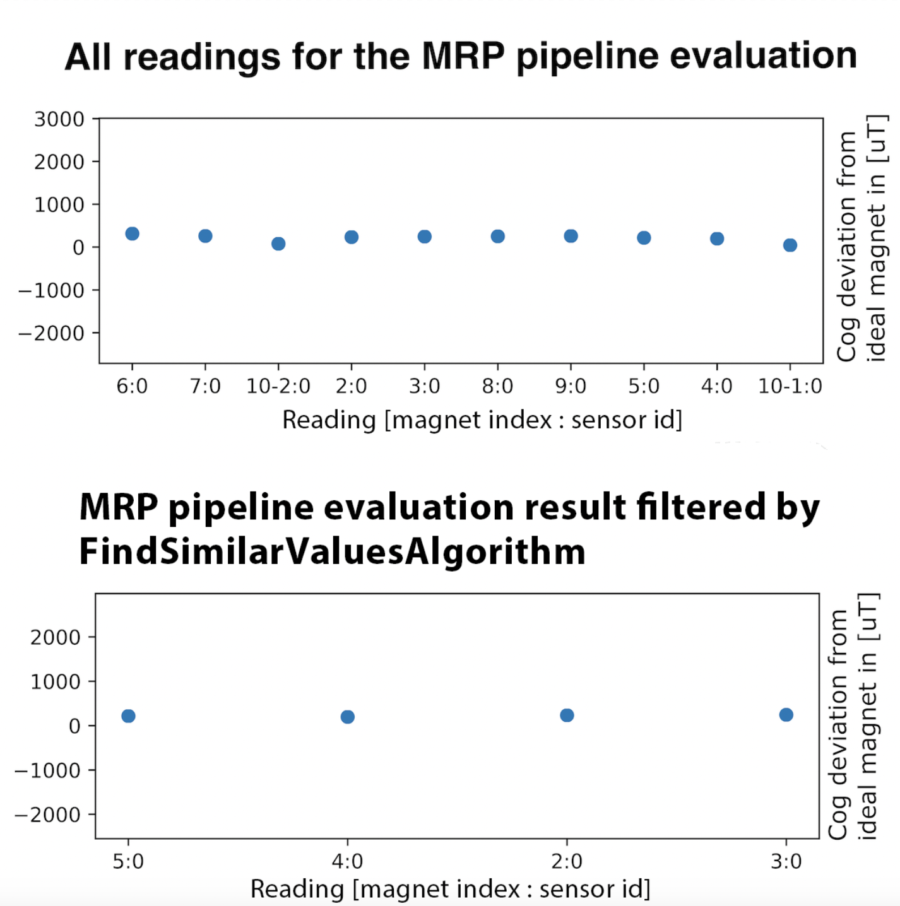
documentation/thesis/images/MRP_evaluation_result_after_find_similar_values_algorithm_execution_in_the_user_defined_pipeline.png
