LFB-MRI/MagneticReadoutProcessing/documentation/thesis/images/MRP_evaluation_results/error_plot_MRP evaluation - raw.png

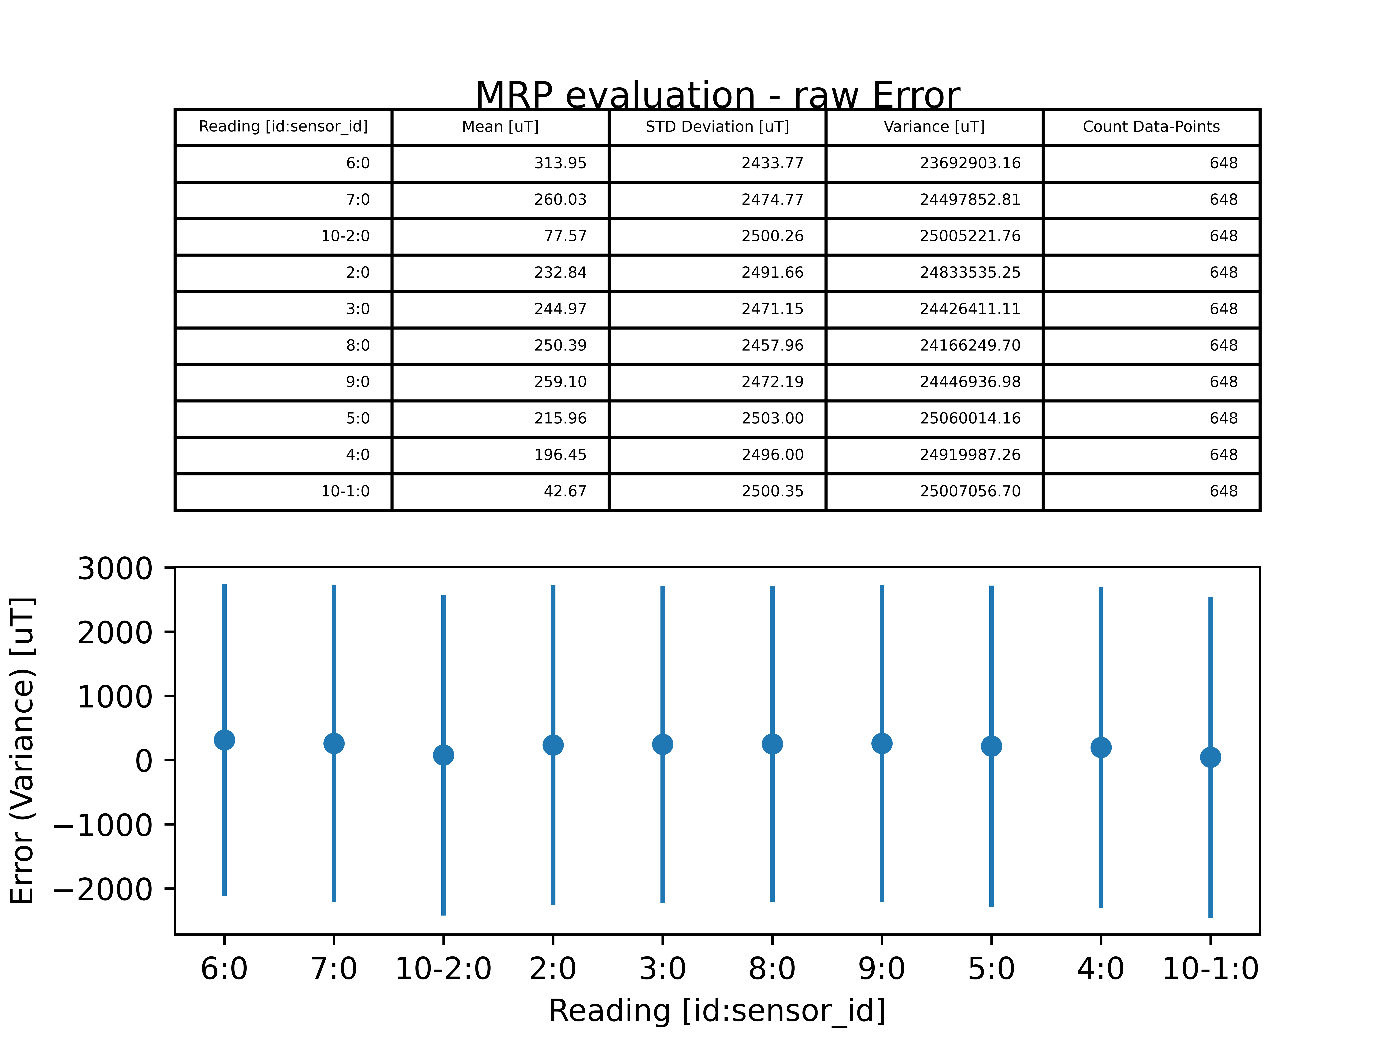
documentation/thesis/images/MRP_evaluation_results/error_plot_MRP evaluation - raw.png
