LFB-MRI/MagneticReadoutProcessing/documentation/thesis/images/MRP_evaluation_results/MRP_evaluation_result.png

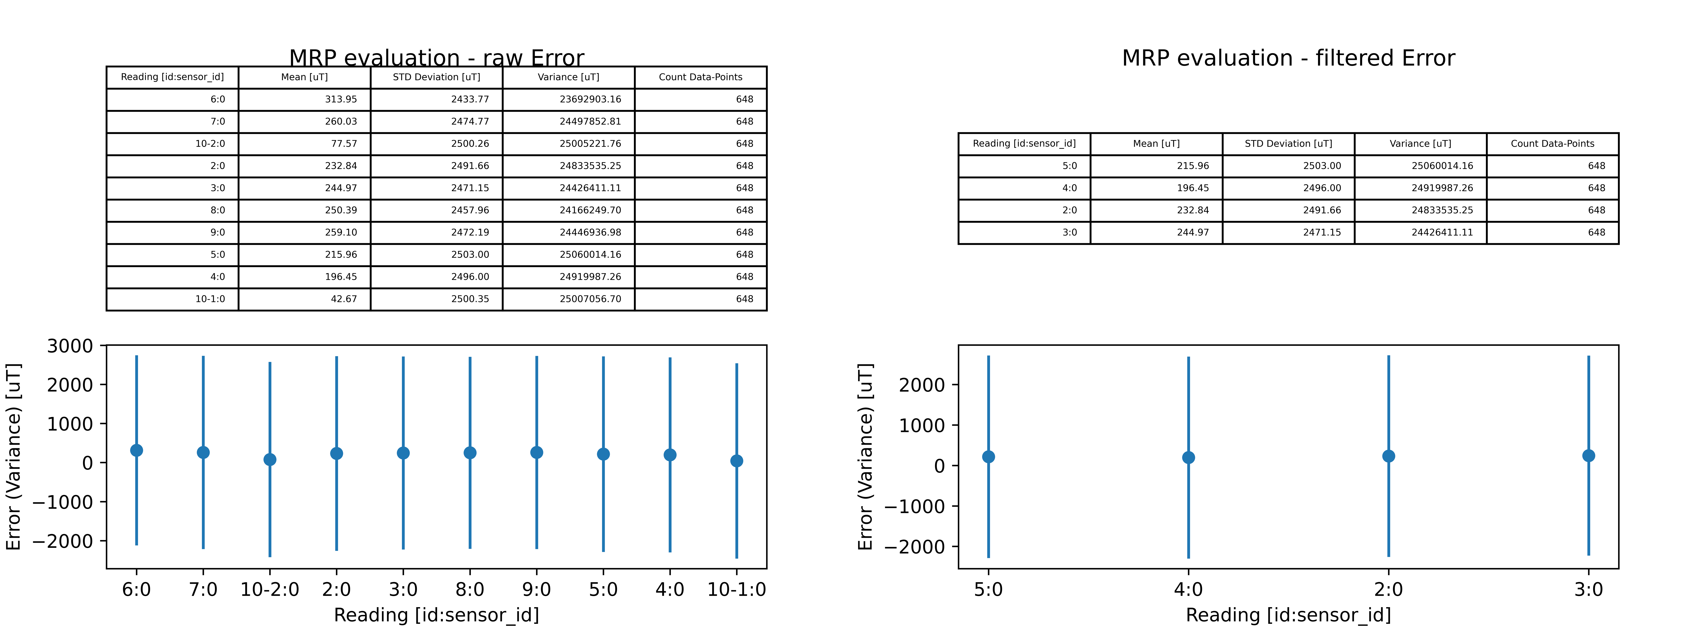
documentation/thesis/images/MRP_evaluation_results/MRP_evaluation_result.png
