LFB-MRI/MagneticReadoutProcessing/documentation/thesis/images/MRP_library_test_results_for_different_submodules_executed_in_PyCharm_(+ide).png

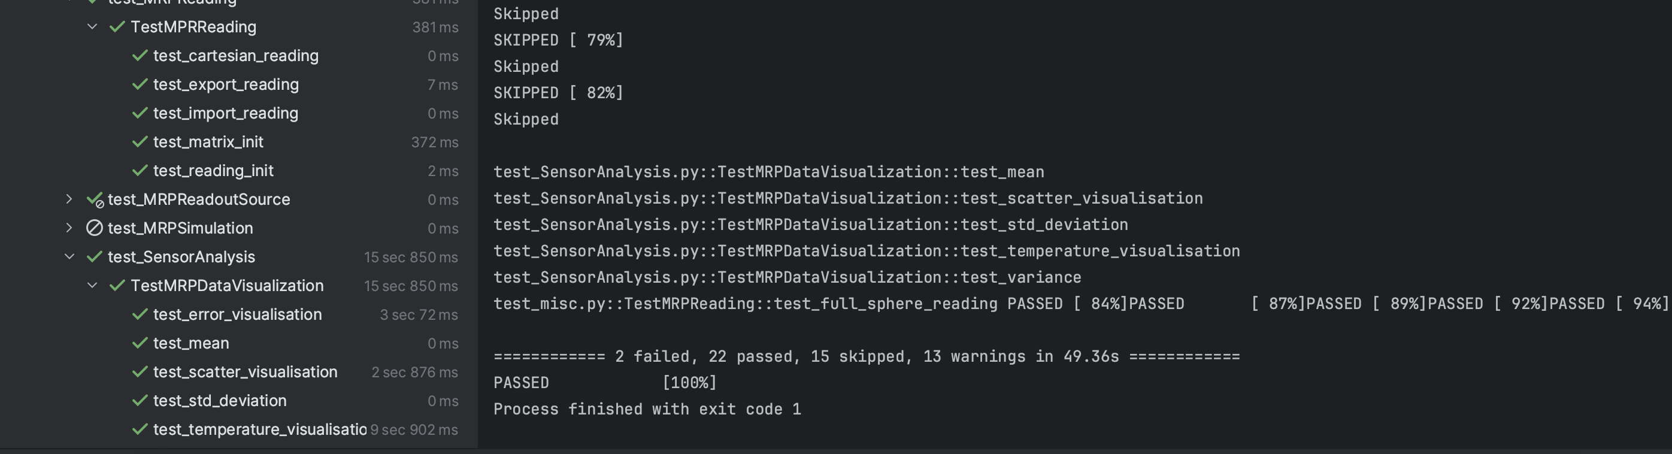
documentation/thesis/images/MRP_library_test_results_for_different_submodules_executed_in_PyCharm_(+ide).png
