LFB-MRI/MagneticReadoutProcessing/documentation/thesis/images/pipeline_output/error_plot_Sample N45 12x12x12 magnets calibrated.png

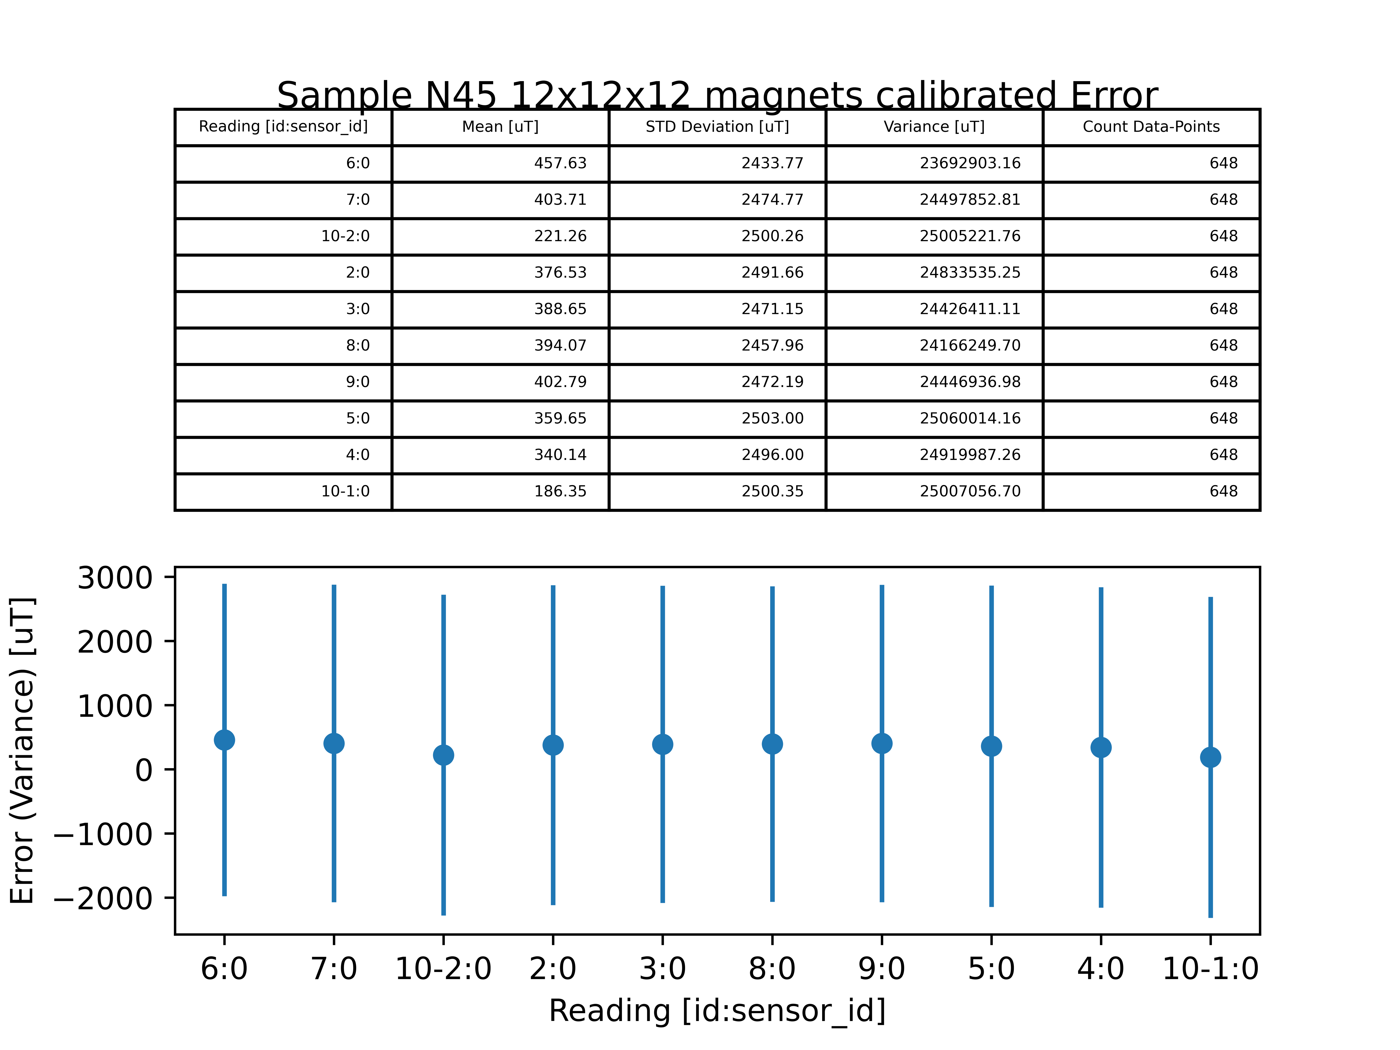
documentation/thesis/images/pipeline_output/error_plot_Sample N45 12x12x12 magnets calibrated.png
