LFB-MRI/MagneticReadoutProcessing/documentation/thesis/images/Sensor_linearity_evaluation_results_for_TLV493D_and_MMC5603NJ/Linearity_of_TLV493D_using_120_samples_over_an_distance_of_120.png

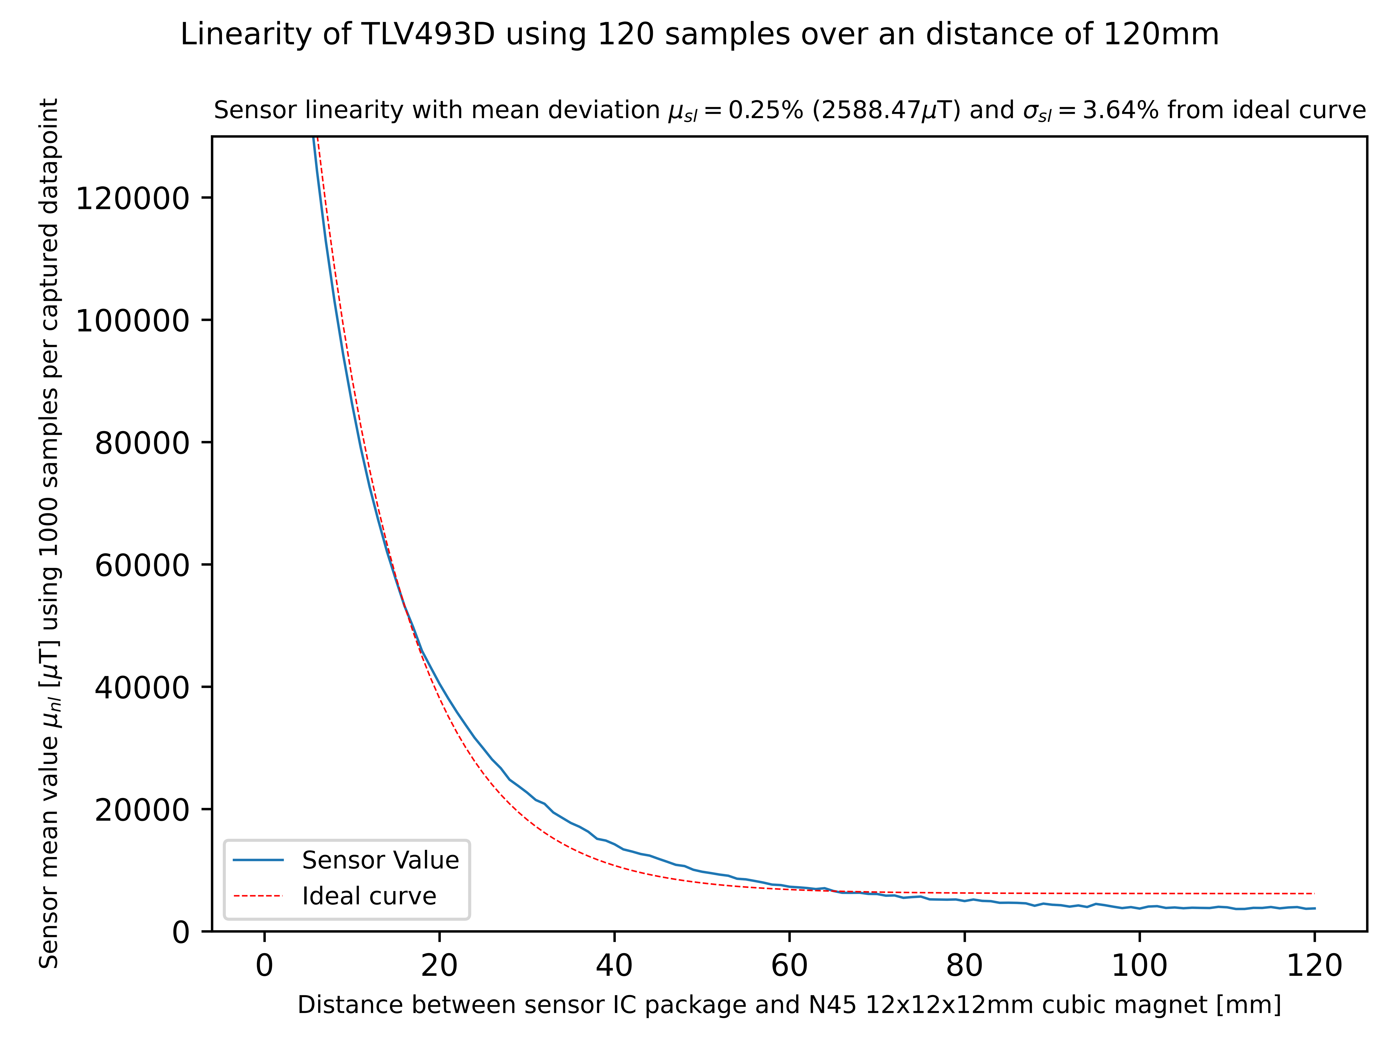
documentation/thesis/images/Sensor_linearity_evaluation_results_for_TLV493D_and_MMC5603NJ/Linearity_of_TLV493D_using_120_samples_over_an_distance_of_120.png
