LFB-MRI/MagneticReadoutProcessing/src/MagneticReadoutProcessing/pipelines/generated/pipeline_mrp_evaluation_yaml/calltree_graph.png

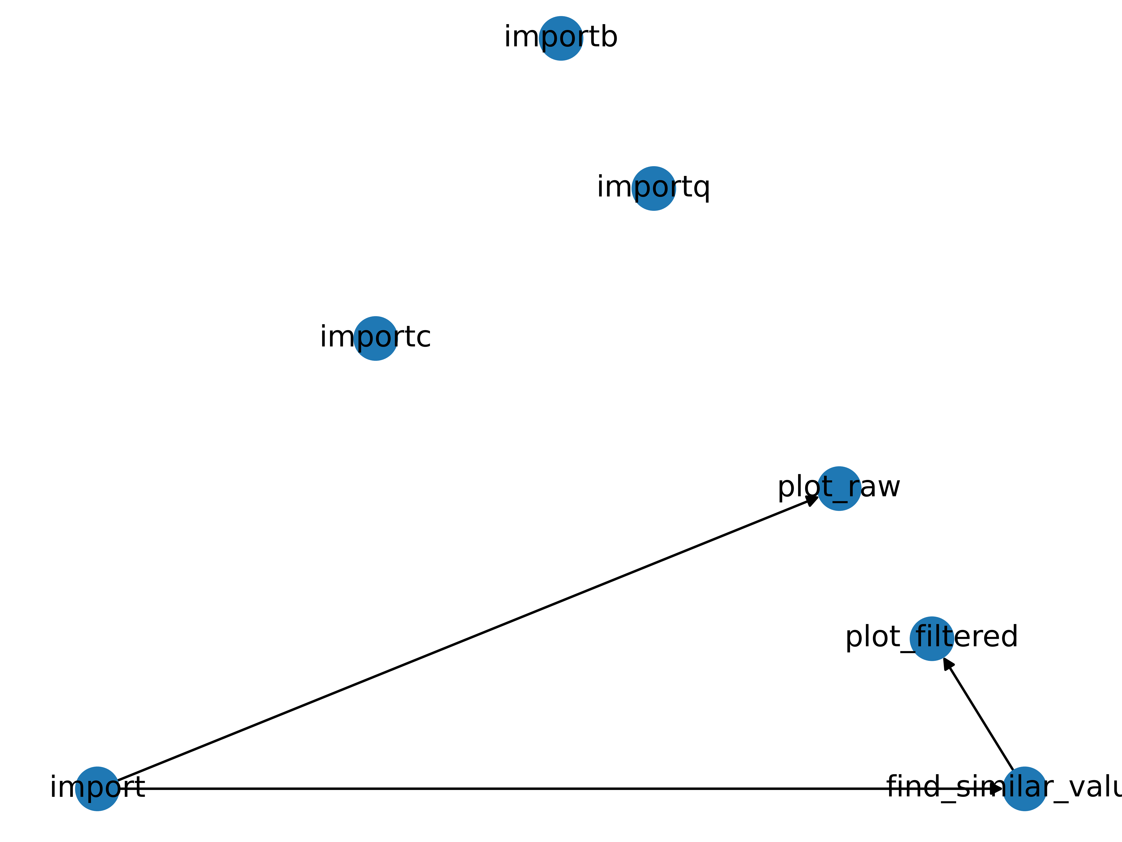
src/MagneticReadoutProcessing/pipelines/generated/pipeline_mrp_evaluation_yaml/calltree_graph.png
