LFB-MRI/MagneticReadoutProcessing/src/MagneticReadoutProcessing/pipelines/generated/pipeline_mrp_evaluation_yaml/sub_calltree_startstage_find_similar_values.png

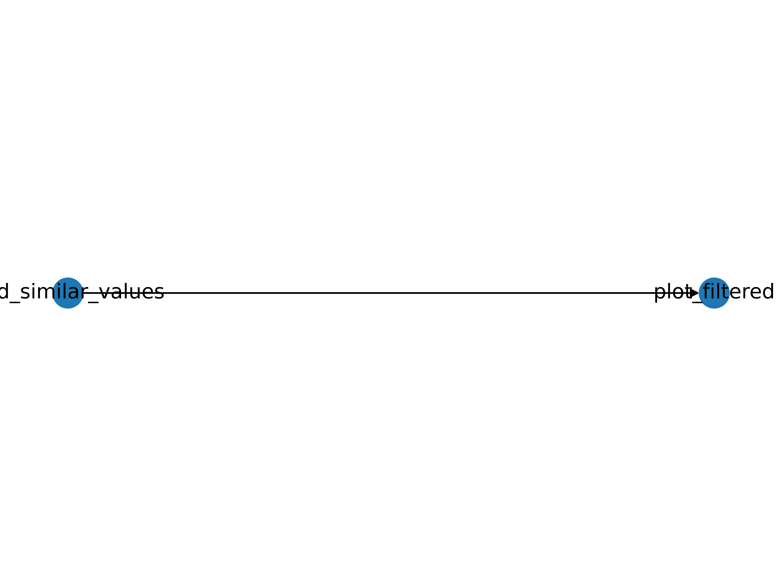
src/MagneticReadoutProcessing/pipelines/generated/pipeline_mrp_evaluation_yaml/sub_calltree_startstage_find_similar_values.png
