LFB-MRI/MagneticReadoutProcessing/src/MagneticReadoutProcessing/readings/_tlv493d_N45_12x12x12/525771256544952/SENSOR_0/plots/normal/scatter_plot_N4512x12x12measurementrunoverview.png

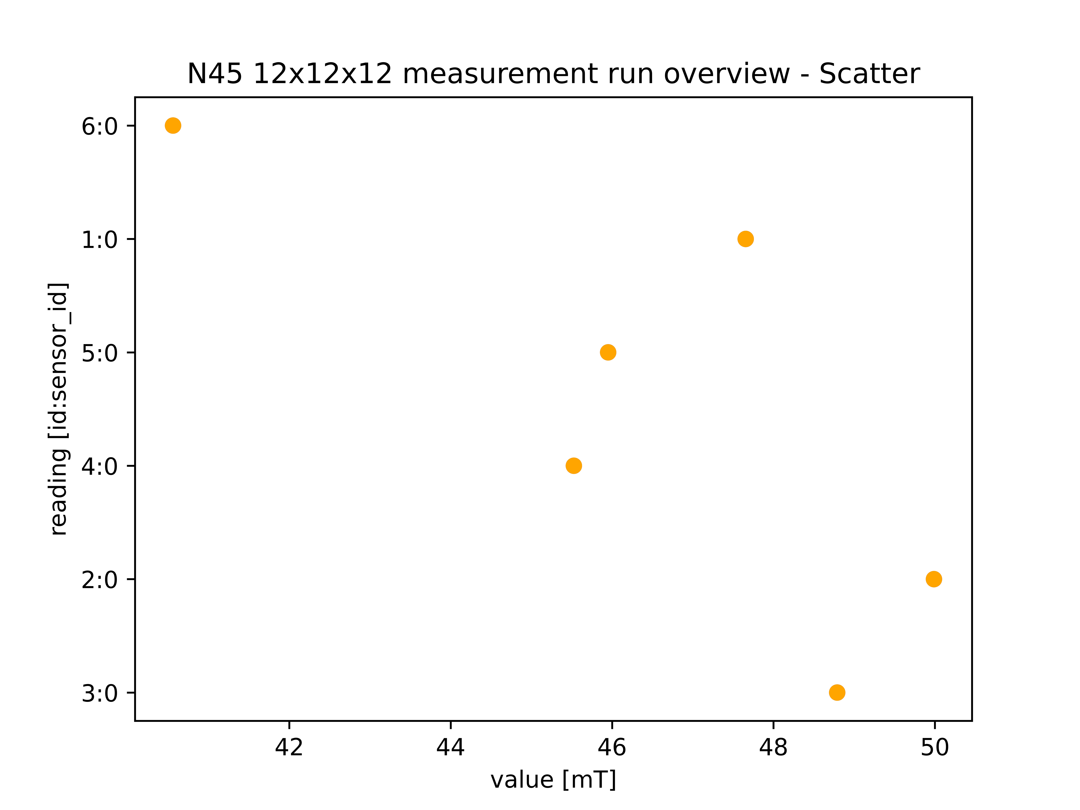
src/MagneticReadoutProcessing/readings/_tlv493d_N45_12x12x12/525771256544952/SENSOR_0/plots/normal/scatter_plot_N4512x12x12measurementrunoverview.png
