LFB-MRI/MagneticReadoutProcessing/src/MagneticReadoutProcessing/tests/generated_plots/Noise_MMC5603NJ_N=2000_AVG=5_RUN_1_MAGNET=0.png

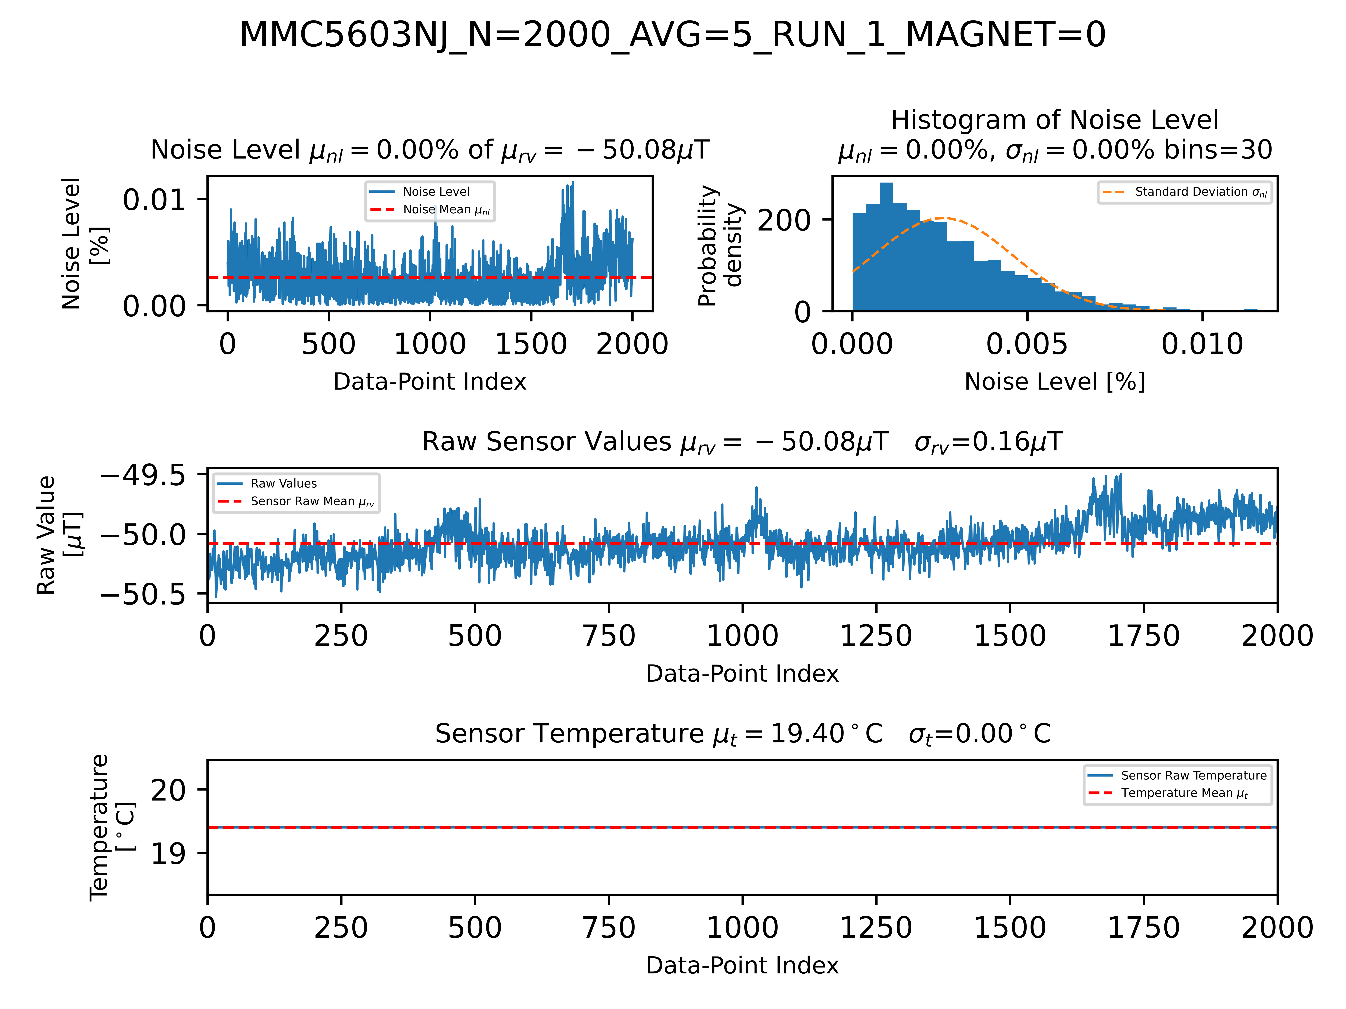
src/MagneticReadoutProcessing/tests/generated_plots/Noise_MMC5603NJ_N=2000_AVG=5_RUN_1_MAGNET=0.png
