LFB-MRI/MagneticReadoutProcessing/src/MagneticReadoutProcessing/tests/generated_plots/Noise_TLV493D_N=1000_AVG=20_RUN=1_TCOMBINED.png

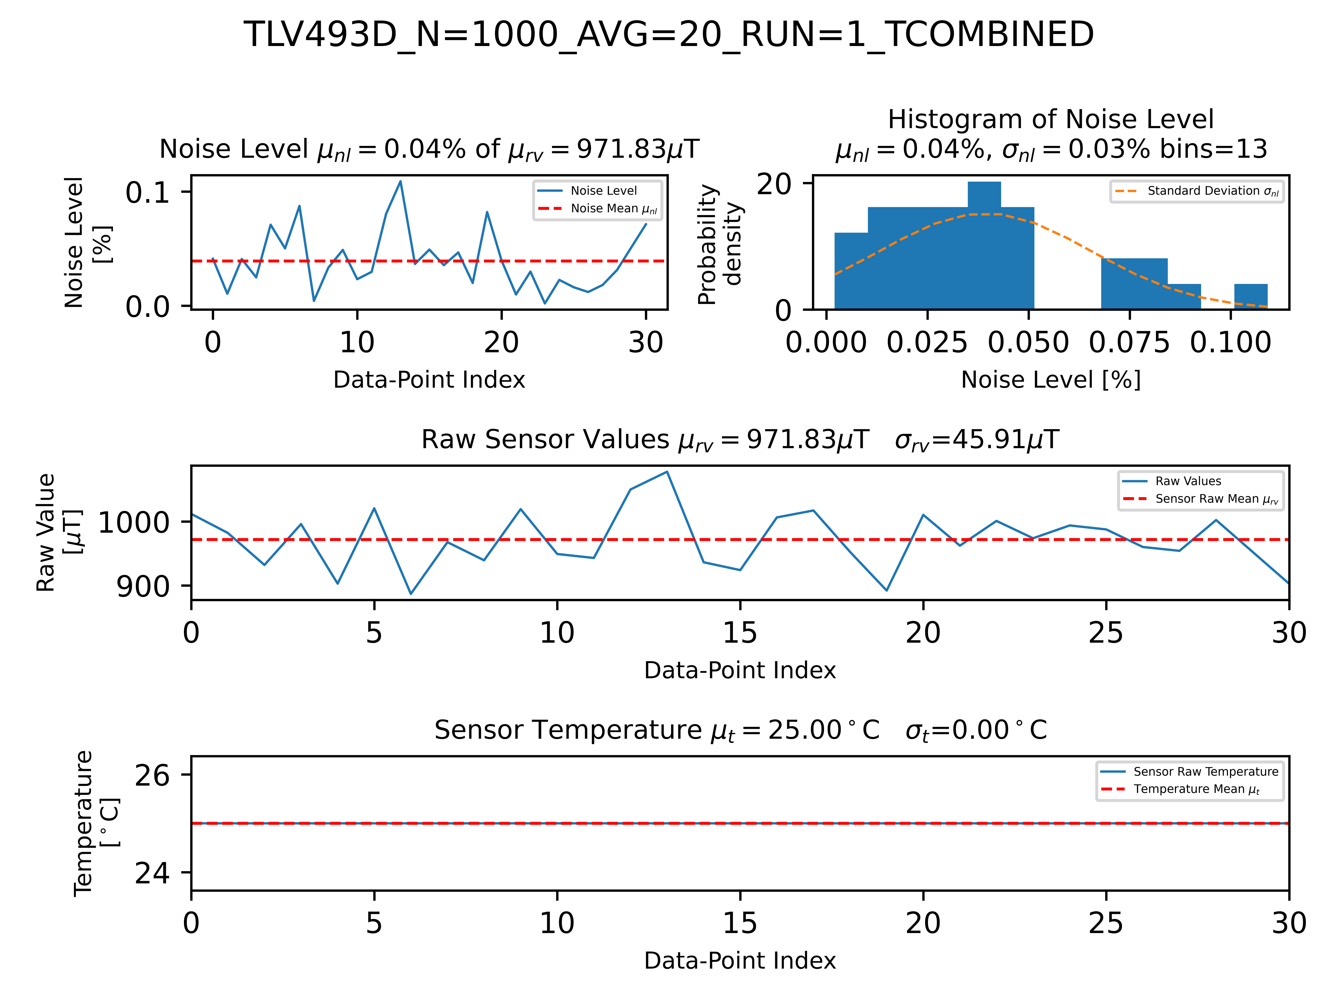
src/MagneticReadoutProcessing/tests/generated_plots/Noise_TLV493D_N=1000_AVG=20_RUN=1_TCOMBINED.png
