LFB-MRI/MagneticReadoutProcessing/src/MagneticReadoutProcessing/tests/generated_plots/Temperature_sensitivity_of_ALT:TLV493D.png

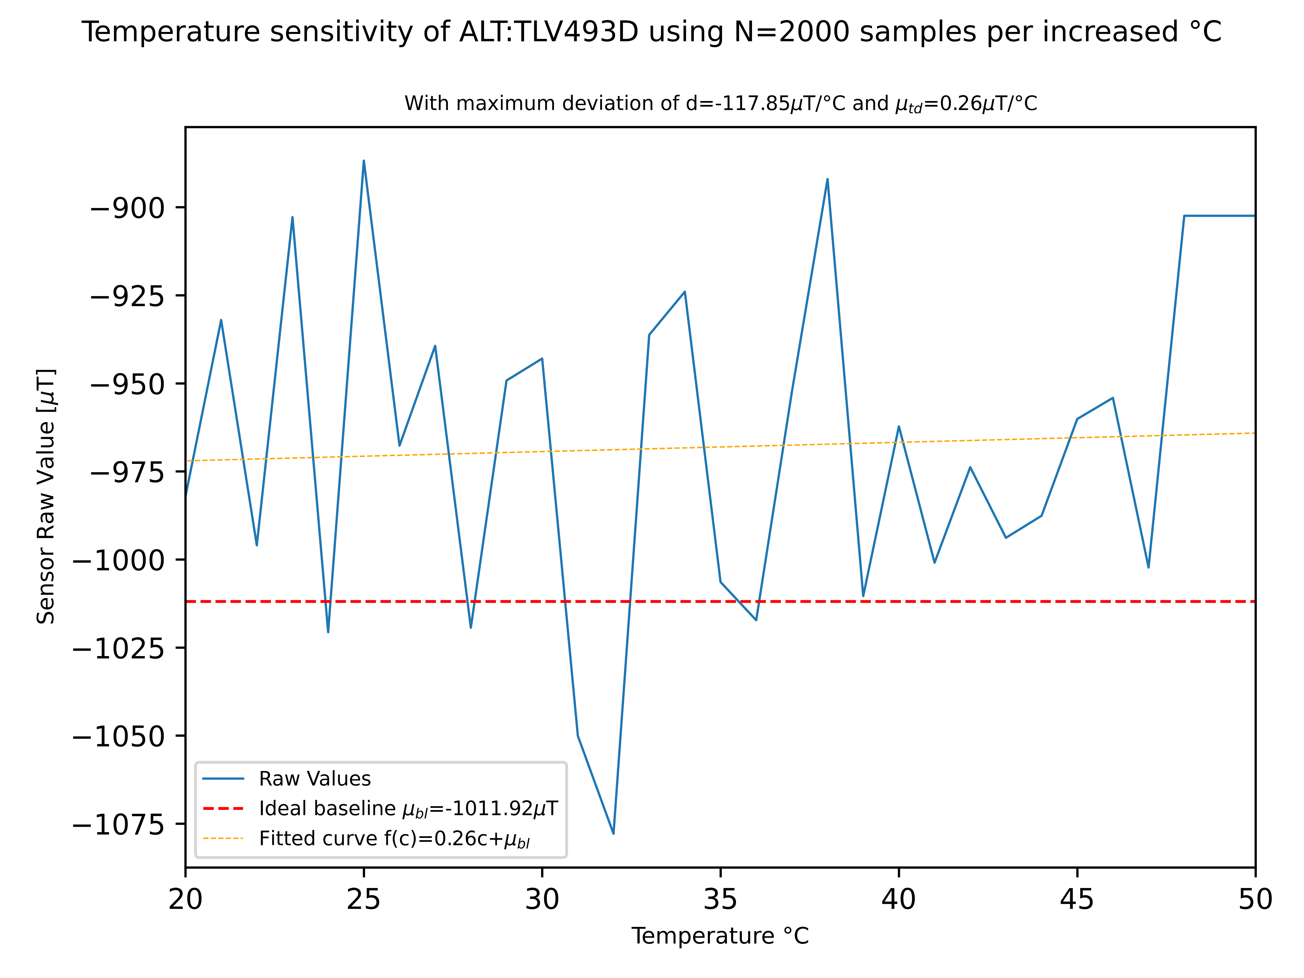
src/MagneticReadoutProcessing/tests/generated_plots/Temperature_sensitivity_of_ALT:TLV493D.png
