LFB-MRI/MagneticReadoutProcessing/src/MagneticReadoutProcessing/tests/tmp/test_basesensor_create_calibration_reading_error_1000.png

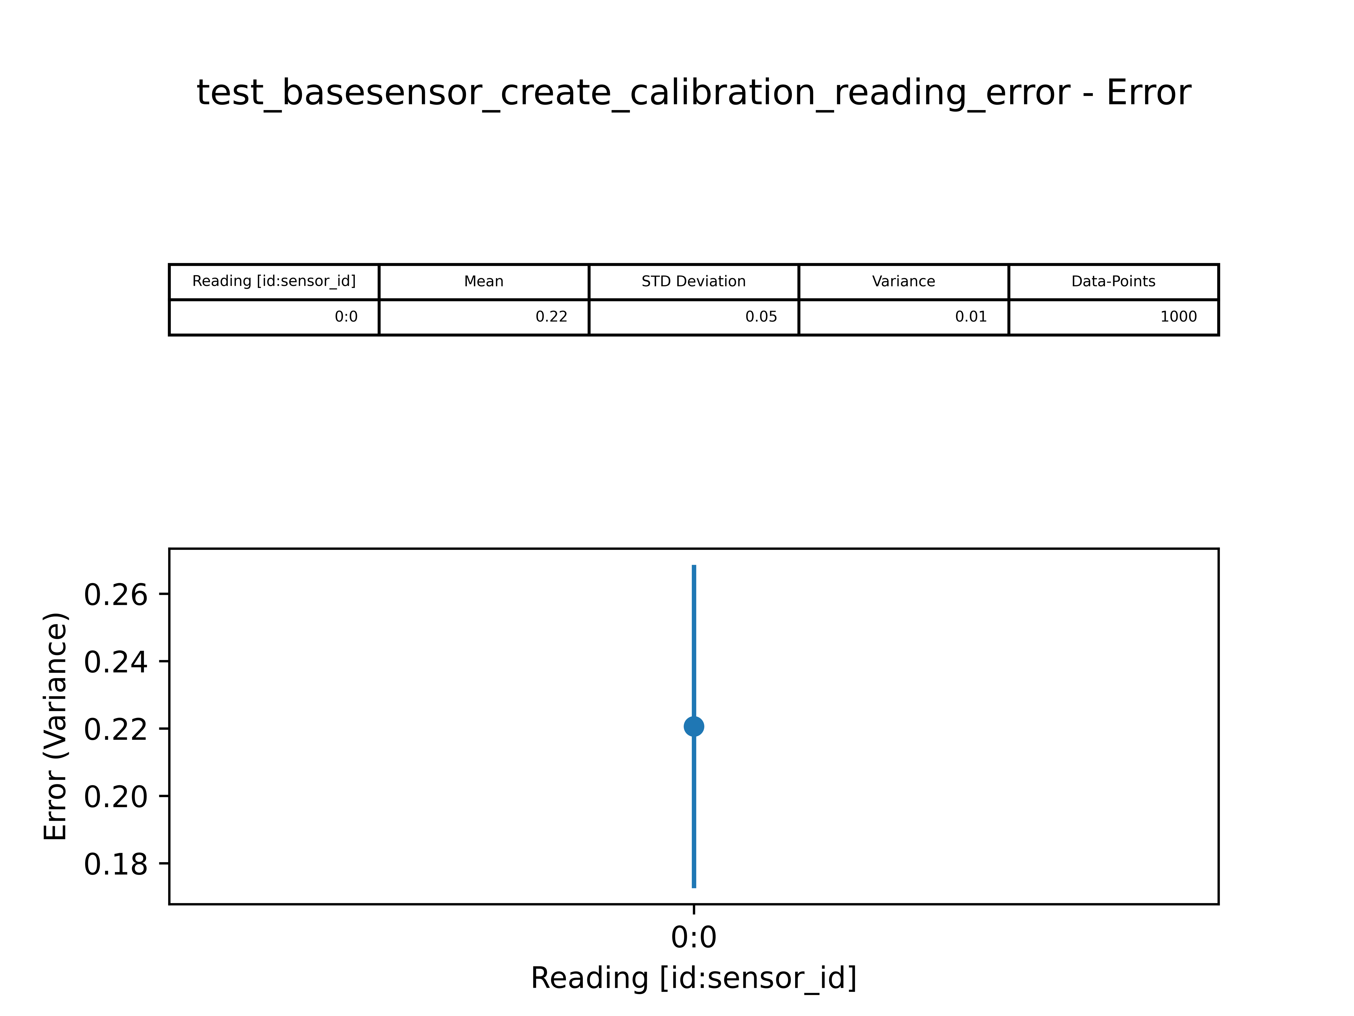
src/MagneticReadoutProcessing/tests/tmp/test_basesensor_create_calibration_reading_error_1000.png
