LFB-MRI/MagneticReadoutProcessing/src/MagneticReadoutProcessing/tests/tmp/test_error_visualisation.png

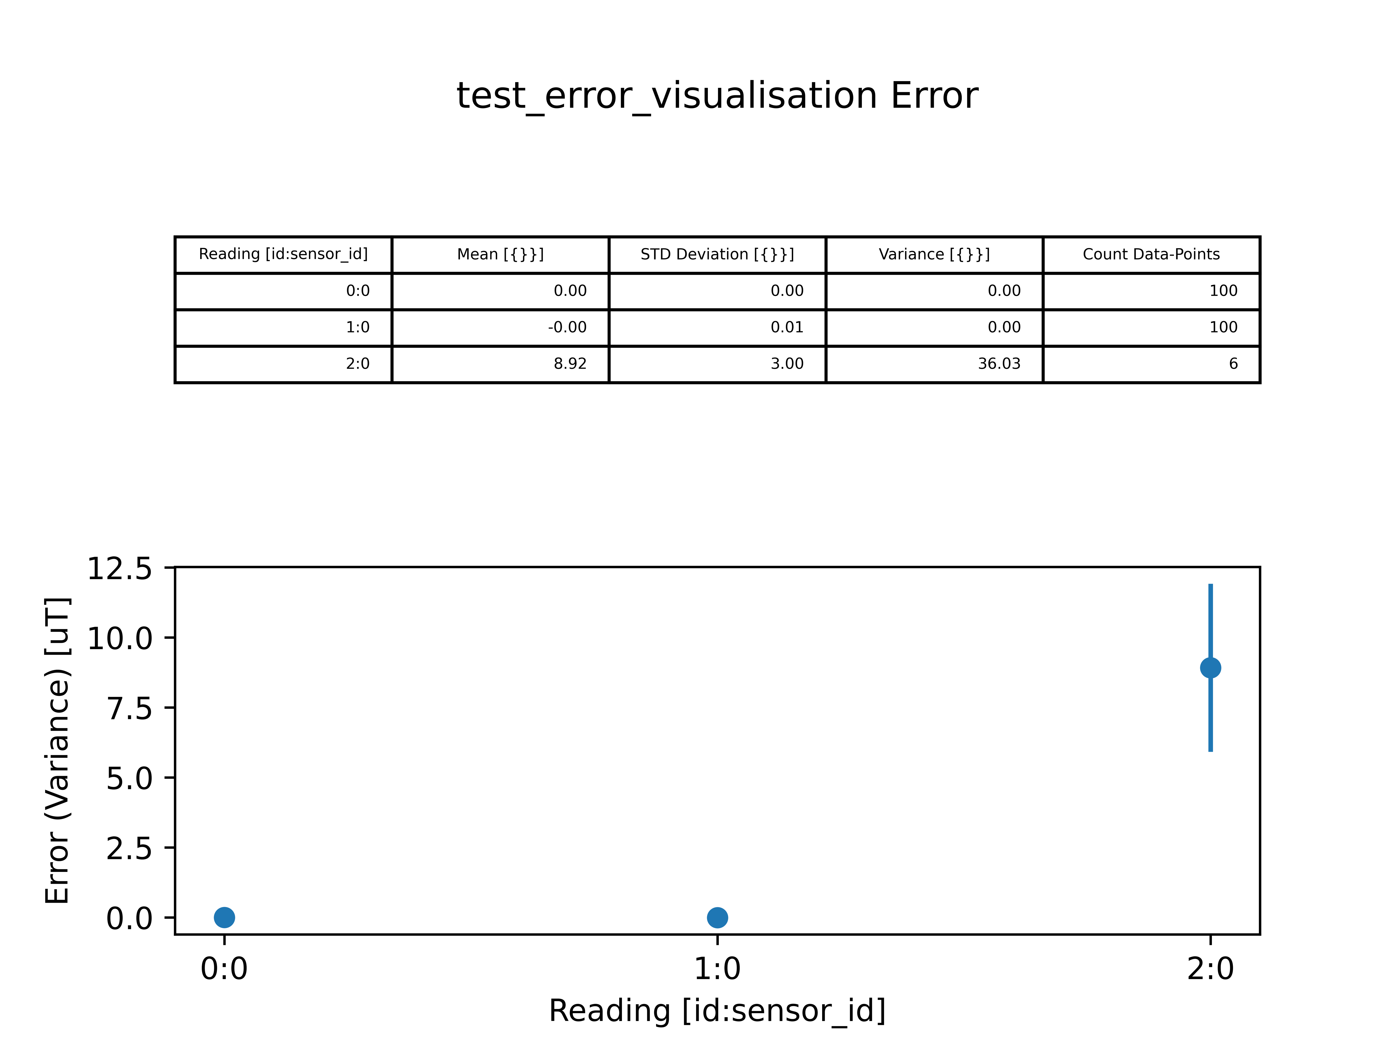
src/MagneticReadoutProcessing/tests/tmp/test_error_visualisation.png
