LFB-MRI/MagneticReadoutProcessing/src/MagneticReadoutProcessing/tests/tmp/test_scatter_visualisation.png

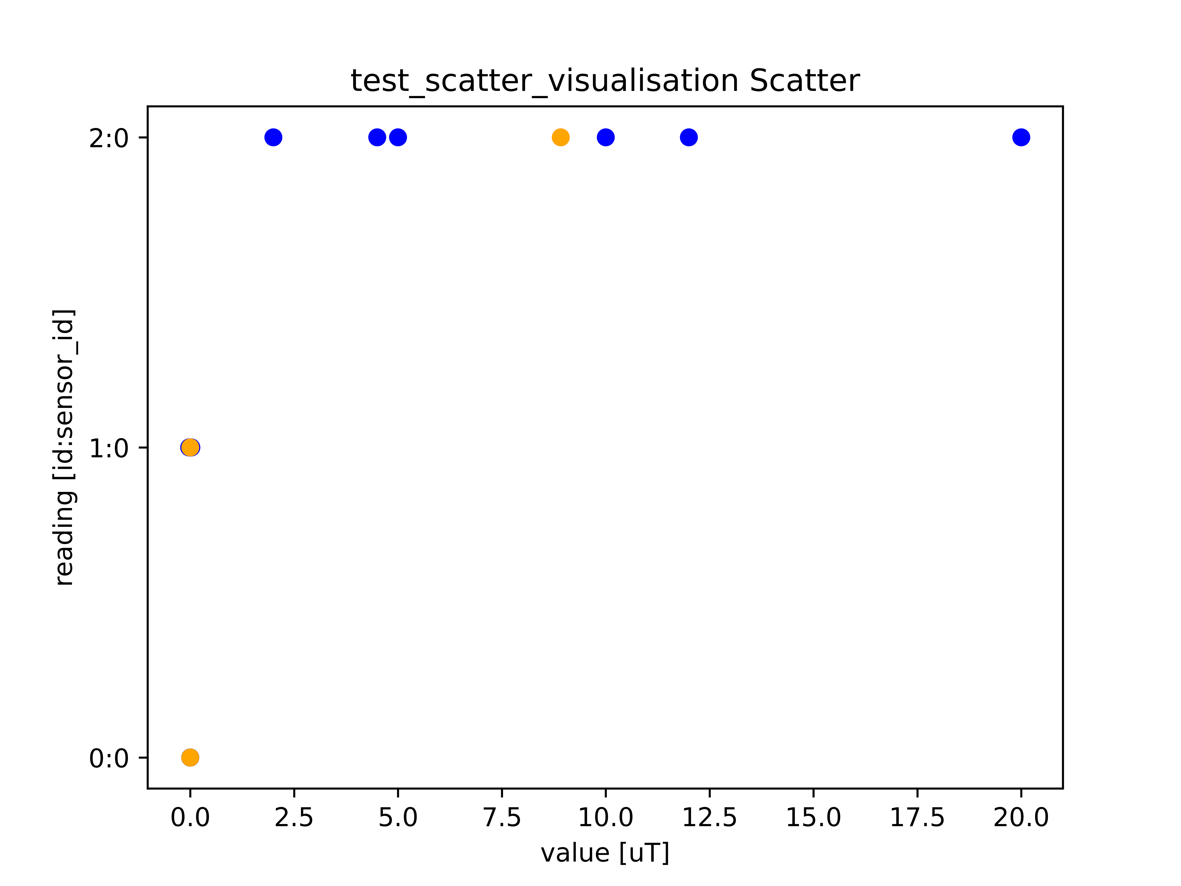
src/MagneticReadoutProcessing/tests/tmp/test_scatter_visualisation.png
