LFB-MRI/MagneticReadoutProcessing/src/MagneticReadoutProcessing/tests/tmp/vector_save.png

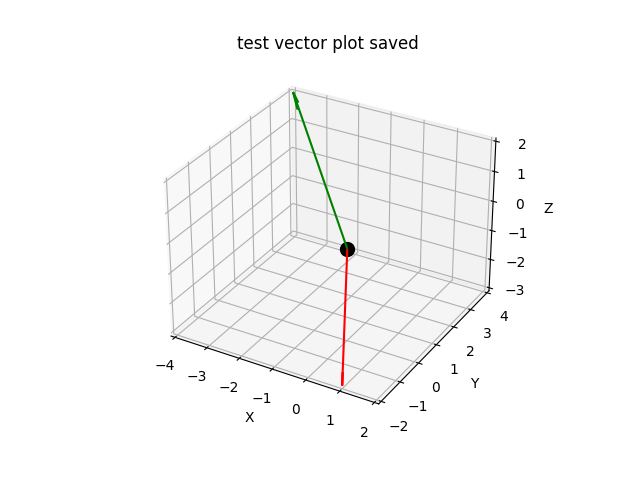
src/MagneticReadoutProcessing/tests/tmp/vector_save.png
