LFB-MRI/MagneticReadoutProcessing/src/MagBoardHardware/rotational_sensor/rotation_sensor_interface/printer.cfg

[include mainsail.cfg]
# This file contains common pin mappings for the BIGTREETECH SKR Pico V1.0
# To use this config, the firmware should be compiled for the RP2040 with
# USB communication.

# The "make flash" command does not work on the SKR Pico V1.0. Instead,
# after running "make", copy the generated "out/klipper.uf2" file
# to the mass storage device in RP2040 boot mode

## Voron Design VORON 0.2 SKR Pico V1.0 config

## *** THINGS TO CHANGE/CHECK: ***
## MCU path                                                                     [mcu] section
## Z and Extruder motor currents                                                [tmc2209 stepper_*] sections. Uncomment the stepper motor you have
## Full steps per rotation for Extruder                                         [extruder] section
## Thermistor types                                                             [extruder] and [heater_bed] sections - See https://www.klipper3d.org/Config_Reference.html#common-thermistors for common thermistor types
## Motor currents                                                               [extruder] [stepper] and [_HOME_X/Y] macro sections
## PID tune                                                                     [extruder] and [heater_bed] sections
## Fine tune E steps                                                            [extruder] section
## For more info                                                                check https://docs.vorondesign.com/build/startup/#v0

[mcu]
#####################################################################
# Obtain definition by "ls -l /dev/serial/by-id/"
#####################################################################
serial: /dev/ttyAMA0 #/dev/serial/by-id/usb-Klipper_rp2040_REPLACE_WITH_YOUR_VALUE
## serial: /dev/ttyAMA0 											# for UART connection
restart_method: command


[printer]
kinematics: cartesian
max_velocity: 20
max_accel: 50


max_z_velocity: 15
max_z_accel: 15
square_corner_velocity: 6.0


[idle_timeout]
timeout: 10

#####################################################################
#      X/Y Stepper Settings
#####################################################################

[stepper_x]
step_pin: gpio11
## Refer to https://docs.vorondesign.com/build/startup/#v0
dir_pin: gpio10                                                     # Check motor direction in link above. If inverted, add a ! before gpio10
enable_pin: !gpio12
rotation_distance: 40
microsteps: 32
full_steps_per_rotation: 200                                        # Set to 400 for 0.9° degree stepper motor, 200 is for 1.8° stepper motors
endstop_pin: tmc2209_stepper_x:virtual_endstop
position_endstop: 0
position_max: 120
homing_speed: 20                                                    # for sensorless homing it is recommended not to go above 40mm/s
homing_retract_dist: 0
homing_positive_dir: false

[tmc2209 stepper_x]
uart_pin: gpio9
tx_pin: gpio8
uart_address: 0
interpolate: False
run_current: 1.0
# you need to calculate the run_current value using the equation (rated_motor_current * 0.707 = Maximum_run_current) start with a value that is about 60%-70% of your maximum value.
sense_resistor: 0.110
stealthchop_threshold: 0                                            # Set to 999999 to turn stealthchop on, and 0 to use spreadcycle
diag_pin: ^gpio4    												# YOU NEED TO JUMP THIS DIAG PIN ON YOUR BOARD FOR SENSORLESS HOMING TO WORK
driver_SGTHRS: 255  												# this is set to 255 which is the MAX sensitivity for sensorless homing, you will need to tune this later

[stepper_y]
step_pin: gpio6
## Refer to https://docs.vorondesign.com/build/startup/#v0
dir_pin: !gpio5                                                      # Check motor direction in link above. If inverted, add a ! before gpio5
enable_pin: !gpio7
rotation_distance: 40
microsteps: 32
full_steps_per_rotation: 200                                        # Set to 400 for 0.9° degree stepper motor, 200 is for 1.8° stepper motors
endstop_pin: tmc2209_stepper_y:virtual_endstop
position_endstop: 0
position_max: 2000
homing_speed: 10                                                # for sensorless homing it is recommended not to go above 40mm/s
homing_retract_dist: 0
homing_positive_dir: false

[tmc2209 stepper_y]
uart_pin: gpio9
tx_pin: gpio8
uart_address: 2
interpolate: False
run_current: 1.0
# you need to calculate the run_current value using the equation (rated_motor_current * 0.707 = Maximum_run_current) start with a value that is about 60%-70% of your maximum value.
sense_resistor: 0.110
stealthchop_threshold: 0                                            # Set to 999999 to turn stealthchop on, and 0 to use spreadcycle
diag_pin: ^gpio3    												# YOU NEED TO JUMP THIS DIAG PIN ON YOUR BOARD FOR SENSORLESS HOMING TO WORK
driver_SGTHRS: 10  												# this is set to 255 which is the MAX sensitivity for sensorless homing, you will need to tune this later

#####################################################################
#   Z Stepper Settings
#####################################################################

[stepper_z]
step_pin: gpio19
dir_pin: !gpio28                                                    # Remove the ! before gpio28 if motor direction is inverted.
enable_pin: !gpio2
rotation_distance: 8                                                # For T8x8 integrated lead screw
microsteps: 32
endstop_pin: ^gpio25
position_endstop: 120
position_max: 120
position_min: -1.5
homing_speed: 20
second_homing_speed: 3.0
homing_retract_dist: 3.0


[tmc2209 stepper_z]
uart_pin: gpio9
tx_pin: gpio8
uart_address: 1
interpolate: False
## For OMC (StepperOnline) 17LS13-0404E-200G 0.4A
run_current: 0.56
## For LDO-42STH25-1004CL200E 1.0A
#run_current: 0.37
sense_resistor: 0.110
stealthchop_threshold: 0
