LFB-MRI/MagneticReadoutProcessing/src/MagneticReadoutProcessing/MRPproxy/machineid.py

"""
py-machineid
~~~~~~~~~~~~

Get the unique machine ID of any host (without admin privileges).

Basic usage:

    >>> import machineid
    >>> machineid.id()
    17A28A73-BEA9-4D4B-AF5B-03A5AAE9B92C

You can anonymize the ID like so, with an optional app ID:

    >>> machineid.hashed_id('myappid')
    366048092ef4e7db53cd7adec82dcab15ab67ac2a6b234dc6a69303a4dd48e83
    >>> machineid.hashed_id()
    ce2127ade536eaa9529f4a7b73141bbc2f094c46e32742c97679e186e7f13fde

Special thanks to Denis Brodbeck for his Go package, machineid (https://github.com/denisbrodbeck/machineid).

:license: MIT, see LICENSE for more details.
"""

__version__ = '0.4.6'
__author__  = 'Zeke Gabrielse'
__credits__ = 'https://github.com/denisbrodbeck/machineid'

from platform import uname
from sys import platform
import subprocess
import hashlib
import hmac

def __exec__(cmd: str) -> str:
  try:
    return subprocess.run(cmd, shell=True, capture_output=True, check=True, encoding='utf-8') \
                     .stdout \
                     .strip()
  except:
    return None

def __read__(path: str) -> str:
  try:
    with open(path) as f:
      return f.read()
  except:
    return None

def __reg__(registry: str, key: str) -> str:
  try:
    from winregistry import WinRegistry

    with WinRegistry() as reg:
      return reg.read_entry(registry, key) \
                .value \
                .strip()
  except:
    return None

def id(winregistry: bool = True) -> str:
  """
  id returns the platform specific device GUID of the current host OS.
  """
  id = None
  if platform == 'darwin':
    id = __exec__("ioreg -d2 -c IOPlatformExpertDevice | awk -F\\\" '/IOPlatformUUID/{print $(NF-1)}'")
  elif platform in ('win32', 'cygwin', 'msys'):
    if winregistry:
      id = __reg__(r'HKEY_LOCAL_MACHINE\SOFTWARE\Microsoft\Cryptography', 'MachineGuid')
    else:
      id = __exec__("powershell.exe -ExecutionPolicy bypass -command (Get-CimInstance -Class Win32_ComputerSystemProduct).UUID")
    if not id:
      id = __exec__('wmic csproduct get uuid').split('\n')[2] \
                                              .strip()
  elif platform.startswith('linux'):
    id = __read__('/var/lib/dbus/machine-id')
    if not id:
      id = __read__('/etc/machine-id')
    if not id:
      cgroup = __read__('/proc/self/cgroup')
      if cgroup and 'docker' in cgroup:
        id = __exec__('head -1 /proc/self/cgroup | cut -d/ -f3')
    if not id:
      mountinfo = __read__('/proc/self/mountinfo')
      if mountinfo and 'docker' in mountinfo:
        id = __exec__("grep -oP '(?<=docker/containers/)([a-f0-9]+)(?=/hostname)' /proc/self/mountinfo")
    if not id and 'microsoft' in uname().release: # wsl
      id = __exec__("powershell.exe -ExecutionPolicy bypass -command '(Get-CimInstance -Class Win32_ComputerSystemProduct).UUID'")
  elif platform.startswith(('openbsd', 'freebsd')):
    id = __read__('/etc/hostid')
    if not id:
      id = __exec__('kenv -q smbios.system.uuid')

  if not id:
    raise Exception('failed to obtain id on platform {}'.format(platform))

  return id

def hashed_id(app_id: str = '', **kwargs) -> str:
  """
  hashed_id returns the device's native GUID, hashed using HMAC-SHA256 with an optional application ID.
  """

  return hmac.new(bytes(app_id.encode()), id(**kwargs).encode(), hashlib.sha256).hexdigest()
