LFB-MRI/MagneticReadoutProcessing/src/MagneticReadoutProcessing/MRP/MRPAnalysis.py

""" collection of reading processing functions such as fft, mean, center of gravity"""

import math

import numpy
import numpy as np
from matplotlib import pyplot as plt
from scipy.fft import fft, fftfreq
from scipy.signal import find_peaks

from MRP import MRPReading


class MRPAnalysisException(Exception):
    def __init__(self, message="MRPAnalysisException thrown"):
        self.message = message
        super().__init__(self.message)


class MRPAnalysis:


    @staticmethod
    def apply_temperature_coefficient(_reading: MRPReading.MRPReading, _temp_lower: MRPReading.MRPReading, _temp_upper: MRPReading.MRPReading):

        mean_lower: float = MRPAnalysis.calculate_mean(_temp_lower, _temperature_axis=True)
        mean_upper: float = MRPAnalysis.calculate_mean(_temp_lower, _temperature_axis=True)

        # min max function

    @staticmethod
    def calculate_mean(_reading: MRPReading.MRPReading, _temperature_axis: bool = False) -> float:
        """
        Calculates the standard variance of MRPReading values

        :param _reading:
        :type _reading: MRPReading

        :returns: Returns the calculated variance value
        :rtype: float
        """
        values: np.ndarray = None
        if _temperature_axis:
            values = _reading.to_temperature_value_array()
        else:
            values = _reading.to_value_array()

        if len(values) <= 0:
            raise MRPAnalysisException("_reading contains to reading entries")

        return np.sum(values) / len(values)

    @staticmethod
    def calculate_variance(_reading: MRPReading.MRPReading, _temperature_axis:bool=False) -> float:
        """
        Calculates the standard variance of MRPReading values

        :param _reading:
        :type _reading: MRPReading

        :returns: Returns the calculated variance value
        :rtype: float
        """
        mean = MRPAnalysis.calculate_mean(_reading, _temperature_axis=_temperature_axis)

        values: np.ndarray = None
        if _temperature_axis:
            values= _reading.to_temperature_value_array()
        else:
            values = _reading.to_value_array()

        if len(values) <= 0:
            raise MRPAnalysisException("_reading contains to reading entries")


        variance:float  = 0
        for value in values:
            variance += (mean - value) ** 2

        return variance / len(values)
    @staticmethod
    def calculate_std_deviation(_reading: MRPReading.MRPReading, _temperature_axis:bool=False) -> float:
        """
        Calculates the standard deviation of MRPReading values

        :param _reading:
        :type _reading: MRPReading

        :returns: Returns the calculated std deviation
        :rtype: float
        """
        variance = MRPAnalysis.calculate_variance(_reading, _temperature_axis=_temperature_axis)
        return np.sqrt(variance)

    @staticmethod
    def calculate_fft(_reading: MRPReading.MRPReading, _normalize: bool = False, _plot: bool = False):
        """
        Calculates the FFT of a reading using the inserted datapoint.value property

        :param _reading:
        :type _reading: MRPReading

        :returns:Returns the caclulcated fft values
        :rtype: np.ndarray
        """
        values = _reading.to_value_array()

        if _normalize:
            min_value = np.min(values)
            values = values - min_value # SHIFT INTO POSITIVE
            values = values / np.linalg.norm(values)
        # sampling rate
        sr = len(values)
        # sampling interval
        ts = 1.0 / sr
        t = np.arange(0, 1, ts)

        n = values.size  # The number of points in the data
        freq = fftfreq(n, d=ts)


        yf = fft(values, norm='forward')
        height_threshold = 0.05
        peaks_index, properties = find_peaks(np.abs(yf), height=height_threshold)

        plt.plot(freq, np.abs(yf), '-', freq[peaks_index], properties['peak_heights'], 'x')
        plt.xlabel("Frequency")
        plt.ylabel("Amplitude")
        plt.show()
        plt.show()

    """ Provides functions to merge two reading, apply calibration measurements"""
    @staticmethod
    def calculate_center_of_gravity(_reading: MRPReading.MRPReading) -> (float, float, float):
        """
        Function calculates the polarisation vector of a given reading.
        By searching for the max positive value in the matrix representation of the reading

        :param _reading: reading
        :type _reading: MRPReading

        :returns: Returns a tuple vector (x,y,z) which probably represents the polarization direction
        :rtype: tuple
        """

        if len(_reading.data) <= 0:
            raise MRPAnalysisException("No points provided")

        total_x = 0
        total_y = 0
        total_z = 0


        datapoints_cartesian = _reading.to_numpy_cartesian(_normalize=False, _use_sensor_distance=False)
        for point in datapoints_cartesian:
            x, y, z = point
            total_x += x
            total_y += y
            total_z += z

        num_points = len(_reading.data)
        center_x = total_x / num_points
        center_y = total_y / num_points
        center_z = total_z / num_points

        return (center_x, center_y, center_z)
    @staticmethod
    def search_reading_for_value(_reading: MRPReading.MRPReading, _phi: float, _theta: float) -> float:
        """
        returns a value from a given reading according a given _phi _theta values

        :param _reading: reading with data to search in
        :type _reading: MRPReading

        :param _phi: polar coordinates phi value
        :type _phi: float

        :param _theta: polar coordinates theta value
        :type _theta: float

        :returns: value, if value found else None
        :rtype: float
        """
        for idx, data_entry in enumerate(_reading.data):
            phi = data_entry.phi
            theta = data_entry.theta
            if phi == _phi and theta == _theta:
                return data_entry.value
        return None

    @staticmethod
    def search_reading_for_value_numpy(_reading: MRPReading. MRPReading, _search: np.ndarray) -> float:
        """
        returns a value from a given reading according a given search parameter [_phi, _theata, None]

        :param _reading: reading with data to search in
        :type _reading: MRPReading

        :param _search: numpy.ndarray [phi, theta, X]
        :type _search: numpy.ndarray

        :returns: value if value found else None
        :rtype: float
        """
        return MRPAnalysis.search_reading_for_value(_reading, _search[0], _search[1])

    # TODO BINNING IMPLEMENTIEREN
    #
    @staticmethod
    def merge_two_half_sphere_measurements_to_full_sphere(_reading_top: MRPReading.MRPReading, _reading_bottom: MRPReading.MRPReading) -> MRPReading.MRPReading:
        top_n_theta = _reading_top.measurement_config.n_theta
        top_theta_radians = _reading_top.measurement_config.theta_radians
        top_n_phi = _reading_top.measurement_config.n_phi
        top_phi_radians = _reading_top.measurement_config.phi_radians

        bottom_n_theta = _reading_bottom.measurement_config.n_theta
        bottom_theta_radians = _reading_bottom.measurement_config.theta_radians
        bottom_n_phi = _reading_bottom.measurement_config.n_phi
        bottom_phi_radians = _reading_bottom.measurement_config.phi_radians

        # CHECK AXIS LIMITS
        # # TODO CURRENTLY LIMITS NEEDS TO BE EQUALLY... FIX THIS LATER TO ALLOW OTHER n_theta values E.G. MERGE 90DEGREE AND 45 DEGREE READING
        # ONLY CHECK n_phi and radius
        rtd = _reading_top.measurement_config.to_dict()
        rbd = _reading_bottom.measurement_config.to_dict()
        for key in ['n_phi', 'phi_radians', 'sensor_distance_radius', 'magnet_type']:
            top_value = rtd[key]
            bottom_value = rbd[key]
            if top_value != bottom_value:
                raise MRPAnalysisException(
                    "mismatching {0} _reading_top:{1} _reading_bottom:{2}".format(key, top_value, bottom_value))




        # TODO FIX BOTTOM
        # CREATE NEW READING WITH MODIFED SIZE
        ret = MRPReading.MRPReading(_reading_top.measurement_config)
        ret.measurement_config.sensor_id = 42
        # NEW VALUES FOR THE VERTICAL AXIS WHICH GOINT FROM + (top scan) to - (bottom scan)
        ret.measurement_config.n_theta = bottom_n_theta
        ret.measurement_config.n_phi = bottom_n_phi
        ret.measurement_config.theta_radians = math.radians(180)
        ret.measurement_config.phi_radians = math.radians(360)
        ret.set_additional_data('is_merged_reading', 1)

        print("new calculated n_theta:{0} theta_radians:{1}".format(ret.measurement_config.n_theta, ret.measurement_config.theta_radians))


        # CREATE A POLAR GRID FOR A FULL SPHERE
        theta, phi = np.mgrid[0.0:ret.measurement_config.theta_radians:ret.measurement_config.n_theta * 1j, 0.0:2.0*ret.measurement_config.phi_radians:ret.measurement_config.n_phi * 1j]


        index_t = 0
        inserted = False
        for idx_p, p in enumerate(phi[0, :]):
            index_t = 0
            for idx_t, t in enumerate(theta[:, 0]):
                # INSERT TOP READING DATA
                value_top = MRPAnalysis.search_reading_for_value(_reading_top, p, t)
                value_bottom = MRPAnalysis.search_reading_for_value(_reading_bottom, p, t)

                inserted = False

                if value_top is not None:
                    ret.insert_reading(value_top, p, t, idx_p, index_t)
                    inserted = True
                # SKIP FIRST LINE FROM THE BOTTOM READING DUE TO OVERLAPPING WITH THE ROP ONE
                if value_bottom is not None and t > 0.0:
                    ret.insert_reading(value_bottom, p, math.pi - t, idx_p, index_t)
                    inserted = True

                if not inserted:
                    ret.insert_reading(0, p, t, idx_p, index_t)

                index_t = index_t + 1
        print("readings inserted {0} readings into the 360° sphere".format(len(ret.data)))
        return ret

    @staticmethod
    def apply_calibration_data_inplace(_calibration_reading: MRPReading.MRPReading, _current_reading: MRPReading.MRPReading):
        """
        apply a reference reading as baseline to a given reading.
        If a given datapoint is present in both readings the following calculation will be applied:
        current[datapoint].value = current[datapoint].value - calibration[datapoint].value

        _current_reading is a reference and modified values are updated directly.


        :param _calibration_reading: reference reading, will be applied to _current_reading
        :type _calibration_reading: MRPReading
        :param _current_reading: to this
        :type _current_reading: MRPReading



        """
        # GET NUMPY ARRAY
        np_cal = _calibration_reading.to_numpy_polar()
        np_curr = _current_reading.to_numpy_polar()

        # CHECK FOR ARRAY/DATA SHAPE
        if not numpy.shape(np_cal) == numpy.shape(np_curr):
            raise MRPAnalysisException("array shape check failed")


        # TODO REWORK EVERYTHING TO MATRICES
        # CURRENTLY WE CANT MAKE SURE THAT THE DATA ORDER IS IN BOTH ARRAYS EQUAL SO WE NEED TO SEARCH
        for idx, curr in enumerate(np_curr):
            curr_phi = curr[0]
            curr_theta = curr[1]

            for cal in np_cal:
                cal_phi = cal[0]
                cal_theta = cal[1]

                if cal_phi == curr_phi and cal_theta == curr_theta:
                    np_curr[idx][2] = curr[2] - cal[2]
                    break

        ## UPDATE ALL DATA ENTRIES
        _current_reading.update_data_from_numpy_polar(np_curr)

        # APPEND SOME METADATA
        _current_reading.set_additional_data('is_calibrated', 1)
        # ADD NAME OF THE CALIBRATION READING

        if 'export_filepath' in _calibration_reading.additional_data:
            _current_reading.set_additional_data('calibration_reading_source', _calibration_reading.additional_data['export_filepath'])
        # UPDATE THE DATA ENTRY DIRECTLY

    @staticmethod
    def apply_global_offset_inplace(_readings: [MRPReading.MRPReading], _bias_value: float = 0.0):
        for ridx, r in enumerate(_readings):
            for idx, curr in enumerate(_readings[ridx].data):
                _readings[ridx].data[idx].value = _readings[ridx].data[idx].value + _bias_value

            # APPEND SOME METADATA
            _readings[ridx].set_additional_data('apply_global_offset_inplace', _bias_value)


    @staticmethod
    def apply_temperature_compensation_inplace(_readings: list[MRPReading.MRPReading], _low_temp_reading: MRPReading.MRPReading, _high_temp_reading: MRPReading.MRPReading):
        pass

    # TODO FIX
    def apply_binning(self, _calibrated_readings: list[MRPReading.MRPReading], _reference_reading: MRPReading.MRPReading,
                      _bins: int = None) -> list[MRPReading.MRPReading]:

        # TODO ONLY FOR 360 DRG ARRYS SO CHECK THETA PHI RANGE BEFORE
        # CONVERT TO MATTRIX
        # CALCULATE NUMPY SUB MATRIX -> SUMUP FOR DEVIATION
        if _calibrated_readings is None or len(_calibrated_readings) <= 0:
            raise MRPAnalysisException("_calibrated_readings is none or empty")
        if _reference_reading is None:
            raise MRPAnalysisException("_reference_reading is None")

        if _bins is None:
            _bins = len(_calibrated_readings) + 1
            print("set _bins (bin count) to {0}".format(_bins))

        # CALCULATE ABS DEVIATION FROM BASE READING
        mean_deviations_ref_base = []
        np_ref = _reference_reading.to_numpy_polar()
        for r in _calibrated_readings:
            np_curr = r.to_numpy_polar()
            # TODO SUBTRACT
            deviation_array = numpy.subtract(np_curr, np_ref)
            abs_deviation = numpy.sum(deviation_array)
            mean_deviations_ref_base.append(abs_deviation)

        # SAVE MIN MAX DEVIATION
        mean_deviations_ref_base = numpy.array(mean_deviations_ref_base)
        abs_min_dev = numpy.min(mean_deviations_ref_base)
        abs_max_dev = numpy.max(mean_deviations_ref_base)
        abs_range = abs(abs_min_dev) + abs(abs_max_dev)

        # bin_ranges =

        # CREATE BIN RANGES FROM BINS AND MIN MAX DEVIATION
        # GROUP READINGS IN RETURN AS DICT
        return []

    def __init__(self, _reading: MRPReading):
        pass
