LFB-MRI/MagneticReadoutProcessing/src/MagneticReadoutProcessing/MRP/MRPReadingSourceStatic.py

from MRP import MRPHal, MRPReading, MRPReadingSource, MRPBaseSensor, MRPMeasurementConfig, MRPReadingEntry, \
    MRPDataVisualization


class MRPReadingSourceStaticException(Exception):
    def __init__(self, message="MRPReadingSourceStaticException thrown"):
        self.message = message
        super().__init__(self.message)


class MRPReadingSourceStatic(MRPReadingSource.MRPReadingSource):


    @staticmethod
    def get_base_sensor_reading(_sensor: MRPBaseSensor.MRPBaseSensor, _reading: MRPReading.MRPReading, _average_readings_per_datapoint: int) -> [MRPReadingEntry.MRPReadingEntry]:
        index: int = len(_reading.data) + 1
        print("sampling {} datapoints with {} average readings".format(index,_average_readings_per_datapoint))
        ret: [MRPReadingEntry.MRPReadingEntry] = []

        has_hardware_averaging: bool = False
        avaraging_readounts: int = _average_readings_per_datapoint
        if _sensor.has_hardware_averaging():
            has_hardware_averaging = True
            # request hardware averaging
            got_hwavg = _sensor.setup_hardware_averaging(_average_readings_per_datapoint)

            avaraging_readounts = int(_average_readings_per_datapoint / got_hwavg)
            print("hardware averaging supported by sensor: with max {} in sensor samples so {} software averaging needed to fulfill the requests {}".format(got_hwavg, avaraging_readounts, _average_readings_per_datapoint))
        for s_idx in range(_sensor.sensor_count):

            avg_temp: float = 0.0
            avg_bf: float = 0.0
            valid: bool = True

            # CALCULATE AVERAGE
            for avg_idx in range(max([avaraging_readounts, 1])):
                # READOUT SENSOR
                try:
                    _sensor.query_readout()
                except Exception as e:
                    print(e)
                    valid = False
                avg_temp = avg_temp + _sensor.get_temp(_sensor_id=s_idx)
                avg_bf = avg_bf + _sensor.get_b(_sensor_id=s_idx)

            avg_temp = avg_temp / avaraging_readounts
            avg_bf = avg_bf / avaraging_readounts

            # APPEND READING
            print("SID{} DP{} B{} TEMP{}".format(s_idx, index, avg_bf, avg_temp))
            rentry: MRPReadingEntry.MRPReadingEntry = MRPReadingEntry.MRPReadingEntry(p_id=index, p_value=avg_bf,
                                                                                      p_temperature=avg_temp,
                                                                                      p_is_valid=valid)
            ret.append(rentry)
        return ret



    hal_instance: MRPHal.MRPHal = None

    def __init__(self, _hal: MRPHal.MRPHal):
        if not _hal.is_connected():
            _hal.connect()

        if not 'static' in _hal.get_sensor_capabilities():
            raise MRPReadingSourceStaticException("invalid get_sensor_capabilities for this reading source static is required")

        self.hal_instance = _hal



    def __del__(self):
        if self.hal_instance:
            self.hal_instance.disconnect()

    def perform_measurement(self, _measurement_points: int, _average_readings_per_datapoint: int) -> [MRPReading.MRPReading]:
        if not self.hal_instance.is_connected():
            self.hal_instance.connect()

        sensor: MRPBaseSensor.MRPBaseSensor = MRPBaseSensor.MRPBaseSensor(self.hal_instance)
        result_readings: [MRPReading.MRPReading] = []

        for s_idx in range(sensor.sensor_count):
            # CREATE MEASUREMENT CONFIG
            mmc: MRPMeasurementConfig.MRPMeasurementConfig = MRPMeasurementConfig.MRPMeasurementConfig()
            #mmc.configure_fullsphere()
            mmc.configure_fullsphere_custom(_measurement_points=_measurement_points)
            mmc.id = self.hal_instance.get_sensor_id()
            mmc.sensor_id = s_idx
            # CREATE A READING WITH CREATED CONFIG
            reading: MRPReading.MRPReading = MRPReading.MRPReading(mmc)
            # SET READING NAME
            reading.set_name("SID{}".format(  mmc.id, mmc.sensor_id, reading.get_magnet_type().name))
            result_readings.append(reading)



        valid : bool = True
        for m_idx in range(_measurement_points):
            # PERFORM READING FOR EACH USER SET DATAPOINT
            # LOOP OVER ALL DATAPOINTS
            try:
                rentry: [MRPReadingEntry.MRPReadingEntry] = MRPReadingSourceStatic.get_base_sensor_reading(sensor, result_readings[0], _average_readings_per_datapoint)


                for idx, r in enumerate(rentry):
                    r.is_valid = valid
                    result_readings[idx].insert_reading_instance(r, _autoupdate_measurement_config=False)

            except Exception as e:
                print("get_base_sensor_reading error: {}".format(e))
                valid = False


        return result_readings

    def export_visualisation(self, _readings: [MRPReading.MRPReading], _export_file: str):
        # OPTIONAL: plot deviation
        MRPDataVisualization.MRPDataVisualization.plot_error(_readings, _filename="{}_error".format(_export_file))
        MRPDataVisualization.MRPDataVisualization.plot_scatter(_readings, _filename="{}_scatter".format(_export_file))
        MRPDataVisualization.MRPDataVisualization.plot_temperature(_readings, _filename="{}_temperature".format(_export_file))
