LFB-MRI/MagneticReadoutProcessing/src/UnifiedMagBoardFirmware/include/helper.h

#ifndef __HELPER_H__
#define __HELPER_H__


#ifdef USING_PLATFORMIO
#include <Arduino.h>
#endif


#include "usf_plattform.h"
#include <Wire.h>


bool is_i2c_device_present(TwoWire& _i2c_interface, const byte _addr);
bool i2c_scan(TwoWire& _wire_instance, const int _check_for_addr, const bool _log);

#endif
