LFB-MRI/MagneticReadoutProcessing/src/UnifiedMagBoardFirmware/include/version.h

#ifndef __version_h__
#define __version_h__

static const unsigned VERSION_MAJOR = /* VERSION_MAJOR */ 0;
static const unsigned VERSION_MINOR = /* VERSION_MINOR */0;
static const unsigned VERSION_REVISION = /* VERSION_REVISION */ 0;


#endif
