LFB-MRI/MagneticReadoutProcessing/src/MagneticReadoutProcessing/MRP/MRPDataVisualisationHelper.py

import matplotlib.scale as mscale
import matplotlib.pyplot as plt
import matplotlib.transforms as mtransforms
import matplotlib.ticker as ticker
import numpy as np

def find_nearest(array, value):
    array = np.asarray(array)
    idx = (np.abs(array - value)).argmin()
    return array[idx]

class SquareRootScale(mscale.ScaleBase):
    """
    ScaleBase class for generating square root scale.
    """

    name = 'squareroot'

    def __init__(self, axis, **kwargs):
        # note in older versions of matplotlib (<3.1), this worked fine.
        # mscale.ScaleBase.__init__(self)

        # In newer versions (>=3.1), you also need to pass in `axis` as an arg
        mscale.ScaleBase.__init__(self, axis)

    def set_default_locators_and_formatters(self, axis):
        axis.set_major_locator(ticker.AutoLocator())
        axis.set_major_formatter(ticker.ScalarFormatter())
        axis.set_minor_locator(ticker.NullLocator())
        axis.set_minor_formatter(ticker.NullFormatter())

    def limit_range_for_scale(self, vmin, vmax, minpos):
        return max(0., vmin), vmax

    class SquareRootTransform(mtransforms.Transform):
        input_dims = 1
        output_dims = 1
        is_separable = True

        def transform_non_affine(self, a):
            return np.array(a) ** 0.5

        def inverted(self):
            return SquareRootScale.InvertedSquareRootTransform()

    class InvertedSquareRootTransform(mtransforms.Transform):
        input_dims = 1
        output_dims = 1
        is_separable = True

        def transform(self, a):
            return np.array(a) ** 2

        def inverted(self):
            return SquareRootScale.SquareRootTransform()

    def get_transform(self):
        return self.SquareRootTransform()
