LFB-MRI/MagneticReadoutProcessing/src/MagneticReadoutProcessing/pipelines/examples/pipeline_generatesampledata.yaml

settings:
  enabled: false
  export_intermediate_results: false
  name: pipeline_generatesampledata

stage generate:
  function: simulate_magnet
  parameters:
    IP_count: 10
    IP_random_polarisation: true
    IP_random_magnetisation: true
    # IP_name_prefix: "simulated_magnet_stage"

stage inspect:
  function: inspect_readings
  parameters:
    readings_to_inspect: stage generate
    IP_export_folder: ./readings/generated/reports
    IP_log_to_std: false


stage plot:
  function: plot_readings
  parameters:
    readings_to_plot: stage generate
    IP_export_folder: ./readings/generated/plots
    IP_plot_headline_prefix:  pipeline_generatesampledata

stage plotfullsphere:
  function: plot_fullsphere
  parameters:
    readings_to_plot: stage generate
    IP_export_folder: ./readings/generated/fullsphere_plots
    IP_plot_headline_prefix:  pipeline_generatesampledata

stage export:
  function: export_readings
  parameters:
    readings_to_export: stage generate
    IP_export_folder: ./readings/generated/
