LFB-MRI/MagneticReadoutProcessing/(commit log)

2023-07-13 added correct list annotations
    [MRPAnalysis.py]
2023-07-13 visu issue still there
    [MRPAnalysis.py, MRPReading.py]
2023-08-04 first openscad
    [slice_1khallbach_test.scad]
2023-08-05 added magnet id
2023-08-05 rework started openscad
    [slice_1khallbach_test.scad]
2023-08-06 seperated openscad generation only using magnet properties
    [test_generate_1k_hallbach_EIGHT_IDEAL_OPENSCAD.scad]
2023-08-07 working 12,24 hallbach
    [test.scad, test_generate_1k_hallbach_EIGHT_OPENSCAD.scad, test_generate_1k_hallbach_TWELVE_OPENSCAD.scad]
2023-08-07 insersecting hallbach arrays with different magnet types working
    see tests
    [test.scad, test.stl, test_generat_1k_hallbach_8_24_OPENSCAD_2D.scad, test_generate_1k_hallbach_12_OPENSCAD_2D.scad, test_generate_1k_hallbach_32_OPENSCAD_2D.scad, test_generate_1k_hallbach_8_OPENSCAD_3D.scad, test_generate_1k_hallbach_EIGHT_IDEAL_OPENSCAD.scad, test_generate_1k_hallbach_EIGHT_IDEAL_OPENSCAD.stl]
2023-09-06 rework but not working directory strucure
    python build path adjustments needed in gh action
    [test_generat_1k_hallbach_8_24_OPENSCAD_2D.scad, test_generate_1k_hallbach_12_OPENSCAD_2D.scad, test_generate_1k_hallbach_32_OPENSCAD_2D.scad, test_generate_1k_hallbach_8_OPENSCAD_3D.scad]
2023-09-09 added button irq to sync pin
2023-09-12 tests working again
    [test_generat_1k_hallbach_8_24_OPENSCAD_2D.scad, test_generate_1k_hallbach_12_OPENSCAD_2D.scad, test_generate_1k_hallbach_32_OPENSCAD_2D.scad, test_generate_1k_hallbach_8_OPENSCAD_3D.scad]
2023-09-16 added cad + stl for dual sensor
    [Das_ist_eine_tolle_Tabelle.csv, baseplate_bottom.stl, baseplate_top.stl, cover.stl, devboard_rotational v2.obj, devboard_rotational v2.skp, devboard_rotational v2.step, electric_bay.stl]
2023-09-16 Create devboard_rotational v2.stl
    [devboard_rotational v2.stl]
2023-09-16 added single sensor cad files
    [bottom_plate.stl, cover.stl, electric_bay.stl, magnet_distance_10mm.stl, magnetholder_12x12x12.stl, single_sensor v13.3mf, single_sensor v13.iges, single_sensor v13.obj]
2023-09-17 temperature plot finished
2023-09-18 first sensor cli
2023-09-20 added tlv493 temperature measurements
2023-09-20 fixed documentation
    moved inside package
    [baseplate_bottom.stl, baseplate_top.stl, bottom_plate.stl, cover.stl, devboard_rotational v2.obj, devboard_rotational v2.skp, devboard_rotational v2.step, devboard_rotational v2.stl]
2023-09-20 Create CLI - Command-Line Interface — MagneticReadoutProcessing documentation.pdf
2023-09-21 udpp list functions from class
    [generate_temperature_calibration_reading.yaml]
2023-09-21 load yaml files
    [generate_temperature_calibration_reading.yaml]
2023-09-24 first woking sub-calltree generation
    [generate_temperature_calibration_reading.yaml]
2023-09-29 mv docs
    [Das_ist_eine_tolle_Tabelle.csv]
2023-10-03 api load pipeline flask to ts working using interfaces
    [generate_temperature_calibration_reading_a.yaml]
2023-10-21 added udp discovery service
    [printer.cfg]
2023-10-23 added some n45 12x12x12 readings and folder creation issue fixed
    [generate_temperature_calibration_reading.yaml]
2023-10-24 more pipeline examples
    [array.scad]
2023-11-19 working on rotational sensor api
    .
2023-11-21 working on rotational sensor
2023-11-21 abstract rework for hal
    [MRPBaseSensor.py, MRPHal.py, MRPHalHelper.py, MRPHalLocal.py, MRPHalRest.py, MRPHalSerialPortInformation.py, MRPMoonrakerInterface.py, MRPRotationalSensor.py]
2023-11-23 theoretical support for multible same sensors connected to one proxy
2023-11-26 reworked static basic sensor readout finally working
    [MRPHalKlipper.py, MRPHalRest.py, MRPReadingSource.py, MRPReadingSourceFullsphere.py, MRPReadingSourceHelper.py, MRPReadingSourceStatic.py]
2023-11-26 klipper hal working
    * added https support and klippers support and
2023-11-27 working fullsphere reading sensor script
2023-12-14 more thesis
    [Das_ist_eine_tolle_Tabelle.csv, Implemented_digital_halleffect_sensors.csv]
2023-12-19 more thesis
    added drawio sources
    [Build_sensors_with_different_capabilities.csv, Voltcraft_GM70_serial_protocol.csv]
2024-01-07 more thesis - first external review
    [Implemented_digital_halleffect_sensors.csv, Implemented_digital_magnetic_field_sensors.csv, Measured_sensor_readout_to_processing_using_host_software.csv]
2024-02-13 added first working temperature plot
2024-02-13 update magnet system
2024-02-22 working dual i2c sensor detection in ufw
2024-04-17 added minimal examples for fullsphere sensor
2024-07-29 added user button to trigger reading
2024-09-13 added get_volume function for magnet types
2024-10-08 unit fix in mrp readingentry
    [MRPReadingEntry.py]
