LFB-MRI/MagneticReadoutProcessing/documentation/images/misc/IMG_2872.JPG

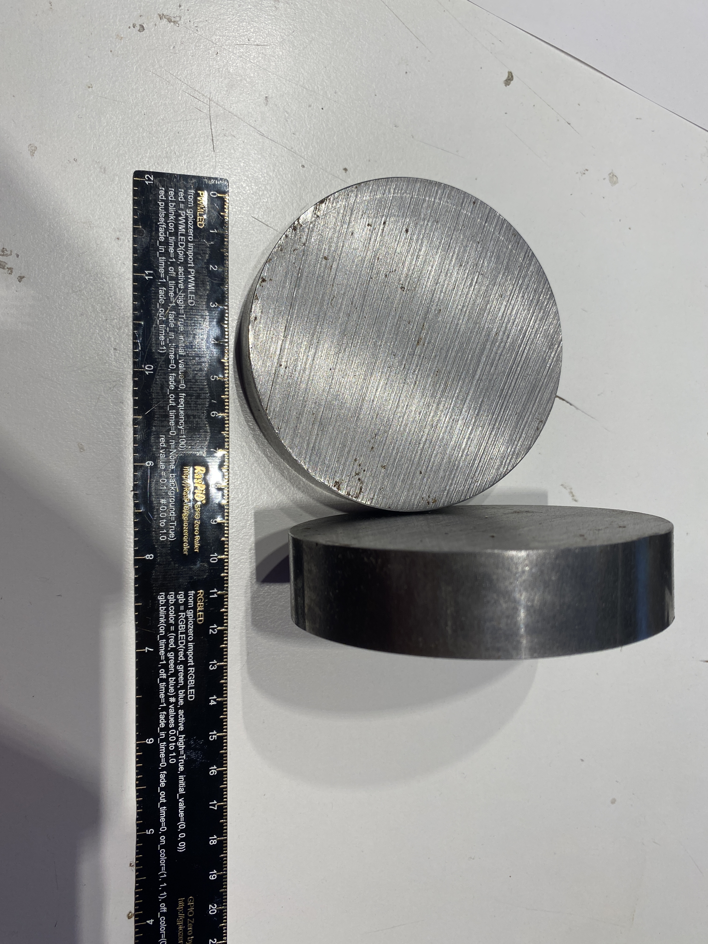
documentation/images/misc/IMG_2872.JPG
