LFB-MRI/MagneticReadoutProcessing/documentation/images/misc/IMG_3100.JPG

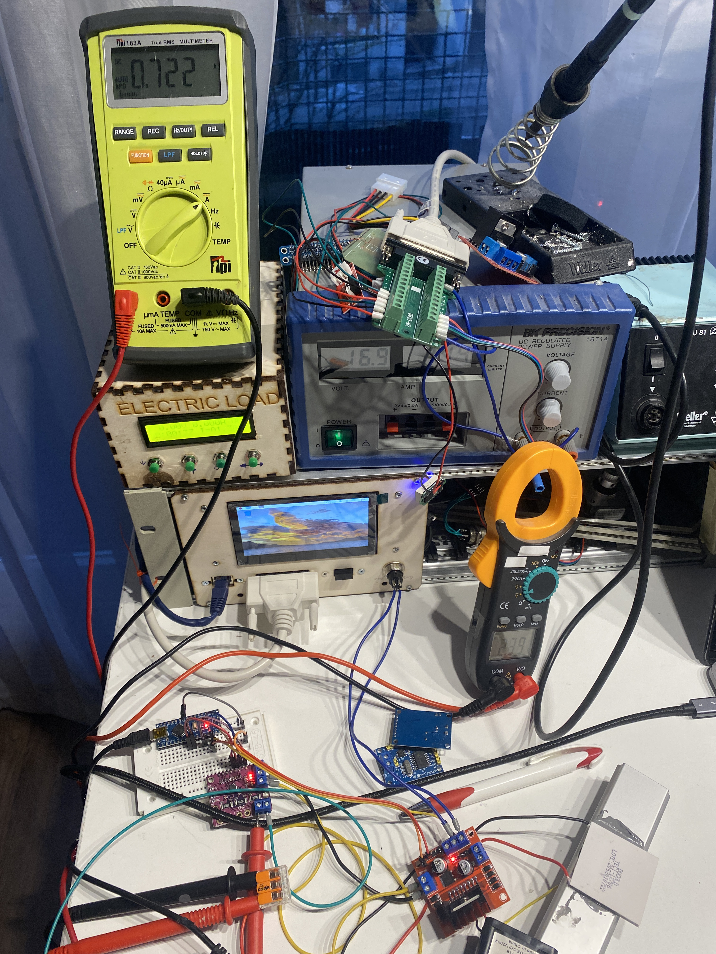
documentation/images/misc/IMG_3100.JPG
