LFB-MRI/MagneticReadoutProcessing/documentation/images/misc/IMG_3102.JPG

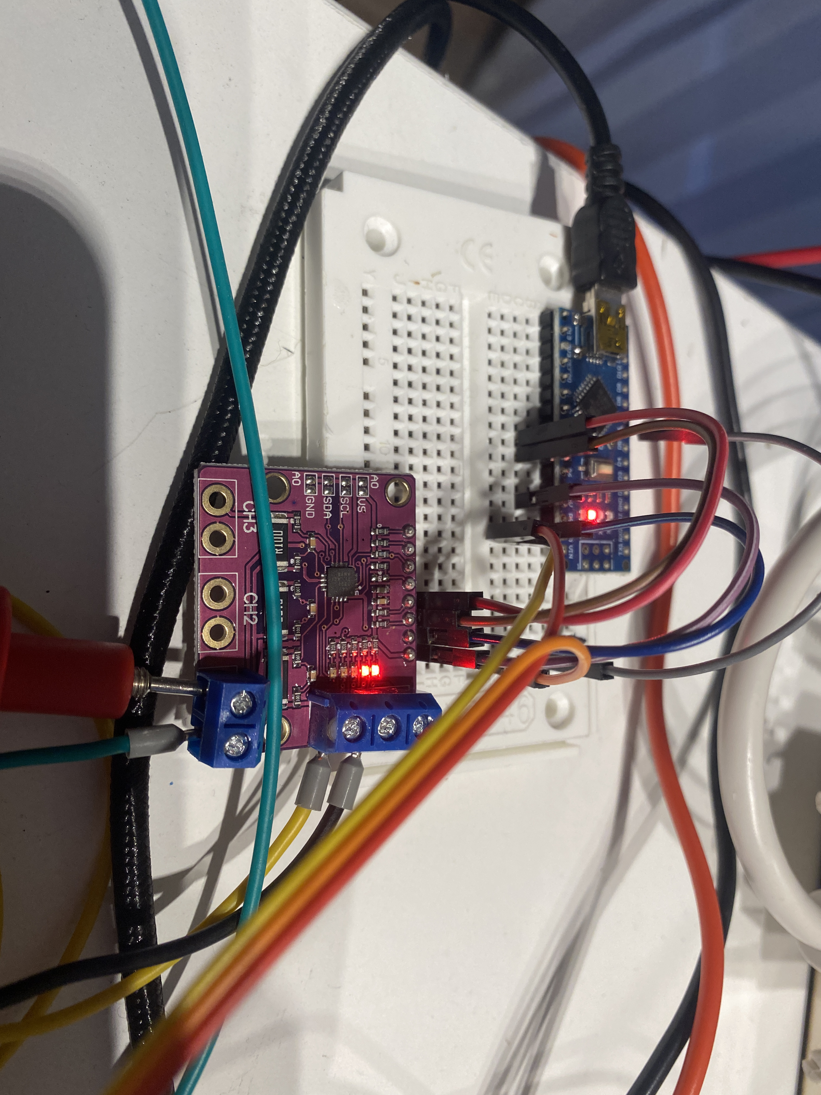
documentation/images/misc/IMG_3102.JPG
