LFB-MRI/MagneticReadoutProcessing/documentation/images/misc/IMG_3103.JPG

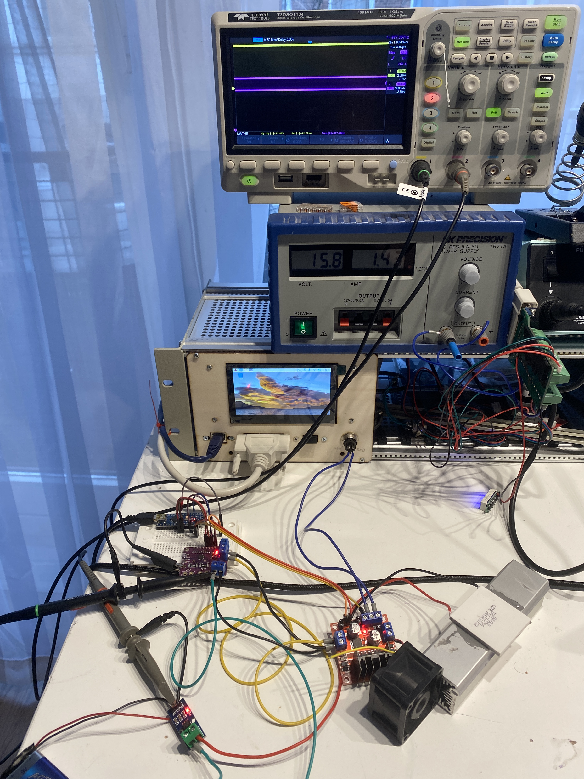
documentation/images/misc/IMG_3103.JPG
