LFB-MRI/MagneticReadoutProcessing/documentation/images/misc/IMG_3104.JPG

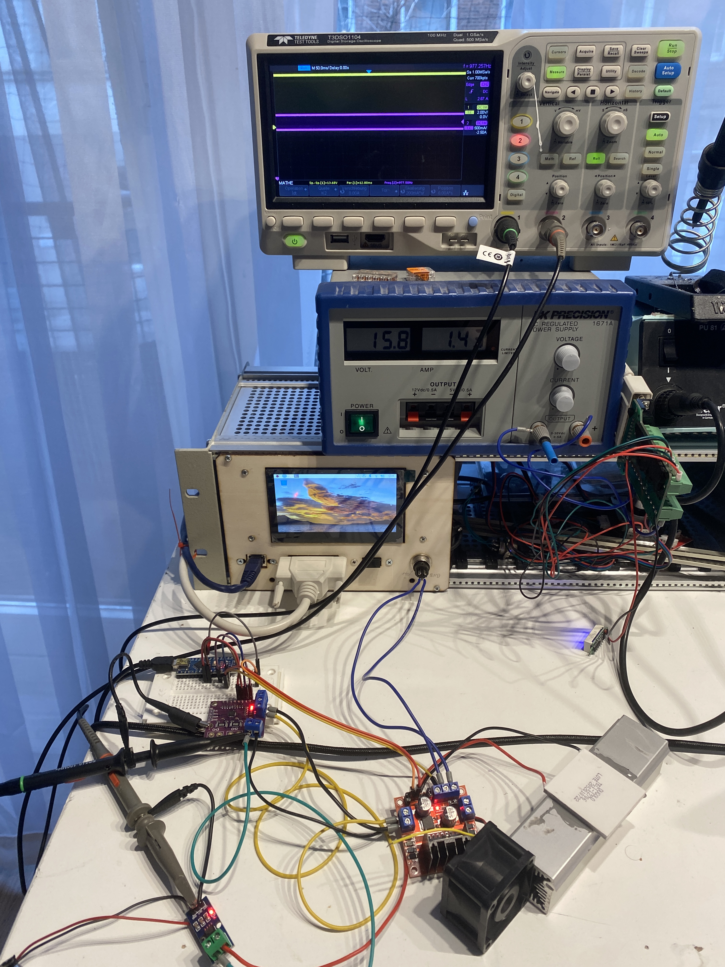
documentation/images/misc/IMG_3104.JPG
