LFB-MRI/MagneticReadoutProcessing/documentation/images/misc/IMG_3112.JPG

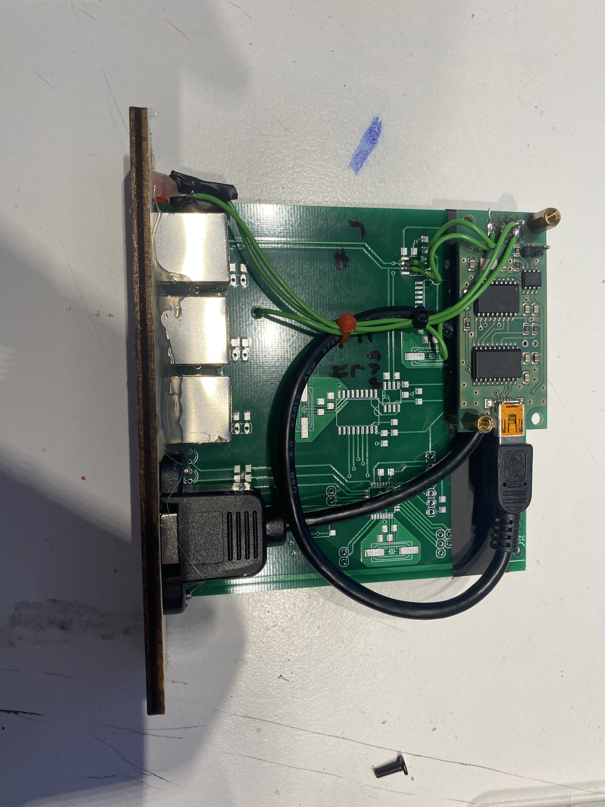
documentation/images/misc/IMG_3112.JPG
