LFB-MRI/MagneticReadoutProcessing/documentation/images/misc/IMG_3192.JPG

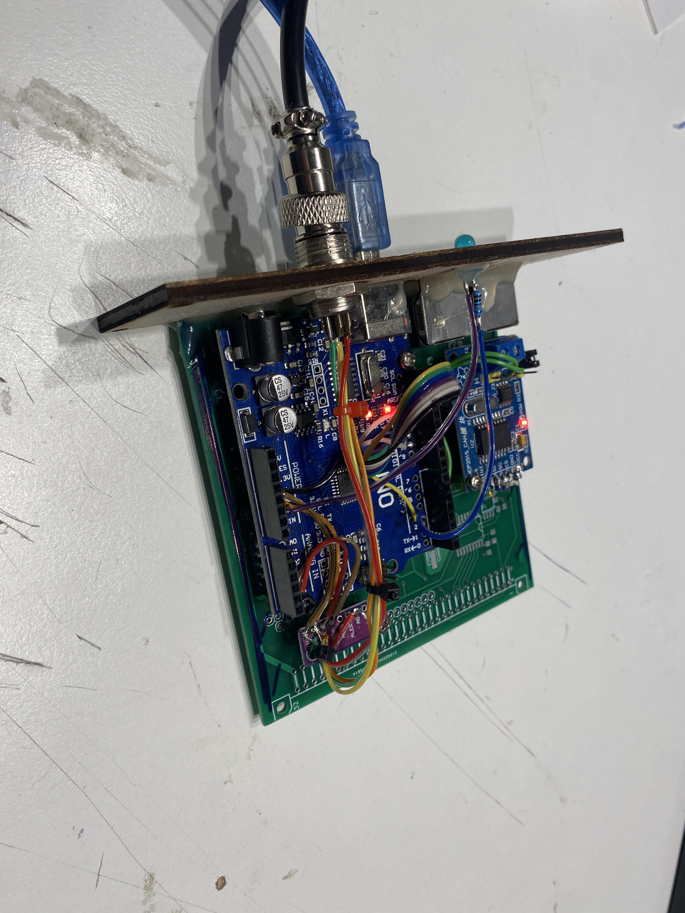
documentation/images/misc/IMG_3192.JPG
