LFB-MRI/MagneticReadoutProcessing/documentation/images/misc/IMG_3215.JPG

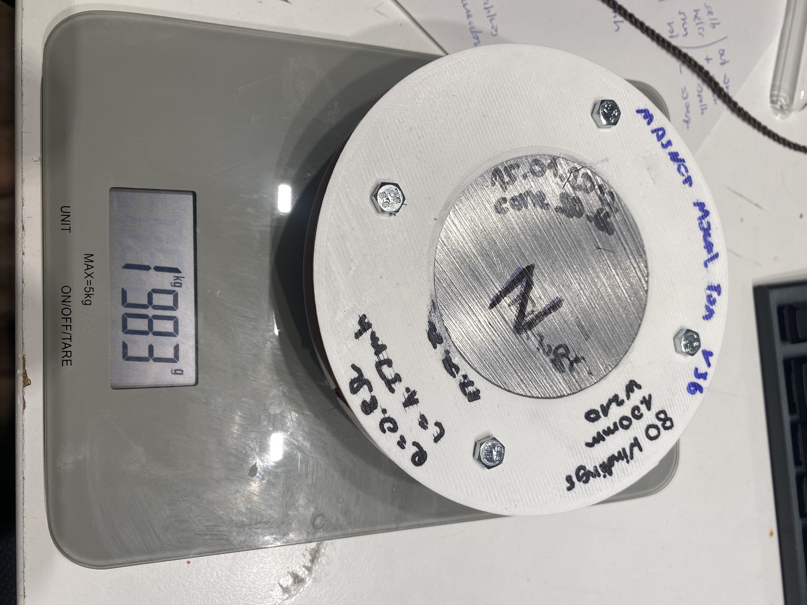
documentation/images/misc/IMG_3215.JPG
