LFB-MRI/MagneticReadoutProcessing/documentation/images/misc/IMG_3229.JPG

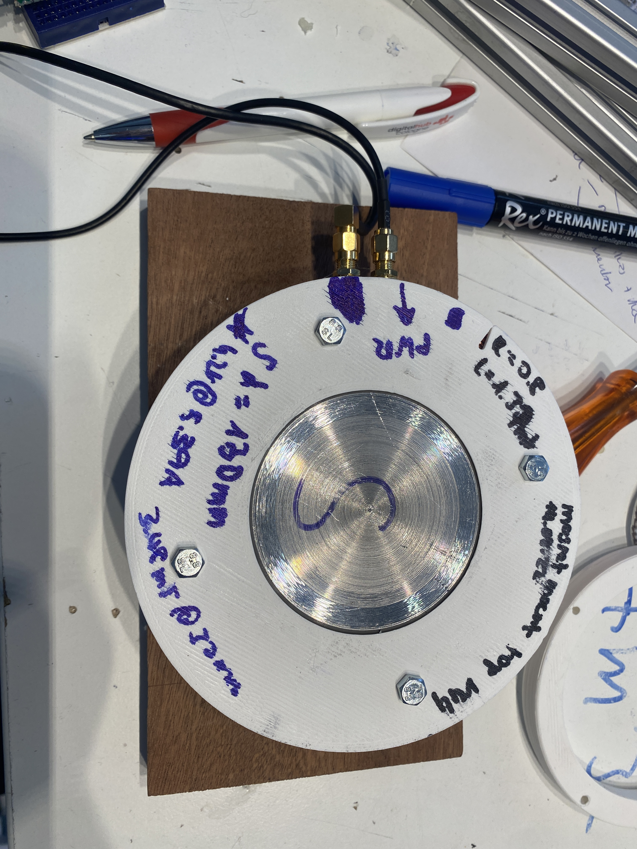
documentation/images/misc/IMG_3229.JPG
