LFB-MRI/MagneticReadoutProcessing/documentation/images/misc/IMG_3245.JPG

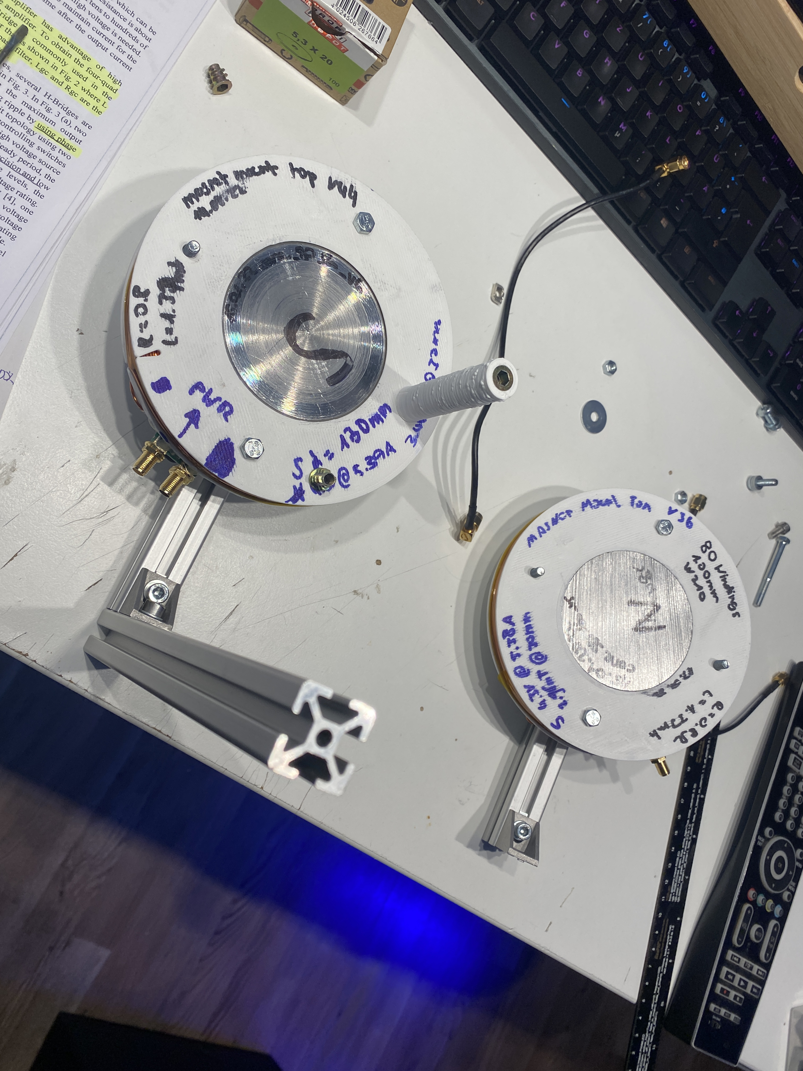
documentation/images/misc/IMG_3245.JPG
