LFB-MRI/MagneticReadoutProcessing/documentation/images/misc/IMG_3250.JPG

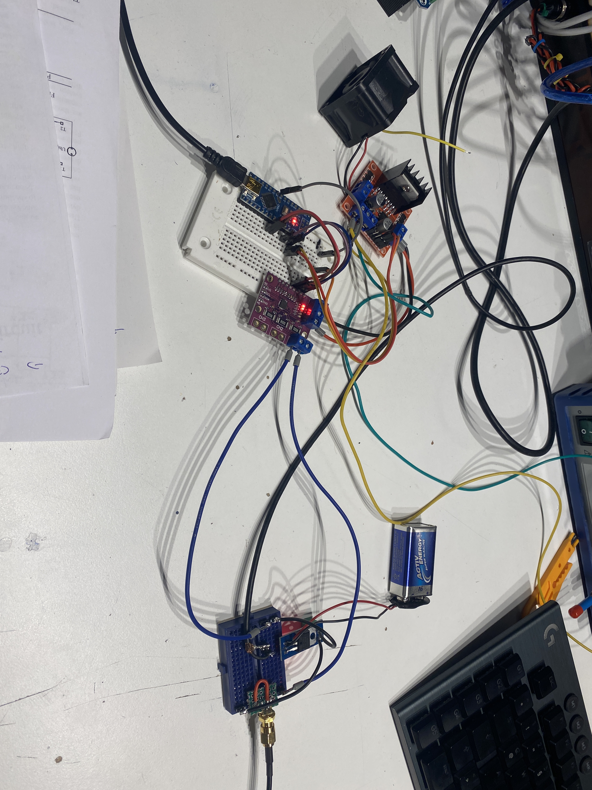
documentation/images/misc/IMG_3250.JPG
