LFB-MRI/MagneticReadoutProcessing/documentation/images/misc/IMG_3353.JPG

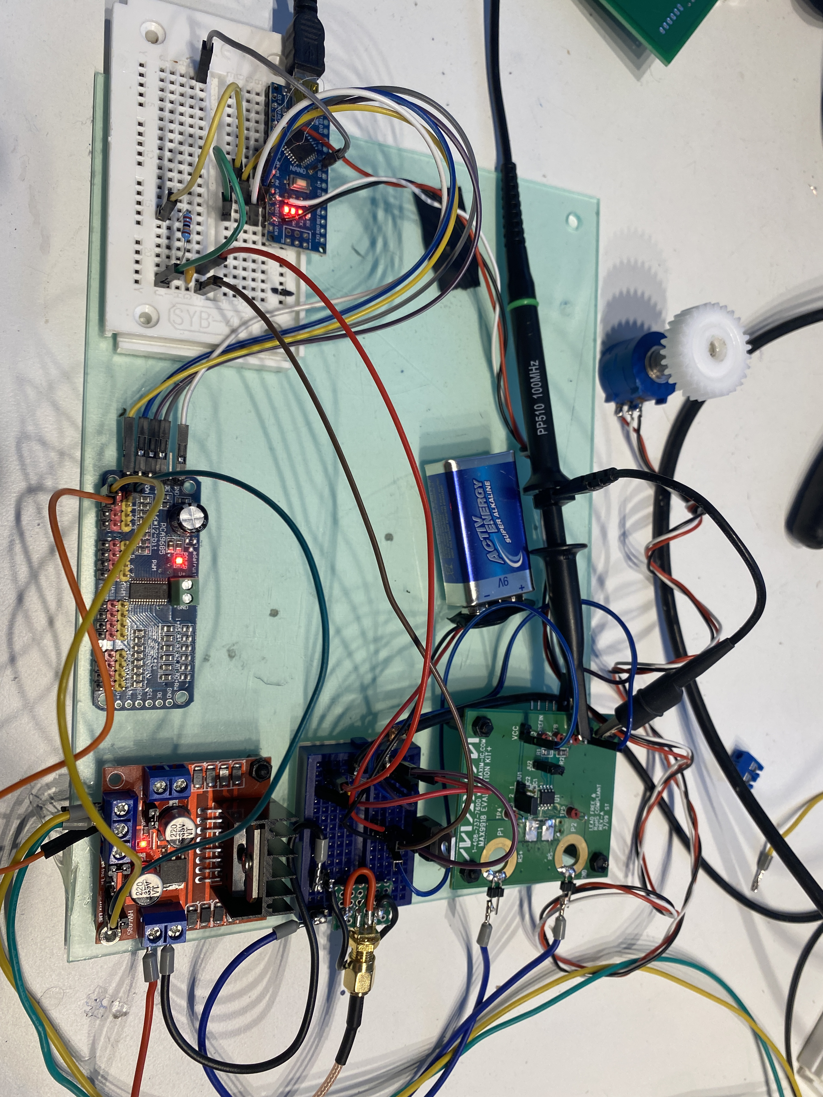
documentation/images/misc/IMG_3353.JPG
