LFB-MRI/MagneticReadoutProcessing/documentation/images/misc/IMG_3354.JPG

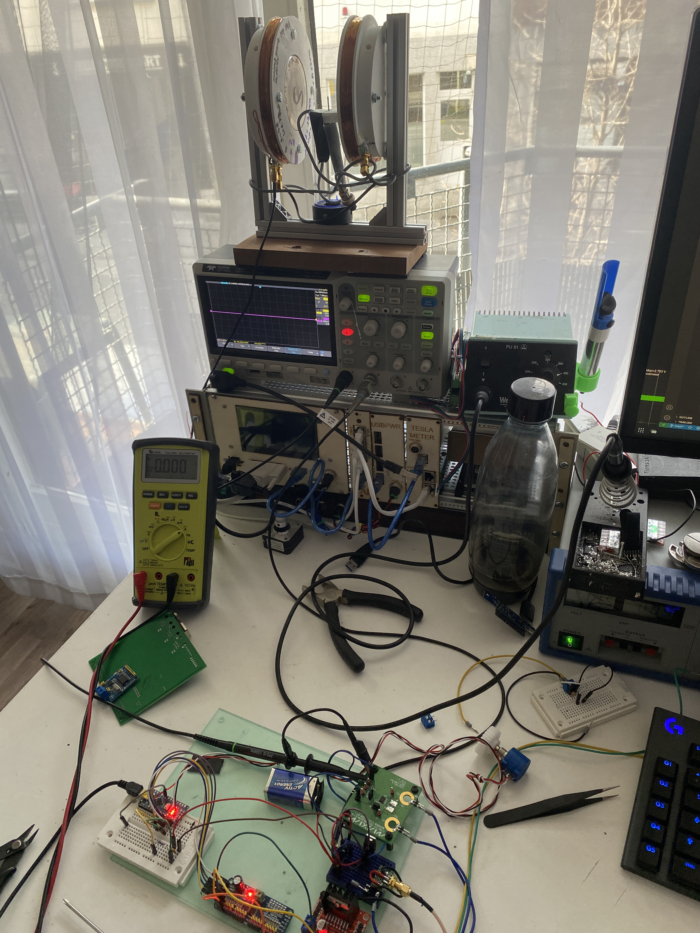
documentation/images/misc/IMG_3354.JPG
