LFB-MRI/MagneticReadoutProcessing/documentation/images/misc/IMG_3375.JPG

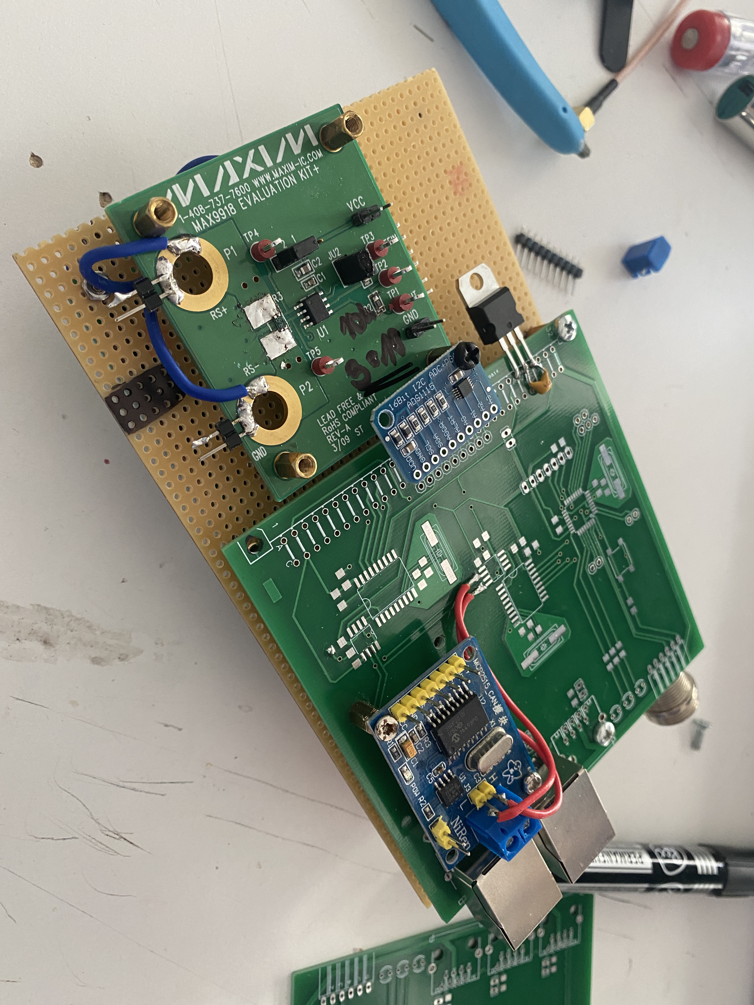
documentation/images/misc/IMG_3375.JPG
