LFB-MRI/MagneticReadoutProcessing/documentation/images/misc/IMG_3543.JPG

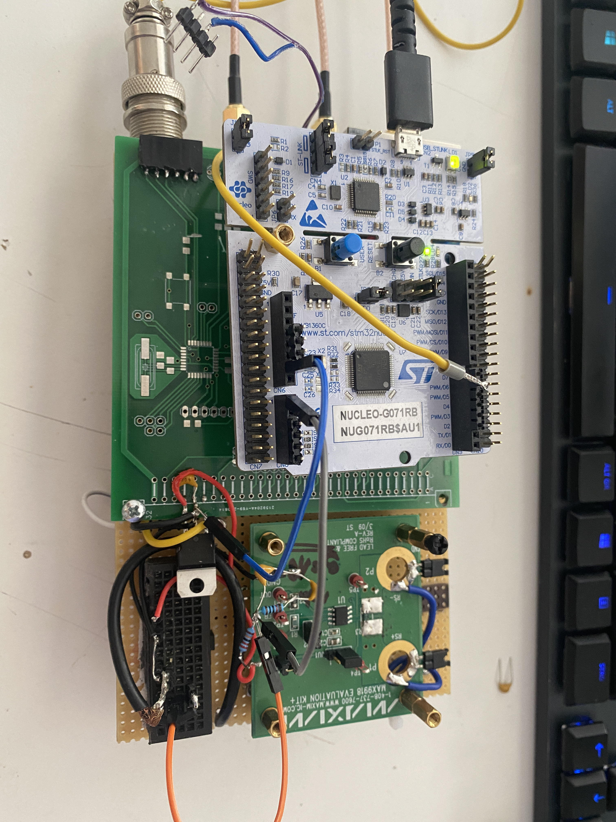
documentation/images/misc/IMG_3543.JPG
