LFB-MRI/MagneticReadoutProcessing/documentation/images/misc/IMG_3553.JPG

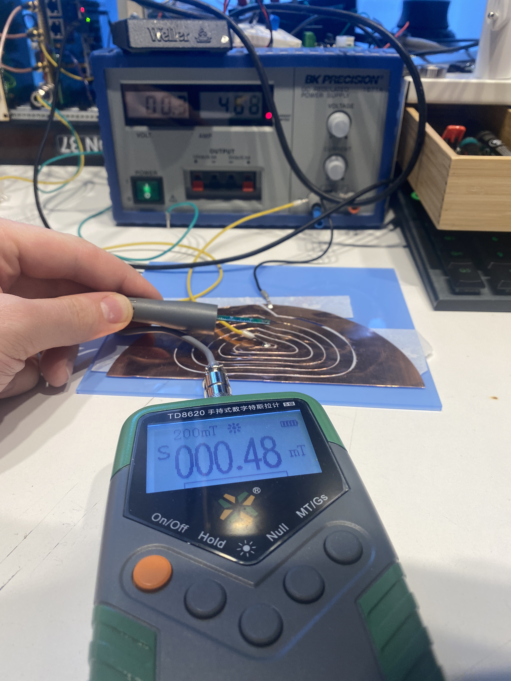
documentation/images/misc/IMG_3553.JPG
