LFB-MRI/MagneticReadoutProcessing/documentation/images/misc/IMG_3563.JPG

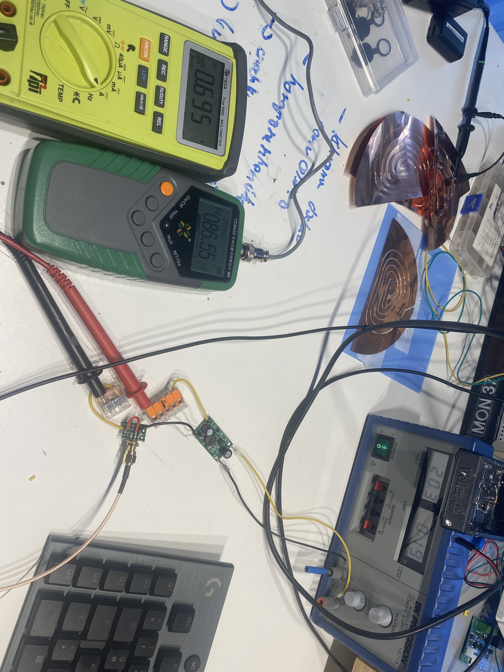
documentation/images/misc/IMG_3563.JPG
