LFB-MRI/MagneticReadoutProcessing/documentation/images/misc/IMG_3665.JPG

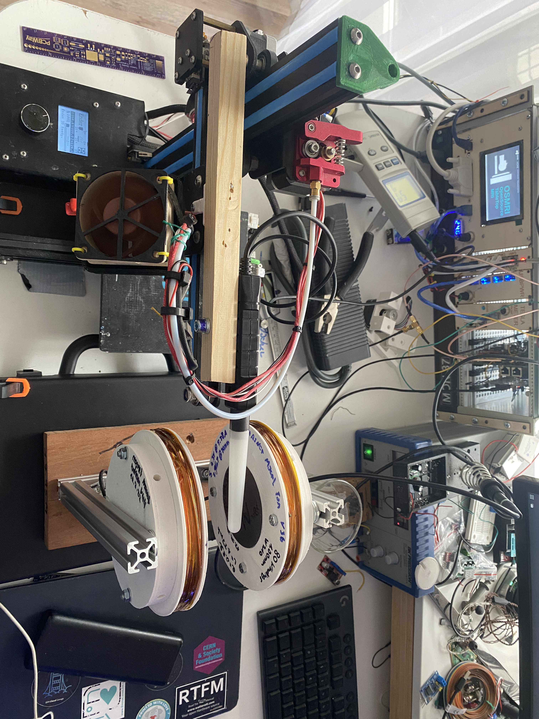
documentation/images/misc/IMG_3665.JPG
