LFB-MRI/MagneticReadoutProcessing/documentation/images/misc/IMG_3666.JPG

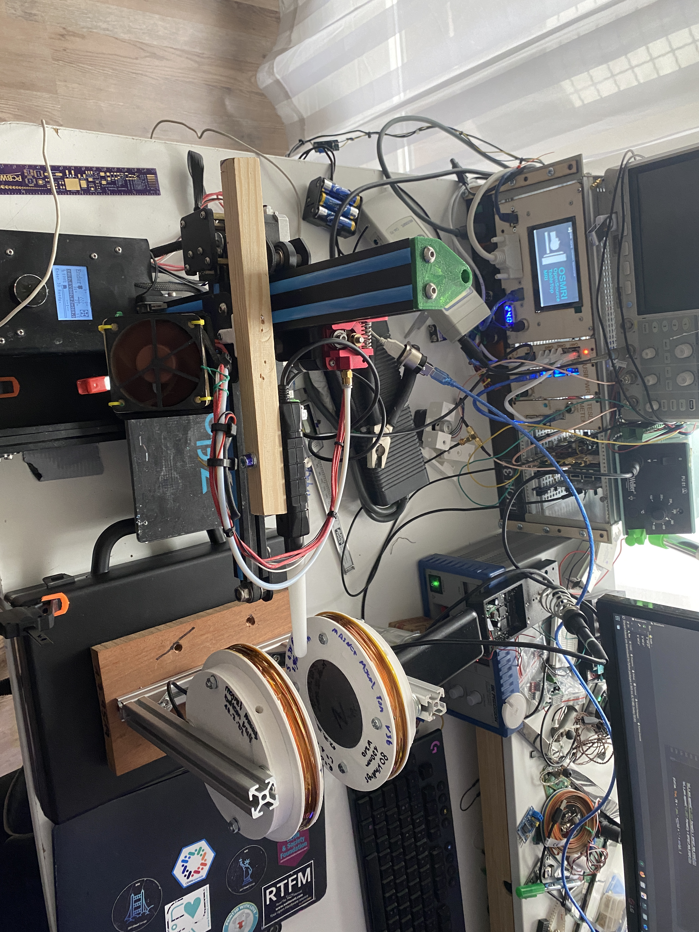
documentation/images/misc/IMG_3666.JPG
