LFB-MRI/MagneticReadoutProcessing/documentation/images/misc/IMG_3713.JPG

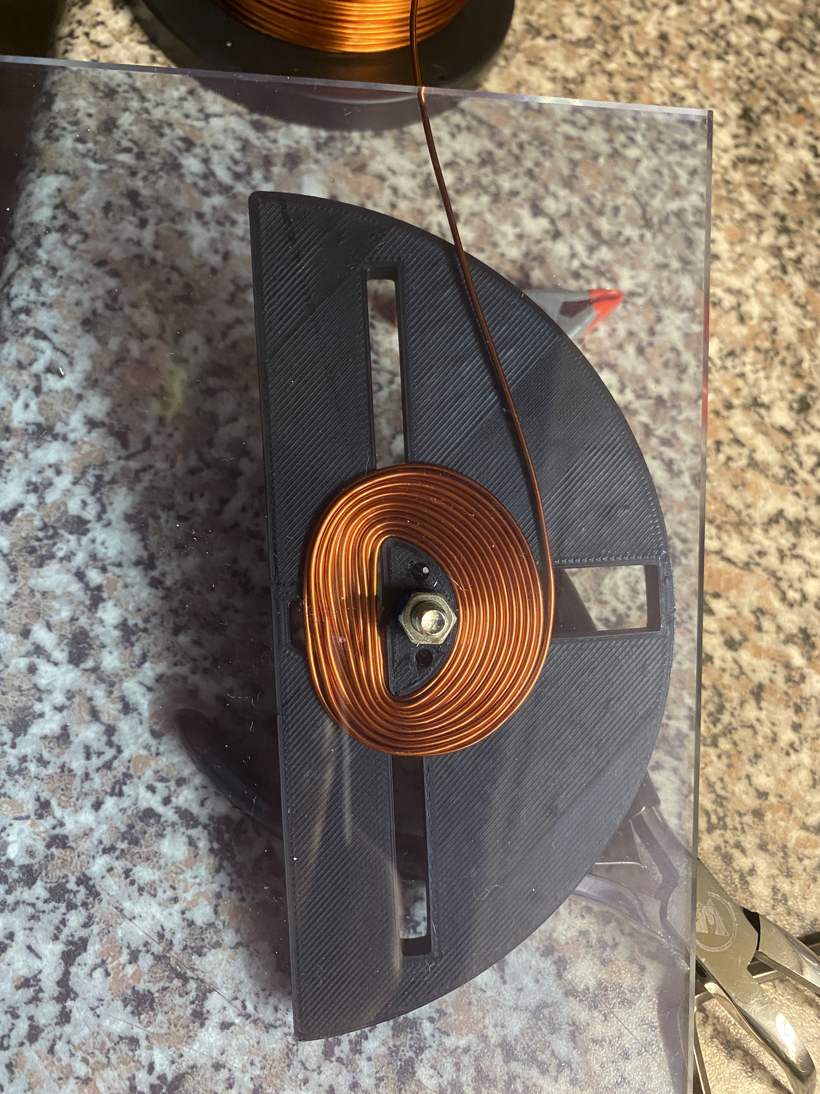
documentation/images/misc/IMG_3713.JPG
