LFB-MRI/MagneticReadoutProcessing/documentation/images/misc/IMG_3714.JPG

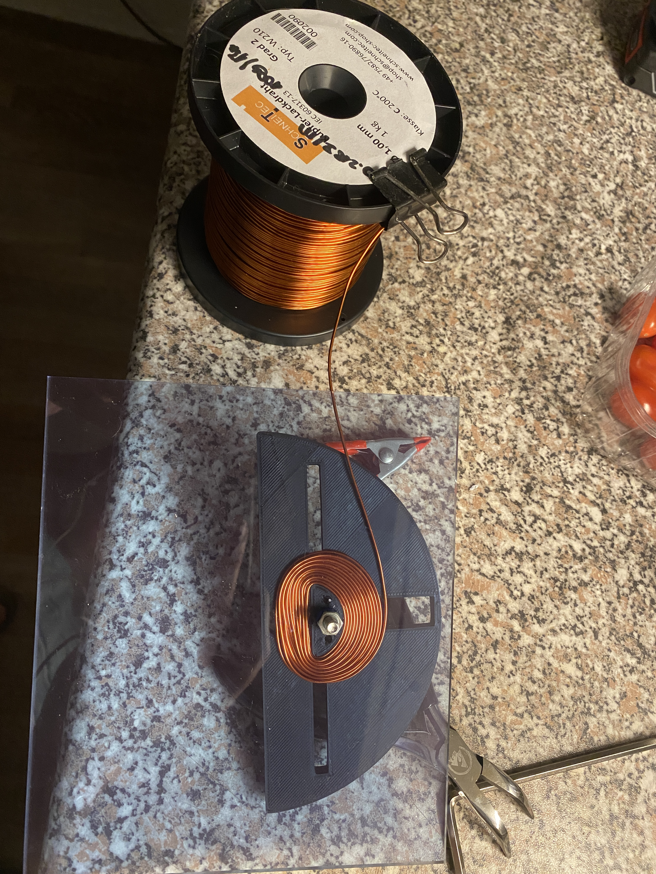
documentation/images/misc/IMG_3714.JPG
