LFB-MRI/MagneticReadoutProcessing/documentation/images/misc/IMG_3715.JPG

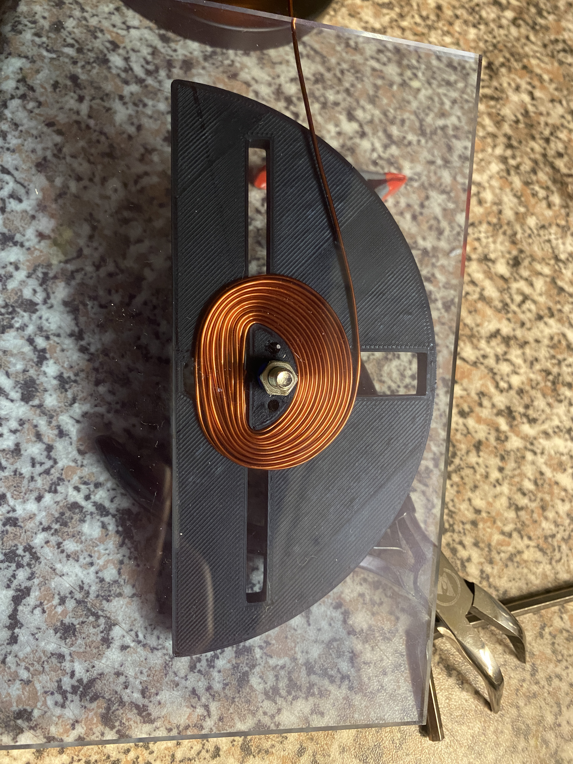
documentation/images/misc/IMG_3715.JPG
