LFB-MRI/MagneticReadoutProcessing/documentation/images/misc/IMG_7379.JPG

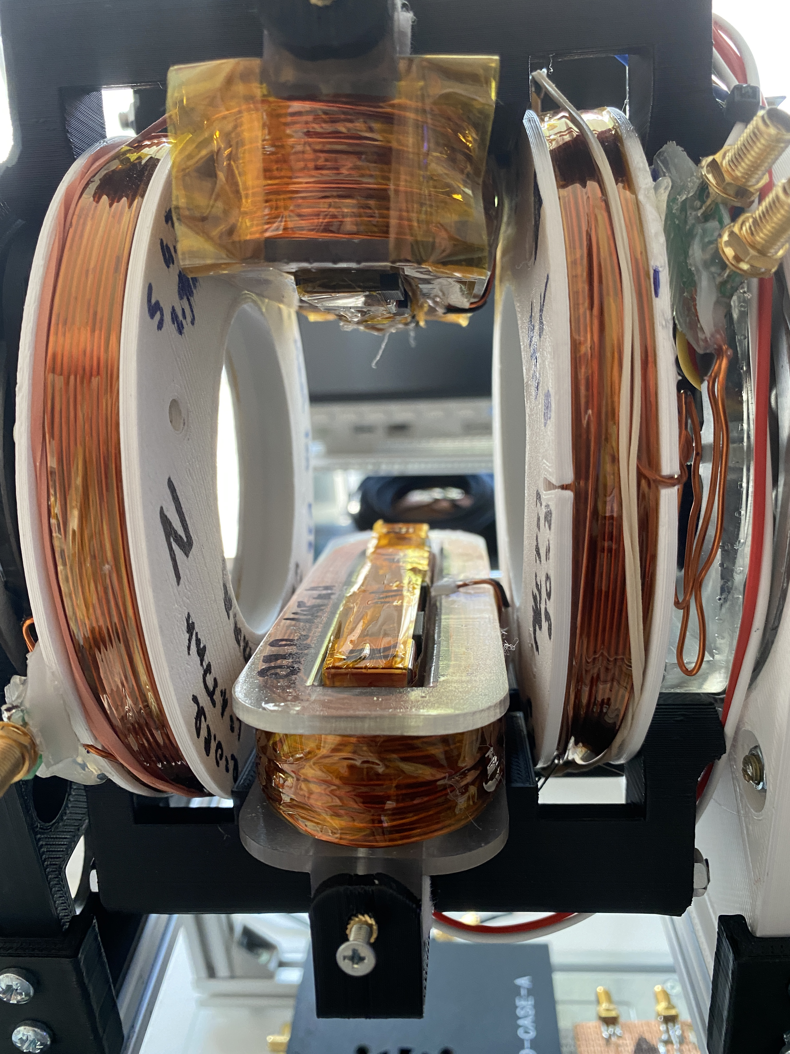
documentation/images/misc/IMG_7379.JPG
