LFB-MRI/MagneticReadoutProcessing/documentation/images/misc/IMG_7381.JPG

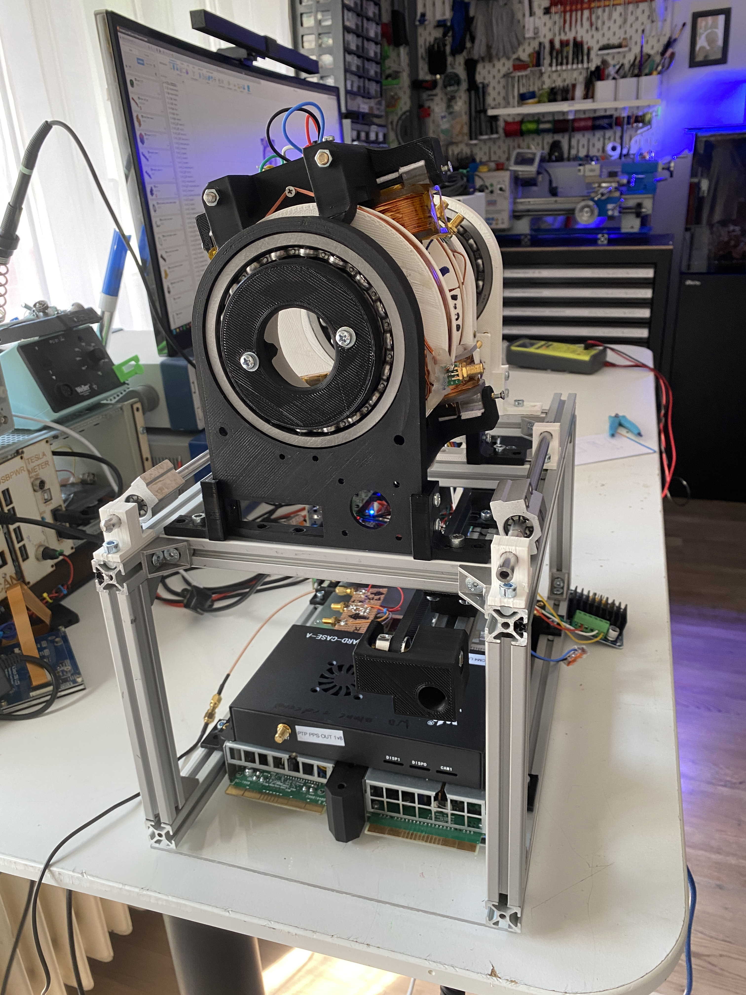
documentation/images/misc/IMG_7381.JPG
