LFB-MRI/MagneticReadoutProcessing/documentation/images/misc/IMG_7385.JPG

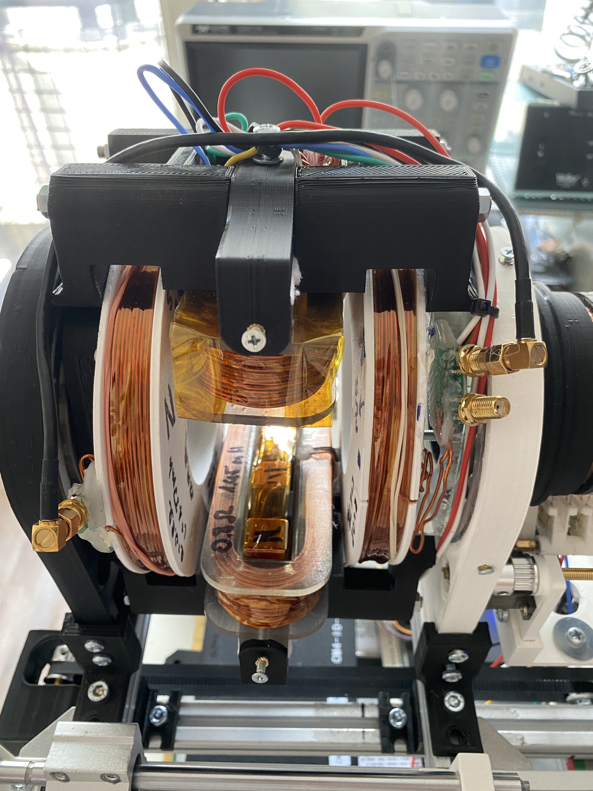
documentation/images/misc/IMG_7385.JPG
