LFB-MRI/MagneticReadoutProcessing/documentation/images/misc/IMG_7478.JPG

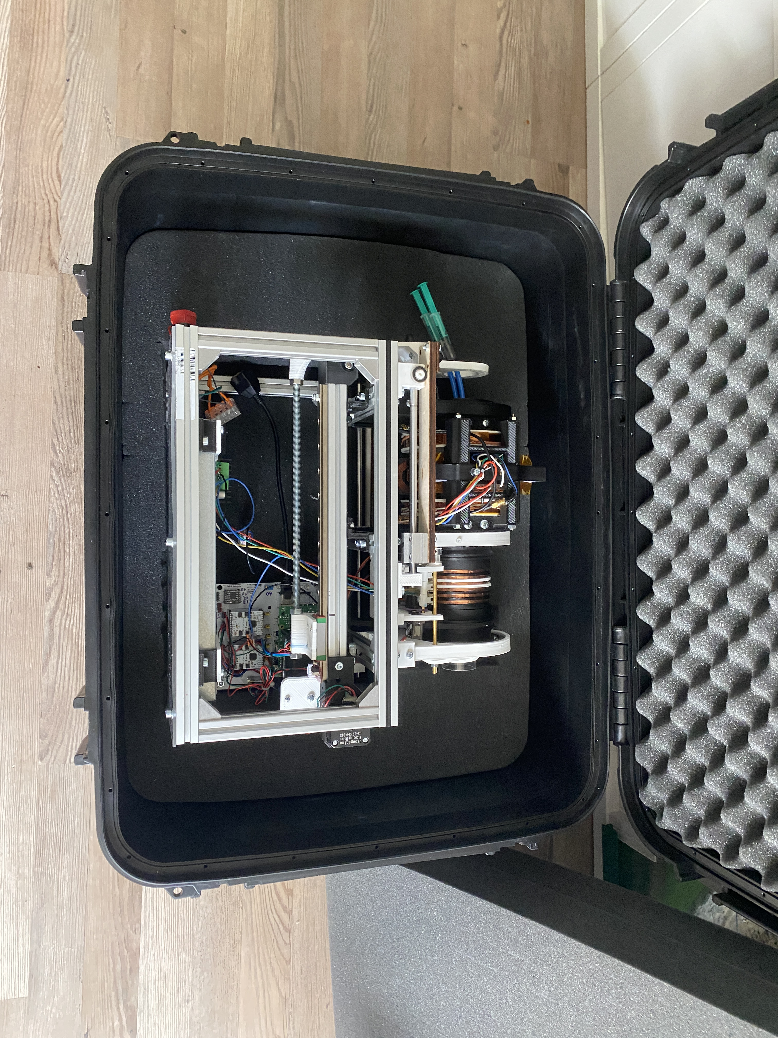
documentation/images/misc/IMG_7478.JPG
